jbj7667/wafer-transfer-robot/cad/arm/README.md

# 팔 방식 기하 가·부 검사 (arm option go/no-go)

Fusion 문서 `wafer_robot_arm_v0` (Default Project, 직접 모델링). L=180(원점)·L=190(Y+1000mm 옆) 두 로봇을 같은 문서에 구성하고 부품(occurrence)별 `transform2`로 자세를 바꿈. 계산 코드: `lib_arm.py, ev.py, final.py`(순수 파이썬 SAT 간섭·거리), 모델 데이터 `model_L*.json`, 상세 출력 `result_L*.txt`. 단순 솔리드(상자·원기둥) 기반이며 갈래 슬롯·림·벨트는 생략.

## 확정 배치 (로봇 좌표, mm, 상판 244x244: x −89..155, y ±122)
| 항목 | L=180 | L=190 |
|---|---|---|
| 회전대 축 T | (−8, +2) 중앙 | (+40, −50) 우측 치우침 |
| 접힘 자세 | 팔 방향 216°, φ=108° | 팔 방향 30°, φ=96° |
| 마스트 | T에서 62mm, 방위 +45° (0°면 R모터·링크와 회전 중 충돌) | 동일 |
| R 모터 / θ 모터 방위 | 회전대 기준 +40° / T에서 114mm, 방위 0° | +70° / 방위 150° (90°는 바퀴와 간섭) |
| 가지 | 팔꿈치 θ+φ (s=+1) | 동일 |

## 판정 표
| # | 검사 | L=180 | L=190 | 판정 |
|---|---|---|---|---|
| 1 | 접힘 외곽 (Fusion 꼭짓점 실측) 250 대비 여유 X/Y/Z | 246.8x246.0x245.0 → **3.2 / 4.0 / 5.0** | 246.8x245.9x245.0 → **3.2 / 4.1 / 5.0** | PASS (기준 3, 단 상판 244 한정) |
| 1b | 접힘 상태 팔 대 차체·마스트 최소 간극 | 4.0 | 3.0 | PASS (빠듯) |
| 2a | 6개 베이스 도달, 슬롯 중심–베이스 중심 오차 | 0.00 (구성상) | 0.00 | PASS |
| 2b | 특이점 여유 2L−R_w (상단/중단/하단 행) | 38 / 97.5 / 62.8 | 58 / 117.5 / 82.8 | PASS (L=180 상단 38) |
| 2c | 도달 자세 간섭 (포크윗면=기둥윗면−10, 로봇↔베이스) | 6자세 모두 0 | 6자세 모두 0 | PASS, 포크–CD 간극 10 |
| 3 | 후방 회전 스윙 (R_w=150, 10° 간격) 최소 간극: 베이스쪽 / 차체·마스트쪽 | 9.9 / 7.5 (회전대–마스트봉) | 9.9 / 5.3 (θ모터–L298) | PASS (> 0) |
| 4 | 구역 경계: 필드 y 최소 (도달 / 스윙) | 54.6 / 41.8 | 54.6 / 31.3 | PASS (≥0) |
| 5 | 전도: 지지 다각형(구동륜 2·후캐스터·전스키드 2) 여유 최소 (도달 / 스윙) | 29.0 / 37.4 | 36.8 / 41.2 | PASS (≥20) |

질량: arm_option §3.3 합 2831 g 분포를 가정 [가정]. 베이스 높이: 상단 행 5·6은 기둥 175, 나머지 200 [가정].

## 한계·주의
- 상판을 244로 줄였기 때문에 여유 3 이상이 나옴. 250 꽉 채우면 여유 0 (FAIL). 외곽 +3mm 허용이 전제.
- L=190은 T가 y=−50으로 치우쳐 질량·배선 재배치가 필요. L=180은 중앙(문서 §1.4 계산과 일치)이라 권장.
- 마스트 방위 0°는 불가(스윙 중 R모터·링크가 마스트 봉과 충돌). 방위 +45° 필요.
- 벨트·베어링·U 슬롯 라운드·넥 스위치 레버·소나는 모델 제외.

스크린샷: `L180_folded_*.png, L180_reach_b5_*.png, L190_*` (iso, top).

**ARM FOLD GATE: PASS (L=180 권장, L=190 가능)**
