jbj7667/wafer-transfer-robot/cad/model/README.md

# 단순화 Fusion 360 어셈블리 v1.1 (params.md v1.1 / v1.1b 반영)

Fusion 문서 "제목 없음 1" (Design, **저장 안 됨**: `saveAs("wafer_robot_v1_1", ...)` 재시도도 InternalValidationError(id.size()) 실패, 수동 저장 필요).
좌표: 원점=바퀴 접지 중점, +X 전진, +Y 좌, +Z 상, mm. 재현 헬퍼 `_helper.py`, STL `stl/` (REF_envelope 제외 20개), 로그 `progress.log`.

## 구성 (모두 박스/원기둥 BRep, 파라미터 비연동)
P01 deck1 (후방 X-93..-35 Y±92 / 전방 X-35..40 Y±78.9, Z52..56) / P02 deck2 (X-93..15, Z100..103, 커플러·로드 노치) /
P03 휠, P04 모터 (v1 유지) / P05 캐스터 X-75 / P06 배터리 90(Y)x58(X)x16, X-93..-35, Y-90..0, 0..90 (v1.1b) /
P07 스탠드오프 4개 (-30,±60), (6,±73) / P08 Mega X-93..7 (102→100 으로 축소: 커플러 X8과 간섭 회피) / P09 L298 /
P10 스테퍼 42x42 X-6..36 Z56..96 + 커플러 Z96..121 (중심 X15) / P11 리드스크류 Z121..221 + Ø5 스텁 Z221..241 /
P12 로드 Ø8 X15 Y±30 Z56..241 / P13 상단 블록 Z241..245 /
P14 캐리지 (플레이트 X22.5..27 Z150..180, LM8UU 로드당 1개 Z150..174, 너트 몸체 Z154..164 + 플랜지 Z150..154) /
P15 포크 (X28..157, 폭 118, t4, Z151..155, U슬롯 폭78 X61..157 / 장착 심 X27..28) /
P16 라인센서 66x24x2 X13..37 Z9..11 + 지지대 / P17 소나 45x15x20 X-5..10 Y-68.5..-23.5 Z56..76 /
P18 IR 박스 X45.5..58.5 Z110..123 + 암 / P19 넥 스위치 (몸체 포크 아래 X52..61, 레버 접촉점 X65) /
REF_base (하단 Ø100x100, 넥 Ø50 Z100..200, CD Ø120x1.2 Z200..201.2, 중심 X92), REF_envelope (X-93..157 선틀).

## 점검 결과 (REF 제외)
1. 바운딩박스 X-93..157, Y±105, Z0..245 -> **L250 x W210 x H245** (한계 충족).
2. 포크 Z155(홈 자세) 로봇 vs REF_base: **간섭 0**. 로봇 내부 간섭도 0 (접촉면만).
3. 캐리지+포크+IR+넥스위치 이동:
   - +35 mm (포크 윗면 190): vs 하단/넥 원기둥 간섭 0, vs CD(Z200, 제자리) 간섭 0.
   - +57 mm (포크 윗면 212): vs 원기둥 간섭 0, vs CD(Z212..213.2, 포크 제외) 간섭 0. 캐리지 상단 237 < 상단 블록 241 (4 mm 여유). 너트 상단 221 = 스크류 끝 (여유 0).
   - 위치 복귀 확인.
4. Z<100 이고 Y∈[-50,50]에 걸친 몸체의 최대 X: deck1 **+40.0**, 라인센서 +37, 스테퍼 +36 (<= +40 충족).

## 편차/남은 문제
- 소나: 높이 Z60 지정이나 deck1 상면이 Z56 이라 Z56..76 (중심 66)으로 모델. 지정값대로면 판 아래로 내려감.
- 너트(몸체 14)는 +57 이동 시 스크류 끝(Z221)에 정확히 닿음 -> 스크류를 100 보다 약간 길게 하거나 이동량 57 이내 재확인 필요.
- 스크류 윗단 Ø5 스텁(Z221..241)은 상단 베어링 지지 가정(상단 블록 중앙 구멍).
- 배터리 2개는 Y=0 에서 맞닿음, 하판 후방 확장부(Y±92)는 휠(Y79~105)과 X 겹침 없음(휠 X ±32.5).
- 림(Ø123 호), 8° 경사, 모터 브래킷, 센서 PCB 상세, 색상 미모델. 라인센서 지지대·IR 암 등은 가정 형상.
- 문서 저장 실패(수동 저장 필요).
