jbj7667/wafer-transfer-robot/docs/design/arm_bench.md

# 팔 방식 Bench 시제품 (반복정밀도 측정용 최소 구성, L=180)

범위: 로봇 전체가 아니라 **θ-R 두 축 + 2링크 + 펜 포인터**만 만든 책상 위 시험대. Z(T8)·마스트·차체 없음. 목적은 arm_option §7.2의 반복정밀도·처짐·질량·전압 측정이다. Fusion 문서 `wafer_robot_arm_bench` (Default Project, 직접 모델링 모드), STL·스크립트·스크린샷은 `public/cad/arm_bench/`. 수치 구분: [계산] [가정] [확인필요].

## 0. 결정과 바뀐 점 (요청 대비)
| 항목 | 요청 | 실제 | 이유 |
|---|---|---|---|
| 바닥판 | 330x250 | **200x190x6** (+θ 보스 17) | A1 베드 256 초과(330 불가), 필요한 것은 θ축과 θ 모터(축간 114.3)뿐. 질량 85 g, 3.6 h로 감소 |
| 링크 폭 | 28 | **중간부 약 36~38, 끝단 R22(폭 44)** | 52T 풀리 플랜지 Ø36이 폭 22 내부에 안 들어감 [계산]. 높이 20(상자 18 + 뚜껑 2)은 유지 |
| θ축과 어깨축 | 별도 | **같은 축** (M8 나사봉 1개가 베이스 베어링 2개를 지나 어깨까지) | 실제 로봇과 같아야 R_w 가 θ 축 기준이 됨 |
| R 구동 벨트 | 오픈 3:1 | **폐루프 310 mm 3:1 (20T:60T, C=114.3)** | θ와 같은 세트 사용, 클램프 불필요. 310은 표준 길이 |
| 베어링 | 링크 양 끝 608 | 608은 **허브 안**(어깨 2, 팔꿈치 2)과 링크2 손목 보스(1), θ축 2 = 7개 | 링크 높이 20에 풀리(8)+베어링(7)을 같은 층에 못 둠 |
| 베이스 높이 | - | 발 4개 38 mm (θ 모터가 판 아래로 매달림) | SF2421 몸통 길이 34 [가정] |

## 1. 벨트·풀리 재계산 (`belt.py` → `belt_out.md`)
GT2 피치 2 mm, 폭 6 mm. PD = 2T/π, 길이 = 2C + π(D+d)/2 + (D−d)²/4C.

**링크 연동 (C=180, 어깨:팔꿈치 2:1, 팔꿈치:손목 1:2)** [계산]
| Ts:Te | PD | 계산 길이 | 정수 이빨 | 가까운 표준 폐루프 | 그 길이의 C | 판정 |
|---|---|---|---|---|---|---|
| 40:20 | 25.5/12.7 | 420.2 | 210T(420) | 404 | 171.9 | 표준 아님, 제외 |
| 52:26 | 33.1/16.6 | 438.4 | 219T(438) | **440 (220T)** | **180.81 (+0.81)** | **채택** |
| 54:27 | 34.4/17.2 | 441.4 | 221T | 440 | 179.29 (−0.71) | 벨트가 짧아 설치 불리 |
| 60:30 | 38.2/19.1 | 450.5 | 225T | 440 | 174.7 (−5.3) | 슬롯 범위 밖 |

- **52T:26T + 폐루프 2GT-6 440 mm (220T) 2개**. 링크 중심거리 180에서 벨트가 약 1.6 mm 헐거워지므로 링크 안 **아이들러(P15)** 로 장력을 잡는다(슬롯 ±5). 접촉 이빨 12.6(>=6). 벨트1은 링크1 안(어깨 52T→팔꿈치 26T), 벨트2는 링크2 안(팔꿈치 26T→손목 52T).
- 팔꿈치 26T 이므로 슬랙 증폭 L/r_e = 21.7: 총 슬랙 0.1 mm → 팔끝 2.2 mm, 0.2 mm → 4.3 mm [계산]. 한 방향 접근 + 선장력 필수.
- 표준 폐루프를 못 구하면: 오픈 벨트 438 mm(219T) + 클램프(P16) 2개로 이음(이빨 6개 이상 물림).

**θ 회전대 (보유 310 mm = 155T)**: 20T:60T 3:1, PD 12.73/38.20, **C=114.29**, 소풀리 접촉각 167°, 접촉 이빨 9.3. 모터 판 슬롯 ±3 mm로 장력 조정. θ 분해능 1/8 마이크로스텝에서 0.075°/step → R=386에서 0.51 mm/step (arm_option §2.3).
**R(어깨) 구동**: 같은 20T:60T, C=114.3, **폐루프 310 mm 1개 추가 구매**.

### 구매 목록 (벨트·풀리·체결)
| 품목 | 수량 | 용도 |
|---|---|---|
| GT2 6mm 폐루프 440 mm (220T) | 3 (사용 2 + 예비 1) | 링크 벨트1·2 |
| GT2 6mm 폐루프 310 mm (155T) | 1 추가 (보유 1은 θ에 사용; 예비 1 권장) | R 구동 |
| GT2 6mm 오픈 벨트 | 1 m (선택) | 폐루프를 못 구했을 때 |
| 608ZZ | 10 (사용 7 + 아이들러 2 + 예비 1) | θ축 2, 어깨 허브 2, 팔꿈치 허브 2, 손목 1 |
| M8 나사봉(전산) 1 m 또는 볼트·너트 | 공용 축 길이 약 130, 팔꿈치 약 45, 손목 약 45 | 고정 축 3개 |
| M8 너트·와셔 | 각 약 14 | 축 체결, 스페이서 |
| M3 세트스크루 8~10 mm | 8 | 풀리 고정 (P06 x2, P07, P09 x2, 포인터 펜) |
| M3x10/16 나사+너트 | 각 약 40 / 20 | 뚜껑 4(링크당 2), 허브-링크·허브-회전대 체결, 모터 8, 발 4 |
| M4 열삽입너트 | 2 | 바닥판 테이블 고정 위치 |
| (선택) GT2 20T 알루미늄 풀리 보어 5 | 2 | 모터 풀리 정밀도가 부족할 때 P09 대체 |

## 2. 부품 (STL: 출력 자세, 베드 위, 중간 해상도; `parts.json`)
추정 g = 부피 x 1.24 x 0.35 [가정], 시간 ≈ 10분 + 2.4분/g(약 25 g/h) [가정, 슬라이서 값으로 교체].
| 부품 | 수량 | STL | 출력 자세 | bbox (mm) | 부피 cm³ | 개당 g | 시간(수량 합) |
|---|---|---|---|---|---|---|---|
| P01 base | 1 | P01_base.stl | 바닥 면 평평 | 200x190x17 | 194.8 | 84.6 | 3.6 h |
| P02 foot | 4 | P02_foot_x4.stl | 뒤집어(뚜껑면 베드, 열린 쪽 위) | 36x36x38 | 22.6 | 9.8 | 1.7 h |
| P03 turntable | 1 | P03_turntable.stl | 바닥 면 평평 | 185x68x6 | 70.6 | 30.6 | 1.4 h |
| P04 theta_hub60 | 1 | P04_theta_hub60.stl | 60T 플랜지 면 베드, 관 위로 | 41.2x41.2x45 | 19.8 | 8.6 | 0.5 h |
| P05 shoulder_hub60 | 1 | P05_shoulder_hub60.stl | 60T 플랜지 면 베드 | 41.2x41.2x24 | 17.2 | 7.5 | 0.5 h |
| P06 pulley52_hub | 2 | P06_pulley52_hub_x2.stl | 52T 플랜지 면 베드, 목 위로 | 36.1x36.1x25 | 8.8 | 3.8 | 0.5 h |
| P07 pulley26_hub | 1 | P07_pulley26_hub.stl | 26T 플랜지 면 베드 | 19.6x19.6x25 | 3.7 | 1.6 | 0.2 h |
| P08 elbow_hub26 | 1 | P08_elbow_hub26.stl | 26T 플랜지 면 베드, 허브 위로 | 30x30x27.5 | 6.8 | 2.9 | 0.3 h |
| P09 pulley20_D5 | 2 | P09_pulley20_D5_x2.stl | 20T 플랜지 면 베드 | 16x16x18 | 2.6 | 1.1 | 0.3 h |
| P10 link1_box | 1 | P10_link1_box.stl | 바닥 면 평평(개방면 위) | 216x44x18 | 44.5 | 19.3 | 0.9 h |
| P11 link1_lid | 1 | P11_link1_lid.stl | 평평 | 216x44x2 | 14.2 | 6.1 | 0.4 h |
| P12 link2_box | 1 | P12_link2_box.stl | 바닥 면 평평(개방면 위) | 221x44x18 | 44.8 | 19.4 | 0.9 h |
| P13 link2_lid | 1 | P13_link2_lid.stl | 평평 | 221x44x2 | 16.5 | 7.1 | 0.5 h |
| P14 pointer | 1 | P14_pointer.stl | 바닥 면 평평, 펜 링 위로 | 88x24x34 | 19.8 | 8.6 | 0.5 h |
| P15 idler | 2 | P15_idler_x2.stl | 판 면 베드, 기둥 위로 | 26x14x14 | 1.9 | 0.8 | 0.2 h |
| P16 belt_clamp (선택) | 2 | P16_belt_clamp_x2.stl | 평평(홈 면 위) | 26x14x8 | 2.7 | 1.2 | 0.3 h |
| P17 fork_stub (선택) | 1 | P17_fork_stub.stl | 평평 | 76x102x8 | 29.7 | 12.9 | 0.7 h |

**합계(선택 제외): 약 247 g, 약 12.4 h** (실패·서포트 여유 +15% 시 약 14 h). 서포트 없음. 모든 부품이 A1 베드 256 이내(P01 200x190, P12 221x44).

### 출력 우선순위 (프린터 1대, 주 로봇 부품과 공유)
1. **풀리 묶음 (P09 x2, P07, P06 x2, P08, P05, P04; 약 2.3 h)**: 먼저 벨트를 걸어 이빨 유격·슬립을 확인한다(필러 게이지 0.1 mm). 불량이면 알루미늄 풀리 구매로 전환하므로 가장 먼저.
2. **프레임 (P03 turntable, P01 base, P02 foot x4; 약 6.7 h)**: θ·R 모터만 달아 회전대 단독 반복성부터 측정 가능.
3. **링크 (P10~P13; 약 2.7 h)**
4. **측정 도구 (P14 pointer, P15 idler x2; 약 0.7 h)**
선택: P16, P17 (출력 안 해도 됨; P17은 실제 포크 시험용).
최소 시작 구성: 1번 + P03 + P01 + P02 = 약 9 h 로 θ축 단독 시험 가능.

## 3. 조립 구조 (z는 테이블 면 기준, mm) [계산]
| 층 | z 범위 | 내용 |
|---|---|---|
| 발 P02 x4 | 0~38 | 바닥판 모서리 M3 |
| 바닥판 P01 | 38~44 (보스 ~55) | θ축 보스에 608 2개(포켓 Ø22.2, 깊이 14.4), 모터 슬롯(축에서 −y로 114.3, ±3) |
| θ 풀리 P04 | 56~101 | 60T(56~64) + 관. 회전대에 M3 3개. 20T P09 는 θ 모터 축(바닥판 아래로 몸통 매달림) |
| 회전대 P03 | 101~107 | 중심 M8 축 구멍, R 모터는 축에서 −x 114.3(판 아래로 매달림, 바닥 높이 약 67) |
| 어깨 허브 P05 | 108~132 | 60T(108~116) + 608 2개(위·아래 포켓). 링크1이 위에 M3 3개로 체결 |
| 링크1 P10/P11 | 132~152 | 52T P06(고정, 축에 세트스크루) 141~149, 목이 뚜껑 위로 |
| 팔꿈치 허브 P08 | 141~168.5 | 26T(141~149, 링크2에 고정) + 608 2개. 링크2가 위에 M3 3개 |
| 링크2 P12/P13 | 168.5~188.5 | 26T P07(고정) + 52T P06 손목 + 손목 608 1개(바닥 보스) |
| 포인터 P14 | 202.5~236.5 | 손목 축에서 +x 64에 펜 링 Ø10.2 (CD 중심점과 같은 거리) |

공용 축(θ·어깨)은 M8 나사봉 1개가 회전대와 함께 돈다(P03 위아래 너트로 고정). 어깨 허브는 이 축 위에서 608로 돌고, 52T P06 는 축에 세트스크루로 고정되어 회전대와 같이 돈다(= 고정 풀리).
**펜 높이**: 펜 윗끝을 링 윗면(z 236.5)에 맞추면 팁은 `236.5 − 펜 길이`; 펜 140 mm → z ≈ 96. **종이 받침을 약 96 mm(책 더미 등)로 맞추고** 펜 위치로 미세 조정. 종이는 받침 위에 판자를 깔고 고정.
미모델링(구매·조립 시 결정): 608 베어링 자체, 볼트·너트·와셔 스택, 배선, 홈 스위치 캠(D4/D5). 모터 몸통 길이는 34 [가정]이라 실측 후 P02 발 높이(38)와 P04 관 길이(45) 조정.

## 4. 조립 검사 (Fusion, `p09_assy.py`)
모터 2·볼트 3(더미) 포함 전 부품을 배치하고 `analyzeInterference`.
| 자세 | 조건 | R_w | 간섭 |
|---|---|---|---|
| 도달 | α=0°, β=26.5° (R_w=2L cosβ) | 322.2 (펜 386.2) | 부품 간 0건. 더미 모터 축↔D보어 2건(의도, 부피 0.01~0.02 cm³) |
| 접힘 | α=216°, β=104° (펌웨어 φ_fold 105°) | 87.1 (손목이 어깨 뒤) | 같음 (진짜 간섭 0건) |
링크2는 링크1 위 15 mm 위에 있고 팔꿈치 허브가 사이를 채워 두 링크가 서로 지나친다. 스크린샷: `bench_reach_iso.png, bench_reach_top.png, bench_folded_iso.png, bench_folded_top.png`.
한계: 벨트·베어링·너트 두께는 모델에 없어 ±0.5 mm 단위 간극은 시제품에서 확인.

## 5. 표적지 (`target_sheet.py` → `target_A3.pdf`)
`python -I target_sheet.py`. A3 가로, 10 mm 격자(50 mm 굵게), 반경 R=322/354/386 호 3개 x θ=−15/0/+15° 방사선 → 십자 표적 9곳(동심원 r=2/5/10 mm). 종이 왼쪽 변은 θ 축에서 반경 290 mm 지점(θ=0 선 위). 100%로 인쇄.

## 6. Bench 측정 절차
**배선 (Mega 2560, 3x DRV8834; `config.h` 기준)**
| 축 | STEP | DIR | nSLEEP | 비고 |
|---|---|---|---|---|
| TH (θ) | D46 | D47 | D48 | 홈 D4 |
| R | D49 | D50 | D51 | 홈 D5 |
| Z | (미사용) | | | D36/37/38 연결 안 함 |
- DRV8834 각각: VMOT=모터팩(+) 7.2 V + 100 µF 가까이, GND 공통(Mega GND와 연결), 로직 전원 5 V, M0/M1 = 펌웨어 마이크로스텝 8과 일치하도록 결선(`config.h` MICROSTEP 8; DRV8834 표 확인) [확인필요], 코일 1A/1B·2A/2B는 모터 코일쌍(멀티미터로 구분). 모터 SF2421 3개 중 2개는 빌린 것이라 θ·R에 연결, 나머지는 예비.
- 시리얼 명령: `g <θ> <R_cd> <Z>` (R_cd = 펜 반경 = R_w + 64), `j <축> <스텝>`(홈 전 조그), `p`, `x`(정지), `trim`, `speed`. 홈 `h`는 3축 모두 리밋을 찾으므로 홈 스위치(D4, D5)를 달거나, 팔을 접힘 자세(θ=216°, φ=105°)에 손으로 놓고 사용. Z 리밋(D2)은 Z 미사용이라 GND에 묶어 "이미 하단"으로 둠 [확인필요: homeAll 동작은 펌웨어로 확인].
- 전원 투입 전 팔을 손으로 접힘 자세에 둔다. 모터 팩은 7.2 V.

**A. 반복정밀도 (펜-종이, 한 방향 접근)**
1. P14에 펜(볼펜)을 끼우고 팁 높이를 종이 받침 면에 가볍게 닿게 맞춘다(펜은 자체 무게로 눌림 없이 접촉, 스프링 쓰면 더 좋음).
2. 홈 후 `g θ0 354 0`으로 이동(θ0는 임의, 예 100). 표적지 R354 θ0 십자가 펜 끝 아래에 오도록 종이를 놓고 테이프 고정. `g θ0±15 354 0`로 다른 표적 위치가 맞는지 확인.
3. 표적 하나(예: R=386, θ0)에 대해: 항상 같은 방향(R은 접힘→펼침, θ는 감소 방향)으로 접근해 펜을 내려 점을 찍고, 팔을 접힘 자세(`h` 또는 `g θ0 100 0`)로 되돌린 후 같은 명령으로 재접근. **10회**.
4. 반대 방향 접근 20점(번갈아)은 별도 세트로(양방향 히스테리시스 측정).
5. 캘리퍼로 점들의 최대 폭을 **반경 방향·접선 방향**으로 읽고, 평균점 대비 각 점 편차 표준편차를 기록. 보고: max−min, σ, 방식.
6. R=322, 354, 386 각각에서 반복. 판정: `(max−min)/2 <= 5 mm` (arm_option §7.2).

| 세트 | R_cd | θ | 방식 | 반경 폭 | 접선 폭 | σ_r | σ_t | 비고 |
|---|---|---|---|---|---|---|---|---|
| 1 | 386 | θ0 | 한 방향 | | | | | |
| 2 | 354 | θ0 | 한 방향 | | | | | |
| 3 | 322 | θ0 | 한 방향 | | | | | |
| 4 | 386 | θ0 | 양방향 | | | | | |

**B. 처짐 (최대 도달, 16 g 더미 CD)**: 펜 대신 P17 포크 스텁(또는 포인터 링)에 16 g 더미를 올리고, 링크2 위 면 높이를 캘리퍼 깊이 로드/수평 자로 R_w=100, 250, 322에서 측정. 처짐 = h(100) − h(322). 더미 유무 비교. 기준 3 mm 이하.
**C. 질량**: 주방 저울(±1 g)로 부품군별 측정(링크1 조립 / 링크2 조립 / 회전대+모터 / 포인터). 인쇄물은 출력 g와 비교.
**D. 전압 로그**: 멀티미터 min-hold 로 모터 팩 전압을 두 축 동시 이동 3회 동안 기록, 최저 전압과 Mega 리셋 여부(0회 목표).
기록: 날짜, 팩 전압(무부하), 최저 전압, 벨트 장력(중앙 처짐법 스팬 180 mm: 100 g 추에서 3~5 mm 목표), 비고.

## 7. 확인 필요
1. 보유 PLA 풀리 잇수·품질: P09/P04/P05 는 새로 출력하므로 불필요, 보유 것은 비교용.
2. SF2421 몸통 길이(34 가정), 축 길이·D컷 위치(P09 D보어 폭 5.2).
3. 440 mm / 310 mm 폐루프 재고. 없으면 오픈 438 mm + P16.
4. 330x250 대신 200x190 으로 줄인 바닥판의 테이블 고정 강성(M4 인서트 2점 + C클램프 판 모서리).
5. 허브 M3 체결은 관통 구멍 + 너트 트랩 없이 자가 탭 파일럿(Ø2.8)이므로 반복 분해 시 헐거워질 수 있음(필요하면 열삽입).
