jbj7667/wafer-transfer-robot/docs/design/mechanism.md

# 최종 메커니즘 선정 (3-1 결과)

입력: 아레나 4개 관점 × 25안 = 100안 (`docs/arena/A_lift.md`, `B_effector.md`, `C_system.md`, `D_redteam.md`)
결정: 2026-10-26, 메인 계획 세션

## 1. 결론 — "단일 승강축 와이드 C-링 포크 + 넥 접촉 정지"

| 하위 시스템 | 채택 | 출처 아이디어 |
|---|---|---|
| 승강 구동 | 스테퍼 SF2421 + **T8 리드스크류(리드 8mm)** + Ø8 가이드봉 2개 + LM8UU, 행정 60mm | A01 (D04 대안) |
| 원점·초기화 | 하단 리밋 스위치 원점 잡기 (추가기능 ④), 상단 리밋 = 과주행 보호 | A01, B 결합메모 |
| 엔드이펙터 | **U 내폭 78mm** 포크 + 8° 원추 시트 + C-링 림 턱(앞·뒤 호) — PETG | D01(내폭), B02(원추), B03(림) |
| 깊이 정렬 | 정지선 이벤트 → 저속 전진 → **포크 U 바닥 저작동력 레버 스위치가 넥(Ø50)에 닿으면 정지** | D13 |
| 웨이퍼 감지 | 캐리지에 **상향 IR**(GP2Y0A41), 포크 윗면 45mm 아래 → CD 있음 55mm / 없음 >300mm | D17, B19 |
| 경로 | 단방향 + 제자리 회전. 180°는 후퇴 후, **항상 자기 구역 안쪽(남쪽)으로 휘두름** | C 골격, D 함정7 |
| 동작 모터 | **1개**(스테퍼). 2개는 예비 | — |

탈락한 유력안과 이유:
- **C24 스크류-래칫 포탑**(스핀 제거, −6s): 도그클러치 시제품 검증이 필요해 4주 일정에서 위험. 예선 시간 여유(약 55s)가 커서 6s 절약의 가치가 낮다. → v2 창의성 개선 후보
- **C23 평행링크 리치-리프트**(접힌 채 회전 → 구역 침범 해결): 링크 핀 유격, 각도-높이 비선형. §3의 경로 규칙으로 침범을 해결하므로 보류. → 모의대회에서 침범 판정 문제가 생기면 1순위 교체안
- **C09 2단 tine + 캠**: 175행에서 위층 tine–CD 간격 15mm가 빠듯하고 캠 반복 정밀도 검증 필요
- **C16 상승-협지 패드**: 패드를 캐리지에 달면 CD와 함께 움직여 협지가 안 되고, 프레임에 달면 행마다 협지 높이가 다르다. 림 턱 + 원추 시트로 수평 이탈을 막고 회전 각가속도를 제한(§4)하는 쪽이 단순
- **D01 편심캠(타미야)**: 행정 고정이라 175/200 두 높이의 "아래·운반" 4위치를 만들 수 없음
- **서보 단독안(A05, A14, A18, A23)**: 추가기능 ④(센서 기반 초기화) 불인정

## 2. 아레나가 놓친 기하 제약 두 가지 (선정 과정에서 발견)

### 2.1 라인센서가 베이스 하단 원기둥 안으로 들어가는 문제
픽 위치에서 포켓 중심 = 기둥 중심. 하단 원기둥(Ø100)은 바닥에서 중심 반경 50mm를 차지한다. 바닥 가까이 있는 라인센서와 차체 앞면은 기둥 중심에서 **55mm 이상** 떨어져야 한다.
→ **센서 → 포켓 중심 ≥ 55mm** (C 관점의 "40mm 이내" 규칙은 차체 앞면 기준이며, 센서 위치에는 이 하한이 추가로 걸린다)

### 2.2 상단 행 교차점에서 상대 구역 침범
본선 그림에서 두 팀의 구역은 베이스 쪽이 서로 마주 보고, 상단 행(y=130)은 경계선에서 130mm 떨어져 있다. 고정 포크 로봇의 포크 끝은 바퀴축에서 157mm 앞에 있다(v1.1). 북쪽을 보고 상단 교차점에 도착해 축을 교차점 중심(y=130)에 두면, 포크 끝이 경계 밖으로 약 27mm 나간다.
→ §3의 상단 행 전용 규칙으로 해결한다.

## 3. 기준 치수 (바퀴축 기준, 진행 방향 +) — v1.1, 상세는 `cad/params.md`가 기준

```
   후면                바퀴축       센서        포켓중심            포크 끝
   -93 ──────────────── 0 ───── +15 ── +25 ──────── +92 ─────────────── +157
   [배터리(가로 배치)·Mega]  [DC모터]  [마스트] [라인센서]   [U 내폭 78, C-링 림 Ø123]
   CD 뒤끝 X=32 > 캐리지 앞면 X≤27,  Z<100 부품은 X ≤ +40 (하단 원기둥 시작 X=42)
```

| 항목 | 값 | 근거 |
|---|---|---|
| 축 → 라인센서 중심 | 25 | 교차점 회전 뒤 센서가 새 라인 위에 놓이는 최소값. 작을수록 회전 반경이 줄어든다 |
| 센서 → 포켓 중심 | **67** | §2.1 하한(센서 PCB 앞면 포함) + CD–마스트 간격에서 결정. 정지선 이벤트 후 크리프 약 33 |
| 마스트(리드스크류 축) | +15 | CD 뒤끝(+32)보다 캐리지 앞면(+27)이 뒤 |
| Z<100 부품 최전방 | 축 +40 이하 | 하단 원기둥 시작 +42 (스테퍼 앞면 +36, 라인센서 PCB 앞면 +37) |
| 포크 끝 | 축 +157 | 포켓 중심 + 65 |
| 차체 후면 | 축 −93 | 전장 250 |
| 전폭 | ≤ 210 (바퀴 외측) | 바퀴는 좌우 바깥이라 하단 원기둥(±50)과 간섭 없음 |
| 높이 | 마스트 상단 ≤ 245 | |
| 포크 높이 범위 | 155(원점) ~ 215 | 175행: 아래 165 / 운반 187, 200행: 아래 190 / 운반 212 |
| IR 센서 | 포크 윗면 −45mm, 위를 향함, 포켓 중심에서 반경 40 위치(CD 돌출부 아래) | 최소 측정거리 40mm 확보 |
| 초음파 센서 | **기본 구성에서 제외(선택 부품, v1.1e)** | 설치 가능한 자리에서는 베이스 하단 원기둥을 겨냥할 수 없다(`cad/params.md` sonar 행). 접근 구간은 `SPEED_SLOW`로 통과 |

**상단 행 규칙**
1. 상단 교차점 규칙 (v1.1에서 재계산):
   - 중단 교차점을 지나면 **저속**으로 상단 교차점에 접근한다. 이벤트(약 6mm 지연) + 제동 오버슈트로 센서가 라인 위 y≈124까지 들어가면 축은 y≈149, 포크 끝은 y≈−8로 **경계를 넘는다** → 이벤트 후 **15mm 후진**(`TOP_BACKOFF_MM`)해 축 y≈162, 포크 끝 y≈+5로 맞춘다.
   - 이 위치에서 센서는 라인보다 남쪽에 있고, 센서가 라인 위에 머무는 회전각은 26°뿐이다(25·cosθ ≥ 22.5). 그래서 라인 확인 회전은 쓸 수 없다 → **시간 기반 90° 제자리 회전**(라인 확인 없음). 포크 끝 궤적은 축 중심 반경 157 원이고 북쪽 최대점은 회전 시작점(y≈+5)이므로 침범하지 않는다.
   - 회전 후 센서는 라인 남쪽 약 22mm, 라인과 평행 → **라인 쪽(북쪽)으로 약 15° 편향 전진**(`A_ACQUIRE`)하다가 어느 채널이든 흑이면 PD 추종으로 전환(약 90mm 이동 후 획득, 정지선까지 남은 약 180mm에서 방향 수렴).
   — 펌웨어: 상단 행 전용 동작 `A_FWD(−TOP_BACKOFF_MM)` → `A_TURN_TIMED` → `A_ACQUIRE`. 모의경기장에서 각도·편향·시간 실측
2. 상단 행에서 180° 회전은 반드시 남쪽 경유: 서→동은 좌회전(W→S→E), 동→서는 우회전(E→S→W).
3. 회전 전 포크 높이는 기둥 윗면 + 5 이상으로 올리고, 후퇴는 100mm로 한다. 포크 끝 반경 157 < 축–넥 거리(후퇴 후 92+100) − 넥 반경 25 = 167 (여유 10).

## 4. 동작 시퀀스 (한 행)

1. 교차점 → (상단 행 규칙) 회전 → 라인추종(기둥 근처 감속) → **정지선 이벤트**
2. 승강: 아래 높이(기둥 윗면 − 10)로 이동해 대기
3. **크리프**: 저속 전진하다 넥 접촉 스위치가 눌리면 정지(시간 초과 1.5s = 고장). 크리프 시간을 기록
4. 감지: 상향 IR → 있음/없음
5. 있음: 운반 높이(기둥 윗면 + 12)로 올림 → 후퇴 100 → 남쪽 경유 180° 회전(각가속도 램프 ≥ 0.3s) → 교차점 통과 → 맞은편 정지선 → **3에서 기록한 크리프 시간만큼** 전진(넥 스위치는 포크가 기둥 위에 있어 안 눌림) → 아래 높이로 내려 놓기 → 후퇴 100 → 회전 → 교차점
6. 없음: 포크를 기둥 윗면 + 5로 올림 → 후퇴 100 → 180° → 맞은편에서 3~5를 반복한 뒤 반대 방향으로 운반

## 5. 정량 점검

| 항목 | 값 | 판정 |
|---|---|---|
| 횡 허용오차 | 내폭 78: 넥 반경 25 → ±14, CD 지지 조건 G/2+e<55 → e<16 | 라인추종 ±5~8 대비 2배 |
| 종 허용오차 | 넥 접촉 정지로 ±2 (픽), 크리프 시간 재사용으로 ±8 (플레이스) | 원추 시트가 ±10 흡수 |
| 승강 시간 | T8 리드 8: 25 step/mm, 1000 step/s(7.2V 현실 속도) → 40mm/s, 행정 25mm ≈ 0.7s | 행당 4회 ≈ 3s |
| 리드 8 역구동 | 하중(포크+CD ≈ 80g)이 작아 DRV8834 홀딩 전류 0.4A로 유지. 전원 차단 시 처짐은 무관(원점 재설정) | 허용 |
| 회전 중 CD 이탈 | 림 턱이 수평 이탈을 기하적으로 차단 + 각가속도 ≤ 19 rad/s² 램프 | 이중 대책 |
| 시작 크기 | 250 × 210 × 245 | 충족 |
| 예선 시간 | 주행 19s + 승강·감지·크리프 약 24s + 회전 약 15s ≈ 58s | 120s 대비 여유 62s |

## 6. 위험과 대체 경로

| 위험 | 감시 지표 | 대체 |
|---|---|---|
| 상단 행 15mm 오프셋 회전 후 라인 재획득 실패 | 모의대회 10회 중 실패 ≥ 1 | 라인센서 채널 간격 실측 → 오프셋 조정, 안 되면 C23 평행링크로 교체 |
| 넥 접촉 스위치가 베이스를 밀어냄 | 연습장에서 베이스 이동 > 3mm | 레버 길이 연장(작동력 감소), 크리프 속도 하향(`SPEED_CREEP`), 그래도 밀리면 접촉 대신 시간 기반 정지(기록한 크리프 시간 −10%) |
| 스테퍼 탈조로 높이 누적 오차 | 매 행 원점 재확인에서 오차 > 1mm | 최대 속도·가속도 하향, 행마다 원점 재설정 |
| T8 리드 8 홀딩 발열·배터리 소모 | 모터 팩 전압 강하 | Tr8×4로 교체(속도 절반, 자기 유지 쪽으로) |
