jbj7667/wafer-transfer-robot/docs/design/arm_option.md

# 팔 방식(θ-R-Z) 공학 분석 — arm_option (PLAN_v2 §2, 작업 2-1)

작성 2026-10-27. 대상: 포크+승강축 1개(현재 설계, `mechanism.md`)의 대안인 **정지점 S에서 3축 팔로 6개 베이스를 모두 처리하는 로봇**.
수치 표는 `arm_calc/*.py`(실행: `python -I 파일.py`)가 만들고 출력은 같은 폴더의 `*_out.md`에 저장돼 있다. 상수만 바꿔 다시 돌리면 이 문서의 표가 갱신된다.

표기: **[계산]** 입력이 확정값인 순수 계산, **[가정]** 내가 둔 입력(바꾸면 결과 변동), **[확인필요]** 사용자가 실측·확인해야 결정되는 값.

## 0. 먼저 읽을 결론

| # | 발견 | 영향 |
|---|---|---|
| 1 | PLAN의 (θ, R) 표는 **전부 맞다** [계산]. 다만 R(386 등)은 **CD 중심 반경**이고 링크 도달 한계 410은 **손목축 기준**이다. 손목에서 CD 중심까지 64mm(포크 루트→포켓, mechanism.md 28→92) [가정]이므로 필요한 손목 반경은 322, 실제 도달 여유는 410−322 = **88mm** (PLAN의 410−386 = 24mm는 과소평가) | 링크를 줄일 여지가 생김 → 3번 |
| 2 | **접힌 자세가 250×250에 들어가는 것이 이 방식의 가장 큰 구조 문제.** 링크 2개를 접어도 팔꿈치가 반경 L만큼 옆으로 튀어나온다. L=205이면 회전대 축을 몸체 중심에서 옆으로 약 68mm 비켜야 겨우 들어가고(여유 2mm), L=190이면 축이 x≈+90(앞쪽 끝)이어야 한다. **L=180이면 축이 몸체 중앙(x 0~9, y +20)에 놓이지만 여유 거의 0** [계산, 단순화 외곽: 링크 폭 28·허브 r20·포크 129×118 [가정]] | L=180~190 재설계 권고, Fusion 간섭 검사(2-2)로 확정 |
| 3 | 도달만 보면 L=180도 가능: 손목 최대 332(정지오차 10 포함)에 대해 특이점 여유 28mm, phi_min 22.7°. L=205는 78mm 여유 [계산] | L=180: 도달·접힘·처짐·질량 모두 유리, 대신 관절 각 민감도↑ |
| 4 | 방향(헤딩) 오차 2° → R=386에서 가로 팔끝 오차 **13.5mm = U 허용 ±14의 96%** [계산]. 정지 위치 오차(트렁크 ±10, 횡 ±5) 포함 선형합 24.5mm. **방향 보정 없이는 성립하지 않는다.** 중단 행선 통과 시 좌·우 채널 시간차 추정으로 약 0.5~1.2° (팔끝 4~8mm) 수준이 현실적 [계산+가정] | 보정 필수, 목표 ±0.6° |
| 5 | 3단 벨트 연동은 팔꿈치 풀리에서 **오차가 L/r_e 배(21~43배)로 증폭**된다. 총 슬랙 0.1mm가 20T에서 팔끝 3.2mm, 26T에서 2.5mm [계산]. 반복정밀도 ±5mm는 **경계선**(1σ 약 3.3mm) | 알루미늄 풀리·선장력·한 방향 접근 필요 |
| 6 | 총질량 추정 **약 2.8kg**(포크 방식 약 2.0kg) [가정]. PLAN 기준 1.5kg는 **두 방식 모두 달성 곤란** [가정: 부품 질량 ±15%] | 기준 자체 재검토 필요(대회는 동점 시 가벼운 쪽 우선뿐) |
| 7 | 구동륜+후방 캐스터만으로는 팔을 뻗을 때 전도(여유 −24~+27mm). **전방 스키드 캐스터 2개(x=+95, y=±70)** 추가 시 최소 +27mm 이상 [계산] | 부품 추가 |
| 8 | 임무 시간 약 **38s**(예선, 포크 방식 58s) [계산+가정]. 본선 최악 약 44s | 속도 이득은 있으나 판정 조건은 아님 |
| 9 | 3축 홈잉은 접힌 자세가 곧 홈이므로 출발 상자 안에서 작은 움직임만으로 가능 → 추가기능 ④ 취득 가능 | |

판정 제안은 §7. 현재 수치 기준 예측: 반복정밀도 경계, 처짐 통과, **질량 미달**, 전원 통과, 일정 위험.

---

## 1. 기구학

### 1.1 좌표와 표 (S=(500,240), 로봇 헤딩 북쪽(−y), θ 왼쪽 +, 원점 왼쪽 위·+y 아래) [계산]

로봇 좌표: 전진 f = 240 − y_b, 왼쪽 l = 500 − x_b. θ = atan2(l, f), R = √(f²+l²). 손목 반경 R_w = R − 64, 어깨각 φ = acos(R_w / 2L) (L=205), 팔꿈치 방향 = θ + φ (가지 s=+1, 모든 행 공통: 팔꿈치가 항상 뒤쪽/바깥으로 접히지 않고 가지를 바꾸지 않는다).

| 베이스 | θ | R (CD 중심) | R_w = R−64 | 여유 410−R_w | φ | 팔꿈치 위치 (x, y) |
|---|---|---|---|---|---|---|
| 5 (상단 좌) | +73.4° | 386.0 | 322.0 | 88.0 | 38.2° | 310, 316 |
| 6 (상단 우) | −73.4° | 386.0 | 322.0 | 88.0 | 38.2° | 618, 72 |
| 3 (중단 좌) | +101.5° | 326.5 | 262.5 | 147.5 | 50.2° | 403, 420 |
| 4 (중단 우) | −101.5° | 326.5 | 262.5 | 147.5 | 50.2° | 660, 112 |
| 1 (하단 좌) | +131.6° | 361.2 | 297.2 | 112.8 | 43.5° | 483, 444 |
| 2 (하단 우) | −131.6° | 361.2 | 297.2 | 112.8 | 43.5° | 705, 233 |

- PLAN 값 R 386 / 326.5 / 361, θ ±73.4 / ±101.5 / ±131.6 **전부 일치(검증)**. 수정 사항은 없고 **해석만 정정**: 도달 여유는 위 표의 4번째 열이다.
- 오른쪽 베이스의 φ가 같아도 팔꿈치는 같은 가지(θ+φ)이므로 오른쪽 상단에서는 팔꿈치가 로봇 앞(−35°)으로 나간다. 이 방향이 §4의 경계 점검에서 최악이다.
- 포크 방향 대안: U가 **바깥을 향하고** 손목이 안쪽 루트(PLAN)면 R_w=322. U가 **안쪽**을 향하면 R_w=450(410 초과, L≥225 필요)이므로 PLAN 방향이 유일하게 가능하다 [계산].
- 링크 길이별(정지오차 10mm 포함 R_w=332): L=205 → φ_min 35.9°(여유 78mm), L=190 → 29.1°(48), L=180 → 22.7°(28), L=170 → 12.5°(8), L=160 불가.

### 1.2 정지점 S의 민감도 [계산]

포켓 위치오차를 포크 축에 대해 **가로**(축에 수직, U 허용 ±14), **깊이**(축 방향, 원추 시트 ±10)로 분해. "필요 dR/dθ"는 오차를 사후에 알았다고 가정할 때 보정에 쓸 값. (전체 36행은 `arm_calc/kin_out.md` K4)

| 오차원 | 상단 R=386 가로 / 깊이 | 필요 dR / dθ | 중단 R=326.5 가로 / 깊이 | 필요 dR / dθ | 하단 R=361 가로 / 깊이 | 필요 dR / dθ |
|---|---|---|---|---|---|---|
| S가 북쪽으로 10 (좌측 베이스 기준 부호) | 9.6 / 2.8 | −2.7 mm / +1.43° | 9.8 / 2.0 | +2.1 mm / +1.71° | 7.5 / 6.6 | +6.7 mm / +1.16° |
| S가 남쪽으로 10 | 9.6 / 2.8 | +3.0 mm / −1.41° | 9.8 / 2.0 | −1.8 mm / −1.73° | 7.5 / 6.6 | −6.6 mm / −1.21° |
| 횡 ±5 | 1.4 / 4.8 | 4.8 mm / 0.21° | 1.0 / 4.9 | 4.9 mm / 0.18° | 3.3 / 3.7 | 3.8 mm / 0.52° |
| 헤딩 ±2° | **13.5** / 0.2 | 0 mm / **2.00°** | 11.4 / 0.2 | 0 / 2.00° | 12.6 / 0.2 | 0 / 2.00° |

(가로·깊이는 크기 기준. 부호 포함 전체표는 kin_out.md.)

- 헤딩은 **순수 가로 오차** R·sin(e): 0.5°→3.4, 1°→6.7, 2°→13.5, 3°→20.2mm (R=386) [계산]. 트렁크 방향 오차는 **가로 9.6 + 깊이 2.8**로 나뉜다. 횡 오차는 거의 깊이로만 들어간다.
- 가로 예산(상단 행, 보정 없음): 트렁크 9.6 + 횡 1.4 + 헤딩 13.5 = 선형합 24.5mm, 제곱합 16.6mm → **U 허용 ±14 초과** [계산].
- 깊이 오차(최대 6.6 + R 반복 오차 약 3)는 원추 시트 ±10 안에 들어간다. 더 확실히 하려면 포크 U 바닥에 mechanism.md와 같은 **넥 접촉 레버 스위치**(리밋류는 센서 제한 대상 아님)를 달아 접촉까지 삽입하면 깊이 오차가 0이 된다 [권장].
- 트렁크 방향 정지오차는 직진 후 65mm 크리프 시간으로 잡는다. 엔코더가 없으므로 속도 변동 10% 가정이면 ±6.5mm [가정]; 검출 지연 1mm를 더해 ±7mm로 둔다. 가로 7mm + 횡 1.4 + 헤딩 잔차 3 = 선형합 11.4mm로 14 안(여유 2.6mm) [가정].
- **S 기준점 주의**: S는 회전대 축 위치다. 라인센서가 축보다 x_s−x_T 앞에 있으므로 중단 행선 이벤트 후 전진 거리 = 65 + (x_s − x_T)이다 (예: 센서 +25, 축 +5이면 85mm) [계산].

### 1.3 방향(헤딩) 오차 보정

중단 행선(y=305, 폭 19)을 지날 때 센서의 좌·우 **외곽 채널**이 라인을 밟는 시각 차 Δt = t_left − t_right 로 추정한다 (1 kHz 틱에서 측정).

```
ψ = atan( v · Δt / d )          (ψ > 0: 로봇이 반시계(왼쪽)로 틀어짐 → 오른쪽 채널이 먼저 밟음)
θ_cmd = θ_nom − ψ               (K4: 헤딩 +2°일 때 필요 dθ = −2.00°. 부호는 시제품에서 확인필요)
v: 교차 구간 저속 통과 속도 (엔코더 없음 → 틱 간 거리는 PD 출력으로 추정 또는 고정 PWM 속도 보정값)
d: 외곽 채널 간격 [확인필요: YwRobot S033, PCB 66mm 중 채널 간격을 실측]
```

분해능과 정확도 [계산, d·지터는 가정]:

| d (mm) | 틱 분해능 (v=100~150mm/s) | 에지 지터 j=0.5mm: 1에지 / 4에지 평균 | j=1.0mm: 4에지 평균 | 386mm 팔끝 (j=0.5 / 1.0, 4에지) |
|---|---|---|---|---|
| 40 | 0.14~0.21° | 1.01° / 0.72° | 1.43° | 4.8 / 9.6 mm |
| 48 | 0.12~0.18° | 0.84° / 0.60° | 1.19° | 4.0 / 8.0 mm |
| 60 | 0.10~0.14° | 0.68° / 0.48° | 0.95° | 3.2 / 6.4 mm |

- 지배 항은 **시간 분해능이 아니라 채널 에지 지터**(디지털 74HC14 임계값 고정). 라인 폭 19mm이므로 **상승·하강 에지 4개**를 모두 기록해 평균하면 지터가 1/√2.
- 목표 잔차 ≤0.6° (팔끝 약 4mm). 교차점 통과 중에는 PD를 동결하고 직진(조향 0)하여 통과 중 요(yaw) 변화를 막는다. 교차 후 65~85mm 직진 동안 요 표류는 ±0.3° 가정 [가정].
- 추가 완화: (a) 하단 행선과 중단 행선 두 번 측정해 평균(bottom 교차→middle 교차 사이 요 변화가 작음), (b) 시제품에서 ψ 추정치와 실제 헤딩(종이 위 펜 자국 2점)을 10회 비교해 교정 계수 산출.
- 보정이 부족하면 대안: 첫 베이스 접근 시 포크 IR로 θ ±3° 스윕, 넥 반사 최대각을 찾아 θ를 국소 미세조정(IR 2번째 개수 한도 내) [아이디어, 미검증].

### 1.4 접힘 자세 (250×250×250) [계산 + 가정]

접힌 자세는 φ≈100~105°(손목이 어깨 뒤)이며, 팔 방향을 몸체 축에서 회전시켜 대각선으로 눕힌다 (K8, `fold_out.md`).

| L | 접힘 외곽(회전 후) | 회전대 축 위치 요구 | 판정 |
|---|---|---|---|
| 205 | 246 × 248 mm | x_T 23~27, **y_T −69~−67** (몸체 중심에서 옆으로 약 68mm) | 불가에 가까움 (여유 2mm) |
| 190 | 237 × 237 | x_T 84~97, y_T −17~−4 (앞쪽 끝에 축) | 가능하나 축이 앞쪽 → 질량 앞쏠림 |
| 180 | 250 이하(F2 탐색, 폭 수치 미출력) | **x_T 0~9, y_T +20** (중앙 근처, 탐색 한계값) | 가능하나 여유 거의 0 |
| 175 / 170 | 226 (L=175) | x_T 0~2, y_T −10~3 | 가능 |

- 위 외곽은 링크 폭 28, 허브 r20, 회전대 반경 50, 포크 길이 129×폭 118(U 내폭 78+갈래 20×2) [가정]. 포크를 접는 순간 폭을 줄이는 방법은 없다.
- 높이: 접힌 상태 포크 윗면 165 (175행 기둥 윗면−10) 최저 승강 시, 링크 2단+판 = z 118~161, 마스트 상단 245 → 250 이하 [계산 가정].
- 권고: **L=180으로 줄이고 포크 갈래 폭 18, 허브 r18로 5~8mm 여유를 확보**하거나 L=190+앞쪽 축을 택한다. 회전대 θ 접힘 각은 L=180에서 약 216° 방향(뒤쪽 왼쪽 대각선) [계산].
- 이후 본 문서의 상세 계산은 PLAN 값 L=205를 기본으로 하되, L=180 변형치를 병기한다.

---

## 2. 벨트·풀리 설계 (GT2, 피치 2mm, 폭 6mm)

수치는 `arm_calc/belt_out.md`. PD = 2·T/π, 벨트 길이 L = 2C + π(D+d)/2 + (D−d)²/4C, C = 축간거리.

### 2.1 연동 원리 (유도 확인) [계산]

- 어깨 축에 **고정 풀리 P_s**(회전대에 붙음, 안 돌아감), 링크1이 어깨에서 φ만큼 돌면 팔꿈치의 **P_e1**(링크2에 고정)은 링크1 기준 −φ·(r_s/r_e)만큼 돈다. 링크2 절대각 = φ − φ·r_s/r_e. 손목 반경 방향 직선 운동이 되려면 링크2 절대각 = −φ → **r_s/r_e = 2** (어깨:팔꿈치 = 2:1).
- 팔꿈치 축에 링크1에 고정된 **P_e2**(P_e1과 같은 축, 별도 풀리), 손목에 포크와 함께 도는 **P_w**. 포크 절대각 = 0 이 되려면 **r_w/r_e2 = 2** (팔꿈치:손목 = 1:2).
- 따라서 풀리 2쌍(어깨 2T : 팔꿈치 T, 팔꿈치 T : 손목 2T)이고 벨트 2개의 길이는 같다. 링크 내부(속 빈 상자)에 벨트가 지나간다.
- 구동: 별도의 **R 구동 벨트**(R 모터 풀리 → 링크1 어깨 풀리, 3:1)가 링크1을 돌린다. 이 풀리는 P_s와 같은 축에서 링크1에 고정, P_s는 회전대에 고정 — 어깨 축에 풀리 2개 + 베어링 2개 스택이 된다.

### 2.2 잇수와 벨트 길이 (C=205) [계산]

| 어깨:팔꿈치 (팔꿈치:손목 동일 비) | PD (mm) | 벨트 길이 | 이빨 수 | 정수 이빨 | 그때 C | 소풀리 접촉 이빨 |
|---|---|---|---|---|---|---|
| 30:15 | 19.1 / 9.5 | 455.1 | 227.6 | 228 (456) | 205.44 | 7.4 |
| 36:18 | 22.9 / 11.5 | 464.2 | 232.1 | 232 (464) | 204.92 | 8.8 |
| **40:20** | 25.5 / 12.7 | 470.2 | 235.1 | **235 (470)** | 204.90 | 9.8 |
| **52:26** | 33.1 / 16.6 | 488.3 | 244.2 | **244 (488)** | 204.83 | 12.7 |
| 60:30 | 38.2 / 19.1 | 500.4 | 250.2 | 250 (500) | 204.78 | 14.6 |

- 근사식: 폐루프 길이 ≈ 2C + (T1+T2) mm (2mm 피치라 PD 합이 이빨 수 합과 같다). C=205 → 410 + T1+T2.
- **표준 폐루프 GT2 6mm 길이**(200, 280, 300, 400, 488, 610 등 [확인필요: 국내 판매처 재고]) 중 C=205에 정수 2:1로 맞는 것은 **488mm (52T:26T)** 하나뿐이다. 470mm(40:20)는 표준 길이가 아닐 가능성이 높다. 610은 풀리 합 200T라 불가.
- 접촉 이빨 수는 모두 6 이상(톱니 점프 방지 권장 ≥6) [계산]. 시제품 벨트는 **오픈 벨트 + 클램프**로 C를 맞추고, 확정 후 표준 폐루프 488로 교체하는 순서 권장.
- L=180 변형(C=180): 40:20 → 420.2mm(210T, C=179.89), 52:26 → 438.4mm(219T, C=179.81), 60:30 → 450.5mm(225T) [계산].

### 2.3 보유 폐루프 GT2 6mm 310mm (155T)와 PLA 풀리의 최적 용도 [계산]

| 소:대 | 비 | PD (mm) | 축간거리 C | 소풀리 접촉각 | 접촉 이빨 | 대풀리 외경 |
|---|---|---|---|---|---|---|
| **20:60** | 3:1 | 12.7 / 38.2 | **114.3** | 167° | 9.3 | 39.6 |
| 16:48 | 3:1 | 10.2 / 30.6 | 122.6 | 170° | 7.6 | 32.0 |
| 15:45 | 3:1 | 9.5 / 28.6 | 124.6 | 171° | 7.1 | 30.0 |
| 20:40 | 2:1 | 12.7 / 25.5 | 124.8 | 174° | 9.7 | 26.9 |
| 16:64 | 4:1 | 10.2 / 40.7 | 114.0 | 165° | 7.3 | 42.1 |

- 최적 용도: **θ 회전대 구동(20T:60T, C=114.3mm)**. 이유: ① 폐루프라 클램프 이음의 두께·장력 흔들림이 없고 ② 큰 풀리(PD 38)가 회전대 하부 원판과 일체가 되며 ③ 모터 쪽 슬롯 ±3mm로 장력 조정 가능 ④ 3:1 감속으로 θ 분해능이 모터 1.8°→0.6°/풀스텝(1/8 마이크로스텝 0.075°)이 되어 R=386에서 스텝당 0.51mm.
- R 구동 3:1 벨트와 링크 연동 벨트 2개는 오픈 벨트로 만든다 (**구매 필요**).
- 보유 PLA 풀리의 잇수는 [확인필요]. 20T와 60T가 있으면 그대로 θ에 사용. 링크 연동용은 아래 2.5의 이유로 PETG 또는 알루미늄을 권장.

### 2.4 구매 목록 (벨트·풀리) — 가격은 대략 [확인필요]

| 품목 | 수량 | 용도 | 대략 가격 |
|---|---|---|---|
| GT2 6mm 오픈 벨트 | **2m** | 링크 벨트 2×(470~488+클램프 25) + R 구동 벨트 약 335 + 여유 | 4,000~8,000원 |
| GT2 알루미늄 풀리 20T (보어 5/8mm) | 2~3 | R 모터 풀리, 시험용 | 개당 1,000~2,000원 |
| GT2 알루미늄 풀리 60T | 선택 1 | 인쇄 풀리 정밀도 불량 시 θ 대체 | 5,000~9,000원 |
| 608ZZ | 10 | 어깨 2 + 팔꿈치 2 + 손목 2 + 회전대/예비 4 (PLAN은 4개 → 부족) | 3,000~5,000원 |
| 클램프 | 인쇄 | 벨트 양 끝을 잇수 맞춰 물림 (이빨 6개 이상) | 0 |

### 2.5 백래시·장력·텐셔너

1. **증폭**: 링크2 상대각 오차 = 총 슬랙 s / r_e, 팔끝 변위 = L·s/r_e. 팔꿈치 풀리가 작을수록 크다 [계산]:

   | 팔꿈치 T | r_e (mm) | 증폭 L/r_e | s=0.1 | s=0.2 | s=0.4 (팔끝 mm) |
   |---|---|---|---|---|---|
   | 15 | 4.77 | 42.9 | 4.3 | 8.6 | 17.2 |
   | 20 | 6.37 | 32.2 | 3.2 | 6.4 | 12.9 |
   | 26 | 8.28 | 24.8 | 2.5 | 5.0 | 9.9 |
   | 30 | 9.55 | 21.5 | 2.1 | 4.3 | 8.6 |

   → 팔꿈치 쌍은 **26T(52T:26T) 이상**을 권장하고, 슬랙 s ≤ 0.1~0.15mm를 목표로 한다. 손목 단은 포크 헤딩에만 영향(링크2 오차의 1/2, 포켓 오프셋 64mm이므로 팔끝 영향 <1mm) [계산].
2. **한 방향 접근 규칙**(펌웨어): 모든 정지 목표는 같은 회전 방향에서 도달한다. R은 항상 "펴는 방향"으로, θ는 항상 "후방에서 전방 쪽(감소)" 방향으로 마지막 1° 접근. 슬랙이 양방향 히스테리시스가 아니라 상수 오프셋이 되어 사실상 제거된다. 비용: 접근마다 약 0.15s.
3. **선장력**: 목표 10~15N [가정]. 현장 측정은 중앙 처짐법: 스팬 205mm 중앙에 100g 추를 달 때 처짐 = F·스팬/(4T) → T=10N 5.1mm, 12N 4.3mm, 15N 3.4mm [계산]. 축 하중은 약 2T = 20~30N, 608 충분.
4. **텐셔너**: ① 팔꿈치 축 블록을 링크1 내부 슬롯(M3 ×2, 행정 ±3mm)에 두고 M3 밀기 나사로 C를 조정(벨트1), ② 손목 축 블록을 링크2 슬롯에 두고 동일(벨트2), ③ θ 벨트는 모터 슬롯 ±3mm. 아이들러(608을 벨트 뒷면에 대는 방식)는 뒷면 굽힘 반경 11mm로 가능하지만 접촉각이 늘어 마찰이 커져 권장하지 않는다.
5. **인쇄 풀리**: GT2 이빨 0.75mm 깊이는 0.4 노즐·0.1~0.15 레이어에서 겨우 재현. 이빨 피치 오차 ±0.1mm이면 벨트 100T 감김에서 슬립(점프) 가능성. 시험에서 벨트를 걸고 풀리를 손으로 흔들어 **이빨 유격**을 먼저 확인(필러 게이지로 0.1mm 이하). PLA는 장력 하에서 크리프하므로 팔꿈치 풀리는 PETG.
6. **허브**: 풀리 고정은 세트 스크루가 아닌 D컷 또는 M3 압입 너트+볼트로 (인쇄물 축 미끄러짐 방지).

---

## 3. 구조·하중·질량·안정성 (`arm_calc/dyn_out.md`, `fold_out.md`)

### 3.1 링크 단면과 처짐 [계산, 입력은 가정]

- 제안: **속 빈 상자 28(폭) × 20(높이) × 벽 1.6mm**(0.4 노즐 4벽; 높이 20은 §3.5의 z 적층 한도 때문), PETG, **좌우 U 채널 2조각을 옆으로 세워 출력**(층이 수직면 → 수직 휨의 인장이 층 방향이라 박리 위험이 작다)한 뒤 볼트·접착으로 결합. 벨트는 상자 안, 베어링 허브는 양 끝.
- 모델: 어깨~팔끝 연속 외팔보(최대 길이 410, 하중·자중 모두 최대 길이로 잡아 보수적), E=1800 N/mm² (PETG 길이 방향 1.2~2.0GPa 범위 [가정]), 끝단 하중 CD 16g + 포크 일체 35g = 0.50N [가정], 자중 충전율 0.8.

| 단면 w×h×t | I (mm⁴) | 링크 1개 질량 (허브 30g 포함) | 끝단하중 처짐 | 자중 처짐 | 합계 (L=205) | L=180 합계 |
|---|---|---|---|---|---|---|
| 22×18×1.6 | 5613 | 55 g | 1.14 | 0.41 | 1.55 (초과) | - |
| 24×20×1.6 | 7781 | 57 g | 0.82 | 0.33 | 1.15 | 0.75 |
| **28×20×1.6 (채택)** | 8867 | 60 g | 0.72 | 0.32 | **1.04** | **0.68** |
| 28×24×1.6 (z 한도 초과) | 13658 | 63 g | 0.47 | 0.22 | 0.69 | 0.45 |
| 30×22×2.0 | 13984 | 70 g | 0.46 | 0.27 | 0.73 | - |

- 관절 베어링 유격(608 2개, 간격 22mm, 반경 유격 합 0.02mm [가정]) 기울기 0.91mrad → 팔끝 영향 어깨 0.35 + 팔꿈치 0.19 + 손목 0.06 = **0.60mm** [계산]. 베어링 간격을 30mm로 늘리면 27% 감소.
- 합계(28×20): 1.04 + 0.60 = **약 1.6mm** (L=180이면 0.68+0.60 = 1.3mm). E가 1200으로 낮으면 약 2.2mm. 벨트 처짐·회전대 판 휨은 미포함. PLAN 기준 3mm 이하는 **충족 예상** [계산+가정]. 시험 방법은 §7.2.
- 비틀림은 상자 단면(폐단면)이라 무시. 단, 링크 중심선이 반경 방향과 φ만큼 어긋나므로 어깨 모멘트의 sinφ 성분이 링크1 비틀림이 된다 (φ=38°에서 0.62배).

### 3.2 토크 [계산, 입력은 가정]

가정: 링크 65g(허브 별도 30g), 포크 50g, CD 16g, R 모터·회전대 본체 관성 0.00075 kg·m², 마찰 θ 0.02 N·m, R 0.015 N·m, 구동 효율 0.85, **SF2421 보유토크 0.15~0.20N·m [확인필요: 데이터시트·실측]**.

| 축 | 조건 | 요구 토크 (출력축) | 모터축 (감속 후) | 보유토크 대비 |
|---|---|---|---|---|
| θ (3:1) | 뻗음 J=0.0189 kg·m², 450°/s² | 0.169 N·m | 0.066 N·m | 약 38% |
| θ (3:1) | 운반 J=0.0070 kg·m² | 0.075 N·m | 0.029 N·m | 약 17% |
| R 어깨 | φ=38.2°, 손목 반경가속 2 m/s²: J_eff 0.0113, φ̈ 7.9 rad/s² | 0.104 N·m | 2:1 → 0.061 / **3:1 → 0.041** / 4:1 → 0.031 | 3:1에서 약 24% |
| R 어깨 | φ=70.6° (운반) | 0.130 N·m | 3:1 → 0.051 | 약 29% |
| Z (T8 리드 8, η=0.30, 마찰 2N) | 승강 질량 0.9~1.1kg | 0.046~0.054 N·m | 직결 | 약 30% |

- **R 어깨 감속비 3:1 권고**: 토크 때문이 아니라 분해능(마이크로스텝 1/8에서 φ 0.075° → 팔끝 0.33~0.5mm)과 속도 때문이다. 2:1도 토크는 되지만 분해능이 1.5배 거칠다. θ, R 모두 수평면 운동이라 **중력 토크 없음**, 값은 모두 가감속 토크다.
- 7.2V에서 풀인 토크는 속도에 따라 감소(300 sps 이내 보유의 60~70%, 800 sps 부근 약 40% [가정, 확인필요]). θ·R은 풀스텝 환산 250·150 sps 정도라 안전 영역, Z가 750 sps로 가장 빠듯하다.
- **Z 자기 유지 안 됨**: 나선각 17.7° > 마찰각 약 9° → 전원이 꺼지면 승강대가 내려온다. 정지 중에도 홀딩 전류 필요(§6), 하단에 범퍼(고무) 필요. 승강 하중이 약 1.0kg로 포크 방식(약 0.18kg)의 5배다.

### 3.3 질량 [가정: 카탈로그/통상값, 실측 필요]

| 구분 | 합계 | 주요 항목 |
|---|---|---|
| 차체 | 1275 g | DC 모터 2 300, 바퀴·캐스터 85, 배터리 2팩 350, Mega+쉴드 80, L298+드라이버 3개+HM-10+배선 90, 센서 40, 판·스탠드오프·나사 330 |
| Z 고정부 | 550 g | Z 스테퍼 250, 가이드봉 2 190, 스크류·커플러·너트·LM8UU 110 |
| 승강대(이동) | 990 g | θ 스테퍼 250, R 스테퍼 250, 회전대 판+베어링+60T 110, 링크 2+허브·벨트 220, 포크+IR+스위치 70, 캐리지·브래킷 90 |
| **합계** | **약 2815 g** | 포크 방식 약 2005 g(승강대 180g 가정) → 팔 방식 **+810 g** |

- PLAN 판정 기준 **1.5kg는 팔·포크 두 방식 모두 초과** 추정이다 (부품 질량 ±15%에도). 감량 후보: 하판·캐리지 판에 경량화 구멍(−100g 내외 [가정]), 가이드봉 Ø8→Ø6(−80g, 포크 방식 마스트와 호환 안 됨). 스테퍼 2개(500g)는 대여품이라 교체 불가. 어느 것도 1.5kg까지는 닿지 않는다.
- 제안: 판정 항목 "전체 질량"을 **"팔 방식 증가분 ≤ 0.9kg 및 절대값은 보고만"**으로 바꾸거나, 11/01에 실제 포크 방식 질량을 실측해 상대 비교한다. 대회 규정상 질량은 동점 시 가벼운 쪽 우선뿐이다 (requirements.md/rules.yaml).

### 3.4 전도 안정성 (정적) [계산, 질량 분포는 가정]

좌표: 바퀴축 중점 원점. 접지점: 구동륜 (0, ±92) (바퀴 외측 폭 210, 바퀴 폭 26), 후방 볼 캐스터 (−75, 0) (params.md). 회전대 축 x_T(축 위치) 변화에 따른 6개 뻗음 자세 + 후방 운반 + 접힘 자세의 지지 다각형까지 최소 거리(mm). 음수 = 전도. 목표 ≥ +20mm.

| 구성 | 접지점 | x_T=−30 | x_T=0 | x_T=+20 | x_T=+40 |
|---|---|---|---|---|---|
| A | 구동륜 2 + 후방 캐스터 1 | 최소 +3 (상우) | **−13** | −24 | −35 |
| **B** | A + 전방 스키드 2 (x=+95, y=±70) | 최소 +27 (하좌) | **+40** | +48 | +57 |
| C | 구동륜 + 전방 스키드 (x=+80, y=±85) + 후방 캐스터 2 (x=−70, y=±60) | +40 | +56 | +56 | +45 |

- 결론: A로는 불가. **B(전방 스키드 2개)로 x_T 0~20이면 모든 자세에서 +40 이상**. 차체 CoM x ≈ −20 (배터리 후방), 마스트·승강대가 앞으로 가므로 합성 CoM은 +5~+25 구간 [계산]. 팔이 옆을 향하는 상단 행 자세(θ=±73°)의 가로 여유 최소 약 44mm.
- 스키드 권장 위치: x=+95, y=±70 (트렁크 선 19mm 양옆에 걸쳐 지나가고, 팔 방식은 로봇이 베이스에 접근하지 않으므로 하단 원기둥과 간섭하지 않음). **볼 캐스터를 지면보다 1~2mm 띄워** 정상 주행에는 닿지 않고 전도 시에만 접촉하게 한다 (교차점·곡선 라인 걸림 방지). 3/8" 볼 캐스터 +2개 (로봇 전체 3개).
- 접힘 외곽 때문에 L=205/190의 축 위치(y=−68 또는 x=+90)는 위 계산 범위(x_T ≤ +40, y=0)를 벗어난다. 이 위치는 CoM이 좌우 또는 전방으로 크게 치우쳐 스키드 재배치와 재계산이 필요하다 [확인필요: 미계산]. 이 점도 L=180 중앙 배치를 권고하는 근거.
- 동적: 팔 가속이 CD 슬립 한계(0.2g) 이하이므로 CoM 이동은 정적 오차의 수 mm 이내. 정차 중 팔 동작만 하므로 주행 가감속과 중첩 없음.

### 3.5 전장 배치와 접힘 치수 (250×250×250) [가정]

| 층 | z (mm) | 배치 |
|---|---|---|
| 바퀴·모터 | 0~65 | 바퀴 Ø65 축 높이 32.5, DC 모터 Ø37 판 아래 브래킷 |
| 하판 (deck1) | 52~56 | 배터리 2팩(90×58×16, 장축 Y, x −92~−34), **Mega+쉴드(102×54×27, 상판 대신 하판 위, 최상 z=83)**, L298(43.5², 29→ z 85), DRV 3개, HM-10 — 상판(deck2)을 **없앤다** |
| 승강 캐리지 판 | 최저 약 100~104 | 마스트(전방 섹터, 회전대 축 +60)의 가이드봉 ×2, T8 스크류, LM8UU. 캐리지 판에 θ 스테퍼(판 아래, 축에서 114mm 거리, 20T:60T 폐루프), 회전대 베어링 |
| 회전대 | 104~118 | 60T 풀리+판, R 스테퍼(축 뒤쪽 −55, 판 위), 어깨 고정 축 |
| 링크 | 링크1 118~138, 링크2 140~160 (28×20 상자 +2mm 틈) | 포크 윗면 161~165 = 최저 승강(175행 기둥 윗면−10) |
| 마스트 상단 | 245 | 가이드봉 상단 클램프 |

- **배터리·Mega 상판을 없애는 이유**: 최저 승강 시 링크1 아랫면 z=118이 Mega 윗면(z=83)을 넘으면서 회전해야 한다. params.md의 deck2 z=100 + Mega 27 = 130이면 링크와 충돌한다 [계산]. 하판 한 층에 모두 올리면 면적(249×184 = 45,800 mm²)에 대해 배터리 10,440 + Mega 5,500 + L298 1,900 + 기타가 들어간다 [계산].
- **링크 적층 한도**: CD(반경 60)가 포켓 중심에서 64mm 뒤의 손목 허브(r20)와 평면상 겹치므로 허브·링크2 윗면은 포크 윗면(=CD 아랫면) 아래여야 한다. 가장 낮은 포크 윗면이 165이므로 링크 2단 + 틈 ≤ 165−118 = 47mm → 링크 높이 20 (그래서 28×24 상자는 불가).
- 회전대 반경 50 + R 모터 + 링크가 회전하는 원형 공간(반경 약 120)은 Mega 위를 지나므로 Mega 윗면 z≤90 확보가 필수이고, 마스트는 팔이 지나지 않는 전방 섹터 |방위| ≤ 60° 안에 둔다 (팔 회전 범위 θ 73°~287°, 소프트 한계 60°~300°).
- 접힘(출발) 상태 치수: **L=180** 기준 팔 외곽이 250×250 정사각형에 대각선(θ_stow≈216°)으로 들어감 — 계산상 외곽 250 이하(여유 거의 0), 높이 ≤ 245, 폭·길이는 params.md의 x_rear −92 ~ x_front +158(250)으로 한정. **Fusion 간섭 검사(2-2)로 확정 필요**.

---

## 4. 동작 계획과 시간 (`arm_calc/motion_out.md`)

### 4.1 전체 흐름

1. 전원 → 3축 원점(§5.3) → 시작(버튼/BLE) → 라인추종으로 트렁크 진행 → 하단 행 교차점(1번째) 통과 → **중단 행 교차점(2번째)에서 방향 추정(§1.3)** → 65+(x_s−x_T)mm 전진해 **S 정지**.
2. S에서 3행 처리(상단→중단→하단 순서 또는 가까운 쪽 우선; 아래는 상→중→하 가정). 이후 팔 접기, 180° 제자리 회전, 라인추종으로 출발 구역 복귀.
3. 팔은 로봇이 S에 멈춘 뒤에만 움직인다 (주행과 팔 동작 비중첩).

### 4.2 한 CD 사이클 (좌 → 우, 예선)

| 단계 | 동작 | 비고 |
|---|---|---|
| 1 접근 | θ → θ_L(회전대 각은 §1.3 보정 포함), R → R_b − 80(삽입 시작점), Z → 아래 높이(기둥 윗면 −10) 동시 | 팔 방향 접근은 한 방향 규칙 |
| 2 삽입 | R +80mm, 120 mm/s. 넥 접촉 레버 스위치(권장) 또는 정해진 거리에서 정지 | 포크가 CD 밑으로 |
| 3 판정 | 상향 IR 평균: CD 있음 ≈55mm(포크 윗면 45 아래 + 간격 10), 없음 >300 | 없음이면 후퇴 80 → 반대편 베이스로 이동(본선) |
| 4 들기 | Z +25 (운반 높이 = 기둥 윗면 + 15, 포크 윗면 기준) | CD가 포켓 원추·림 위로 |
| 5 후퇴 | R을 R_C(=200)까지: 처음 80mm는 200mm/s, 나머지 400mm/s | 이때 φ 38°→70.6° |
| 6 회전 | θ 증가 방향(후방 경유), 150°/s, 가속 450°/s² (림 이탈 한계 §4.5) | 상단 213°, 중단 157°, 하단 97° |
| 7 뻗기 | R_C → R_b (회전 말미와 일부 겹치게 가능) | 높이 유지 → 오른쪽 베이스 위 |
| 8 내림 | Z −25 → CD가 기둥 윗면에 안착, 포크는 그 아래 10mm | |
| 9 빠짐 | R −80 → 포크가 넥에서 빠져나옴 | 다음 행 접근과 합칠 수 있음 |

### 4.3 시간 [계산, 속도·가속도는 가정]

가정: θ 150°/s·450°/s², R 400mm/s·2 m/s² (삽입 120mm/s), Z 30mm/s·0.3 m/s², 단계 정착 0.15s, IR 판정 0.25s.

| 행 | 회전각 | 접근 | 삽입 | 판정 | 들기 | 후퇴 | 회전 | 뻗기 | 내림 | 빠짐 | **합계 (s)** |
|---|---|---|---|---|---|---|---|---|---|---|---|
| 상단 5→6 | 213° | 1.22 | 0.94 | 0.25 | 1.08 | 1.07 | 1.75 | 0.82 | 1.08 | 0.60 | **8.81** |
| 중단 3→4 | 157° | 1.72 | 0.94 | 0.25 | 1.08 | 0.91 | 1.38 | 0.67 | 1.08 | 0.60 | **8.62** |
| 하단 1→2 | 97° | 1.33 | 0.94 | 0.25 | 1.08 | 1.00 | 0.98 | 0.75 | 1.08 | 0.60 | **8.02** |

(중단·하단의 "접근"은 이전 행 오른쪽 출구에서 빈 팔로 후방 경유 185°·127° 회전하는 시간 포함. 회전·뻗기를 겹치면 CD당 0.4~0.6s 추가 단축 가능.)

| 구간 | 시간 (s) | 근거 |
|---|---|---|
| 출발 → S 정지 | 4.5 | 트렁크 약 960mm, 평균 0.25 m/s, 교차 검출·전진 [가정] |
| 3 CD 이송 | 25.4 | 위 표 합 |
| 접힘 복귀 (θ_stow, R, Z) | 1.4 | |
| S에서 180° 회전 | 1.5 | [가정] |
| S → 출발 구역 정지 | 5.3 | [가정] |
| **예선 합계** | **약 38 s** | 포크 방식 약 58 s (mechanism.md §5) → 약 20 s 단축 |
| 본선(무작위, 각 행 첫 방문이 빈 베이스인 최악) | 약 44 s | 행마다 삽입·판정·후퇴 + 이동 +6.2s, 150s 대비 여유 106 s |

- 속도 이득은 크나 시간이 병목이 아니므로 **판정 기준이 아니다**(예선 120s). 오히려 시간 여유를 정확도(접근 속도 낮춤, 정착 시간 늘림)로 돌릴 수 있다.

### 4.4 경로 규칙과 경계·간섭 점검 [계산]

- **회전은 항상 후방(남쪽) 경유**: 좌→우는 θ 증가 방향, 우→좌는 감소 방향. 전방(북쪽) 경유는 회전각이 짧지만 R_C=200에서 CD 가장자리가 y=240−200−60 = −20으로 자기 구역 밖으로 나가므로 사용하지 않는다.
- **운반 반경 R_C=200 (손목 136, φ=70.6°)**: CD 궤적 고리 반경 140~260, 가장 가까운 베이스 넥/기둥은 S에서 326.5 이상(기둥 반경 50 → 276)이라 운반 중 **어떤 베이스와도 평면상 겹치지 않는다**. 즉 "기둥 윗면+CD" 간격이 문제 되는 구간은 삽입·후퇴·내림의 짧은 구간뿐이다. 그 구간의 포크 아랫면(윗면 −4)은 운반 높이에서 기둥 윗면+11, 다른 베이스 위 CD 윗면(201.2 / 상단 행 176.2)과 약 9.8mm 간격 [계산].
- **팔꿈치 원 (반경 L, 회전대 축 중심)**: 팔꿈치 가지 s=+1에서 운반 중 팔꿈치 방향 범위와 y 최소 [계산]:

  | 행 | 운반 팔꿈치 방향 | 팔꿈치 중심 y_min | 보스 r20 가장자리 | 링크 가장자리(반폭 14) |
  |---|---|---|---|---|
  | 상단 | 144~357° | **35.2** | **15.2** | 21.2 |
  | 중단 | 172~329° | 64.0 | 44.0 | 50.0 |
  | 하단 | 202~299° | 140.6 | 120.6 | 126.6 |

  → y_min = 240 − L (L=205 → 35, L=180 → **60**, 보스 가장자리 40). S가 북쪽으로 10mm 틀어지면 L=205에서는 가장자리 5mm까지 줄어든다. 구역 경계 침범 판정이 바닥 투영만인지(공중 부분은 무관인지) 규칙 확인필요(rules.yaml에는 상대 구역 침범 조항 없음; OP 문서 재확인). **L=180이면 안전 여유 40mm**가 확보되는 점도 L 축소 근거.
- **링크–넥 간섭** (z: 링크 118~160, 넥 상단 175/200 → 겹칠 수 있음): 픽 자세에서 링크 중심선과 6개 베이스 중심 거리 최소 = 링크1 130~258, 링크2 64(대상 베이스, 손목이 포켓에서 64) → 필요 39(넥 25+반폭 14)를 모두 충족 [계산]. 단, 손목 허브(r20)가 CD 아래이므로 §3.5의 적층 한도를 지켜야 한다.
- **들어올림 높이**: 운반 시 포크 윗면 = 기둥 윗면+15 (200 → 215, 175 → 190). 내릴 때 포켓 중심이 기둥 중심에서 ±14mm 안이어야 하며 원추 시트가 ±10 흡수.

### 4.5 CD 이탈 점검 (운반 중) [계산, 마찰계수는 가정]

- R_C=200, 150°/s: 구심 1.37 m/s², 접선 1.57 m/s² (450°/s²), 합성 2.08 m/s² = 0.21g. PETG–CD 마찰계수 0.3~0.4 [가정, 확인필요]로 마찰만으로는 경계 영역 → 림 턱(2mm) 기하 차단이 주 방어이며, 가속 구간을 램프로 처리한다. 시제품에서 150→100→200°/s로 바꿔가며 CD가 포켓에서 이동한 양을 측정.
- R 가속은 2 m/s²(0.2g)로 제한.

---

## 5. 제어

### 5.1 타이머 배정 (Mega 2560)

| 타이머 | 용도 | 비고 |
|---|---|---|
| Timer0 | millis/delay (Arduino 기본) | 변경 안 함 |
| Timer1 | 1 kHz 제어 틱 (라인센서, PD, 상태머신, 가감속 프로파일 갱신) | 기존 설계 유지 |
| Timer5 | 구동 모터 PWM (핀 44~46) | 기존 유지 |
| **Timer3** | **스텝 생성: CTC 20 kHz 단일 ISR + DDA 3축** | θ·R·Z 동시, 새 사용 |
| Timer4 | 예비 (Z 전용 분리 시, 또는 홈잉 저속 스캔) | |
| Timer2 | 예비 (8비트) | |

- 이유: PLAN 2-4가 "1개 타이머 ISR에서 3축 동시 스텝 생성"으로 규정했고, 기존 Timer1(제어 틱)과 Timer5(PWM)를 건드리지 않는다. Timer3의 출력 비교 핀을 쓰지 않고 ISR 안에서 STEP 핀을 직접 토글한다.
- DDA: 축마다 16비트 위상 누산기, 증분 = v[sps]·65536/20000. 위상이 넘치면 STEP 상승 → 다음 ISR에서 하강(펄스 폭 50 µs ≥ DRV8834/TMC2208 최소 펄스). STEP 3개를 같은 포트(예: PORTA 22·23·24)에 배치해 한 번의 포트 쓰기로 처리, DIR/ENABLE도 포트 정리.
- 최대 스텝률 [계산]: θ 2000 sps (1/8 마이크로스텝, 150°/s), R 1205 sps (1/8, 400mm/s, φ=38.2°), Z 3000 sps (1/4, 30mm/s) → **합 6205 sps**. 한 축 최대 10 kHz까지 가능 (여유 3배 이상). ISR 약 120 사이클 [가정]이면 20 kHz에서 CPU 약 15%.
- 1 kHz 제어 ISR이 스텝 ISR을 지연시킬 수 있다 (최악 100µs 미만이면 스텝 주기 500µs 대비 20%). 제어 ISR 안에서 `sei()`로 중첩 허용하거나 팔 동작 중에는 라인센서 PD를 중단(팔은 정지 후만 동작)하여 문제를 없앤다 [계산 가정].
- 마이크로스텝: DRV8834는 M0/M1(3상태), TMC2208은 MS1/MS2로 1/8 또는 1/16. TMC2208(스텔스초프)은 소음이 작고 보간(256) 가능 [확인필요: 학과 지급 허용 범위·재고].

### 5.2 소프트 한계와 좌표

| 축 | 좌표 | 소프트 한계 | 비고 |
|---|---|---|---|
| θ | 홈(접힘 θ_stow)=0, 로봇 방위 θ와 연결 | 방위 60°~300° | 전방 섹터(마스트) 진입 금지 |
| R | φ (링크1 각), 손목 반경 R_w = 2L·cosφ | φ_min + 1° ~ 105° | φ_min=35.9° (L=205 도달 + 오차), 홈 스위치 = 105° 쪽 |
| Z | 하단 리밋=0 | 0 ~ 60mm | 행정 60, 상단 리밋은 과주행 보호 |

### 5.3 3축 원점 (추가기능 ④ 초기화) [설계 제안]

- **리밋 스위치 배치 (롤러 마이크로 스위치 3~4개)**
  - Z: 하단 = 캐리지 판이 눌러 포크 윗면 155(원점) 위치, 상단 = +60 위치 (mechanism.md/params.md의 캐리지 리밋 재사용).
  - R: 링크1이 접힘 끝(φ=105°)에서 회전대 판 위 스위치를 누름. 반대쪽(φ_min)은 소프트 한계 + 선택적 과주행 스위치.
  - θ: 섀시에 고정한 롤러 스위치를 회전대에 붙인 캠이 θ_stow에서 누름 (홈 위치에서 눌린 상태).
- **전원 인가 시 순서** (전원 ON → 초기화 → 대기 → 시작)
  1. Z 하강 15mm/s → 하단 리밋, 2mm 상승, 저속 재접근 (약 4.9 s)
  2. R 접힘 방향으로 회전 → 접힘 스위치 (약 1.8 s)
  3. θ: 스위치가 눌려 있으면 완료(보통 출발 자세가 접힘이므로 미세 이동만), 아니면 한 방향 탐색(최대 120°, 30°/s, 약 4.6 s) 후 시간 초과 시 반대 방향 탐색
  4. 모두 완료 후 LED로 "준비" 표시, 시작 신호 대기
  - 총 약 3~11 s. 접힘이 출발 자세이므로 정상 출발에서는 **출발 상자 250³ 안에서만 움직임** [계산 가정]. 이동 중 재시작(터치 후 재배치) 때는 R→θ 순서로 안전하게 접는 과정이 포함된다.
  - 어느 단계든 시간 초과이면 FAULT(LED 빠른 점멸)로 시작 거부. 센서(리밋) 기반 초기화이므로 추가기능 ④ 요건("RC서보 단순 구동 불가, 센서 기반")을 충족 [확인필요: 심사관 시연 방식].
- **정지 후 위상 문제**: ENABLE을 껐다 켜면 로터가 풀스텝 위치로 끌려가 θ에서 0.6°(R=386에서 약 4mm) 어긋날 수 있다. 팔 동작 중에는 enable 유지, 비활성화한 뒤에는 반드시 재홈잉.

---

## 6. 전원 (`arm_calc/motion_out.md` M7)

가정: SF2421 코일 3.6Ω/상, 드라이버 전류 제한 0.7A/상 **[확인필요: 정격 실측]**, 풀 NiMH 6셀 7.2V·1900mAh·내부저항 합 0.25Ω, DC 모터 2개 주행 0.8A·가속 피크 2.0A, 드라이버 효율 85%.

| 상황 | 스테퍼 3 (A) | DC 2 (A) | 합계 (A) | 팩 전압 |
|---|---|---|---|---|
| 정지 홀딩만 | 0.86 | 0 | 0.86 | 6.98 V |
| 팔 이동 | 1.21 | 0 | 1.21 | 6.90 V |
| 주행(스테퍼 홀딩) | 0.86 | 0.80 | 1.66 | 6.78 V |
| 주행 가속 피크 | 0.86 | 2.00 | 2.86 | 6.48 V |

- 마이크로스텝 정지 시 코일 손실은 I_max²·R(두 코일 합) = 0.7²×3.6 = 1.76W → 스테퍼 1개 약 0.29A [계산]. 이동 시 약 1.4배 [가정].
- **전원 구성**: 모터 팩(NiMH 7.2V)은 스테퍼·DC·L298 전용. Mega는 별도 AA 팩(requirements.md 규정대로 2팩 분리)이라 스테퍼 스위칭 노이즈·전압 강하로 **Mega가 리셋되지 않는다**. DRV8834 최소 VMOT 2.5V, L298 강하 약 2V 감안해도 6.5V 팩에서 DC 모터 유효 4.5V (주행 속도 저하 확인필요 — 포크 방식과 동일 조건).
- 각 드라이버 VMOT에 100µF 이상 전해 + 0.1µF 세라믹, 배선 5cm 이내. 모터 팩 퓨즈/스위치 정격 ≥ 3A.
- **SLEEP/ENABLE 전략**: DRV8834의 SLEEP은 인덱서를 리셋하고, nENBL은 위상을 유지하지만 로터가 최근접 풀스텝 극으로 끌려가 θ에서 0.6°(팔끝 약 4mm), R에서 약 0.4° 어긋날 수 있다. 따라서 ① **홈잉 후 임무 종료까지 3축 모두 ENABLE 유지**(Z는 자기 유지 안 되므로 필수), ② 대기·충전·조작 중에는 disable하고 다음 사용 때 재홈잉, ③ 주행 중 θ·R은 접힌 자세 고정이므로 disable 후 재홈잉 시간(약 7s)과 정확도 손실 사이 선택 — 기본은 ENABLE 유지(0.86A × 약 20s 주행 = 5mAh, 미미).
- **런타임 [계산]**: 임무 1회 전하량 약 14mAh → 팩 1520mAh(1900mAh × 80%) 기준 약 107회. 홀딩 상태 연속 대기 약 1.8시간. 시험·모의대회 하루 사용에 충분. NiMH 사용 중 전압 모니터링(추가기능 ③, ADC 분압)은 포크 방식과 동일.

---

## 7. 위험, 11/01 시제품 시험 계획, 비용, 판정표

### 7.1 위험 목록

| # | 위험 | 가능성 / 영향 | 대응 |
|---|---|---|---|
| R1 | 접힘이 250×250에 들어가지 않음 (L=205) | **높음 / 치명** | L=180, 갈래·허브 슬림화, Fusion 검사(2-2)로 11/01 이전 확정 |
| R2 | 벨트 슬랙 증폭으로 반복정밀도 ±5mm 미달 | 중~높음 / 큼 | 26T 쌍, 알루미늄 풀리, 선장력, 한 방향 접근, 넥 접촉 스위치로 깊이 보정 |
| R3 | 방향 추정 정확도 부족(채널 지터) | 중 / 큼 | 4에지 평균, 채널 간격 실측, 대안으로 IR θ 스윕 |
| R4 | 질량 2.8kg로 기준 1.5kg 초과 | **높음 / 기준 문제** | 기준을 상대 비교로 재정의(§3.3) |
| R5 | 전도 | 중 / 큼 | 전방 스키드 2개(구성 B), 배터리 후방, 축 중앙 |
| R6 | 3축 일정 부담: 3D 출력(링크 200mm급·풀리·회전대), 조립, 펌웨어, 방향 보정을 10/31까지 | 높음 | 3개 축 중 Z는 트랙 1 재사용, 우선 R 선형운동+정확도 시험만 |
| R7 | 학과 대여 스테퍼 2개·드라이버 수급 | 중 | 대안 NEMA17 구매 약 20,000원 / DRV8834 학과 지급 확인 |
| R8 | 회전대 케이블 꼬임(R 모터·스위치) | 중 | θ 범위 60°~300°로 제한(회전량 240°), 서비스 루프 |
| R9 | 구역 경계 침범 판정(팔꿈치) | 낮음~중 / 중 | L=180 (y_min 60), 규칙 확인 |
| R10 | 벨트가 인쇄 풀리 위에서 이빨 점프 | 중 | 접촉 이빨 ≥ 9, 장력 확인, 알루미늄 풀리 |
| R11 | 3D 프린트: A1(256mm³)이면 링크 205+허브가 들어가나(약 235mm 길이) 신청서 100³ 규정과 충돌 가능 [확인필요: rules.yaml fabrication.team_override와 같은 문제] | 중 | 지도교수 확인, 분할 출력 |

### 7.2 시제품 측정 절차서 (작업 2-5, 사용자) — 모든 측정은 7.2V 팩으로, 홈잉 후

**A. 반복정밀도 @R=386 (펜-종이)**
1. 포크 포켓 중심에 볼펜을 수직으로 고정(스프링으로 종이에 가볍게 닿음, 펜 끝 = 포켓 중심). 종이를 판 위에 테이프로 평평하게 고정, 높이는 포켓 높이.
2. 목표 (θ=73.4°, R=386)로 이동해 Z로 펜을 내려 점을 찍고, 올린 후 운반 위치(θ=180°, R_C=200)로 갔다가 같은 목표로 복귀 — **이 사이클 10회**. 접근 방향은 (a) 항상 같은 방향(한 방향 규칙), (b) 번갈아 반대 방향으로 두 번 반복(20점).
3. 종이를 떼어 캘리퍼로 점들의 최대 폭을 **반경 방향(펜 점이 이루는 방향)과 접선 방향**으로 읽고, 평균 위치에서 각 점의 편차의 표준편차를 계산. 보고: `max−min`(mm), σ, 방식 (a)/(b).
4. 같은 절차를 (θ=101.5°, R=326.5)에서 1세트 더. 판정 기준 ±5mm는 `(max−min)/2 ≤ 5`로 해석.

**B. 팔끝 처짐**: 정지 상태에서 포크 아랫면 높이를 캘리퍼 깊이 로드(또는 높이 게이지·수평 자)로 R_w=100, 250, 322에서 측정. CD(16g)와 포크 장착 상태·미장착 상태를 비교. 처짐 = h(R_w=100) − h(R_w=322). 기준 3mm 이하.

**C. 질량**: 주방 저울(±1g)로 하위 조립체별(차체 / Z 고정부 / 승강대 / 팔 전체 / 포크) 질량을 측정해 §3.3 표에 기입, 합계 확인.

**D. 전원**: 멀티미터 min-hold로 모터 팩 전압을 측정하며 3축 동시 이동 + DC 모터 풀파워를 3회. 최저 전압 기록. Mega 리셋 발생 여부 관찰(리셋 0회).

**E. 방향 추정**: 연습 경기장 중단 행선을 일부러 0, ±1°, ±2°로 틀어 통과시켜 추정값 ψ를 시리얼로 출력(각 10회) → 실제 각도와 비교. 목표 오차 ≤0.6°.

**F. CD 사이클**: 1-3 더미 베이스에 실제 CD로 한 행 전체 사이클을 10회 — 성공(안착 후 베이스·CD 이동 <3mm) 횟수.

### 7.3 비용 차이 (포크 방식 대비 추가분, 한국 가격 대략) [확인필요]

| 품목 | 수량 | 대략 가격 (원) |
|---|---|---|
| GT2 6mm 오픈 벨트 2m | 1 | 5,000 |
| 608ZZ 베어링 | 10 | 4,000 |
| 스테퍼 드라이버 (DRV8834 ×2 약 10,000 / TMC2208 ×2 약 14,000) | 2 | 10,000 |
| 롤러 리밋 스위치 | 3 | 2,000 |
| 볼 캐스터 3/8" (스키드) | 2 | 5,500 |
| 알루미늄 GT2 풀리 20T | 3 | 4,500 |
| 회전대 대형 베어링/베어링 링 | 1 | 3,000 |
| 커패시터·커넥터·M3/M5 볼트·스페이서 | 일괄 | 5,000 |
| PETG 추가 출력분 (팔 부품 약 450g − 포크 방식 약 150g = 300g × 25원/g) | | 7,500 |
| 스테퍼 2개 | 학과 대여 | 0 |
| **합계** | | **약 46,500 (범위 40,000~60,000)** |
| 대여가 안 될 때 NEMA17 2개 구매 | | +약 20,000 |

PLAN §2.3 사비 120,000원은 두 트랙 합계 기준이므로 포크 트랙 구매액이 약 73,000원을 넘으면 초과다. 필라멘트는 rules.yaml에 따라 g단가로 사비에 산입한다.

### 7.4 11/01 판정표 (PLAN §2.3 기준, 이 문서의 예측)

| 항목 | PLAN 기준 | 이 문서의 예측 (근거) | 예측 판정 |
|---|---|---|---|
| 반복정밀도 @386 | ±5mm 이하 | 1σ ≈ 3.3mm (θ 슬랙 2.0, 팔꿈치 슬랙 2.5(26T, s=0.1), 양자화 0.5, R 0.3 RSS) → 2σ 약 6.5 | **경계** (한 방향 접근·알루미늄 풀리 시 통과 가능) |
| 팔끝 처짐 | 3mm 이하 | 1.6mm (28×20, E=1800), E=1200이면 2.2 | **통과 예상** |
| 전체 질량 | 1.5kg 이하 | 약 2.8kg (포크 방식도 약 2.0kg) | **미달 예상** (기준 재정의 필요) |
| 세 축 원점·구동 | 7.2V 팩 하나로 동작, 리셋 없음 | 피크 2.86A, 팩 6.48V, Mega 별도 팩 | **통과 예상** |
| 사비 합계 | 120,000원 이하 (두 트랙) | 팔 추가 약 46,500 (스테퍼 대여) | 포크 트랙 비용 확인 후 판정 |
| 일정 | 11/10 모의대회 1에서 예선 완주 시도 가능 | 3축 조립+방향 보정 펌웨어를 10/31~11/05에 | **위험** |
| (추가) 접힘 250³ | 출발 규정 | L=180에서 여유 거의 0 | **불확실** (Fusion 검사 필요) |
| (추가) 방향 추정 잔차 | 가로 허용 14mm 이내 | 0.5~1.2° → 팔끝 4~8mm | **경계** |

**종합**: 현재 수치로는 "질량·접힘·반복정밀도"가 동시에 충족되기 어렵다. 판정 규칙(모두 충족)을 그대로 적용하면 **트랙 1 확정 가능성이 높다**. 팔 방식을 살리려면 (1) 질량 기준을 상대 비교로 바꾸고 (2) L=180 재설계 후 접힘을 Fusion에서 검증하고 (3) 알루미늄 풀리로 슬랙을 줄인 시제품을 10/31까지 만들어야 한다.

---

## 8. 사용자 확인 필요 목록

1. SF2421(및 대여 스테퍼) 상 저항·정격 전류·보유 토크 (§3.2, §6 가정 3.6Ω, 0.7A, 0.15~0.20N·m)
2. YwRobot S033 라인센서 외곽 채널 간격 d (§1.3: 40~60mm 가정)
3. 보유 PLA 풀리의 잇수 구성, GT2 폐루프 표준 길이 재고 (§2)
4. 학과 대여 스테퍼 2개·DRV8834/TMC2208 지급 가능 여부
5. 자기 구역 경계 침범 판정 방식 (§4.4)
6. A1 출력 크기 규정(100³) 적용 여부 (R11)
7. 포크 방식 총질량 실측 (§3.3 기준 재정의에 필요)
8. 캐리지 판·마스트 위치·접힘 외곽을 Fusion 모델(2-2)에서 확정
