jbj7667/wafer-transfer-robot/docs/design/arm_calc/belt_out.md

## B1. 링크 연동 벨트 (C=205): 2:1 / 1:2 쌍 후보
벨트1: 어깨 고정풀리(Ts) -> 팔꿈치 풀리(Te, 링크2에 고정), Ts/Te=2. 벨트2: 팔꿈치(링크1에 고정, Te) -> 손목(Tw), Tw/Te=2.
| Ts:Te | PD(mm) | 벨트 길이(mm) | 이빨 수(계산) | 정수 이빨 N | 그 N일 때 C(mm) | 소풀리 접촉각(deg) | 접촉 이빨 |
|---|---|---|---|---|---|---|---|
| 30:15 | 19.1/9.5 | 455.1 | 227.6 | 228 (456.0 mm) | 205.44 | 177 | 7.4 |
| 36:18 | 22.9/11.5 | 464.2 | 232.1 | 232 (464.0 mm) | 204.92 | 177 | 8.8 |
| 40:20 | 25.5/12.7 | 470.2 | 235.1 | 235 (470.0 mm) | 204.90 | 176 | 9.8 |
| 52:26 | 33.1/16.6 | 488.3 | 244.2 | 244 (488.0 mm) | 204.83 | 175 | 12.7 |
| 60:30 | 38.2/19.1 | 500.4 | 250.2 | 250 (500.0 mm) | 204.78 | 175 | 14.6 |

표준 폐루프 GT2 6mm 길이 후보(상점 재고는 확인필요): 200, 280, 300, 400, 488, 610. C=205 고정이면 길이 = 410 + (T1+T2) + 소량 이므로
| 폐루프 길이 | 필요 T1+T2 (C=205) | 2:1 쌍 | 판정 |
|---|---|---|---|
| 400 | -10 | - | 불가(풀리 너무 작음) |
| 470 | 60 | 40:20 | 정수 2:1 가능 |
| 488 | 78 | 52:26 | 정수 2:1 가능 |
| 610 | 200 | 133:67 | 정수비 불가 |

## B2. 보유 폐루프 310mm (155T) 활용: 소풀리:대풀리 후보의 축간거리
| 소:대 | 비 | PD(mm) | 축간거리 C(mm) | 소풀리 접촉각 | 접촉 이빨 | 대풀리 외경(+1.4) |
|---|---|---|---|---|---|---|
| 20:60 | 3.0:1 | 12.7/38.2 | 114.3 | 167 | 9.3 | 39.6 |
| 16:48 | 3.0:1 | 10.2/30.6 | 122.6 | 170 | 7.6 | 32.0 |
| 15:45 | 3.0:1 | 9.5/28.6 | 124.6 | 171 | 7.1 | 30.0 |
| 20:40 | 2.0:1 | 12.7/25.5 | 124.8 | 174 | 9.7 | 26.9 |
| 16:64 | 4.0:1 | 10.2/40.7 | 114.0 | 165 | 7.3 | 42.1 |
| 20:80 | 4.0:1 | 12.7/50.9 | 103.2 | 159 | 8.8 | 52.3 |

권장: θ 회전대 구동에 20T:60T (C=114.3). 폐루프라 클램프 이음이 없어 회전대 반복성에 유리. 모터 슬롯 +-3mm로 장력 조정.

## B3. 벨트 슬랙 -> 팔끝 오차 (총 슬랙 s mm, 벨트1: 링크2 상대각 s/r_e)
| Te(T) | r_e(mm) | 증폭 L/r_e | s=0.1 | s=0.2 | s=0.4 |
|---|---|---|---|---|---|
| 15 | 4.77 | 42.9 | 4.3 | 8.6 | 17.2 |
| 18 | 5.73 | 35.8 | 3.6 | 7.2 | 14.3 |
| 20 | 6.37 | 32.2 | 3.2 | 6.4 | 12.9 |
| 26 | 8.28 | 24.8 | 2.5 | 5.0 | 9.9 |
| 30 | 9.55 | 21.5 | 2.1 | 4.3 | 8.6 |
해석: 팔끝 변위 = L*s/r_e (증폭 21~43배). 목표 팔끝 +-5mm를 지키려면 총 슬랙 s를 0.1~0.15mm 이하(26T 쌍)로 눌러야 함. 인쇄 풀리 단독으로는 어려우므로 선장력+한 방향 접근 필수.
완화: (1) 한 방향 접근(항상 같은 방향으로 도달), (2) 벨트 선장력 10~15N, (3) 가능하면 알루미늄 GT2 풀리 구매, (4) 큰 풀리(26T 이상)

## B4. 장력 측정(중앙 처짐법) 스팬 205mm: 처짐 = F*span/(4T)
| 장력 T(N) | 중앙에 1N(약 100g) 매달 때 처짐(mm) |
|---|---|
| 5 | 10.2 |
| 8 | 6.4 |
| 12 | 4.3 |
| 15 | 3.4 |
| 20 | 2.6 |
목표 T=10~15N(가정) -> 100g 추 처짐 3.4~5.1mm. 축 하중은 약 2T=20~30N (608 베어링 충분).

## B5. 풀리 치수 (PD / OD=PD-0.76 / 플랜지 포함 폭)
| T | PD | OD(이빨 끝) |
|---|---|---|
| 15 | 9.55 | 8.79 |
| 16 | 10.19 | 9.43 |
| 18 | 11.46 | 10.70 |
| 20 | 12.73 | 11.97 |
| 26 | 16.55 | 15.79 |
| 30 | 19.10 | 18.34 |
| 40 | 25.46 | 24.70 |
| 52 | 33.10 | 32.34 |
| 60 | 38.20 | 37.44 |

## B6. 링크 L=180 변형 (C=180) 벨트
| Ts:Te | 벨트 길이(mm) | 이빨 | 정수 N일 때 C |
|---|---|---|---|
| 40:20 | 420.2 | 210.1 -> 210 | 179.89 |
| 52:26 | 438.4 | 219.2 -> 219 | 179.81 |
| 60:30 | 450.5 | 225.3 -> 225 | 179.75 |
폐루프 길이 = 360 + (T1+T2): 420(40:20), 438(52:26), 450(60:30). 표준 재고 확인필요.
