jbj7667/wafer-transfer-robot/docs/design/arm_calc/dyn_out.md

## D1. 링크 단면 후보와 팔끝 처짐 (연속 외팔보 410mm, 하중·자중 모두 최대 길이로 보수 계산)
E=1800 N/mm^2 (가정), 끝단 하중 0.50 N (CD 16g + 포크 35g, 가정), 풀리·베어링 허브는 링크당 30g 추가 (가정)
| 단면 w x h x t | I (mm^4) | 링크 1개 질량 (g) | 끝단하중 처짐 | 자중 처짐 | 합계 | 판정(<=1.5mm 목표) |
|---|---|---|---|---|---|---|
| 22x18x1.6 | 5613 | 55 | 1.14 | 0.41 | 1.55 | 초과 |
| 24x20x1.6 | 7781 | 57 | 0.82 | 0.33 | 1.15 | OK |
| 28x20x1.6 | 8867 | 60 | 0.72 | 0.32 | 1.04 | OK |
| 28x24x1.6 | 13658 | 63 | 0.47 | 0.22 | 0.69 | OK |
| 30x22x2.0 | 13984 | 70 | 0.46 | 0.27 | 0.73 | OK |
| 24x28x1.6 | 17465 | 63 | 0.37 | 0.17 | 0.54 | OK |

관절 베어링 유격에 의한 기울기: 608 2개(간격 s_b=22mm), 반경 유격 합 c=0.02mm (가정) -> 기울기 c/s_b. 팔끝 영향 = 기울기 x 레버
기울기 0.91 mrad -> 어깨(레버 386): 0.35 mm, 팔꿈치(레버 205): 0.19 mm, 손목(레버 64): 0.06 mm, 합 0.60 mm
-> 24x20x1.6 기준: 처짐 1.15 + 관절 기울기 0.60 = 약 1.8 mm (계산). E를 1200 N/mm^2로 낮추면(층간 약화) 처짐 1.7 + 0.6 = 2.3 mm. 판정 기준 3 mm 이내이나 벨트 처짐·판 휨은 미포함이므로 28x24 단면(0.69 mm)을 권장. 대책: 베어링 간격 30 mm 확대 시 기울기 -27%

L=180 변형 처짐 (연속 외팔보 360 mm, 동일 조건)
- 24x20x1.6: 합계 0.75 mm, 링크 1개 54 g
- 28x20x1.6: 합계 0.68 mm, 링크 1개 56 g
- 28x24x1.6: 합계 0.45 mm, 링크 1개 59 g

## D2. 질량 추정 (g, 모두 가정/카탈로그 값. 실측 필요)
| 구분 | 항목 | g |
|---|---|---|
| 차체 | DC 기어드모터 Ø37 x2 | 300 |
| 차체 | 바퀴 65mm x2 + 캐스터 | 85 |
| 차체 | 배터리 2팩 (NiMH 6셀 + AA 6셀, 홀더 포함) | 350 |
| 차체 | Mega + 쉴드 | 80 |
| 차체 | L298 x1 + 스테퍼 드라이버 3 + HM-10 + 배선 | 90 |
| 차체 | 센서(라인·IR·초음파·스위치) | 40 |
| 차체 | 하판·상판·스탠드오프·나사 | 330 |
| Z축(고정) | Z 스테퍼 SF2421 (고정) | 250 |
| Z축(고정) | 가이드봉 Ø8x185 x2 + 클램프 | 190 |
| Z축(고정) | T8 리드스크류+커플러+너트+LM8UU | 110 |
| 승강대(이동) | θ 스테퍼 (승강대에 탑재) | 250 |
| 승강대(이동) | R 스테퍼 (회전대에 탑재) | 250 |
| 승강대(이동) | 회전대 판 + 큰 베어링/부싱 + 60T 풀리 | 110 |
| 승강대(이동) | 링크 2개 (24x20x1.6) + 허브 풀리/베어링/벨트 | 220 |
| 승강대(이동) | 포크 + IR + 레버 스위치 + 손목 허브 | 70 |
| 승강대(이동) | 캐리지·브래킷·나사 | 90 |
| 합계 | 차체 1275 + Z고정 550 + 승강대 990 | **2815** |
포크 방식 대비(승강대 = 포크+캐리지 약 180g 가정, Z스테퍼·봉 동일): 2005 g -> 팔 방식은 약 810 g 증가
PLAN 판정 기준 1.5kg 대비: 팔 방식 2.81 kg, 포크 방식 약 2.00 kg -> 두 방식 모두 1.5kg를 넘을 가능성이 크다(가정 오차 +-15%). 실측 전 기준 재검토 권고
Z 승강 하중(이동 질량) 990 g + CD 16 g

## D3. 관성·토크
θ 축(회전대 중심) 관성모멘트 J_θ
| 자세 | phi | 손목 R_w | J_θ (kg m^2) |
|---|---|---|---|
| 상단 행 뻗음 | 38.2 | 322 | 0.0189 |
| 운반(R_c=200) | 70.6 | 136 | 0.0070 |
| 접힘 | 105 | -106 | 0.0049 |
θ 가속 450 deg/s^2, 뻗음: 회전대 토크 0.169 N m -> 모터축 0.066 N m (보유토크 0.15~0.20 대비 38%)
θ 가속 450 deg/s^2, 운반: 회전대 토크 0.075 N m -> 모터축 0.029 N m (보유토크 0.15~0.20 대비 17%)
θ는 수직축이라 중력 토크 없음. 위 값은 가감속 토크이며 450 sps 이내에서 풀인 토크 약 60~70%(가정)를 쓰므로 여유가 있다.

R 축(어깨 phi) 환산 관성과 토크: 손목 반경가속도 a_R=2 m/s^2 (CD 슬립 방지, 0.2 g), 마찰 0.015 N m (가정)
| phi | J_eff (kg m^2) | phi_ddot (rad/s^2) | 어깨 토크 (N m) | 감속비 2:1 모터 | 3:1 모터 | 4:1 모터 |
|---|---|---|---|---|---|---|
| 38.2 | 0.0113 | 7.9 | 0.104 | 0.061 | 0.041 | 0.031 |
| 50.2 | 0.0158 | 6.3 | 0.116 | 0.068 | 0.045 | 0.034 |
| 70.6 | 0.0223 | 5.2 | 0.130 | 0.077 | 0.051 | 0.038 |
결론: R축은 수평면 운동이라 중력 토크 없음. 감속 3:1이면 필요 모터 토크 0.02~0.05 N m 수준으로 보유토크(0.15~0.20, 확인필요)의 1/4 이하. 감속비는 토크가 아니라 분해능(0.075deg/마이크로스텝 -> 팔끝 0.3~0.5mm)과 속도(모터 150 sps 환산)로 정해진다.

Z 축 (T8 리드 8, 효율 η=0.30 가정(플라스틱 너트), 가이드 마찰 2 N 가정)
| 승강 질량 (kg) | 상승 토크 (N m) | 자기 유지 | 판정 |
|---|---|---|---|
| 0.7 | 0.038 | 나선각 17.7deg > 마찰각 약 9deg 이므로 자기 유지 안 됨 -> 정지 중 홀딩 전류 필요 | OK |
| 0.9 | 0.046 | 나선각 17.7deg > 마찰각 약 9deg 이므로 자기 유지 안 됨 -> 정지 중 홀딩 전류 필요 | OK |
| 1.1 | 0.054 | 나선각 17.7deg > 마찰각 약 9deg 이므로 자기 유지 안 됨 -> 정지 중 홀딩 전류 필요 | OK |
Z는 스텝 탈조·낙하 방지를 위해 항상 ENABLE 유지(홀딩 전류), 전원 차단 시 하강(포크 방식과 동일). 승강대 질량이 포크 방식의 약 5배라 하강 충격 대비 하단 범퍼 필요.

## D4. 전도 안정성 (정적). 좌표: 바퀴축 중점 원점, +x 전진, +y 왼쪽
차체 질량 1.27 kg(무게중심 x=-20), Z 고정부 0.55 kg, 승강대 1.0 kg (D2 반올림)
터닝 축 x_T(회전대 중심)와 마스트 위치를 달리하여 최소 안정 여유(최단 변 거리, mm)를 계산. 마스트는 회전대에서 앞쪽 +60 mm에 배치(가정: 팔이 지나지 않는 전방 섹터)

### 지지 다각형 A: 구동륜 2 + 후방 캐스터 (삼각형)
| x_T | 5(상좌) 뻗음 | 6(상우) 뻗음 | 3(중좌) 뻗음 | 4(중우) 뻗음 | 1(하좌) 뻗음 | 2(하우) 뻗음 | 운반 후방 θ=180 | 접힘 θ=48 phi=105 |
|---|---|---|---|---|---|---|---|---|
| -30 | +12 (CoM -12,22) | +3 (CoM -3,-19) | +22 (CoM -22,16) | +12 (CoM -12,-18) | +27 (CoM -30,12) | +23 (CoM -23,-18) | +23 (CoM -23,-7) | +22 (CoM -22,0) |
| 0 | -5 (CoM 5,22) | -13 (CoM 13,-19) | +6 (CoM -6,16) | -5 (CoM 5,-18) | +14 (CoM -14,12) | +7 (CoM -7,-18) | +7 (CoM -7,-7) | +6 (CoM -6,0) |
| 20 | -16 (CoM 16,22) | -24 (CoM 24,-19) | -5 (CoM 5,16) | -15 (CoM 15,-18) | +3 (CoM -3,12) | -4 (CoM 4,-18) | -4 (CoM 4,-7) | -5 (CoM 5,0) |
| 40 | -26 (CoM 26,22) | -35 (CoM 35,-19) | -16 (CoM 16,16) | -26 (CoM 26,-18) | -8 (CoM 8,12) | -15 (CoM 15,-18) | -15 (CoM 15,-7) | -16 (CoM 16,0) |

### 지지 다각형 B: A + 전방 스키드 2개 (x=+95, y=+-70)
| x_T | 5(상좌) 뻗음 | 6(상우) 뻗음 | 3(중좌) 뻗음 | 4(중우) 뻗음 | 1(하좌) 뻗음 | 2(하우) 뻗음 | 운반 후방 θ=180 | 접힘 θ=48 phi=105 |
|---|---|---|---|---|---|---|---|---|
| -30 | +36 (CoM -12,22) | +44 (CoM -3,-19) | +31 (CoM -22,16) | +38 (CoM -12,-18) | +27 (CoM -30,12) | +29 (CoM -23,-18) | +36 (CoM -23,-7) | +41 (CoM -22,0) |
| 0 | +48 (CoM 5,22) | +56 (CoM 13,-19) | +43 (CoM -6,16) | +50 (CoM 5,-18) | +40 (CoM -14,12) | +42 (CoM -7,-18) | +49 (CoM -7,-7) | +53 (CoM -6,0) |
| 20 | +57 (CoM 16,22) | +65 (CoM 24,-19) | +52 (CoM 5,16) | +59 (CoM 15,-18) | +48 (CoM -3,12) | +50 (CoM 4,-18) | +57 (CoM 4,-7) | +62 (CoM 5,0) |
| 40 | +63 (CoM 26,22) | +60 (CoM 35,-19) | +60 (CoM 16,16) | +66 (CoM 26,-18) | +57 (CoM 8,12) | +58 (CoM 15,-18) | +66 (CoM 15,-7) | +70 (CoM 16,0) |

### 지지 다각형 C: 구동륜 + 전방 스키드(x=+80, y=+-85) + 후방 캐스터 2개(x=-70, y=+-60)
| x_T | 5(상좌) 뻗음 | 6(상우) 뻗음 | 3(중좌) 뻗음 | 4(중우) 뻗음 | 1(하좌) 뻗음 | 2(하우) 뻗음 | 운반 후방 θ=180 | 접힘 θ=48 phi=105 |
|---|---|---|---|---|---|---|---|---|
| -30 | +58 (CoM -12,22) | +65 (CoM -3,-19) | +48 (CoM -22,16) | +58 (CoM -12,-18) | +40 (CoM -30,12) | +47 (CoM -23,-18) | +47 (CoM -23,-7) | +48 (CoM -22,0) |
| 0 | +66 (CoM 5,22) | +67 (CoM 13,-19) | +64 (CoM -6,16) | +69 (CoM 5,-18) | +56 (CoM -14,12) | +63 (CoM -7,-18) | +63 (CoM -7,-7) | +64 (CoM -6,0) |
| 20 | +64 (CoM 16,22) | +56 (CoM 24,-19) | +71 (CoM 5,16) | +65 (CoM 15,-18) | +67 (CoM -3,12) | +69 (CoM 4,-18) | +74 (CoM 4,-7) | +75 (CoM 5,0) |
| 40 | +54 (CoM 26,22) | +45 (CoM 35,-19) | +64 (CoM 16,16) | +54 (CoM 26,-18) | +72 (CoM 8,12) | +65 (CoM 15,-18) | +65 (CoM 15,-7) | +64 (CoM 16,0) |

해석: 값은 가장 가까운 변까지 거리(mm), 음수면 전도. 목표 >= +20 mm(진동·경사 0.5deg 여유). 구성 A는 앞변이 구동륜 축선이라 팔이 앞을 향하는 자세에서 여유가 작거나 음수 -> 전방 스키드 필수.
스키드는 볼 캐스터를 지면보다 1~2 mm 띄워(스페이서) 정상 주행엔 닿지 않고 전도 시에만 접촉하도록 한다(라인 단차·교차점 걸림 방지).
