jbj7667/wafer-transfer-robot/docs/design/arm_calc/motion_out.md

## M1. 경로 간섭 점검 (팔꿈치 가지 s=+1: 팔꿈치 방향 = theta + phi, 전 행 공통)
운반 R_C=200 -> phi_C=70.6 deg, 손목 반경 136 mm
| 행 | theta_L | theta_R(펼침 좌표) | 운반 중 팔꿈치 방향 범위 | 팔꿈치 중심 y_min(mm) | 보스 r20 가장자리 | 링크 가장자리(14) |
|---|---|---|---|---|---|---|
| 상단 | 73.4 | 286.6 | 144~357 | 35.2 | 15.2 | 21.2 |
| 중단 | 101.5 | 258.5 | 172~329 | 64.0 | 44.0 | 50.0 |
| 하단 | 131.6 | 228.4 | 202~299 | 140.6 | 120.6 | 126.6 |
해석: 팔꿈치 원(반경 205)의 북쪽 끝 y=35가 최악. 보스 가장자리 약 15mm, S가 북쪽으로 10mm 틀어지면 약 5mm. 자기 구역 경계(y=0) 침범 여부는 대회 판정 방식 확인필요(바닥 투영만인지).

## M2. 픽 자세에서 링크 중심선과 넥(r=25)·다른 베이스 넥의 최소 거리 (링크 반폭 14 포함, 링크 높이대 z 약 125~165)
| 픽 베이스 | 링크1 최소거리 | 링크2 최소거리 | 대상 | 필요(25+14=39) | 판정 |
|---|---|---|---|---|---|
| 5 | 130 | 64 | 링크1:3, 링크2:5 | 39 | OK |
| 6 | 258 | 64 | 링크1:6, 링크2:6 | 39 | OK |
| 3 | 183 | 64 | 링크1:1, 링크2:3 | 39 | OK |
| 4 | 211 | 64 | 링크1:6, 링크2:4 | 39 | OK |
| 1 | 255 | 64 | 링크1:1, 링크2:1 | 39 | OK |
| 2 | 136 | 64 | 링크1:4, 링크2:2 | 39 | OK |
참고: 링크2 끝(손목)은 픽 대상 베이스에서 포크 길이 64mm 뒤에 있으므로 대상 넥과는 64-25-허브20=19mm 이상 떨어짐(자기 베이스는 위 표에서 제외되지 않음).

## M3. 한 CD 사이클 시간 (가정 상수: θ 150 deg/s, 450 deg/s^2 / R 400 mm/s, 2 m/s^2 / 삽입 120 mm/s / Z 30 mm/s, 0.3 m/s^2)
| 행 | θ 회전각(deg) | 접근 | 삽입 | 판정 | 승 | 후퇴 | 회전 | 뻗기 | 하강 | 빠져나옴 | 합계(s) |
|---|---|---|---|---|---|---|---|---|---|---|---|
| 상단 5->6 | 213 | 1.22 | 0.94 | 0.25 | 1.08 | 1.07 | 1.75 | 0.82 | 1.08 | 0.60 | **8.81** |
| 중단 3->4 | 157 | 1.72 | 0.94 | 0.25 | 1.08 | 0.91 | 1.38 | 0.67 | 1.08 | 0.60 | **8.62** |
| 하단 1->2 | 97 | 1.33 | 0.94 | 0.25 | 1.08 | 1.00 | 0.98 | 0.75 | 1.08 | 0.60 | **8.02** |
3개 합 25.4 s (보수: 회전·뻗기 순차). 회전 후반과 뻗기를 겹치면 CD당 약 0.4~0.6 s 절약 가능(가정).

접근 구간 상세(이전 행 오른쪽 출구 -> 다음 행 왼쪽 베이스 θ):
상단->중단 접근 회전 185 deg, 중단->하단 접근 회전 127 deg
| 행 | 접근 회전(deg) | 접근(s) | 사이클 합(s) |
|---|---|---|---|
| 5 | 25 | 1.22 | 8.81 |
| 3 | 185 | 1.72 | 8.62 |
| 1 | 127 | 1.33 | 8.02 |

## M4. 총 임무 시간 (예선 기준, 위치가 왼쪽인 경우)
| 구간 | s | 비고 |
|---|---|---|
| 출발 -> S 정지 | 4.5 | 가정: 960mm, 평균 0.25 m/s, 교차 감지·65mm 전진 포함 |
| 3 CD 이송 | 25.4 | M3 상세 (보수) |
| 접힘 복귀 | 1.4 | |
| 180도 회전 | 1.5 | 가정 |
| S -> 출발구역 | 5.3 | 가정 |
| **합계** | **38.2** | 포크 방식 약 58 s |
본선(무작위 배치) 최악: 각 행에서 첫 방문이 빈 베이스 -> 행마다 삽입·판정·후퇴 추가 + 반대편 이동: +6.2 s 정도 -> 44.4 s (150 s 대비 여유 106 s)

## M5. CD 이탈 점검 (운반 중, R_C=200)
구심가속 1.37 m/s^2, 접선가속 1.57 m/s^2, 합성 2.08 m/s^2 = 0.21 g
PETG-CD 마찰계수 0.3~0.4 (가정, 확인필요) -> 마찰만으로는 한계. 림 턱(2mm)이 수평 이탈을 기하적으로 차단하므로 허용. 시제품에서 W_TH를 100/150/200 deg/s로 올리며 CD 이동량 측정.

## M6. 스텝 속도와 타이머
| 축 | 감속/기구 | 마이크로스텝 | 최대 속도 | 최대 스텝률(sps) | 분해능 |
|---|---|---|---|---|---|
| θ | 20T:60T = 3:1 | 1/8 | 150 deg/s | 2000 | 0.075 deg -> 386mm에서 0.51 mm |
| R | 어깨 3:1 | 1/8 | 400 mm/s | 1205 | 0.33 mm (phi=38.2) |
| Z | T8 리드 8 | 1/4 | 30 mm/s | 3000 | 0.010 mm |
세 축 동시 최대 합 6205 sps. 20 kHz DDA 한 개 ISR이면 각 축 최대 10 kHz까지 가능, 평균 부하 (ISR 약 120 사이클 가정, 16 MHz): 15% CPU.
실제 SF2421 풀인 한계는 7.2V에서 풀스텝 환산 약 800~1000 sps(가정) -> θ 풀스텝 환산 250 sps, R 약 150 sps, Z 750 sps로 모두 한계의 1/4~3/4. Z가 가장 빠듯하므로 Z 속도는 30 -> 20 mm/s로 낮출 수 있다.

## M7. 전력 예산 (7.2 V NiMH 6셀 팩 하나로 스테퍼 3 + DC 모터 2, Mega는 별도 AA 팩)
스테퍼 1개 정지(전류 제한 0.7 A/상): 코일 손실 1.76 W -> 팩 전류 약 0.29 A (효율 85%, 가정). 이동 중 약 0.40 A.
| 상황 | 스테퍼 3개 | DC 2개 | 합계(A) | 팩 전압(내부저항 0.25 ohm, 가정) |
|---|---|---|---|---|
| 홀딩만(DC 정지) | 0.86 | 0.00 | 0.86 | 6.98 V |
| 팔 이동 | 1.21 | 0.00 | 1.21 | 6.90 V |
| 주행(스테퍼 홀딩) | 0.86 | 0.80 | 1.66 | 6.78 V |
| 주행 가속 피크 | 0.86 | 2.00 | 2.86 | 6.48 V |
임무 1회 전하량 14.3 mAh -> 팩 1520 mAh(1900 mAh x 80%, 가정) 로 약 107회. 홀딩만 켠 대기는 1.8 시간.
SLEEP 전략: DRV8834 SLEEP은 인덱서를 초기화하고 nENBL은 위상을 유지하지만 로터가 최근접 극으로 끌려가 풀스텝(θ에서 팔끝 4 mm)만큼 위치가 어긋날 수 있다. -> θ·R·Z 모두 출발 후 계속 enable 유지(전류 약 0.8 A), 대기·충전 중 및 임무 종료 후 정지 상태에서만 disable. 필요 시 R·θ는 이동 사이에 홀딩 전류를 낮춰주는 TMC2208(UART/자동 정지전류)로 교체.
전원 안정: 모터 팩은 스테퍼·DC 전용, Mega는 별도 팩이라 순간 강하로 리셋되지 않음. 드라이버마다 VMOT에 100 uF 이상 전해 커패시터 필수(배선 길이 5cm 이내).

## M8. 원점 복귀(전원 인가 시) 소요 시간
| 단계 | 동작 | 속도 | 시간(s) |
|---|---|---|---|
| 1 Z | 하단 리밋까지 하강(최대 행정 60mm) 후 2mm 후퇴, 저속 재접근 | 15 mm/s | 4.9 |
| 2 R | phi 증가 방향 접힘 리밋까지(최대 약 70deg) | 60 deg/s | 1.8 |
| 3 θ | 접힘 자세에서 θ 홈 스위치 확인, 눌려 있지 않으면 한 방향 탐색(최대 120deg) | 30 deg/s | 4.6 |
