jbj7667/wafer-transfer-robot/cad/params.md

# CAD 기준 파라미터 (v1.1 — Fusion v1 간섭 검사 반영) — 모델·가이드·BOM의 단일 기준

좌표계: 원점 = 좌우 바퀴 접지점을 잇는 선의 중점(바닥, Z=0). **+X 전진, +Y 왼쪽, +Z 위.** 단위 mm.
출처: `docs/design/mechanism.md` §3. 이 표와 다른 값이 있으면 이 표가 우선한다.

## 1. 전체·경계

| 이름 | 값 | 비고 |
|---|---|---|
| env_L / env_W / env_H | 250 / 250 / 250 | 출발 자세 한계 |
| x_rear | **−92** | 차체 후면 (v1.1c: 길이 249, 출력 공차 여유 1) |
| x_front_low | **+40** | Z<100 구간의 차체 최전방 = pocket_cx − 52 (하단 원기둥 반경 50 + 2). 라인센서 PCB·스테퍼 포함 |
| x_fork_tip | **+157** | 포크 끝 = pocket_cx + 65 (림 포함) |
| track_outer | ≤ 210 | 바퀴 외측 폭 |
| z_top | ≤ 245 | 마스트 상단 |

## 2. 주행부

| 이름 | 값 | 비고 |
|---|---|---|
| wheel_d / wheel_w | 65 / 26 | 기성 65mm 휠, 6mm D축 |
| axle_z | 32.5 | |
| motor_d / motor_len | 37 / 70 (기어부+모터, 실측 갱신) | 축 방향 = ±Y, 모터 몸체는 안쪽 |
| motor_mount | 3-M3, PCD 31 | 탭 깊이 실측 후 볼트 길이 결정 |
| deck1_z / deck1_t | 52 / 4 | 하판 아랫면 Z=52 (모터는 하판 아래 브래킷) |
| deck2_z / deck2_t | 100 / 3 | 상판 아랫면, 스탠드오프 M3×44 |
| caster | Pololu 3/8" 볼캐스터, X=−75, Y=0 | 높이 맞춤 스페이서 출력 |

## 3. 센서

| 이름 | 값 | 비고 |
|---|---|---|
| line_x / line_z | +25 / 10 (센서면 지면고, 5~15 조절 슬롯) | 66×24 PCB 장축 = Y |
| line_tilt | 0° 기본, 5/10/15° 교체 브래킷 | 차광 후드 포함 |
| sonar | **기본 구성에서 제외 (v1.1e, 선택 부품)** | 장착 가능한 자리(Y −57: 봉·스테퍼 회피, Z 77~97, 상판 아랫면에 매닮)에서는 정면 빔이 베이스 하단 원기둥(반경 50)을 빗나가고, 안쪽으로 약 35° 기울이면 가까운 거리만 보여 접근 감속에 쓸 수 없음. 깊이 정렬은 정지선 이벤트 + 넥 접촉 스위치로 충분. 장착하려면 `public/cad/print/P07_sonar_mount.stl` + 펌웨어 `SONAR_ENABLED=true` |
| ir_up | 포켓 중심 기준 X−40(반경 40, 후방), 포크 윗면 −45, 위를 향함 | 캐리지에 고정 |
| neck_switch | 레버 끝 접촉점 X = pocket_cx − 27 = **+65** (넥 반경 25 + 2) | 저작동력 롱레버, U 바닥(포크 루트 쪽)에 장착 |

## 4. 승강부

| 이름 | 값 | 비고 |
|---|---|---|
| mast_x | **+15** (리드스크류 축) | Y=0. 조건: 캐리지 앞면(mast_x+12) ≤ pocket_cx − 62 = CD 뒤끝 −2 |
| rod_y | ±30, X=+15 | Ø8 × **185**, Z 56~241 → 상부 블록에 13mm 이상 삽입 고정 |
| mast_top_block | **Z 232~245 (13mm)**: 608 베어링 시트(7) + 바닥벽 6, 봉 클램프 Ø8 ×2 | v1.1d: 아랫면 232 → 캐리지 기계적 정지 = 포크 윗면 227, 소프트웨어 상한(215)과 12mm 여유 |
| stepper | 42각, 중심 X=+15 → X −6~+36 (≤ x_front_low 40), 하판 위 Z 56~96, 축 위쪽 | 브래킷 출력 |
| coupler | 5→8, Z 96~121 | |
| leadscrew | T8 리드 8, **100mm**, Z 121~221, 상단 베어링(608 또는 출력 부싱) | **BOM 150 → 100 수정** |
| carriage | LM8UU×2 + T8 플랜지 너트, 앞면 X ≤ +27, 포크 장착면 X=+28 | **너트는 캐리지 아랫면에 플랜지 고정, 몸통이 아래로 매달림** → 너트 Z 140~154(원점) ~ 197~211(운반 +57). 리드스크류 끝(221)까지 여유 10, 커플러(121)까지 19 (v1.1c) |
| fork_z | 155(원점) ~ 215 (포크 윗면) | 175행 아래 165/운반 187, 200행 아래 190/운반 212 |
| limit_low | 캐리지 하단이 포크 윗면 Z=155 위치에서 눌림 (원점, 추가기능 ④) | 리밋 브래킷 P11_limit_low |
| limit_high | **v1.1d: 장착하지 않음** (선택 부품). 소프트웨어 상한 + 기계적 여유 12mm로 대체. `PIN_LIMIT_HIGH`는 풀업 상태로 두면 비활성 | 필요하면 상부 블록 옆면에 별도 설계 |

## 5. 포크

| 이름 | 값 | 비고 |
|---|---|---|
| pocket_cx | **+92** | 포켓(=CD) 중심. 라인센서(+25)에서 67 → 정지선 이벤트 후 크리프 약 33 |
| u_inner | 78 | 넥 Ø50 기준 횡 ±14 |
| fork_t | 4 (PETG) | 갈래 폭 각 20 |
| seat_angle | 8° | 갈래 윗면 안쪽 경사 |
| rim | 내경 Ø123, 높이 2, 앞·뒤 호(각 ±35°) | 앞쪽 호는 갈래 끝 |
| fork_root_x | **+28** | 캐리지 장착면 (CD 뒤끝 X=32보다 뒤) |

## 6. 기타

| 항목 | 값 |
|---|---|
| 배터리 크래들 2개 | 90×58×16을 **90° 돌려** 장축 = Y. X −92~−34, Y −90~0 / 0~+90 (바퀴 후단 X −32.5와 1.5 간격) (바퀴 뒤쪽이라 폭 180 가능, 전폭 210 이내). 하판 후방을 Y ±92로 확장 (v1.1b) |
| L298 | 상판, 43.5×43.5×29, 홀 37 |
| DRV8834 | 상판, 소형 캐리어 소켓 |
| Mega+IO 쉴드 | 상판 위, 102×54×27 (USB 포트 후방) |
| HM-10 | 상판 측면 |
| 버튼·LED·라벨 | 상판 후방 위 패널, 라벨 "정비제" + 팀번호 |
| 공차 | M3 관통 3.4, M3 인서트 구멍 Ø4.0 깊이 5.5, 끼움 0.2 |

## 7. v1.1 변경 이유 (Fusion v1 간섭 검사, 2026-10-27)

| 발견 | 원인 | 조치 |
|---|---|---|
| CD(Ø120)가 마스트·캐리지와 겹침 | CD 뒤끝 = pocket_cx − 60 = 25 < 마스트 X 30 | pocket_cx 85→92, mast_x 30→15 |
| 스테퍼가 하단 원기둥(r50) 침범 | 스테퍼 앞면 X51 > 원기둥 시작 X35 | 마스트 후퇴로 스테퍼 앞면 X36 ≤ 40 |
| 라인센서 PCB가 원기둥과 2mm 겹침 | 중심 거리만 보고 PCB 깊이 24 누락 | 원기둥 시작 X42 ↔ PCB 앞면 X37: 간격 5 |
| 마스트 높이 246 > 245 | 봉 190 | 봉 185 |

파생 점검: 상단 행 교차점에서 포크 끝 y ≈ +5(라인 남쪽 가장자리 감지 시점 기준), 180° 회전 시 포크 끝 반경 157 < 후퇴 후 축–넥 192 − 25 = 167 (여유 10).
