jbj7667/wafer-transfer-robot/docs/review/compliance.md

# 4단계 — 규정 교차검증 (Cross-Verification)

기준: 2026 운영계획(9/1판), 추가기능 FAQ(10/13), 회로·프로그램 FAQ, 기구 FAQ, 가공 운영기준(10/6), Q&A.
대상: `docs/design/mechanism.md`, `bom.md`, `wiring.md`, `state_machine.md`, `firmware/`, `app/`, `cad/` (Fusion 모델 v1).
판정: ✅ 충족 / ⚠️ 조건부(확인·실측 필요) / ❌ 위반

## 1. 로봇 제작 규정

| # | 규정 | 설계 | 근거 위치 | 판정 |
|---|---|---|---|---|
| R1 | 출발 전 250×250×250 이내 | 250×210×245 (축 −93 ~ 포크 끝 +157) | Fusion v1.1b 실측 §5 | ✅ |
| R2 | 이동은 지급 DC 모터 2개 | 지급 DC 기어드모터 2개, L298 구동 | wiring.md | ✅ |
| R3 | 동작 모터(타미야·스테퍼·RC서보) 합계 ≤3 | 스테퍼 1개(승강) | mechanism.md §1 | ✅ (예비 2) |
| R4 | 제어보드·센서는 지급품(스위치 제외) | Mega+IO 쉴드, 라인센서 1, IR 1, 초음파 1 = 모두 지급품. 리밋 2·넥 레버 1·출발 버튼 1 = 스위치류 | wiring.md 배선표 | ✅ |
| R5 | 라인센서 지급품 1개만 | 1개 | config.h 핀 | ✅ |
| R6 | IR·초음파 각 최대 3개 | 각 1개 | — | ✅ |
| R7 | 전원 AA×6 직렬, 팩마다 전원 스위치 | 제어 9V 팩·모터 7.2V 팩, 각각 SW | wiring.md 전원도 | ✅ |
| R8 | 출발 후 자율 수행 | RUN 상태에서 BLE 명령 무시 | wafer_robot.ino loop() | ✅ |
| R9 | 본선 웨이퍼 위치를 사람이 입력 금지 | 상향 IR로 감지. FIRST_SIDE는 "먼저 확인할 쪽" 순서일 뿐 위치 정보가 아님 | state_machine.md | ✅ |
| R10 | 직접 설계·제작, 완제품·키트·외주 금지 | 본인 설계·본인 장비 출력. 리드스크류·LM8UU·바퀴 등은 범용 기성품(허용 목록) | bom.md | ✅ |
| R11 | 팀번호·팀명 외부 부착 | 라벨 플레이트(정비제 + 팀번호) | fusion_guide.md | ✅ (출력 확인) |
| R12 | 사비 ≤ 120,000원, 영수증 첨부 | 추정 82,400원(+30% 가정 시 약 107,000) | bom.md | ⚠️ 주문 시 확정가 기입 |
| R13 | 가공: 레이저 가능한 부분은 레이저, 3D 프린터는 필요한 경우만 | 전 부품 개인 프린터 출력 | — | ✅ **해소(2026-10-27 사용자 확인): 출전 가능, 개인 3D 프린터 전 부품 출력 허용.** 필라멘트는 g 단가로 사비에 산입하는 방침은 유지 |
| R14 | 안전(참가자·경기장 위해 금지) | 날카로운 모서리 R2 이상, 배터리 고정 크래들 | fusion_guide.md | ✅ |

## 2. 경진대회 규정

| # | 규정 | 설계 | 판정 |
|---|---|---|---|
| C1 | 예선 120s 내 3개 이송 + 도착 | 추정 58s(여유 62s) | ✅ (모의대회 실측으로 확정) |
| C2 | 도착 판정: 몸체가 100mm 수직선을 덮고 정지 | 끝선 이벤트 후 30mm 전진 → 끝선이 차체 바로 아래 | ✅ |
| C3 | 본선 150s, 무작위 배치 | 행마다 왼쪽 확인 → 없으면 오른쪽, 최악 약 81s | ✅ |
| C4 | 상대 구역 침범 금지 | 180°는 남쪽 경유, 상단행 부분 회전(포크 끝 y ≥ 5) | ⚠️ 부분 회전 각도 실측 |
| C5 | 베이스는 고정되지 않음 | 넥 접촉 레버(저작동력), 저속 크리프, 기둥 위 이동은 clear 높이 | ⚠️ 레버 작동력 실측(베이스 이동 ≤3mm) |
| C6 | 재출발 2회까지 | 도착/고장 상태에서 버튼 → 재원점 → 대기 | ✅ |
| C7 | 예선·본선 로봇 동일, 프로그램만 변경 가능 | 동일 하드웨어, 같은 코드로 예선·본선 처리 | ✅ |
| C8 | 대기소 제출 후 개조 금지 | 예비 포크는 16강 이후 파손 시에만 | ✅ |

## 3. 추가 기능 5점

| # | 요건 | 구현 | 판정 |
|---|---|---|---|
| F1 | 지급 BLE 모듈 + **전용 앱**으로 출발(터미널 앱 불인정) | App Inventor 앱 START → "S" → IDLE에서만 RUN | ✅ (앱 빌드·실기 시험 남음) |
| F2 | 로봇 부착 푸시 스위치로 출발 | D19 버튼, 1kHz 디바운스 | ✅ |
| F3 | 스마트폰 전압 모니터링(**전용 앱**) | 분압 1/3 → A2/A3 → "V,..." 2Hz → 앱 표시·경고색 | ✅ |
| F4 | 전원 On 시 **센서로** 자체 초기화. RC서보 단순 구동·초기화 불필요 구조 불인정 | 스테퍼 승강축을 하단 리밋 스위치로 원점 잡기(빠른 탐색 → 후퇴 → 느린 재탐색) | ⚠️ 리밋 스위치를 "센서"로 인정하는지 확인 권장. 보강안: 원점 잡기 후 상향 IR로 포크 위 비어 있음 확인, 라인센서 자가점검을 함께 표시 |
| F5 | 외관 LED, 이동 중 Off, 시작·도착 구역에서 초당 4회 **계속** 점멸 | Timer1 125ms 토글. IDLE·HOMING·ARRIVED 점멸, RUN 소등 | ✅ |

※ 추가기능은 예선에서 평가하고, 본선에서 동작하지 않으면 점수가 취소된다 → 본선 전 체크리스트에 F1~F5 시연 포함.

## 4. 불필요한 변경·규정 이탈 점검

| 항목 | 내용 | 판정 |
|---|---|---|
| 모터드라이버 | 지급 L298 유지. TB6612 교체는 Q&A 확인 전까지 하지 않음 | ✅ 변경 없음 |
| 스테퍼 드라이버 | A4988 → DRV8834: 학과가 전압 부족으로 교체 지급한 부품 | ✅ |
| 엔코더 | 사용 안 함(센서 지급품 규정) | ✅ |
| 원격 조작 | 주행 중 앱 명령 무시 | ✅ |
| 처음 요약과 다른 결정 | 아크릴 → 개인 3D 프린팅 | ✅ R13과 동일 항목, 해소됨 |

**결론**: 위반(❌) 없음. 조건부(⚠️)는 5건이고(R13은 2026-10-27 해소), 모두 **실측 또는 확인**으로 닫힌다. 남은 확인 항목: R12(사비 확정가), C4(상단 행 후진·시간 회전 실측), C5(넥 스위치 작동력 실측), F4(리밋 스위치 원점이 "센서 초기화"로 인정되는지 — 자가 점검(IR·라인·전압)을 함께 표시해 근거를 보강함).

## 5. Fusion v1.1b 실측 (2026-10-27, `cad/model/README.md`, 클라우드 `Default Project/wafer_robot_v1_1`)

모델은 단순화(상자·원기둥)했고 치수·배치는 `cad/params.md` v1.1b와 같다. 간섭 해석은 Fusion 간섭 검사 + 좌표 계산으로 했다.

| 항목 | 기준 | 실측 | 판정 |
|---|---|---|---|
| 출발 자세 외곽 (L×W×H) | ≤ 250×250×250 | **250 × 210 × 245** (X −93~157, Y ±105, Z 0~245) | ✅ (v1.1b 길이 여유 0 → **v1.1c 후면 −92로 길이 249**, 출력 공차 1mm 확보) |
| Z<100, |Y|≤50 부품 최전방 | ≤ +40 (하단 원기둥 시작 +42) | 하판 +40, 라인센서 +37, 스테퍼 +36 | ✅ |
| 픽 접근(포크 윗면 Z155) 로봇–베이스 간섭 | 0 | 0 | ✅ |
| 200행 픽(포크 Z190) 로봇–베이스·CD 간섭 | 0 | 0 (넥 횡 여유 14) | ✅ |
| 운반(포크 Z212) 캐리지·마스트–들린 CD 간섭 | 0 | 0 | ✅ |
| 캐리지 상단–상단 블록 | > 0 | 4 | ✅ |
| 리드스크류 너트–스크류 끝 | > 0 | v1.1b 0 → **v1.1c 너트 하향 장착으로 10** | ✅ (모델 반영은 다음 수정 때) |
| 로봇 내부 간섭 | 0 | 0 (면 접촉만) | ✅ |
| 출력 부품 총중량(추정) | — | 약 424 g (PLA 285 + PETG 139), 낭비 포함 약 490 g ≈ 9,800원 | 예산 반영 |

모델링 과정에서 발견해 고친 설계 오류(문서 단계에서 놓친 것): CD–마스트 겹침, 스테퍼의 하단 원기둥 침범, 라인센서 PCB 2mm 겹침, 마스트 높이 1mm 초과, 리드스크류 길이(150 → 100), 배터리–스테퍼 겹침(배터리 가로 배치), 상단 행 회전 시 센서 이탈과 오버슈트 침범(후진 + 시간 회전 + 편향 진입). 상세: `cad/params.md` §7, `mechanism.md` §3.
