jbj7667/wafer-transfer-robot/cad/arm_bench/belt_out.md

# Bench 벨트·풀리 재계산 (L=180, GT2 6mm 피치 2mm)

## 1. 링크 연동 벨트 (C=180, 2:1 / 1:2)

| Ts:Te | PD(mm) | 계산 길이 | 이빨수(정수) | 그 N의 C | 접촉각 | 접촉이빨 | 가장 가까운 표준 폐루프 | 그 길이의 C | C 변화(mm) |
|---|---|---|---|---|---|---|---|---|---|
| 30:15 | 19.1/9.5 | 405.1 | 203 (406) | 180.44 | 177 | 7.4 | 404 (202T) | 179.44 | -0.56 |
| 40:20 | 25.5/12.7 | 420.2 | 210 (420) | 179.89 | 176 | 9.8 | 404 (202T) | 171.88 | -8.12 |
| 44:22 | 28.0/14.0 | 426.3 | 213 (426) | 179.86 | 176 | 10.7 | 440 (220T) | 186.87 | +6.87 |
| 46:23 | 29.3/14.6 | 429.3 | 215 (430) | 180.35 | 175 | 11.2 | 440 (220T) | 185.36 | +5.36 |
| 52:26 | 33.1/16.6 | 438.4 | 219 (438) | 179.81 | 175 | 12.6 | 440 (220T) | 180.81 | +0.81 |
| 54:27 | 34.4/17.2 | 441.4 | 221 (442) | 180.30 | 175 | 13.1 | 440 (220T) | 179.29 | -0.71 |
| 56:28 | 35.7/17.8 | 444.4 | 222 (444) | 179.78 | 174 | 13.6 | 440 (220T) | 177.78 | -2.22 |
| 60:30 | 38.2/19.1 | 450.5 | 225 (450) | 179.75 | 174 | 14.5 | 440 (220T) | 174.74 | -5.26 |

선정: **52T:26T + 폐루프 440 mm(220T)**: C=180.81 mm (설계 180 대비 +0.81 mm). 링크 슬롯/텐셔너 행정 ±3 mm 안. 접촉 이빨 12.7 (>=6). 팔꿈치 26T 이므로 슬랙 증폭 L/r_e=21.7 (r_e=8.28).
대안: 40:20 은 420 mm 가 표준 길이가 아니고, 60:30 은 450 mm 도 표준이 아니므로(440 은 C=174.7 로 -5.3 mm, 슬롯 범위 밖) 제외.
표준 길이가 없을 때(오픈 벨트 + 클램프): 정수 이빨 219T (438 mm) -> C=179.81, 클램프 이음은 이빨 6개 이상 물림.

벨트1(어깨 52T -> 팔꿈치 26T, 링크1 안), 벨트2(팔꿈치 26T -> 손목 52T, 링크2 안): **같은 440 mm 2개**.

## 2. θ 회전대 감속 (보유 310 mm = 155T)

| 풀리 | PD | C(mm) | 접촉각 | 접촉이빨 | 대풀리 플랜지 외경 |
|---|---|---|---|---|---|
| 20T:60T (3:1) | 12.73/38.20 | 114.29 | 167 | 9.3 | 41.2 |

## 3. R(어깨) 구동: 같은 20T:60T, C=114.3 -> **폐루프 310 mm 1개 추가 구매** (arm_option §2.3 의 R 3:1 오픈 벨트를 폐루프로 대체, 클램프 불필요)

## 4. 슬랙 증폭 (팔끝 변위 = L*s/r_e, L=180)

| 팔꿈치 T | r_e | 증폭 | s=0.1 | s=0.2 |
|---|---|---|---|---|
| 20 | 6.37 | 28.3 | 2.8 | 5.7 |
| 26 | 8.28 | 21.7 | 2.2 | 4.3 |
| 30 | 9.55 | 18.8 | 1.9 | 3.8 |

## 5. 풀리 치수 (PD / 이빨끝 OD / 플랜지 외경=PD+3)

| T | PD | OD | 플랜지 |
|---|---|---|---|
| 20 | 12.73 | 11.97 | 15.7 |
| 26 | 16.55 | 15.79 | 19.6 |
| 52 | 33.10 | 32.34 | 36.1 |
| 60 | 38.20 | 37.44 | 41.2 |

## 6. 구매 목록 (벨트·풀리·체결)

| 품목 | 수량 | 용도 |
|---|---|---|
| GT2 6mm 폐루프 440 mm (220T) | 3 (사용 2 + 예비 1) | 링크 연동 벨트1·2 |
| GT2 6mm 폐루프 310 mm (155T) | 1 추가 (보유 1은 θ) (예비 1 권장 = 2) | R 구동 |
| GT2 6mm 오픈 벨트 | 1 m (선택) | 폐루프를 못 구할 때 438 mm + 클램프 2쌍 |
| 608ZZ | 10 (사용 7: θ축 2, 어깨허브 2, 팔꿈치허브 2, 손목 1 + 아이들러 2~3) | 베어링 |
| M8 나사봉(전산) 1 m 또는 M8x120 / x60 / x40 볼트 | 축 3개: 어깨·θ 공용 축 120, 팔꿈치 60, 손목 45 | 고정축 |
| M8 너트·와셔 | 약 14 / 14 | 축 체결, 스페이서 |
| M3 세트스크루 8~10 mm | 8 | 풀리 고정 |
| M3x10 / M3x16 나사 + 너트 | 각 40 / 20 | 뚜껑, 허브-링크 체결, 모터 |
| M4 열삽입너트 (또는 M5) | 2 | 테이블 고정 클램프 위치 |
| GT2 20T 알루미늄 풀리 보어 5 mm (선택) | 2 | 인쇄 20T 대신(모터 풀리 정밀도) |
