jbj7667/wafer-transfer-robot/docs/arena/A_lift.md

# 브레인스토머 A — 승강·구동 기구학 관점

## 공통 기하 (모든 아이디어에 적용한 가정)
- CD 밑면 높이 H = 175 또는 200. 포크 윗면 필요 위치: 진입 H−8 → 들어올림 H+10 → 내려놓기 H−8. 즉 Z 위치 4개(167/185/192/210), **필요 스트로크 ≈ 43mm, 여유 포함 60mm(160~220)**. 220 < 250 이므로 시작 크기와 충돌 없음.
- 포크: U자, 내측 간격 70mm(기둥 Ø50 → 좌우 각 10mm 여유), 갈래 폭 15mm(반경 35~50 위치에서 CD 지지, CD 반경 60). 갈래 길이 130mm.
- 하단 원기둥 Ø100 윗면이 z=100 이므로 포크(z≥160)와 간섭 없음. 몸체 앞끝은 베이스 중심에서 55mm 이상 떨어져야 함 → 정지선(중심-100) 기준 몸체 앞끝 ≤ +45mm.
- **포크 U 중심을 라인센서보다 정확히 100mm 앞에 두면 "정지선 검출 = 포크 정렬"이 되어 별도 리치 축이 필요 없다.** 리치 축 아이디어는 이 오차(±5)를 줄이거나 몸체 충돌을 피하려는 대안.
- 내려놓기 허용: CD가 Ø50 위에 남으려면 중심 편차 < 약 20mm.
- 타미야 H.E. 6단 기어박스 감속비는 대략 11.6 / 18.9 / 38.2 / 64.8 / 115 / 344:1 범위(정확 값은 실측 필요), 5V 부근에서 38:1 단 출력 ≈ 150~200rpm 추정.
- SF2421 스테퍼 200스텝/rev, DRV8834 1/8 마이크로스텝 시 1600펄스/rev.

## 아이디어 25개

| ID | 이름 | 핵심 원리(1~2문장) | 동작모터(종류×개수) | 175/200 대응 | 시작 250³ 충족 방법 | 원점잡기(초기화) | 정렬 허용오차 추정(mm) | 사이클시간 영향 | 제작난이도 1~5 | 주요 리스크 |
|---|---|---|---|---|---|---|---|---|---|---|
| A01 | 스테퍼 + T8 리드스크류 Z축 | T8(리드 8mm) 리드스크류 1개 + Ø8 가이드봉 2개(LM8UU)로 포크 캐리지를 수직 이송. 60mm = 7.5rev = 1500 풀스텝. | 스테퍼×1 | 스텝 수로 4개 높이 임의 설정(분해능 0.04mm) | 마스트 높이 230, 포크는 몸체 앞 45mm 돌출, 전체 230×200×230 | 하단 리밋스위치로 호밍 후 스텝 카운트 → 자체 초기화 인정 확실 | 좌우 ±10, 전후 ±15 (Z는 ±0.5) | 60mm 이동 ≈ 1.2s(1200스텝/s), 무게중심 낮음 | 2 | 커플러 편심 시 워블, 스텝 탈조(가감속 필수), 스테퍼 전류 1A가 7.2V팩 소모 |
| A02 | 스테퍼 + GT2 벨트 수직 캐리지 | 20T GT2 풀리(40mm/rev)로 벨트를 감아 캐리지 상하. 60mm = 1.5rev = 300스텝. | 스테퍼×1 | 스텝 수로 임의 높이 | 상·하 풀리 간 180mm 마스트, 높이 235 | 하단 리밋 호밍 | 좌우 ±10, Z ±1 (벨트 늘어남) | 60mm ≈ 0.4s, 리드스크류보다 3배 빠름 | 2 | 전원 OFF 시 자중 낙하(16g+포크 60g은 디텐트 토크로 대부분 유지), 벨트 장력 관리 |
| A03 | 타미야 + T8 리드스크류 + 높이 스위치 3개 | 스테퍼 대신 타미야 38:1 단으로 T8을 돌리고, 마스트에 리밋스위치 3~4개(160/185/210 등)를 달아 DC 모터를 스위치에서 정지. | 타미야 DC×1 | 행 높이별 스위치 위치 고정(167/192 진입, 185/210 들기) → 스위치 4개 | A01과 동일 | 최하단 스위치까지 내려 원점, 이후 스위치 이벤트로 위치 판정 | 좌우 ±10, Z ±1.5(관성 오버런, 셀프락이라 작음) | 7.5rev ÷ 3rev/s ≈ 2.5s | 2 | 스위치 4개 배선, 오버런 편차, 모터 노이즈(커패시터 필수) — 스테퍼 슬롯 절약이 장점 |
| A04 | 가로 리드스크류 시저 리프트 | 2단 시저(링크 길이 100mm)를 수평 T8 나사로 하단 피벗을 당겨 들어올림. 각도 15°→35°로 높이 52→115(1단당), 비선형 증폭 약 1.5~3배. | 스테퍼×1 | 스텝↔높이 테이블(룩업)로 4개 높이 | 접힌 높이가 낮아 시작 높이 150 가능, 포크 리치를 시저 위에 둬도 250 이내 | 수평 나사 끝 리밋 | 좌우 ±10, Z ±1, 시저 유격으로 포크 끝 흔들림 ±2 | 30mm 나사 이동으로 60mm 승강 ≈ 0.8s | 4 | 링크 핀 유격 누적(인쇄 핀 8개), 낮은 각도에서 하중 증폭(16g라 문제 작음), 측면 강성 |
| A05 | 서보 평행링크 포크 | 길이 120mm 평행 4절 링크를 RC서보로 회전, 포크는 항상 수평. ±15° 회전 시 수직 ±31mm. | RC서보×1 | 서보 각도 4개 값으로 높이(167/185/192/210) | 링크를 수평 접힘으로 두면 높이 200 이하 | **서보 단독은 초기화 불인정** → 별도 축 필요 | 좌우 ±10, 전후는 회전 호에 따라 ±3 변화(보정 가능), Z ±2 | 30° 회전 0.3s, 가장 빠름 | 2 | 서보 데드밴드·떨림, 전원 시 급동작, 호 운동으로 포크가 전후로 4mm 움직여 CD 끌림 |
| A06 | 타미야 원판 캠 + 3단 체류 | 원판 캠(최대 반경차 30mm)을 레버 2:1로 증폭해 포크 60mm 승강. 캠 둘레에 '진입175/들기175/진입200/들기200' 체류(dwell) 구간을 만들고 캠 측 스위치로 위치 인식. | 타미야 DC×1 | 캠 프로파일 자체에 두 행 높이를 새김 → 소프트웨어 단순 | 캠 Ø90을 몸체 내부 수평 배치, 높이 영향 없음 | 캠 홈 노치 + 마이크로스위치(1회전 1펄스) + 체류 구간 스위치 | 좌우 ±10, Z ±0.5(체류 구간은 각도 오차 무관) | 1회전 ≈ 1.5s, 단방향 회전만 → 순서 고정 | 3 | 캠 프로파일 설계·출력 정밀도, 캠은 단방향이라 '들기→내리기' 순서를 캠 순서로 맞춰야 함 |
| A07 | 이중 대향 랙 + MGN9 레일 | 타팀 랙피니언의 강성 문제를 MGN9 리니어레일(1개 약 1~1.5만원)과 좌우 대칭 랙 2개(가운데 피니언 m1 20T, 62.8mm/rev)로 해결. | 스테퍼×1 | 스텝으로 임의 높이 | 레일 길이 150, 마스트 높이 230 | 하단 리밋 호밍 | 좌우 ±10, Z ±0.3(백래시는 대향 랙 프리로드로 상쇄) | 60mm ≈ 1rev ≈ 0.3s | 3 | 레일 비용, 대향 랙 정렬, 홀딩 토크 없을 때 낙하(스테퍼 상시 통전 필요) |
| A08 | 2단 텔레스코픽 마스트(지게차식 캐스케이드) | 내측 마스트를 리드스크류로 올리면 고정 벨트/와이어가 캐리지를 2배 속도로 올림(1:2 캐스케이드). | 스테퍼×1 | 스텝으로 임의 높이 | 접힌 마스트 높이 140, 펼치면 포크 230까지 → 시작 크기 여유 최대 | 내측 마스트 하단 리밋 | 좌우 ±10, Z ±1(와이어 신율) | 30mm 나사로 60mm 승강 ≈ 0.6s | 4 | 단 간 유격 누적, 와이어 장력·끊김, 부품 수 많음 — 시작 높이 제약이 실제로는 느슨해 과설계 가능성 |
| A09 | 전후 리치 슬라이드 + 승강 2축 | 포크를 벨트 리니어 슬라이드(스테퍼, 리치 120mm)에 얹어 로봇 정지 후 포크만 전진. 정지선 ±5 오차를 IR 거리(기둥 측정)로 보정해 리치량 조정. | 스테퍼×1(리치) + 서보 또는 타미야×1(승강) | 승강축이 담당 | 리치 수축 시 몸체 내부, 길이 220 | 리치축 후방 리밋 + 승강축 하한 리밋 | 좌우 ±10, **전후 ±3(IR 보정)** | 리치 왕복 +0.8s/회 | 3 | 모터 슬롯 2개 소모, IR(GP2Y0A41SK) 기둥 Ø50 곡면 측정 노이즈 |
| A10 | 1모터 L자 캠트랙(리치+승강 공유) | 포크 캐리지 핀이 L자 홈을 따라 이동: 벨트 1개가 당기면 먼저 수평 80mm 전진 → 홈 끝 경사 구간에서 상승 60mm. 역회전 시 역순. | 스테퍼×1 | 경사 구간의 스텝 위치로 높이 선택(경사 1:1) | 수축 상태 몸체 내부 | 트랙 시작점 리밋 하나로 두 동작 모두 원점 | 좌우 ±10, 전후 ±5, Z ±1 | 전체 140mm 이동 ≈ 0.9s | 4 | 경사 구간에서 상승과 동시에 전후 이동이 생겨 CD를 내려놓을 때 위치가 이동(1:1 경사면 10mm 하강 = 10mm 후퇴, 계산 보정 필요) |
| A11 | 팬터그래프(Lazy-tong) 리치 | 3단 X링크 신축 암을 서보 1개로 펼쳐 120mm→280mm 리치. 몸체를 베이스에서 멀리 세워 충돌 원천 차단. | 서보×1(리치) + 승강용×1 | 승강축이 담당 | 접힘 길이 120 | 서보는 초기화 불인정, 승강축으로 확보 | 좌우 ±12(링크 유격 증폭), 전후 ±6 | 펼침 0.4s | 4 | 링크 유격이 단마다 누적되어 끝단 처짐 5mm 이상 가능, 측면 강성 약함 |
| A12 | 단일 피벗 암 + 중력 수평 포크(진자 힌지) | 길이 150mm 암을 회전, 포크는 암 끝 힌지에 매달려 무게(+하부 추 30g)로 수평 유지. 평행링크 없이 레벨링. | 스테퍼×1 + 웜기어(1:30, 셀프락) | 각도 −10°~+15° → 수직 65mm 범위에서 임의 | 암을 비스듬히 접어 높이 220 | 암 하한 리밋 | 좌우 ±10, Z ±1.5, 포크 흔들림 감쇠 필요 | 25° 회전 ≈ 0.8s | 3 | 주행·정지 시 진자 흔들림 → CD 이탈, 댐핑 패드(TPU) 필요 |
| A13 | 타미야 윈치 + 도르래 1:2 | 타미야 스풀(Ø20)로 다이니마 줄을 감아 캐리지를 2:1 도르래로 들어올림, 하강은 자중. | 타미야 DC×1 | 상·하 리밋 + 시간 제어 또는 높이 스위치 3개 | 마스트 230 | 하단 리밋(줄 풀림 감지 겸용) | 좌우 ±10, Z ±3(DC 시간 제어 시), 스위치 사용 시 ±1.5 | 60mm = 줄 120mm = 1.9rev ≈ 0.7s | 2 | 줄 엉킴·풀림 과다 시 역감김, 하강 속도가 자중 의존, 진동 시 캐리지 튐 |
| A14 | 서보 크랭크-슬라이더 수직 승강 | 서보 혼(크랭크 r=30)과 커넥팅로드(80mm)로 가이드봉 위 캐리지를 상하 60mm. 사점 근처에서 속도↓·정밀↑. | RC서보×1 | 크랭크 각도 4개로 높이 지정 | 마스트 220 | 서보라 불인정, 하단 리밋 붙여도 '서보 단순구동'으로 볼 위험 | 좌우 ±10, Z ±1 | 180° ≈ 0.5s | 2 | 서보 토크 대비 하중은 충분, 사점에서 서보 떨림, 초기화 점수 포기 가능성 |
| A15 | 상부 접근 에지 클램프 | 포크 대신 위에서 내려와 CD 가장자리(Ø120)를 V홈 조 2개로 좌우에서 집음. 조 개폐는 서보 1개 + 대칭 랙(좌우 반대 이동). | 스테퍼×1(Z) + 서보×1(조) | Z 스텝으로 H+5 위치에서 집기 | 그리퍼 아래로 늘어뜨리면 높이 250 근접 → 마스트 240 이하로 설계 | Z 상한 리밋 | 좌우 ±15(V홈이 중심으로 끌어당김), 전후 ±15 | 집기 0.3s 추가 | 3 | CD 두께 1.2mm라 에지 잡기 실패, 조가 Ø50 기둥과 무관하지만 집는 순간 베이스 밀림 |
| A16 | 측면 쐐기 조(wedge jaw) 미세 리프트 | 포크 갈래 2개가 좌우에서 닫히며 윗면 15° 쐐기로 CD를 3mm 들어올림 → 정밀 Z 없이 '들기'가 됨. 큰 Z는 행 높이 2단(175/200)만 선택. | 서보×1(조) + 2단 높이 선택 1축 | 2위치 높이 선택(예: A23 토글) | 조 열림 폭 160 이내 | 높이 선택축 리밋 | 좌우 ±8, Z는 2위치라 ±1 | 조 개폐 0.3s, Z 이동 거의 없음 | 3 | 쐐기 마찰로 CD 측방 밀림, 열면서 내려놓을 때 CD 낙하 3mm(Ø50 위 안착 신뢰성 검증 필요) |
| A17 | 2단 텔레스코픽 서랍식 포크(수평 1:2) | 서랍 레일 2단을 랙-서보로 밀면 내부 벨트가 2단을 2배속으로 내밀어 서보 60mm 스트로크로 리치 120mm. | 서보×1(리치) + 승강 1축 | 승강축 담당 | 수축 길이 130 | 승강축으로 초기화 | 좌우 ±10, 전후 ±5, 끝단 처짐 2~3mm | 리치 0.4s | 4 | 2단 처짐, 서랍 레일 인쇄 공차 — 리치 필요성 자체가 낮음 |
| A18 | 호컨(Hoeckens) 직선 링크 승강 | 서보 1개 크랭크(r=20)로 호컨 4절 링크 결합점이 근사 직선 60mm를 그려 리니어베어링 없이 수직 승강. | RC서보×1 | 크랭크 각도 | 링크 높이 150 | 서보 불인정 | 좌우 ±10, Z ±1, 직선 편차 ±0.5 | 0.4s | 3 | 링크 4개 핀 유격, 수평 포크 유지 위해 추가 평행링크 필요 → 결국 복잡 |
| A19 | 2자유도 평면 암(어깨+팔꿈치) + 벨트 레벨링 | 서보/스테퍼 2개로 리치 ±40, 높이 60 범위를 독립 제어. IR로 기둥 거리를 측정해 정지선 오차를 암이 흡수. | 스테퍼×1(어깨, 리밋 호밍) + 서보×1(팔꿈치) | 역기구학으로 임의 높이 | 접힘 시 높이 200 | 어깨 리밋 | 좌우 ±10, **전후 ±3** | 동시 이동 0.6s | 5 | 역기구학·튜닝 시간, 팔꿈치 서보 처짐, 4주 1인으로는 과함 |
| A20 | 제네바 인덱스 높이 스텝 | 타미야 연속 회전 → 4슬롯 제네바(90° 스텝) → 피니언(1스텝=리프트 15mm). 정지 구간에서 기계적 잠금이라 위치가 오차 없이 유지. | 타미야 DC×1 | 0/15/30/45mm 4개 인덱스가 167/185(행 175)…를 맞추도록 기준 높이 설계 — 175행 진입·들기, 200행 진입·들기 = 167/185/192/210 은 간격이 불균일하므로 7.5mm 피치 8인덱스로 설계 | 마스트 230 | 구동휠 1회전 1펄스 스위치 + 하한 리밋 | 좌우 ±10, Z ±0.3(인덱스 잠금) | 1인덱스 ≈ 0.3s, 6인덱스 ≈ 1.8s | 4 | 제네바 출력 정밀도, 충격 하중, 높이 간격 설계 제약 |
| A21 | 배럴 캠(나선 홈 튜브) 승강 | 스테퍼가 Ø40 튜브를 돌리면 내부 나선 홈(1회전 60mm)을 따라 포크 캐리지 핀이 상승. 홈에 4개 수평 체류 구간 → 각도 오차가 높이 오차로 안 감. | 스테퍼×1 | 체류 구간 4개를 167/185/192/210에 배치 | 튜브 길이 90, 마스트 높이 220 | 튜브 원점 리밋 | 좌우 ±10, Z ±0.3 | 1회전 300스텝 ≈ 0.5s | 4 | 배럴 홈 출력(서포트 필요, 세로 분할 출력), 핀 마모, 가이드봉 별도 필요 |
| A22 | 플로팅 포크(±10mm 컴플라이언스) + V 센터링 | 포크를 스프링 센터링된 XY 플로팅 스테이지(±10mm)에 얹어 U 안쪽 V자 입구가 기둥 Ø50에 닿으면 측방으로 자동 정렬. U 바닥 리밋으로 '도달' 감지. | 승강 1축(별도) | 승강축 담당 | 영향 없음 | 승강축 + 플로팅 잠금 위치 스위치 | **좌우 ±18, 전후 ±10**(정렬 허용치 최대) | 정지 판정이 접촉 기반 → 정지선 의존 감소 | 3 | 베이스가 고정 안 됨 → 스프링력 0.2N 이하로 설계해야 베이스를 안 밂, 주행 중 포크 흔들림(들고 나면 잠금 필요) |
| A23 | 토글(오버센터) 2단 높이 선택 + 소형 리프트 | 서보①이 오버센터 토글을 넘겨 마스트를 '175행/200행' 두 위치에 기계 잠금(차이 25mm), 서보②크랭크가 진입/들기 18mm만 담당. | RC서보×2 | 기계적 2위치 → 소프트 단순 | 마스트 220 | 서보만이라 불인정 | 좌우 ±10, Z ±0.5(토글 잠금) | 0.3s+0.3s | 3 | 초기화 점수 없음, 서보 2개 + 주행 → 노이즈 대책 필요 |
| A24 | 관람차형 180° 스윙 평행링크(앞↔뒤 이송) | 반경 110mm 암이 몸체 위로 180° 회전하며 1:1 타이밍벨트로 포크 수평 유지. 앞에서 들고(θ=+8°↔−8°, ±15mm) 몸체 위를 넘겨 뒤쪽에 내려놓음 → **로봇이 180° 제자리 회전 없이 직진/후진만으로 맞은편 베이스 접근**. | 스테퍼×1(+웜 1:20 또는 벨트 3:1) | 끝단 각도 θ로 높이: 200행은 θ=+5°대, 175행은 θ=−8°대(R·sinθ 차 25mm) | 수직 직립 상태로 출발 시 폭 220·높이 245 내 — 경계, 45° 비스듬히 시작 | 앞쪽 하한 리밋 1개 | 좌우 ±10, Z ±1, 전후 ±3(호 운동) | 회전 180° ≈ 1.5s, 대신 로봇 180° 선회(약 2s, CD 이탈 위험) 제거 | 4 | 회전 중 CD 원심력(느리게 회전 시 무시 가능), 몸체 위 통과 높이 320 → 운행 중 크기는 허용되나 무게중심 상승 |
| A25 | 전후 관통 셔틀(양끝 경사 트랙) | 몸체 상부 길이 260mm 레일 위를 포크 셔틀이 벨트로 이동; 레일 양 끝에 1:1 경사 구간(60mm)이 있어 같은 모터가 리치·승강·앞→뒤 이송을 모두 수행. | 스테퍼×1 | 경사 구간 내 스텝 위치로 높이 선택 | 레일 260은 250 초과 → 양끝 경사부를 힌지 접이식(출발 후 서보 없이 스프링 전개)으로 시작 230 | 레일 중앙 리밋(1개로 전체 원점) | 좌우 ±10, 전후 ±5(경사 전후 결합 보정 필요), Z ±1 | 앞→뒤 이송 ≈ 1.5s, 선회 제거 | 5 | 경사부에서 Z와 X가 결합되어 내려놓을 때 CD 위치 이동, 접이 전개 신뢰성, 길이로 인한 무게 |

## 내 관점 상위 5개

1. **A01 스테퍼 + T8 리드스크류 (+ "센서-포크 100mm 오프셋" 고정 리치)**
   셀프락이라 전원/진동에도 높이가 안 변하고, 하단 리밋 호밍으로 자체 초기화 점수를 확실히 받는다. 60mm/1.2s면 3회 왕복 기준 사이클 손실이 약 7s로 120s 예선에서 충분하다. 범용 부품(T8 300mm, LM8UU, 봉) 합계 약 2만원이라 1인 4주 일정에 가장 안전하다.

2. **A21 배럴 캠 승강 (A01 대안/업그레이드)**
   체류 구간 덕분에 스텝 탈조가 생겨도 높이 오차가 0에 가깝고 1회전 0.5s로 빠르다. 출력 난도가 있지만 Bambu A1에서 세로 분할 출력하면 2~3회 반복으로 확보 가능하다. 시간이 남을 때만 시도한다.

3. **A22 플로팅 V 센터링 포크 (어떤 승강축과도 결합)**
   정렬 허용오차(가중치 20)를 좌우 ±10 → ±18로 늘리는 유일한 수동 기구다. 라인추종 횡오차 ±5~8을 여유 있게 흡수한다. 베이스가 고정되지 않았으므로 스프링력 0.2N 이하, U 바닥 리밋은 15gf급 마이크로스위치를 쓴다.

4. **A24 관람차형 180° 스윙**
   타팀의 "회전 시 CD 이탈"은 로봇 선회 때문이다. 포크가 앞→뒤로 넘어가면 로봇은 행 라인 위에서 직진·후진만 하면 되고, 라인센서를 차체 중앙에 두면 양방향 추종이 대칭이 된다. 다만 난이도가 4라서 2주차까지 A01이 완성됐을 때만 2차 후보로 둔다.

5. **A03 타미야 + T8 + 높이 스위치**
   스테퍼를 주행 보조나 다른 축(A24 회전 등)에 써야 할 때, 승강을 DC로 돌리고 슬롯을 아끼는 방안이다. T8의 셀프락 덕분에 DC 오버런이 ±1.5mm로 작고, 스위치 4개로 행 높이를 기계적으로 정의하므로 소프트웨어 실수에 강하다.

## 다른 관점과 결합 메모
- **A01 + A22 + "센서-포크 100mm 오프셋"**: 정지선 검출 순간이 곧 포크 정렬이 되고(리치 축 0개), 플로팅이 횡오차를 흡수한다. 모터 1개만 써서 나머지 2슬롯이 남는다. 추천 기본안.
- **A24/A25 ↔ 주행·경로 관점**: 선회 없이 왕복하는 경로 전략과 짝을 이룬다. 단, 라인센서가 1개뿐이므로 센서를 차체 중심(바퀴축 근처)에 두는 레이아웃과 반드시 함께 검토해야 한다.
- **A09/A19(리치 보정) ↔ 센서 관점**: IR이 Ø50 곡면을 측정하면 노이즈가 크다. 초음파는 근거리 하한(약 20mm) 문제가 있다. 정지선 기반 고정 오프셋이 더 신뢰성 있으므로 리치 축은 정지선 오차가 실측 ±8을 넘을 때만 쓴다.
- **A16 쐐기 조 ↔ 그리퍼/핸들링 관점**: "들기"를 Z 축에서 분리하면 승강축은 2위치(175/200)면 충분하므로 서보 토글(A23)과 리밋 1개로 단순화할 수 있다.
- **전기 관점 공통**: 스테퍼 상시 통전(홀딩)은 7.2V 팩을 소모하므로 리드스크류(셀프락)계는 이동 후 DRV8834 SLEEP으로 전류를 끊을 수 있다. 벨트·랙계(A02, A07)는 그러면 안 된다.
