jbj7667/wafer-transfer-robot/docs/arena/B_effector.md

# B — 엔드이펙터·웨이퍼 핸들링 관점 브레인스토밍

## 전제 치수 (모든 아이디어 공통)
- CD Ø120×1.2, 중심홀 Ø15, 16g(0.157N). 베이스 상단 Ø50 위에 얹힘 → **CD 반경 25~60mm 링(돌출부)의 아랫면은 비어 있음**. 접근 방향(행 라인)에서 보면 CD 아래 빈 공간은 z=100(하단 원기둥 윗면)~175/200.
- **2위치 승강 하나로 두 높이 모두 처리 가능**: 진입 높이 z=160(포크 윗면 166 < 175, 하단 원기둥 100보다 위), 들어올림 높이 z=215(200 베이스에서도 CD가 15mm 뜸). 같은 행 두 베이스는 높이가 같으므로 내려놓기도 같은 2위치(215→160)로 끝남. 높이 판별이 필요 없음. 스트로크 55mm.
- 표준 포크: 두 갈래 안쪽 간격 70(Ø50 원통 대비 횡 여유 ±10), 갈래 폭 12, 두께 6(PETG), 갈래 길이 150. y=±35~47 위치의 CD 현은 반길이 37~46mm라 CD 받침 길이가 충분.
- 정지선은 베이스 중심 100mm 앞이고, 하단 원기둥(R50) 앞면까지는 50mm 남음. 포크 끝은 라인센서 기준 약 +140mm(베이스 중심 +40)까지 나가야 함. 몸체가 z<100 높이에서 50mm 이상 앞으로 나가면 하단 원기둥과 부딪침.
- 180° 제자리 회전 시 CD가 회전중심에서 150mm 떨어져 있고 ω≈3rad/s이면 원심가속도 ≈1.35m/s²(0.14g). PLA–CD 마찰계수 μ≈0.2~0.3이므로 **평판 위에 올려만 두면 미끄러질 수 있는 경계값**. 포켓/구속이 필요함.

## 아이디어 표

| ID | 이름 | 핵심 원리(1~2문장) | 동작모터(종류×개수) | 175/200 대응 | 시작 250³ 충족 방법 | 원점잡기(초기화) | 정렬 허용오차 추정(mm) | 사이클시간 영향 | 제작난이도 1~5 | 주요 리스크 |
|---|---|---|---|---|---|---|---|---|---|---|
| B01 | 기본 U포크 + TPU 고마찰 패드 | 평평한 U포크 갈래 위에 TPU 패드(5×30mm, 갈래당 2개)를 붙여 μ를 0.6 이상으로 올림. 160에서 진입하고 215로 들어올려 마찰만으로 붙잡음 | 스테퍼+리드스크류(승강)×1 | 2위치 고정(160/215)으로 판별 없이 대응 | 포크가 몸체 앞 140mm 고정 돌출, 전장 ≤245 | 승강 하단 리밋SW로 원점 | 횡 ±10, 종 ±20 | 기준값(픽·플레이스 각 약 2s) | 1 | 급회전·충돌 충격 시 CD가 미끄러짐. 패드 오염 |
| B02 | 원추 시트 포크(자기중심) | 갈래 윗면을 안쪽으로 8° 기울이고, 갈래 끝 기둥 + 뿌리 쪽 R61 호형 벽으로 얕은 원추 시트를 만듦. 들어올릴 때 CD가 중력으로 미끄러져 포크 중심에 앉음 | 스테퍼×1(승강) | 2위치 고정 | B01과 동일 | 하단 리밋SW | 횡 ±10(갈래 간격), CD 중심 정렬은 ±1로 수렴 | 영향 없음 | 2 | 경사면 PLA 마찰이 크면 끝까지 안 미끄러짐 → 표면 연마 또는 PETG 필요 |
| B03 | C-링 림 포켓 패들 | 안지름 Ø123·깊이 3mm 원형 포켓을 둔 C자 링. 앞쪽 개구 70mm로 Ø50 원통을 지나감. 개구(70)가 CD(Ø120)보다 좁아서 들어올린 뒤에는 수평 어느 방향으로도 빠지지 않음 | 스테퍼×1 | 2위치 고정. 포켓 림 3mm가 진입 시 CD 아래 9mm 여유 안에 들어감 | 링 외경 Ø131을 몸체 앞에 배치, 전장 ≤250 맞춤 | 하단 리밋SW | 횡 ±10, 종 ±12(링이 CD 바깥으로 감싸야 하므로 종방향은 더 엄격) | 영향 없음. 회전 중 감속 불필요 → 단축 | 2 | 종방향 오차가 크면 림이 CD 테두리 밑을 들어올려 CD가 기울어짐. 림을 2mm로 낮추고 모따기 |
| B04 | 상사점 캠 연동 클램프 | 캐리지에 피벗 핑거 2개를 달고, 마스트 상단 고정 캠 램프에 롤러가 닿으면 핑거가 CD 윗면(r=50)을 TPU 팁으로 누름. 승강 축 하나로 클램프까지 함 | 스테퍼×1 | 2위치 고정. 클램프는 상단 위치에서만 동작 | 핑거는 접힌 상태로 보관, 높이 ≤230 | 하단 리밋SW(상단은 스텝 수) | 횡 ±10, 종 ±20 | 영향 없음(추가 모터 없음) | 3 | 캠 타이밍과 스텝 누락. 클램프 힘 조절(TPU 팁 두께 3mm로 순응) |
| B05 | 고정 천장 샌드위치 | 몸체에서 뻗은 천장 판(z=217, 아랫면 TPU 돌기 3개)과 포크 사이에 CD를 0.5mm 압입해 끼움. 승강 상한이 곧 클램프 | 스테퍼×1 | 상한 위치 하나에 클램프가 묶여 두 높이 모두 동일 | 천장 판이 몸체 위 ≤240 | 하단 리밋SW + 상단 스텝 카운트 | 횡 ±10, 종 ±20 | 영향 없음 | 2 | 리드 오차로 과압입 시 스텝 누락 → TPU 돌기가 완충. 200 베이스 진입 시 천장–CD 간격이 16mm뿐 |
| B06 | 천장 원추핀 홀 인덱싱 | B02로 중심을 맞춘 뒤 천장에 고정한 원추핀(밑 Ø14, 끝 Ø4, 길이 12)이 들어올린 CD 중심홀(Ø15)에 꽂힘. 수평 방향으로 완전히 구속 | 스테퍼×1 | 2위치 고정 | 핀이 천장 판 일체형, ≤240 | 하단 리밋SW | 홀 포획 ±5.5(포크 위 CD 기준). 베이스 오차는 B02가 흡수 | 영향 없음 | 2 | B02 자기중심이 실패하면 핀이 CD 면을 눌러 휨/이탈 |
| B07 | 틸트백 포크 | 상단 위치에서 캐리지 롤러가 램프를 타면 포크가 뒤로 8° 기울어 CD가 뿌리 쪽 R61 벽에 기댐(중력 구속). 내려가면 수평으로 복귀 | 스테퍼×1 | 2위치 고정. 틸트는 상단에서만 | 포크 수평 상태 기준 ≤250 | 하단 리밋SW | 횡 ±10, 종 ±20 | 영향 없음 | 3 | 앞으로 가속할 때는 구속이 약함. 피벗 유격 |
| B08 | 끝단 스토퍼 + 후방 푸셔 수평 클램프 | 갈래 끝에 높이 6mm 스토퍼를 두고, 들어올린 뒤 서보가 뿌리 쪽 푸셔(TPU)를 앞으로 밀어 CD를 앞뒤로 물림 | 스테퍼×1 + RC서보×1 | 2위치 고정 | 스토퍼는 진입 높이 160+6+6=172 < 175로 통과 | 승강 리밋SW(서보는 원점 불필요) | 횡 ±10, 종 ±15 | 서보 개폐 +0.4s×2 | 2 | 모터 예산 2개 소모. 175 베이스에서 스토퍼 여유가 3mm로 빠듯 |
| B09 | 플로팅 순응 포크(RCC형) | 포크 베이스를 횡방향 ±10mm로 뜨게 하고(PETG 판스프링 2장) 갈래 안쪽 끝에 Ø8 베어링 롤러를 둠. Ø50 원통에 닿으면 베이스를 밀지 않고 포크가 비켜남. 다 들어올리면 V블록이 다시 중앙에 고정 | 스테퍼×1 | 2위치 고정 | 플로팅 범위 안이라 영향 없음 | 하단 리밋SW, 상단 V블록 진입으로 기계적 중앙 복귀 | 횡 ±18(70간격 ±10 + 플로팅 ±8), 종 ±20 | 영향 없음 | 3 | 판스프링 피로·처짐. 플로팅으로 CD 위치가 흔들리면 플레이스 정확도 저하 → 상단 V락 필수 |
| B10 | R축 신축 패들 + IR 거리 보정 | 산업용 R-θ 웨이퍼 로봇처럼 패들을 랙/슬라이드로 0~110mm 뻗음. GP2Y0A41로 Ø50 원통(z≈150)까지 거리를 재서 뻗는 양을 정함 | 스테퍼(승강)×1 + 타미야 기어박스 또는 스테퍼(신축)×1 | 2위치 고정 | 접힌 상태 전장 ≤230 | 승강·신축 각각 리밋SW(축 2개 원점 → 초기화 가점에 유리) | 횡 ±10, 종 ±3(IR 보정) | 신축 +1s×2. 정지선 오차가 상쇄돼 재시도가 줄어듦 | 4 | 모터 2개. 뻗었을 때 캔틸레버 처짐 |
| B11 | 측면 V홈 엣지 그립 조 | 몸체 양옆에서 뻗은 두 암 끝의 V홈 조(홈 깊이 4, 입구 6)가 y=±60 CD 테두리를 옆에서 물어 중심과 높이를 함께 맞춤(엣지 그립 웨이퍼 엔드이펙터 방식) | 스테퍼(승강)×1 + RC서보(개폐)×1 | 정밀 2위치 필요(z=175.6/200.6 ±2) | 암을 접어 폭 ≤250. 펼친 폭 약 150 | 승강 리밋SW | 횡 ±8(조 개방폭), 높이 ±2 | 개폐 +0.5s×2 | 3 | 높이 정밀도 요구. 조가 닫힐 때 CD를 끌어 베이스를 흔듦 |
| B12 | 서랍식 후크 인출 트레이 | 트레이 윗면을 베이스 윗면과 같은 높이로 맞추고, 후크 슬라이더가 CD 먼 쪽 테두리를 걸어 트레이 위로 당김. 플레이스는 반대로 밀어냄 | 스테퍼(승강)×1 + 스테퍼 또는 기어박스(후크)×1 | 정밀 2위치(트레이 면 = 175/200 ±1) | 후크 접힘, 전장 ≤250 | 승강·후크 리밋SW | 횡 ±15(후크 폭 30), 종 ±10 | 당기기·밀기 각 1.5s | 4 | 플레이스 위치를 스텝 수로만 정함 → CD 중심 오차. 당길 때 베이스가 끌려옴 |
| B13 | 수동 흡착컵 + 서보 해제 | Ø30 실리콘 흡착컵을 중력 하강 헤드로 CD 윗면(r=40 링)에 눌러 밀착시킨 뒤 들어올림. 놓을 때는 서보가 컵 립의 탭을 당겨 진공을 깸 | 스테퍼(승강)×1 + RC서보×1 | 접촉 감지 하강(B23)이라 높이 무관 | 헤드 상단 보관 ≤245 | 승강 상단 리밋SW | 횡 ±15(컵이 r=25~55 링 위에만 닿으면 됨), 종 ±15 | 하강 접촉 대기 +1s | 3 | 라벨면 요철·먼지로 밀착 실패. 누름력 약 5N이 베이스를 기울일 수 있음 |
| B14 | RE-260 블로워 진공 후드 | Ø126 후드를 CD 위 2mm까지 내리고 RE-260 직결 원심팬(Ø50 출력 임펠러)으로 흡입. 16g을 들려면 14Pa면 되므로 3배 여유로 50Pa 목표. 후드 안 스탠드오프 3개에 CD가 붙음 | 타미야 RE-260(팬)×1 + 스테퍼(승강)×1 | 접촉 감지 하강이라 높이 무관 | 후드 Ø126, 높이 ≤240 | 승강 리밋SW | 횡 ±20(후드가 넓음), 종 ±20 | 팬 기동 0.5s | 3 | 모터 노이즈로 Mega 리셋(커패시터·분리전원 필수). 후드 틈새 누설이 크면 실패. 소음 |
| B15 | 3지 엣지 그리퍼(스크롤 링) | 위에서 내린 3개 핑거(120° 간격)를 서보가 스크롤 링으로 동시에 닫아, 끝 립 2mm가 CD 테두리 아래(r=58)로 들어가 받침 | 스테퍼×1 + RC서보×1 | 핑거 끝이 CD 아래 2mm까지 내려가야 함 → 접촉 감지 하강 + 오프셋 | 개방 지름 Ø150, 높이 ≤240 | 승강 리밋SW | 횡 ±12, 종 ±12(개방 Ø150 기준) | 개폐 +0.5s×2 | 4 | 스크롤 링 출력 정밀도. 핑거 하나가 베이스 Ø50 원통 쪽으로 오면 간섭(r=58 > 25라 실제로는 여유 있음) |
| B16 | 스냅 핑거 + 볼펜식 푸시-푸시 토글 | PETG 탄성 핑거 4개가 경사면으로 CD 테두리에 눌려 벌어졌다가 아래로 스냅됨(픽). 다음 누름에서는 볼펜형 인덱스 캠이 해제 링을 내려 핑거를 벌림(플레이스). 모터는 승강 1개뿐 | 스테퍼×1 | 하강해 누르기만 하면 되므로 높이 무관(오버스트로크 5mm 흡수 스프링) | 헤드 Ø140, 높이 ≤240 | 승강 리밋SW, 토글 상태는 SW 1개로 판독 | 횡 ±8, 종 ±8 | 누르기 동작만 있어 빠름 | 5 | 토글 상태 꼬임(감지 SW로 보완). 스냅력이 CD를 휘게 함. 출력 공차 민감 |
| B17 | 깔때기 스커트 + 중심홀 확장 콜렛 | 내림 원추 스커트(입구 Ø150→목 Ø123)가 CD를 베이스 위에서 밀어 동심으로 맞추고, 이어 중앙 3분할 콜렛(Ø14→Ø15.6)이 홀 안에서 벌어져 1.2mm 두께 테두리를 잡음(CD 드라이브 클램프 방식) | 스테퍼×1 + RC서보(콜렛 콘)×1 | 접촉 감지 하강이라 높이 무관 | 스커트 Ø150, 높이 ≤240 | 승강 리밋SW | 횡 ±15(스커트 포획) | 스커트 정렬 +0.5s | 4 | 1.2mm 테두리 마찰로 잡는 힘이 작음. 스커트가 CD를 밀다 Ø50 끝을 넘으면 낙하 |
| B18 | 베르누이 비접촉 패드 | RE-260 블로워의 양압 공기를 Ø80 패드 중앙에서 방사상으로 흘려 저압을 만들고, CD를 0.3mm 띄운 채 흡인. 가장자리 핀 3개로 수평 구속 | 타미야 RE-260×1 + 스테퍼×1 | 접근 거리만 맞추면 높이 무관(흡인 범위 약 3mm, 접촉 감지 하강 병용) | 패드 Ø130, ≤240 | 승강 리밋SW | 횡 ±20 | 기동 0.5s | 4 | 풍량 부족(RE-260 팬 정압 한계). 기류에 CD가 회전·진동. 노이즈 |
| B19 | 돌출 링 IR 하향 판별 포크 | GP2Y0A41를 포크 위 z≈260(출발 후 펼침)에 두고, 베이스 중심 +45mm(CD 돌출 링) 지점을 비스듬히 내려다봄. CD가 있으면 약 60mm, 없으면 빔이 하단 원기둥 윗면(z=100)이나 바닥까지 가서 135mm 이상 → 큰 차이로 확실히 판별. 픽 전에 본선 좌/우를 확인 | 스테퍼×1(포크) + 센서 | 175/200 모두 차이 ≥75mm | 센서 마스트는 접이식 또는 높이 ≤250 내에 각도로 배치 | 하단 리밋SW | 판별 지점 ±15 허용(돌출 링 r=30~60 안) | 판별 0.1s. 빈 쪽이면 행 반대편으로 이동 | 2 | IR이 CD 반사면(은색·라벨)에서 값이 튐 → 각도 30°로 경면 반사 회피, 5회 중앙값 |
| B20 | 레버 증폭 탐촉 픽 | 포켓 바닥에 3:1 레버를 달아 16g을 0.47N으로 키운 뒤 저하중 마이크로SW(0.15~0.3N)를 누름. 들어올리기 10mm 후 SW로 유무를 판정하고, 없으면 내려서 반대편으로 | 스테퍼×1 | 2위치 고정 | 포켓 내장 | 하단 리밋SW | 레버 접촉판 30×20이라 CD 위치 ±12 | 빈 쪽 판정에 +1.5s | 2 | 진동으로 SW 채터링(디바운스 50ms). 레버 마찰 |
| B21 | 범퍼 V노치 거리 기준 SW | 몸체 앞 z≈60에 V노치 범퍼(90°)와 저하중 리밋SW를 달아 하단 원기둥(Ø100)에 살짝 닿는 순간 정지. 정지선 대신 베이스 자체를 종방향 기준으로 씀 | 없음(SW만) | 무관 | 범퍼 돌출 15mm | 해당 없음 | 종 ±2. V노치가 횡 오차를 좌/우 SW 차이로 보여줌(±10 표시) | 저속 접근 +0.5s | 2 | 베이스가 고정되지 않음 → 접촉력 0.3N 이하 + 저속 필수. 밀리면 위치 누적 오차 |
| B22 | 평행링크 리트랙트 패들 | 길이 100 평행 4절 링크(링크 수평 = 픽 위치) 끝에 B03 포켓 패들을 달고, 위로 회전시키면 승강과 몸체 중앙 회수가 한 축으로 이루어짐. 회전 시 CD가 회전중심(r≈30) 근처에 있어 원심 ≈0.03g | 스테퍼(+감속 벨트 3:1)×1 | 링크 각 7°/18°에서 접촉, 23°(+50mm)에서 들림 완료. 2위치 각도 고정 | 링크를 접으면 ≤240 | 각도 리밋SW | 횡 ±10, 종 ±15(들림 중 수평으로 10mm 끌림 포함) | 회전을 빠르게 해도 됨 → 왕복당 -1~2s | 3 | 링크 핀 유격이 끝단에서 증폭. 회수 위치 CD 높이 약 260 → 무게중심 상승 |
| B23 | 중력 플로팅 헤드 + 접촉 SW(높이 자동) | 상부형 이펙터(B13~B18)용. 헤드가 가이드봉 2개 위에 자중으로 매달려 있다가 CD에 닿으면 3mm 떠오르며 SW를 누름 → 그 높이를 저장하고, 플레이스 때는 그 높이 −1mm로 내림 | 스테퍼×1(승강) | 측정 기반이라 어느 높이든 대응 | 헤드 높이 포함 ≤245 | 상단 리밋SW + 접촉 SW 2단 | 높이 ±1(측정) | 하강 탐색 +0.8s | 2 | 가이드봉 걸림. CD가 없으면 Ø50 윗면에 닿음 → 높이 차 1.2mm로는 유무 판별 불가(B19 병용) |
| B24 | 슬롯로딩 롤러(카오디오 방식) | 트레이 입구의 TPU 롤러 2개(위·아래 Ø20)가 CD 테두리를 물고 회전해 트레이 안으로 빨아들이고, 역회전으로 내보냄. 다 들어왔는지는 안쪽 SW로 확인 | 타미야 기어박스(롤러)×1 + 스테퍼(승강)×1 | 롤러 닙 높이를 175.6/200.6 ±1.5에 맞춰야 함 | 트레이 130×130, 전장 ≤250 | 승강 리밋SW + 장입 SW | 횡 ±15, 높이 ±1.5 | 장입·배출 각 1.2s | 4 | 롤러가 CD를 무는 동안 베이스를 끌어당김. 배출 정지 위치가 롤러 미끄럼에 좌우 |
| B25 | 부유 웨이트 캡 | 포크 위에 Ø126 링 캡(PETG 20g, 안쪽 립 높이 2mm)을 고정 페그 위에 얹어둠. 들어올린 CD가 캡을 페그에서 띄우면 캡 무게가 CD를 누르고 립이 수평 이탈을 막음. 내리면 캡이 페그로 돌아감. 모터·캠·SW 없음 | 스테퍼×1(승강만) | 2위치 고정. 캡이 들리는 행정 5mm는 상단 여유 안 | 캡은 포크 위 ≤230 | 하단 리밋SW | 횡 ±10, 종 ±20 | 영향 없음 | 2 | 페그–캡 가이드가 걸리면 캡이 기울어 CD를 한쪽으로 누름. 캡 무게와 원심력 마진은 시험 필요 |

## 내 관점 상위 5개
1. **B03 C-링 림 포켓 패들**: 개구 70 < CD Ø120이라는 기하만으로 수평 이탈을 원천 차단해 회전 중 CD 이탈(타 팀 빈발 문제)을 해결함. 부품은 출력물 하나뿐이고 모터도 승강 1개라 1인 제작에 가장 단순한 고신뢰 구조.
2. **B02 원추 시트(자기중심)**: B03과 같은 부품에 8° 경사만 추가하면 픽할 때 생긴 ±10mm 오차가 포크 위에서 ±1로 정렬됨. 플레이스할 때 CD가 베이스 중심에 오도록 하는 열쇠이고, B06 홀 인덱싱으로 확장도 가능.
3. **B25 부유 웨이트 캡**: 모터·센서·타이밍 없이 수직 구속(점프·진동 대비)까지 더함. B03/B02 포켓과 겹쳐 쓰면 "수평은 기하, 수직은 중력"으로 구속이 완성되고, 실패 모드가 거의 기계적 걸림 하나뿐.
4. **B09 플로팅 순응 포크**: 라인추종 횡오차 ±8에 갈래 여유 ±10은 빠듯하고, 베이스가 고정돼 있지 않아 닿으면 바로 실패함. 롤러와 플로팅으로 "닿아도 밀지 않게" 만들어 정렬 허용오차 점수(20)를 직접 끌어올림.
5. **B19 돌출 링 IR 하향 판별**: 본선에서 좌/우 무작위를 센서로 판단해야 하는데, CD 돌출 링 아래는 75mm 이상 비어 있어 IR 거리값 차이가 크고 확실함. 포크 동작 없이 0.1초에 판단하므로 B20 탐촉보다 빠르고 기계적 리스크도 없음.

## 다른 관점과 결합 메모
- **2위치 승강(160/215) 원칙은 구동 관점(A 등)과 꼭 공유할 것**: 높이 판별이 필요 없으므로 리드스크류든 크랭크든 상·하 리밋SW 2개로 충분하고, 하단 리밋이 그대로 "센서 기반 자체 초기화" 가점 근거가 됨.
- B22 평행링크는 구동 관점의 "평행 링크"와 같은 하드웨어지만, 이펙터 쪽 이점(회전 시 CD를 회전중심으로 회수해 원심 0.14g → 0.03g)을 근거로 채택 여부를 판단할 것.
- 상부형(B13~B18, B23)은 B23 접촉 하강을 반드시 함께 써야 하고, 높이차 1.2mm로는 CD 유무를 판별할 수 없음 → 센서 관점의 B19류 IR 판별을 함께 써야 함.
- RE-260 팬 계열(B14, B18)은 전장/노이즈 관점과 결합 필요: 모터 전원 분리, 0.1µF 3개 + 100µF, 페라이트. 이미 보고된 Mega 리셋 문제를 키울 수 있음.
- 다중 적재(스택)는 검토 결과 경로상 이득이 없음(행별 "한쪽 픽 → 직진 횡단 → 플레이스"와 "왼쪽 3장 모두 픽 → 오른쪽 3장 모두 플레이스"의 주행 거리가 같고, 회전 횟수만 늘어남). 그래서 표에서 뺐음. 경로 관점에서 다른 동선을 쓸 때만 재검토.
- B21 범퍼 기준은 주행 관점의 정지선 ±5 가정을 ±2로 줄일 수 있지만, 베이스가 밀리는 리스크 때문에 접촉력 0.3N 이하 저속 접근 프로파일과 짝을 이뤄야 함.
