jbj7667/wafer-transfer-robot/docs/arena/BRIEF.md

# 아레나 브리프 — 웨이퍼 이송로봇 메커니즘 브레인스토밍

## 과제
동양미래대 2학년 창의과제 로봇대회. 1인 팀, 개발기간 약 4주(2026-10-26 ~ 11-24), 모든 구조물은 개인 Bambu Lab A1(256mm 베드, PLA/PETG/TPU)로 출력.
라인을 따라 주행하며 웨이퍼(CD Ø120×1.2mm, 무게 약 16g) 3장을 각 베이스에서 같은 행의 맞은편 베이스로 옮긴 뒤 출발·도착구역으로 돌아와 정지.

## 경기장 (자기 구역 1m×1m, 좌상단 원점, mm)
- 19mm 검은 라인. 중앙 세로 트렁크 x=500. 가로 행 3개: y=130(베이스 5,6 / 높이 175), y=305(3,4 / 200), y=480(1,2 / 200)
- 행마다 좌우 끝에 정지선(폭19 길이100, 행 라인과 수직, T자) — 베이스 중심에서 100mm 앞. 베이스 중심 간 거리 740/640/540
- 베이스(바닥에 고정 안 됨, 밀면 움직임): 하단 원기둥 Ø100×100, 그 위 상단 원기둥 Ø50, 높이 100(총 200) 또는 75(총 175). 윗면 평면(핀 없음). CD는 Ø50 윗면에 그냥 얹혀 있고, 양쪽으로 35mm씩 돌출
- **같은 행의 두 베이스는 높이가 같다**
- 출발·도착: 트렁크 아래쪽 R100 곡선 → 좌측 x=130 의 T자 끝선. 몸체가 그 100mm 수직선을 일부라도 덮고 정지해야 도착 인정
- 펜스 없음. 상대 구역 침범 금지
- 예선 120s: CD는 왼쪽 베이스(1,3,5)에 → 오른쪽(2,4,6)으로. 본선 150s, 1:1: 행마다 좌/우 중 무작위 1곳에 CD → 반대편으로. 위치를 사람이 입력하면 안 됨(센서로 판단)

## 하드 제약 (하나라도 어기면 탈락)
1. 출발 전 크기 250×250×250mm 이내(출발 후 변형 가능)
2. 주행: 지급 DC 기어드모터 2개(Ø37, 3-M3 PCD31, 6mm D축, 감속비 미상 · 12V 정격, 실제 7.2V NiMH + L298 → 약 5V)
3. 동작용 모터: 타미야 6단 기어박스 H.E.(#72005, RE-260, 1개 지급·추가 가능), 스테퍼 SF2421(42각 1.8°, ~1A, DRV8834), RC서보(사비) **합산 최대 3개**
4. 센서는 지급품만: 3채널 디지털 라인센서 1개(전체 1개만), IR 거리 GP2Y0A41SK(40~300mm) 최대 3, 초음파 HC-SR04 최대 3. 스위치류(리밋·푸시)는 자유
5. 제어: Arduino Mega 2560 하나. 전원 AA×6 팩 2개(제어 9V, 모터 7.2V)
6. 추가점수 '전원 On 자체 초기화'는 **센서로 초기상태를 설정**해야 인정(예: 리밋 스위치로 축 원점 잡기). RC서보 단순 구동이나 초기화가 필요 없는 구조는 불인정 → 메커니즘에 원점 잡을 축이 있으면 유리
7. 사비 부품 12만원 이내(필라멘트 포함). 기성 기어·랙·바퀴·베어링·볼트·리드스크류 등 범용부품 구매 가능

## 평가 기준 (가중치)
신뢰성 30 / 정렬 허용오차(라인추종 횡오차 ±5~8mm, 정지선 검출 ±5mm 가정) 20 / 1인 제작 난이도 20 / 사이클 시간 15 / 무게·부피(동점 기준) 5 / 비용 5 / 디자인·창의성 5

## 타 팀 관찰 (참고)
지게차형 U자 포크 + 타미야 랙피니언 승강이 가장 흔함 → 랙 강성 부족·진동 유격 문제. 스테퍼+리드스크류 팀도 있음. 회전 시 CD 이탈, IR 센서 불안정, 모터 노이즈로 Mega 리셋, 베이스 충돌. 7주차까지 완주 보고 팀 없음. 상부 회전 포탑(작년 팀 베어링 틀어짐), 관통형 컨베이어, 틸트 포크, 크랭크 서보, 평행 링크 등이 제안됨.

## 출력 형식 (반드시 지킬 것)
Markdown 파일 하나. 아이디어 25개, 각 아이디어는 표 한 행:
| ID | 이름 | 핵심 원리(1~2문장) | 동작모터(종류×개수) | 175/200 대응 | 시작 250³ 충족 방법 | 원점잡기(초기화) | 정렬 허용오차 추정(mm) | 사이클시간 영향 | 제작난이도 1~5 | 주요 리스크 |
표 아래에 "내 관점 상위 5개"와 이유(각 2~3줄), 그리고 다른 관점과 결합하면 좋을 아이디어 메모.
ID 접두어는 지시받은 것을 쓴다. 실현 불가능한 아이디어는 쓰지 말고, 서로 실질적으로 다른 아이디어를 낼 것(색만 바꾼 변형 금지).
