jbj7667/wafer-transfer-robot/docs/arena/D_redteam.md

# 브레인스토머 D — 레드팀·비주류·고장모드 기반 아이디어 25선

> 렌즈: "무엇이 고장나는가"에서 출발한다. 정렬 어긋남, 밀리는 베이스, CD 미끄러짐·낙하, 진동 유격, 센서 노이즈, 브라운아웃, 타이밍 초과. 이런 고장을 **구조로 흡수하는**(소프트웨어 보정에 기대지 않는) 메커니즘을 우선한다.
> 기하 전제(브리프에서 유도): 넥 Ø50(r=25), CD Ø120(r=60), 하부원기둥 Ø100(r=50) 상면 높이 100(모든 베이스 공통). CD 아래 빈 공간은 높이 100~175/200, 반경 25~60. 정지선은 베이스 중심에서 100mm 앞이므로 하부원기둥 면은 정지선에서 **50mm 앞**에 있다.
> 핵심 계산: 포크 내폭을 G라 하면 넥을 피하는 조건은 G/2 − |e| > 25, CD를 양쪽에서 받치는 조건은 G/2 + |e| < 약 55(CD 테두리 5mm 여유)이다. **G=54이면 횡오차 허용 ±2mm, G=80이면 ±15mm다.** 이 숫자가 아래 여러 아이디어의 출발점이다.

| ID | 이름 | 핵심 원리(1~2문장) | 동작모터(종류×개수) | 175/200 대응 | 시작 250³ 충족 방법 | 원점잡기(초기화) | 정렬 허용오차 추정(mm) | 사이클시간 영향 | 제작난이도 1~5 | 주요 리스크 |
|---|---|---|---|---|---|---|---|---|---|---|
| D01 | 와이드갭 U포크 + 편심캠 리프트 | 포크 내폭을 80mm로 벌려 r=40 선 두 줄로 CD를 받친다. 타미야 기어박스로 돌리는 편심캠(행정 50mm)이 포크 캐리지를 들어 올린다. 캠 사점(上·下)에서 모터 부하가 0이라 정지 위치가 전압 변동에 둔감하다 | 타미야×1 | 포크 높이 160에서 시작해 210까지 올리면 두 높이를 같은 동작으로 처리(160은 175·200 베이스 모두에서 CD 아래이고 넥 노출 구간 안) | 포크 길이 110 정도이므로 차체 안에 들어감 | 캠축 플래그와 리밋 스위치로 下사점 검출(센서 기반 초기화 인정) | 횡 ±15 / 깊이 ±20 | 캠 반 바퀴에 약 1.5~2s | 2 | 캠 팔로워 마모, 반 바퀴 회전 중 정전되면 위치를 잃음(재부팅 시 홈잡기로 복구) |
| D02 | 하부원기둥 V퍼넬 자가정렬 | 차체 앞 높이 30~90mm에 120° V자 가이드(끝단 PTFE 테이프)를 단다. 접근할 때 Ø100 하부원기둥이 V 홈 중심으로 미끄러져 들어와 베이스가 포크 축에 저절로 맞춰진다. 무게중심이 낮은 곳을 밀기 때문에 넘어지지 않는다 | 0(수동) + 리프트용 1 | 무관(하부원기둥 기준) | V 깊이 40mm, 차체 안 | 해당 없음 | 횡 ±25(V 입구 폭 기준) | 0s(정렬 재시도가 사라짐) | 1 | 베이스가 밀리면서 CD가 미끄러질 수 있음(가속도 2.9m/s² 이하면 안전). 베이스 바닥 마찰이 크면 로봇이 대신 요잉함 |
| D03 | 웜 셀프로킹 평행4절 리프트 | 웜기어(구매 5천원 이하)로 평행링크 크랭크를 돌린다. 웜은 역구동이 안 되므로 주행 진동이나 전원 차단에도 포크가 처지지 않고, 평행링크라 포크는 수평을 유지한다 | 타미야×1(웜 추가) | 링크 각도 2단(리밋 2개) | 링크를 접으면 높이 약 140 | 링크 하단 리밋 | 횡 ±12 / 높이 ±2 | 1회 승강 2~3s | 3 | 링크 핀 유격이 포크 끝에서 3~4배로 증폭됨 → M3 볼트와 황동 부싱 필수 |
| D04 | 스테퍼 + T8 리드스크류 수직축(기준안) | Ø8 로드 2개, LM8UU, 안티백래시 너트를 쓴다. 리드 2mm(Tr8x2, 1줄)를 쓰면 1스텝(1.8°)당 0.01mm로 높이를 마음대로 정할 수 있고 셀프로킹이 된다 | 스테퍼×1 | 행 번호로 목표 높이 설정 | 300mm 스크류는 초과하므로 200mm 스크류를 써야 함 | 하단 리밋 + 매 CD마다 재홈잡기 | 높이 ±0.5 | 50mm 승강에 약 2.5s(2000스텝/s, 반스텝이면 더 느림) | 3 | 탈조해도 감지가 안 됨 → 매 사이클 재홈잡기로 완화. DRV8834 1.5A 한계와 발열 |
| D05 | 제네바 기구 180° 포탑 | 연속 회전하는 타미야 출력으로 2슬롯 제네바를 돌리면 0°/180°에서 기계적으로 잠긴다. 위치 정확도가 모터 정지 타이밍과 무관해진다 | 타미야×1(포탑) + 리프트 1 | 리프트가 담당 | 포탑 Ø200 이하 | 제네바 휠 슬롯과 리밋 | 회전 각도 ±0.5° (포크 끝 r=150에서 ±1.3mm) | 180° 회전 1.5s, 차체 스핀 불필요 | 4 | 대형 베어링 틀어짐(작년 사례) → 회전부에 6806 박형 베어링이나 3점 롤러 지지 |
| D06 | 무포탑 트렁크 교차점 스핀 + 립 리테이너 | 포탑을 없앤다. 픽업 후 후진해 트렁크 교차점(x=500, 십자 교차)으로 와서 180° 스핀하고, 교차선으로 라인을 다시 잡는다. CD는 포크 둘레 3면의 8mm 높이 립과 뒤쪽 스톱으로 가둔다 | 리프트 1 | 리프트가 담당 | 해당 없음 | 리프트만 | 횡 ±15(D01 포크와 조합) | 스핀 약 2s | 1 | 각가속도 19rad/s²를 넘으면 CD가 미끄러짐 → 0.3s 램프 필수. 후진할 때 라인을 따르기 어려움(짧은 270~370mm 구간만 후진) |
| D07 | 양단 개방 관통 레일(무회전 왕복) | 포크를 차체 전장을 관통하는 레일 2줄(내폭 80)로 만든다. 넥이 앞뒤 어느 쪽으로든 들어올 수 있어, 왼쪽 베이스에서 집은 뒤 후진만으로 오른쪽 베이스에 내려놓는다 | 리프트 1 | 리프트가 담당 | 레일 길이 = 차체 길이 240 | 리프트만 | 횡 ±15, 후진 구간 ±8 이상 악화 | 회전 0 → 행당 2~3s 절감 | 3 | 단일 라인센서가 후진 중 뒤에 끌려가는 위치라 추종이 불안정함 → 저속, 낮은 이득, 엔코더 보조 필요. 레일이 넥을 지나는 순간 하부원기둥과 간섭 |
| D08 | 후방 5° 경사 포크(중력 시팅) | 포크면을 뒤로 5° 기울여 실은 CD가 항상 뒤쪽 스톱벽에 붙어 있게 한다. 진동이나 회전 중에도 CD 위치가 기계적으로 하나로 정해진다(sin5°·g = 0.85m/s²의 복원 가속도) | 리프트 1 | 리프트가 담당 | 해당 없음 | 리프트만 | 횡 ±15 / 내려놓기 위치 오차 ±3 | 0s | 1 | 내려놓을 때 CD가 뒤쪽부터 닿으며 살짝 끌림. 베이스를 밀지 않도록 포크를 1~2mm 더 내린 뒤 빼야 함 |
| D09 | 원뿔 핀 + TPU 콜릿 홀 그리퍼 | 위에서 원뿔 핀(끝 Ø5 → Ø14)을 CD 중심 구멍 Ø15에 넣는다. 16g짜리 CD가 스스로 미끄러지며 중심이 맞는다. 서보가 당기는 줄로 TPU 콜릿을 벌려 구멍 안벽을 문다 | 서보×1 + 리프트 1 | 하강량을 접촉 스위치로 정지 | 암을 접어서 시작 | 리프트 리밋 | ±5(원뿔이 흡수하는 범위) | 하강·물기 3s | 4 | 오버행 암 길이 100mm 이상, 처짐, 구멍 위치를 볼 센서가 없음 |
| D10 | 위에서 잡는 3지 림 그리퍼(캠 링) | 회전 캠 링 하나로 손가락 3개(끝에 V홈)를 동시에 오므려 CD 테두리 Ø120을 잡는다. V홈이 높이 오차를 흡수한다 | 서보×1 + 리프트 1 | 하강 접촉으로 정지 | 손가락을 접은 상태로 Ø160 | 캠 링 리밋 | ±10(손가락 벌림 Ø140) | 3~4s | 4 | 오버행이 길어 부피가 커짐. 손가락이 베이스 넥 위 공간과 간섭 |
| D11 | 서보 주사기 진공 흡착 | 펌프 모터는 규정 밖이므로, RC서보가 60ml 주사기 플런저를 당겨 Ø30 흡착컵에 진공을 만든다. CD 윗면 어디든(r 10~55) 붙으면 들 수 있다 | 서보×1 + 리프트 1 | 컵이 스프링 컴플라이언스로 25mm 흡수, 행별 목표 높이 | 주사기를 눕혀 배치 | 리프트 리밋 + 플런저 리밋 | ±35(흡착 가능 면적이 넓음) | 흡착·해제 각 1s | 3 | 누설(라벨 면 요철), 해제가 늦으면 CD가 따라 올라옴 → 플런저 복귀와 리크 구멍. 사전 리크 테스트 필요 |
| D12 | 스윕 패들 + 하단 트레이 | 수평 회전 패들(CD 높이)이 CD를 넥 윗면에서 쓸어 3~5mm 아래 트레이로 떨어뜨린다. 픽업 높이 정밀도는 ±5면 된다 | 타미야×1(패들) + 리프트 1 | 트레이 높이를 행별로 다르게 | 패들을 접음 | 패들 홈 리밋 | 횡 ±25 | 2s | 3 | 놓을 때는 반대로 밀어 넣어야 하는데, CD 중심이 넥 위에 와야 해서 밀어내는 거리를 정밀하게 맞춰야 함. CD가 뒤집히거나 튈 위험 |
| D13 | TPU 플렉서 범퍼 접촉 정지 | 포크 U 바닥에 TPU 판스프링(행정 6mm)과 저작동력(0.15N) 마이크로스위치를 붙인다. 넥에 닿는 순간 정지하므로 깊이가 라인 정지선 검출 오차와 무관해진다 | 0 | 무관 | 해당 없음 | 해당 없음 | 깊이 ±1~2 | 정지선 이후 저속 접근 0.5s | 1 | 일반 마이크로스위치(1.5N)는 베이스를 밀거나 넘어뜨림 → 레버형 저작동력 제품을 써야 함 |
| D14 | PETG 평행 플렉서 리프트 스테이지 | 베어링 없이 판스프링 4장으로 만든 평행 가이드라 유격이 0이고 진동 덜컹거림이 없다. 서보 크랭크가 30~45mm를 구동한다 | 서보×1 | 2단 높이(160→210)를 플렉서 1장으로 처리하기는 어려움 → 플렉서 50mm 행정, 판 길이 150 | 판 높이 220 | 서보 단순 구동이면 인정 안 됨 → 홈 리밋을 따로 달아야 함 | 높이 ±1 | 1s | 3 | PLA 크리프(하중이 오래 걸리면 처짐) → PETG 사용, 행정 끝 응력 확인 |
| D15 | 무릎 꿇기 차체(피치 틸트) | 뒷캐스터 다리를 리드스크류로 신축해 차체 전체를 앞으로 숙이거나 세운다. 포크 끝 높이가 별도 리프트 없이 변한다(포크 끝 L=200에서 10°당 35mm) | 타미야×1 | 피치각 2단 | 해당 없음 | 다리 리밋 | 횡 ±15 / 높이 ±4 | 2s | 3 | 라인센서 높이가 바뀌어 검출이 실패할 수 있음(센서를 바퀴축 근처에 둬야 함). 숙이면 CD도 기울어짐 |
| D16 | 단일모터 캠 드럼 시퀀서 | 원통 캠 드럼 1회전에 '포크 상승 → 리테이너 닫힘 → (반 바퀴 후) 하강 → 열림'을 새긴다. 모터 하나로 순서가 기계적으로 보장되어, 리테이너를 닫지 않은 채 주행하는 소프트웨어 버그가 생길 수 없다 | 타미야×1 | 드럼 홈 2개를 행별로 선택하기는 복잡 → 160→210 공통 행정 | Ø60×150 드럼 | 드럼 플래그 리밋 | 횡 ±15 | 반 바퀴 2s | 4 | 캠 홈 설계와 출력 정밀도. 드럼 마찰이 커지면 모터가 멈춤 → 고감속단 선택 |
| D17 | 상향 IR 그림자 존재판별 | GP2Y0A41을 높이 약 120에서 위로 향하게 두고 r=40 지점을 본다. CD가 있으면 55~80mm, 없으면 300mm 이상(측정 범위 밖). 본선에서 CD가 있는 쪽을 판단하는 마진이 3배 이상이다 | 0 | 175에서는 55mm로 최소거리 40보다 큼(높이 150에 두면 25mm라 측정 불가) | 해당 없음 | 해당 없음 | 횡 ±10에서도 r=30~50이 그림자 안 | 측정 0.1s | 1 | 천장 조명이나 사람 반사가 원거리에서 오검출 → "50~120mm면 있음"처럼 창 판정과 이동평균 5회 |
| D18 | 중력 전개 접이 포크 | 출발할 때는 포크를 수직으로 세워 250 안에 넣는다. 출발 후 래치를 풀면(리프트 첫 동작이 래치를 친다) 중력으로 수평이 되고, 정지 블록과 자석 디텐트로 고정된다. 리밋으로 펼침을 확인 | 0(리프트가 겸용) | 무관 | 세웠을 때 높이 240 | 펼침 확인 리밋(초기화 시퀀스에 포함) | ±0 영향 | 첫 펼침 0.5s | 2 | 펼쳐질 때 충격으로 힌지가 깨짐 → TPU 댐퍼. 디텐트가 약하면 포크 끝이 진동함 |
| D19 | 접촉 감지 하강(높이 무지식 내려놓기) | 포크를 TPU 힌지로 2mm 처지게 하고 스위치를 단다. 내려가다가 CD가 베이스 윗면에 닿는 순간 멈추고 3mm만 더 내린다. 행 높이표가 틀리거나 베이스가 기울어도 동작한다 | 리프트 1 | 자동(높이를 몰라도 됨) | 해당 없음 | 리프트 리밋 | 높이 오차 무관, 횡 ±20(내려놓기는 원래 관대함) | +0.5s | 2 | 스위치 채터링 → 디바운스 5ms. 포크가 하부원기둥 윗면(100)에 닿아도 같은 신호가 나와 오판할 수 있음 |
| D20 | 이산 리밋 사다리 DC 리프트 | 타미야 + 랙(또는 M8 나사봉) 리프트에 높이 160/185/210 위치마다 리밋 스위치를 둔다. 시간으로 정지하지 않으므로 배터리 전압이 8.4→6.6V(−21%)로 떨어져도 위치가 같다 | 타미야×1 | 스위치 위치가 곧 높이 | 기둥 높이 230 | 최하단 리밋 | 높이 ±2(관성 오버런) | 2s | 2 | 스위치 3개 배선, 오버런 → 상승은 접근 속도를 낮춰 PWM 50%로 |
| D21 | 실 감기 윈치 + 중력 하강 | 다이니마 낚싯줄을 타미야 축 스풀에 감아 캐리지를 끌어 올리고, 내릴 때는 자중으로 내려간다. 줄이 늘 팽팽해 유격이 없고 부품은 3개뿐이다 | 타미야×1 | 리밋 2개 | 해당 없음 | 하단 리밋(늘어진 줄 감지 겸용) | 높이 ±2 | 2s | 1 | 캐리지가 걸리면 줄이 풀려 엉킴 → 늘어짐 감지 스위치. 상승 상태 유지에는 기어박스 감속비(역구동 저항)가 필요 |
| D22 | 피벗 틸트 포크 | 포크 뿌리 뒤쪽 피벗을 중심으로 15° 회전시켜 끝을 들어 올린다(r=150에서 39mm). 직선 가이드가 없어 가장 단순하다 | 서보×1 또는 타미야×1 | 각도 2단 | 해당 없음 | 서보만 쓰면 불인정 → 타미야 + 리밋 | 횡 ±15, 깊이가 높이에 영향(Δh = Δx·tan15° ≈ 0.27Δx) | 0.5~1s | 1 | 들어 올릴 때 CD가 뒤로 기울어 미끄러짐 → D08 스톱벽과 조합. 깊이 오차가 높이 오차로 바뀜 |
| D23 | V입구 목(throat) 자가안착 포크 | 포크 입구는 110, 목은 54로 좁아지는 V형이다. 넥(Ø50)이 V면을 타고 목으로 미끄러져 베이스와 포크가 넥 기준으로 정렬된다. 정렬 기준이 CD에서 가장 가까운 형상이다 | 리프트 1 | 리프트가 담당 | 해당 없음 | 리프트만 | 횡 ±28 | 0s | 2 | 높이 150에서 미는 힘은 전도 위험이 큼(h/r=3 → 측면력 > mg/3이면 넘어짐) → D02 하부 퍼넬과 함께 써서 넥에 걸리는 힘을 줄여야 함 |
| D24 | 원웨이 클러치 1모터 2기능 | 타미야 출력에 원웨이 베어링 2개를 반대 방향으로 단다. 정회전이면 리프트 웜, 역회전이면 제네바 포탑이 돈다. 모터 1개로 두 축을 쓰고 2개는 예비로 남긴다 | 타미야×1 | 리프트가 담당 | 해당 없음 | 축마다 리밋 1개 | 리프트·포탑 각각의 정밀도 유지 | 두 동작이 순차라 +1s | 4 | 원웨이 베어링(HF0612) 미끄럼과 역구동. 리프트가 자중으로 내려가지 않도록 웜 셀프로킹 필수 |
| D25 | 리프트 오버트래블 클램프 | 리프트 최상단 5mm 구간에서 CD 윗면이 차체에 고정된 TPU 패드에 눌려 끼인다. 운반 중에는 CD가 위아래로 고정되어 스핀이나 진동에서도 빠지지 않는다. 별도 모터가 없다 | 0(리프트가 겸용) | 운반 위치는 하나(최상단) | 패드 높이 ≤ 230 | 상단 리밋 = 클램프 확인 | 해당 없음(운반 안정성 전용) | 0s | 1 | 패드 위치가 CD 테두리 r=50~55가 아니면 CD가 휨. 175 행에서는 리프트 행정이 더 길어짐 |

## 내 관점 상위 5개

1. **D01 와이드갭 U포크(내폭 80) + 편심캠 리프트**: 횡 허용오차를 ±2에서 ±15로 7배 넓힌다. 라인추종 ±5~8 가정을 두 배 여유로 덮으면서 센서를 하나도 추가하지 않는다. 캠 사점 정지는 배터리 전압 변동이나 정지 타이밍 오차에 둔감하고, 하사점 리밋으로 초기화 점수도 받는다.
2. **D13 TPU 범퍼 접촉 정지**: 깊이 정렬을 "정지선을 ±5로 읽어야 한다"에서 "넥에 닿으면 멈춘다"로 바꾼다. 오차의 원인 자체가 없어진다. 단, 작동력 0.15N 이하 레버 스위치가 전제다(1.5N 일반품은 베이스를 넘어뜨릴 수 있음).
3. **D17 상향 IR 그림자 판별**: 본선의 무작위 배치 판단을 거리 55~80mm(있음)와 300mm 초과(없음)의 이진 문제로 만든다. 경계가 매우 넓어 노이즈에 강하다. 높이 150에 두면 최소거리(40mm) 미만이 되는 함정까지 피해 간다.
4. **D02 하부 V퍼넬 + D08 후방 5° 시팅**: 둘 다 모터 0개, 출력물 몇 개로 정렬(입구)과 운반 중 위치 고정(출구)을 수동으로 보장한다. 1인 4주 일정에서 가성비가 가장 좋다.
5. **D20 이산 리밋 사다리 리프트**(또는 D04 리드스크류): 시간 기반 정지를 없애 NiMH 방전 곡선(8.4→6.6V)에 따른 위치 편차를 없앤다. 리밋 자체가 원점이어서 초기화 점수와 매 사이클 자기 교정이 함께 해결된다.

## 다른 관점과 결합 메모
- 주류 관점(지게차 + 랙피니언)에는 D01의 내폭 80 수치, D13 접촉 정지, D25 클램프만 붙여도 신뢰성이 크게 오른다. 기존 설계를 버리지 않고 덧붙일 수 있는 부품들이다.
- 포탑을 고려하는 관점이라면 D05 제네바로 각도 정확도를 기계적으로 고정하라. 포탑을 빼는 관점이라면 D06 교차점 스핀(라인 재획득이 쉬운 십자 교차)을 권한다.
- 모터 3개 한도에 걸리는 설계에는 D16 캠 드럼이나 D24 원웨이 클러치로 1모터를 다기능화해 예비 모터를 확보한다.
- 디자인·창의성 점수를 노리는 관점에는 D11 주사기 진공(규정상 펌프 모터 금지를 서보로 우회), D18 중력 전개 포크가 발표용 이야깃거리로 좋다.

## 다른 관점이 흔히 놓칠 함정 10가지

1. **포크 내폭 함정**: 넥 Ø50에 딱 맞춘 U포크(내폭 54)는 횡오차를 ±2mm밖에 허용하지 않는다. 라인추종 ±5~8을 가정하면 3번 중 1번 이상 넥에 부딪힌다. 내폭 80이면 ±15이고 CD도 r=40 선에서 안정적으로 받쳐진다(G/2+|e| < 55 조건).
2. **IR 최소거리 40mm**: GP2Y0A41SK는 40mm 아래에서 출력이 비단조(가까워질수록 값이 다시 내려감)라 "가까움"과 "멀음"을 구분하지 못한다. 높이 150에 붙여 175 베이스의 CD를 보면 25mm라 측정 불가다. 갱신 주기 약 16.5ms, 전원 단자 바로 옆에 10µF가 필요하고, 5회 이상 평균을 내야 한다.
3. **정지선 이후 여유 50mm**: 하부원기둥 면은 정지선에서 50mm 앞에 있다. 0.3m/s에서 L298을 코스팅 정지하면 20~40mm 미끄러지고, 루프 주기 10ms는 3mm 지연이다. 센서가 차체 앞단보다 30mm 이상 뒤에 있으면 그대로 충돌한다. 정지선 직전 감속(0.1m/s)과 단락 제동이 필요하다.
4. **트렁크 교차를 정지선으로 오인**: 행 라인은 x=500에서 트렁크와 십자로 만나며, 이때 3채널이 모두 검은색을 읽어 정지선과 같은 신호가 나온다. 교차 횟수를 세는 상태기계 없이 "3채널 모두 검정 = 정지"로 짜면 행 중간에서 선다.
5. **회전 중 CD 이탈의 한계값**: PLA와 폴리카보네이트의 마찰계수는 약 0.3, 즉 미끄러짐 한계 가속도 약 2.9m/s²다. 스핀 중심에서 r=150 위치의 CD는 각속도 4.4rad/s 이하, 각가속도 19rad/s² 이하여야 한다. 0→3rad/s를 0.1s에 올리면 30rad/s²로 미끄러진다. 0.3s 이상 램프를 두거나 D25처럼 클램프해야 한다.
6. **베이스 전도·밀림 판정식**: 높이 h에서 미는 힘 F에 대해 F·h > m·g·50이면 넘어진다. 넥 높이 150을 밀면 F > m·g/3이다. 베이스가 150g짜리 출력물이면 0.5N에 넘어지는데, 일반 마이크로스위치 작동력이 1.5N이다. 또 바닥 마찰계수가 r/h=0.33보다 작으면 넘어지기 전에 미끄러진다. 어느 쪽이든 CD가 떨어진다.
7. **회전 반경 충돌·구역 침범**: 포크 끝 회전 반경 200인 로봇이 베이스 앞(정지선)에서 스핀하면 베이스와 거리가 150이라 포크가 베이스를 친다. 1행 왼쪽 베이스는 x=130이라 차체가 x<0 쪽으로 휘두르면 상대 구역 침범이다. 스핀은 x=500 교차점에서만 해야 한다.
8. **브라운아웃 경로**: L298은 1A에서 약 2V가 떨어져 7.2V 팩이 실제로는 4.5~5V가 된다. 그런데 기동할 때 돌입 전류가 정격의 3~5배다. 서보를 Mega 5V 레귤레이터(약 800mA, 9V 입력이면 (9−5)×0.5A=2W 발열)에 물리면 리셋된다. 서보는 별도 5~6V 3A BEC로, 모터마다 100nF 3개, 모터 전원에 470µF 벌크 캐패시터를 달고, 그라운드는 한 점에서 연결한다.
9. **전압 의존 타이밍**: NiMH 6셀은 만충 8.4V에서 방전 말기 6.6V까지 21% 떨어진다. 시간으로 제어한 DC 리프트(예: "1.2초 올림")는 경기 끝에 약 10mm 덜 올라간다. 주행 속도가 21% 느려지면 120s 예산(경로 약 4.5m, 0.2m/s면 23s + 승강 6회×3s + 스핀·교차 약 20s ≈ 60~70s)이 버티더라도, 시간 기반 정지 거리는 무너진다. 모든 정지를 센서나 스위치 기준으로 해야 한다.
10. **스테퍼 탈조는 조용히 누적된다**: DRV8834(최대 1.5A, 방열 없으면 약 1A) + SF2421로 리프트를 구동하면 진동이나 높은 가속에서 스텝을 잃어도 피드백이 없다. CD 3장을 처리하는 동안 6번 승강하며 누적되면 마지막 놓기에서 포크가 하부원기둥 윗면(100)을 친다. 매 CD 직전에 하단 리밋으로 재홈잡기(+1s)를 하는 편이 남는 장사다. 흔히 파는 Tr8x8(리드 8mm, 4줄)은 역구동되므로 전원이 끊기면 처진다. 셀프로킹이 필요하면 Tr8x2(리드 2mm)를 사야 한다. 대신 속도는 1/4이다.
