jbj7667/wafer-transfer-robot/practice/field_overview.pdf

# 연습 경기장 개요 (자기 진영 1000 × 1000 mm)

축척 1:6 (A4에 1:4=250 mm가 들어가지 않아 1:6 사용) · 원점 좌상단, +x 오른쪽, +y 아래 · 단위 mm

340

1000

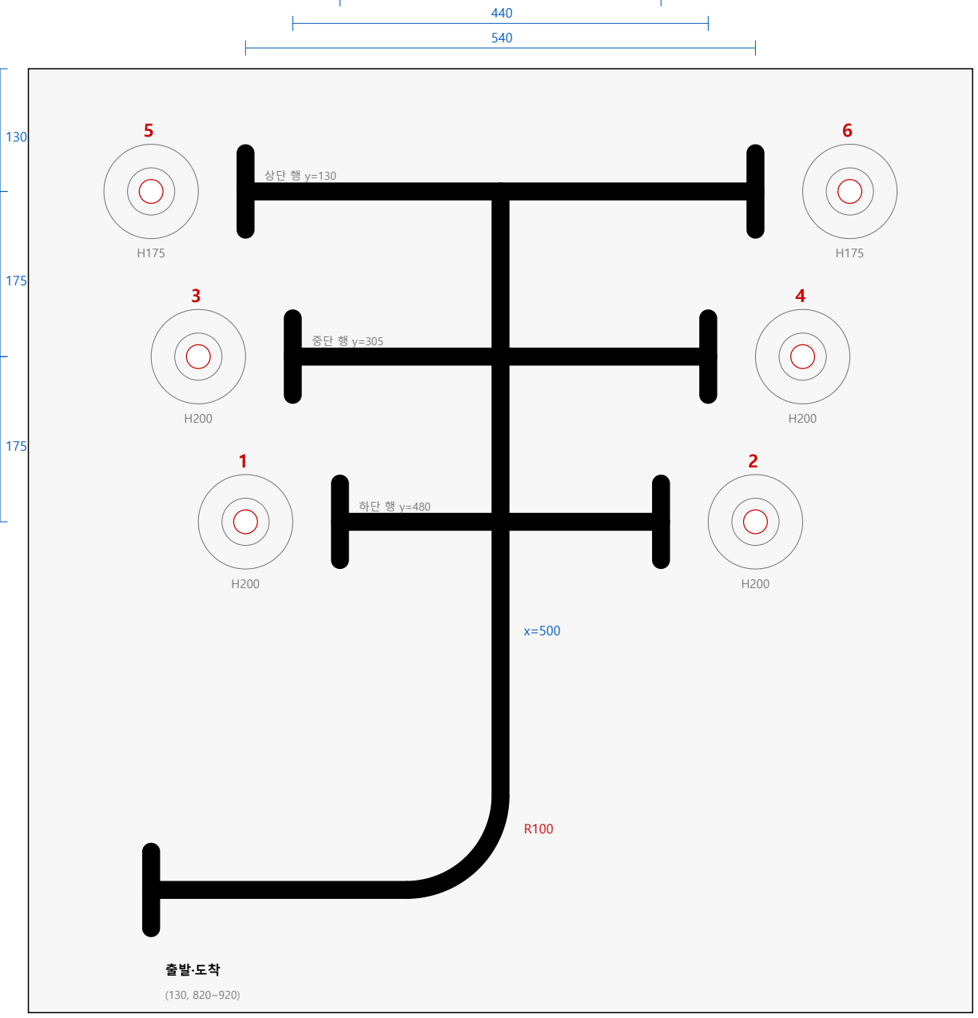
[picture p2: figure]

1000

범례

검정 선 폭 19 mm, 끝은 반원(R9.5). 정지선/출발·도착 바는 둥근 끝 포함 전체 길이 100 mm 회색 얇은 원 Ø100 / Ø50 = 웨이퍼 베이스 위치 (번호는 빨강)
베이스 번호: 왼쪽 1(하단)·3(중단)·5(상단), 오른쪽 2·4·6. H=기둥 상단 높이(mm)
행 | y | 행 선 x 범위 | 정지선 x | 베이스 L/R | 기둥 높이
상단 | 130 | 230~770 | 230 / 770 | 5 (130) / 6 (870) | 175
중단 | 305 | 280~720 | 280 / 720 | 3 (180) / 4 (820) | 200
하단 | 480 | 330~670 | 330 / 670 | 1 (230) / 2 (770) | 200
- 트렁크: x=500, y=130→770 직선 → R100 호(중심 (400,770), (500,770)→(400,870)) → y=870, x=400→130 직선.
- 출발·도착 바: x=130, y=820~920. 정지선: 각 행 끝에서 y±50. 베이스 중심은 정지선에서 바깥으로 100 mm.
- 모든 치수 허용오차 ±1 mm(대회 규격 p.7). 규격 도면과 대조하여 불일치 없음.
- 실제 크기(1:1) 출력은 field_tiles_A4.pdf, 테이프 시공은 field_tape_guide.pdf 참조.
