jbj7667/wafer-transfer-robot/practice/field_tiles_A4.pdf

R1C1 | 원점 x=0, y=0 mm | 1:1 | 인쇄 시 '실제 크기(100%)' | 굵은 선 폭 19 mm

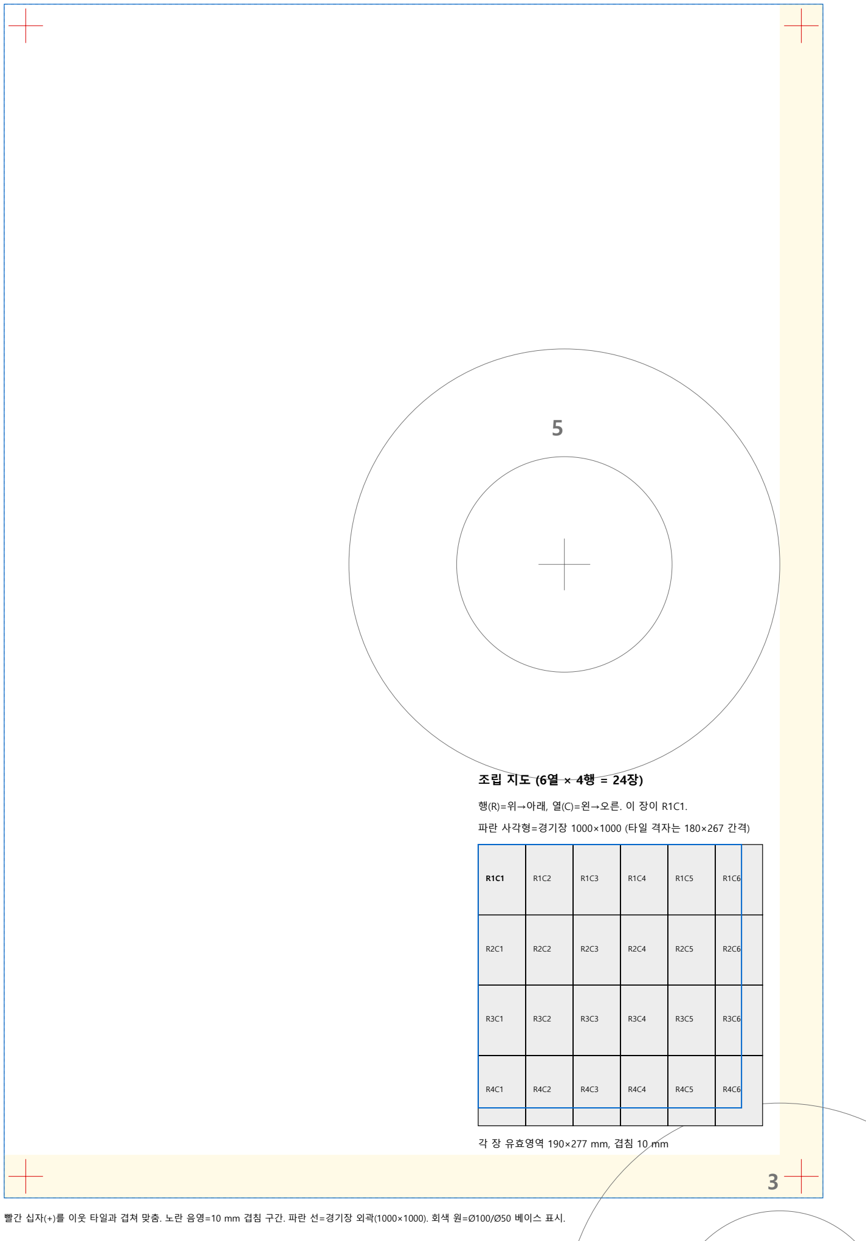
[picture p3: figure]
각 장 유효영역 190×277 mm, 겹침 10 mm

빨간 십자(+)를 이웃 타일과 겹쳐 맞춤. 노란 음영=10 mm 겹침 구간. 파란 선=경기장 외곽(1000×1000). 회색 원=Ø100/Ø50 베이스 표시.

파란 사각형=경기장 1000×1000 (타일 격자는 180×267 간격)

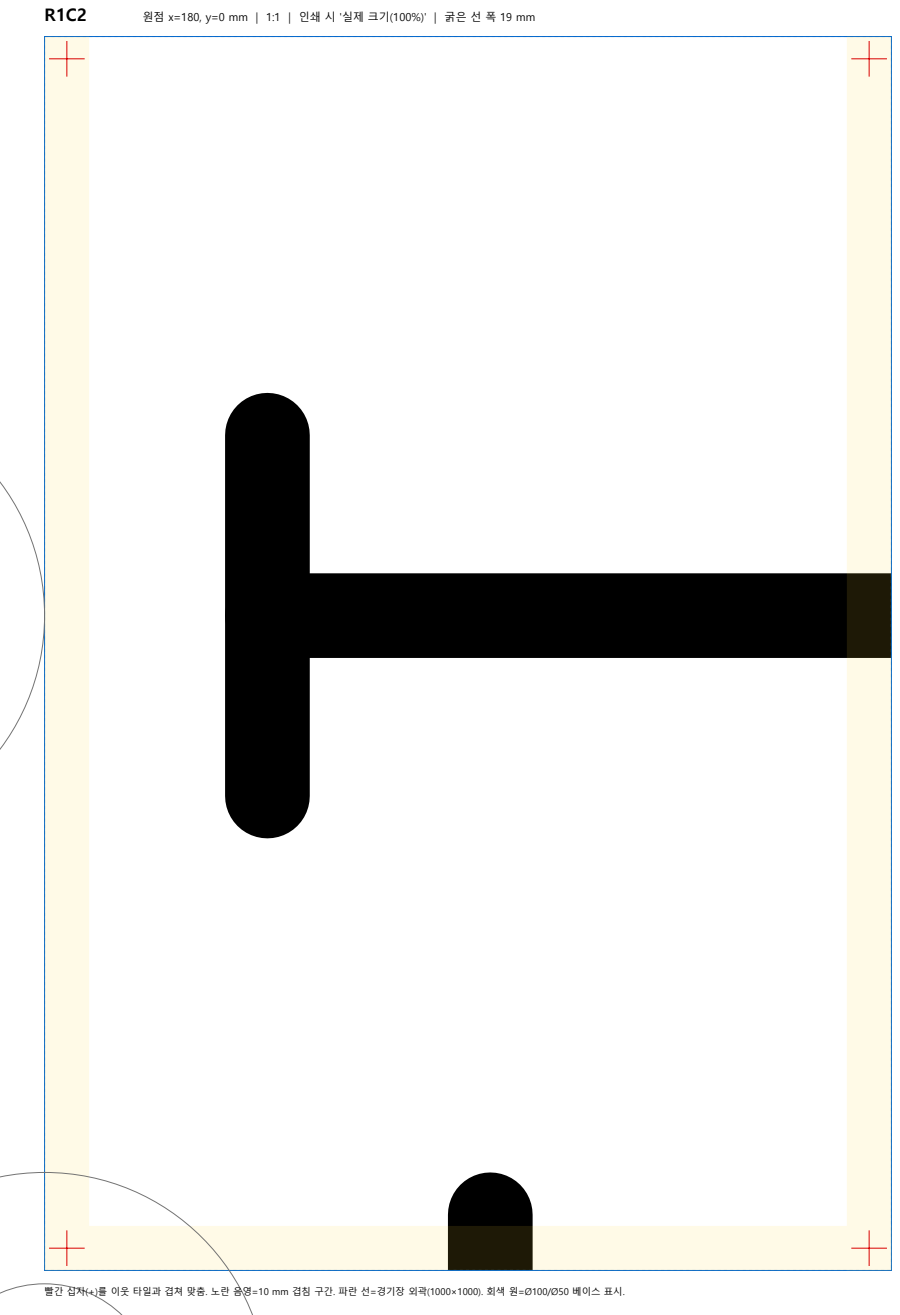
[picture p4: page 2]

R1C3 | 원점 x=360, y=0 mm | 1:1 | 인쇄 시 '실제 크기(100%)' | 굵은 선 폭 19 mm

R1C4 | 원점 x=540, y=0 mm | 1:1 | 인쇄 시 '실제 크기(100%)' | 굵은 선 폭 19 mm

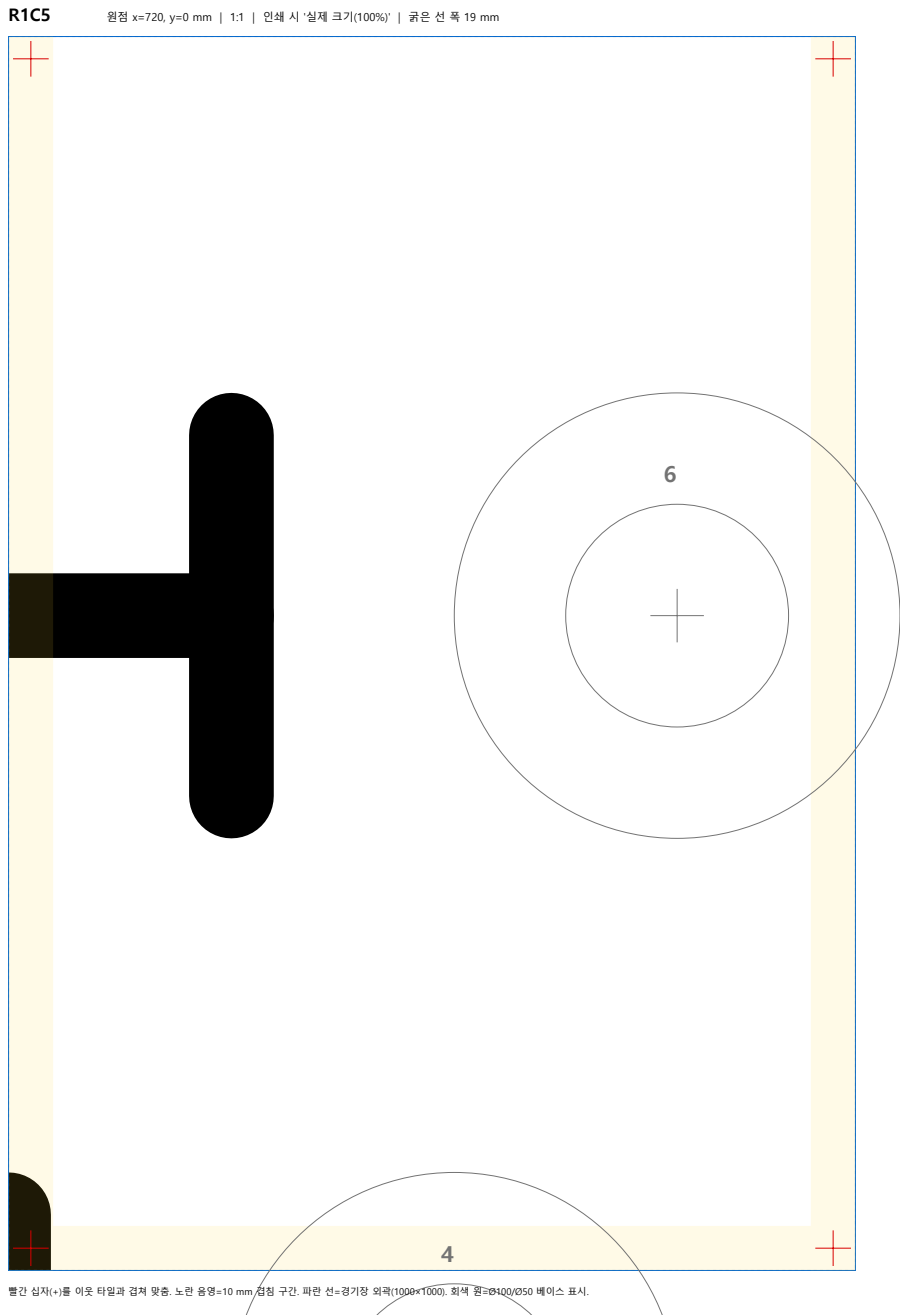
[picture p5: page 5]

R1C6 | 원점 x=900, y=0 mm | 1:1 | 인쇄 시 '실제 크기(100%)' | 굵은 선 폭 19 mm

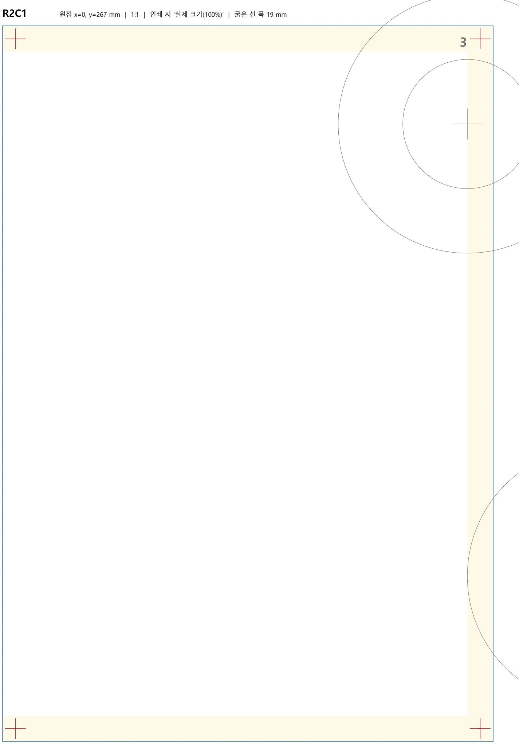
[picture p6: figure]

R2C1 | 원점 x=0, y=267 mm | 1:1 | 인쇄 시 '실제 크기(100%)' | 굵은 선 폭 19 mm

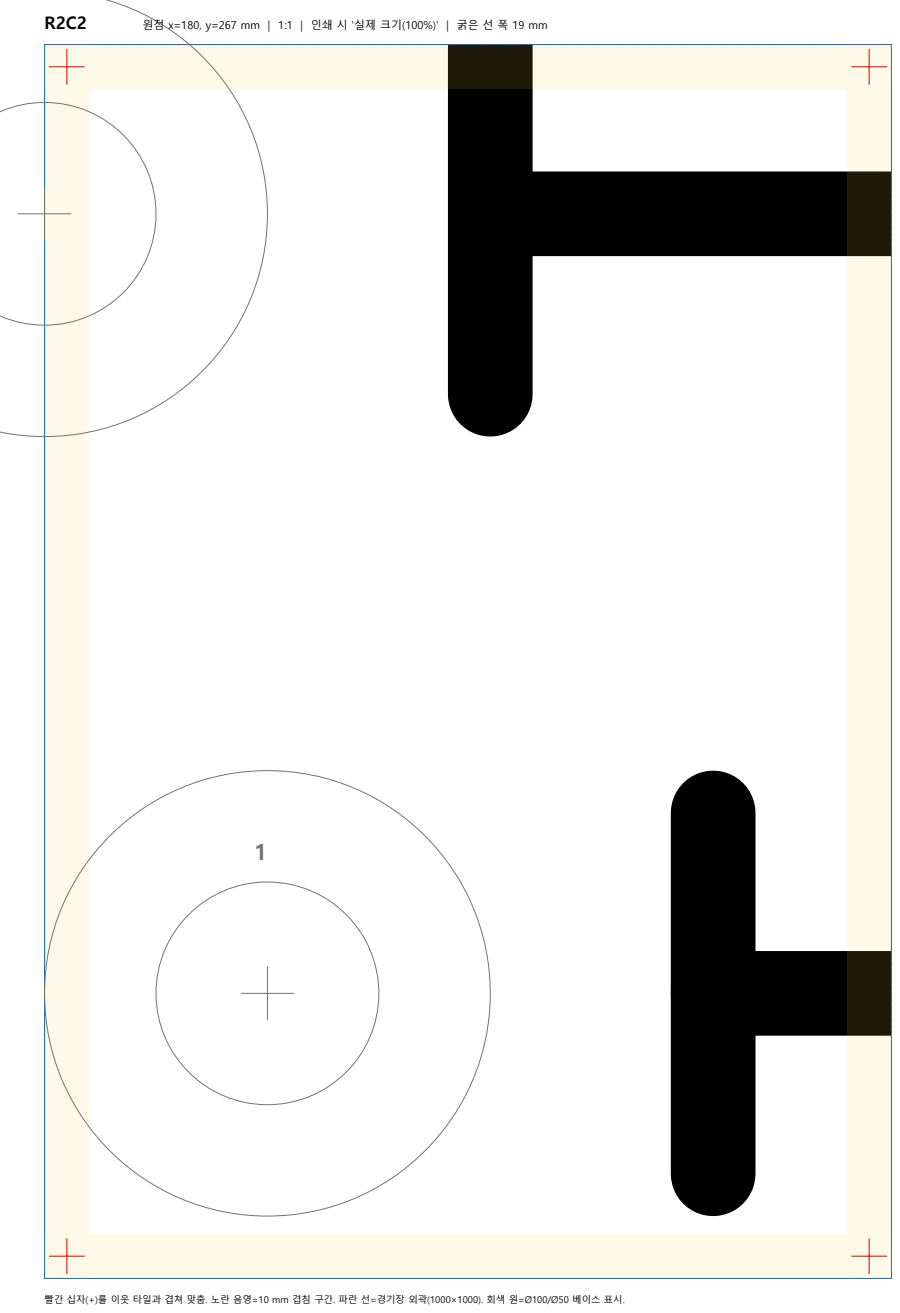
[picture p7: page 8]

R2C3 | 원점 x=360, y=267 mm | 1:1 | 인쇄 시 '실제 크기(100%)' | 굵은 선 폭 19 mm

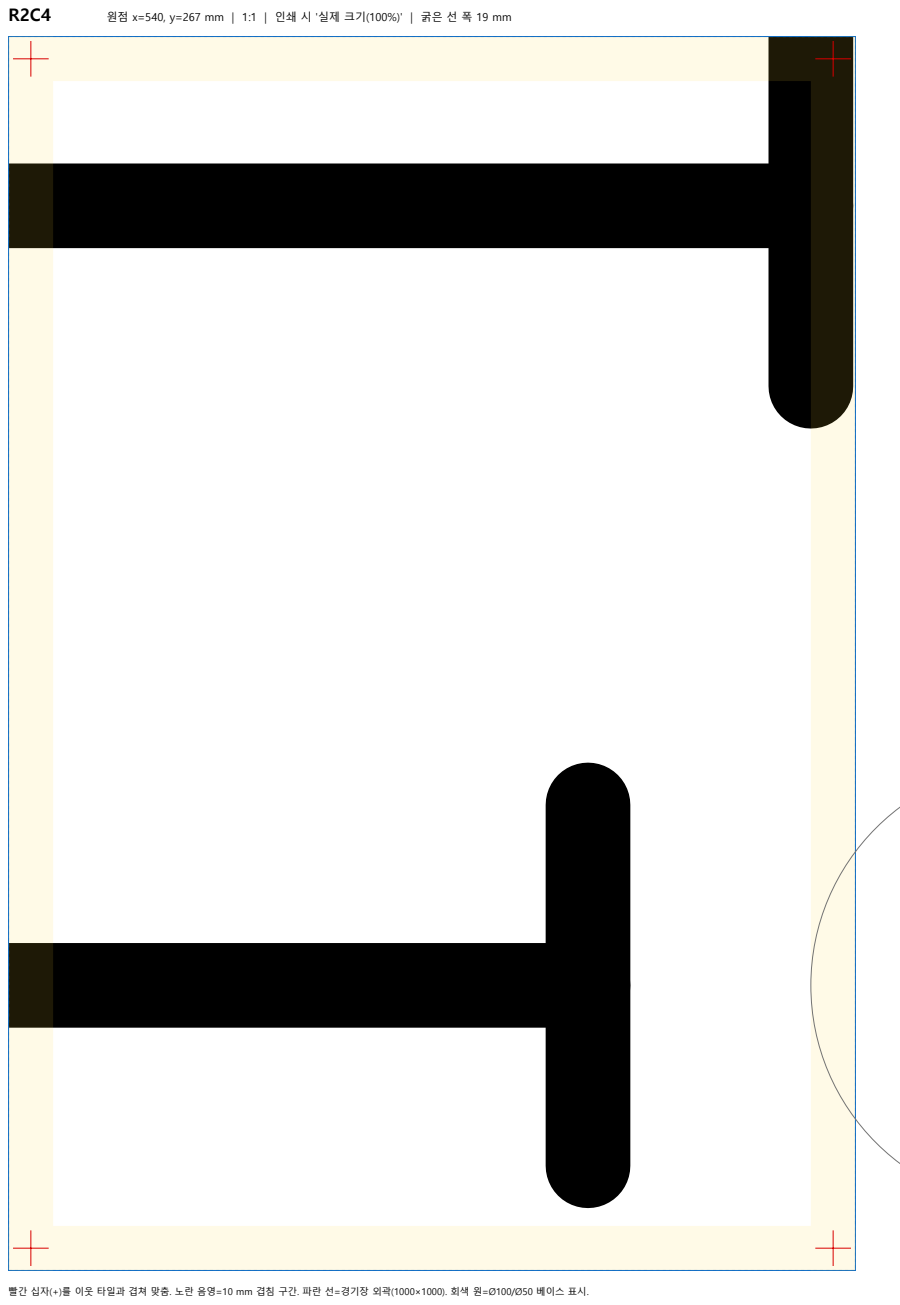
[picture p8: page 10]

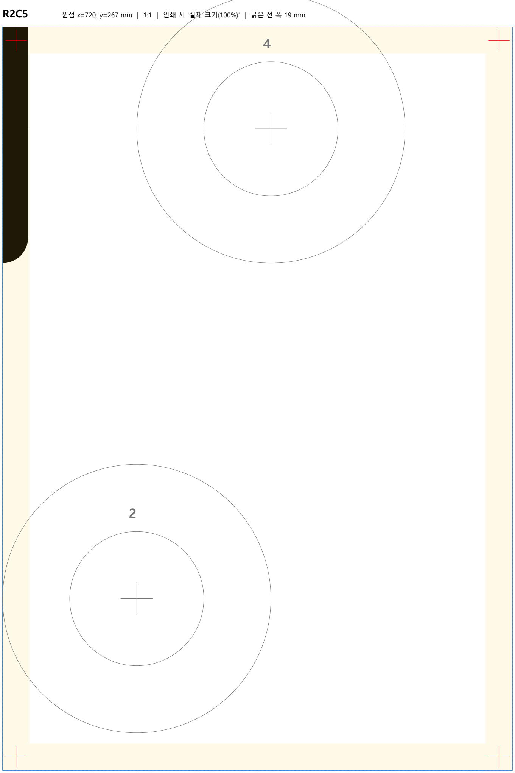
[picture p9: figure]

R2C5 | 원점 x=720, y=267 mm | 1:1 | 인쇄 시 '실제 크기(100%)' | 굵은 선 폭 19 mm

R2C6 | 원점 x=900, y=267 mm | 1:1 | 인쇄 시 '실제 크기(100%)' | 굵은 선 폭 19 mm

R3C1 | 원점 x=0, y=534 mm | 1:1 | 인쇄 시 '실제 크기(100%)' | 굵은 선 폭 19 mm

R3C2 | 원점 x=180, y=534 mm | 1:1 | 인쇄 시 '실제 크기(100%)' | 굵은 선 폭 19 mm

R3C3 | 원점 x=360, y=534 mm | 1:1 | 인쇄 시 '실제 크기(100%)' | 굵은 선 폭 19 mm

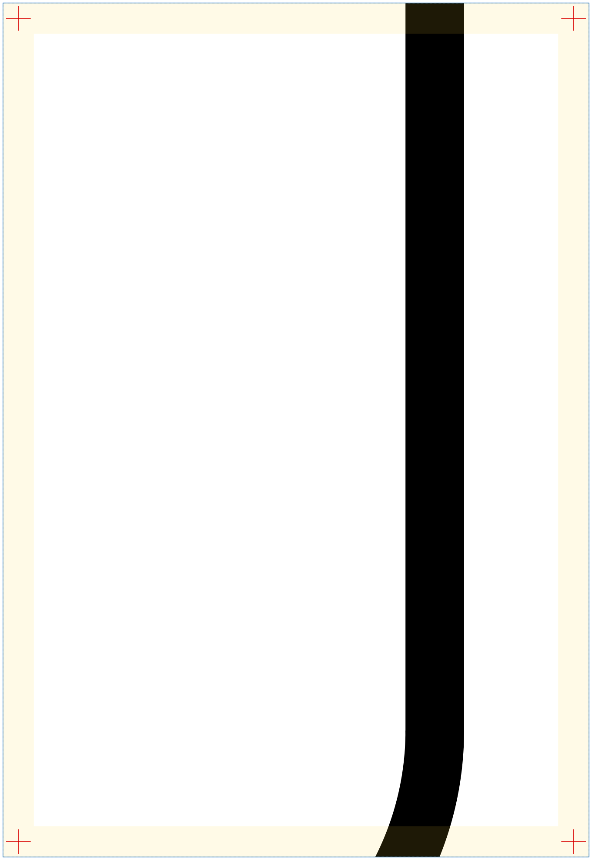
[picture p10: figure]

R3C4 | 원점 x=540, y=534 mm | 1:1 | 인쇄 시 '실제 크기(100%)' | 굵은 선 폭 19 mm

R3C5 | 원점 x=720, y=534 mm | 1:1 | 인쇄 시 '실제 크기(100%)' | 굵은 선 폭 19 mm

R3C6 | 원점 x=900, y=534 mm | 1:1 | 인쇄 시 '실제 크기(100%)' | 굵은 선 폭 19 mm

R4C1 | 원점 x=0, y=801 mm | 1:1 | 인쇄 시 '실제 크기(100%)' | 굵은 선 폭 19 mm

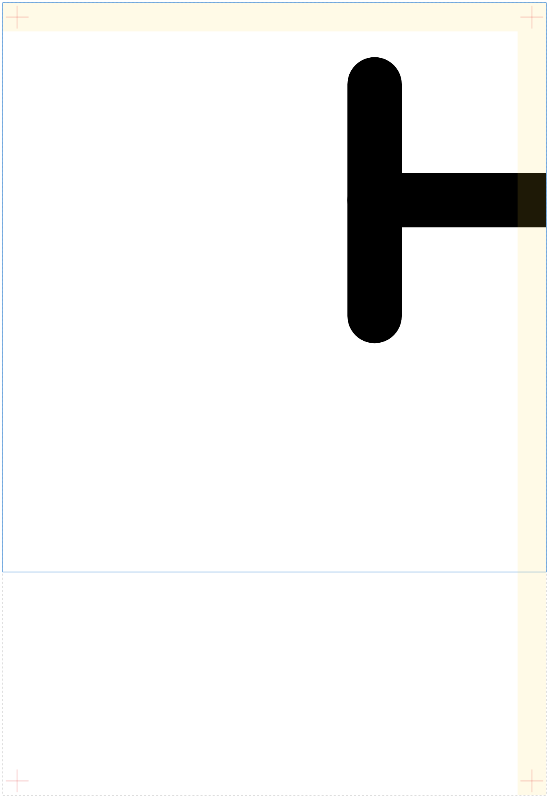
[picture p11: figure]

R4C2 | 원점 x=180, y=801 mm | 1:1 | 인쇄 시 '실제 크기(100%)' | 굵은 선 폭 19 mm

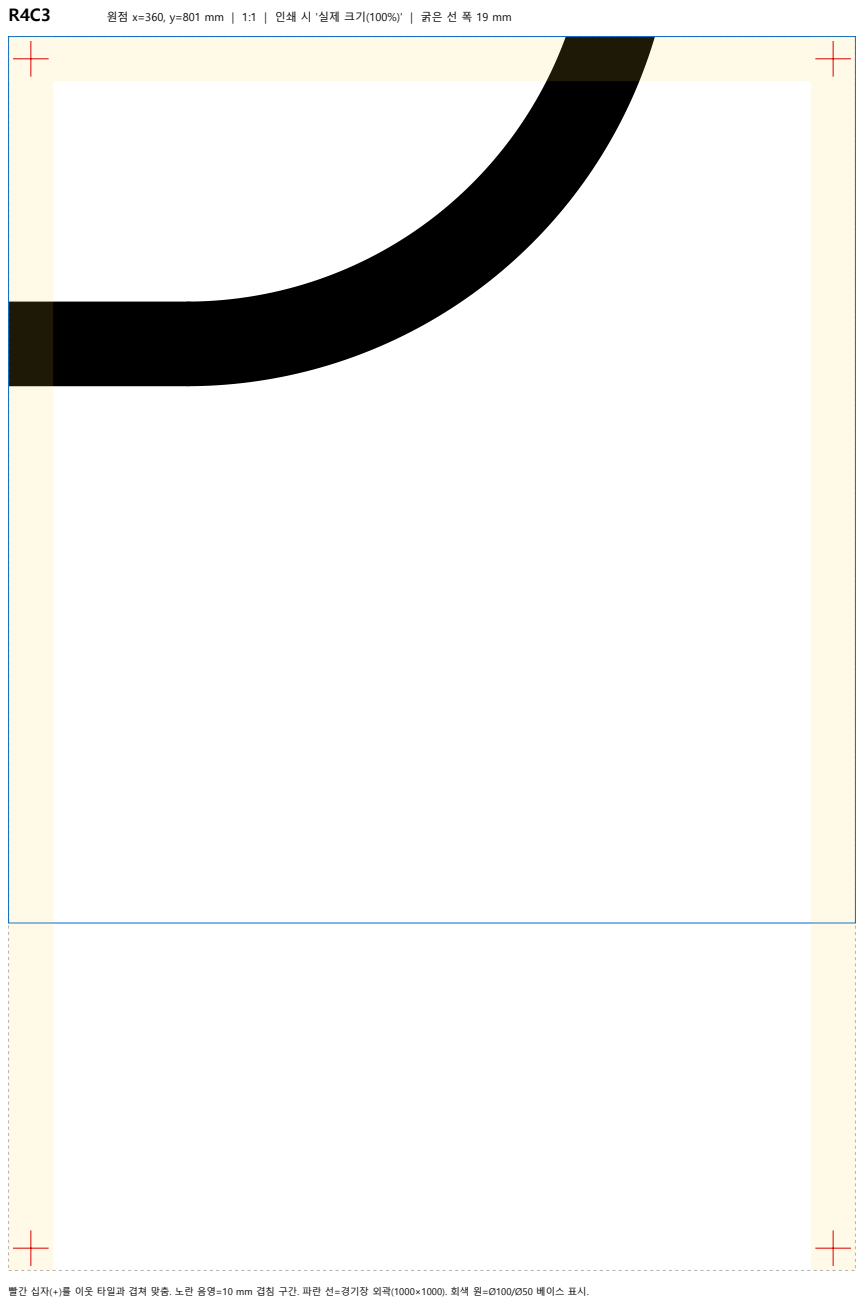
[picture p12: page 21]

R4C4 | 원점 x=540, y=801 mm | 1:1 | 인쇄 시 '실제 크기(100%)' | 굵은 선 폭 19 mm

R4C5 | 원점 x=720, y=801 mm | 1:1 | 인쇄 시 '실제 크기(100%)' | 굵은 선 폭 19 mm

R4C6 | 원점 x=900, y=801 mm | 1:1 | 인쇄 시 '실제 크기(100%)' | 굵은 선 폭 19 mm
