jbj7667/wafer-transfer-robot/docs/design/arm_calc/fold_out.md

## F1. 접힘 자세(phi=105 deg, 손목이 어깨 뒤쪽)의 회전대 축 기준 외곽 (로봇 좌표 x 전진, y 왼쪽)
팔 좌표 u(팔 방향)를 로봇 좌표로 회전한 각 = θ_stow. 한계: 로봇 x -92..+158 (길이 250), y +-125 (폭 250). 축 위치 (x_T, y_T)에서 외곽이 들어가는 범위를 구한다.
| L | θ_stow | 외곽 x 폭 | 외곽 y 폭 | x_T 허용 범위 | y_T 허용 범위 | 판정 |
|---|---|---|---|---|---|---|
| 205 | 312 | 246 | 248 | 23 ~ 27 | -69 ~ -67 | 가능 |
| 190 | 40 | 237 | 237 | 84 ~ 97 | -17 ~ -4 | 가능 |
| 175 | 38 | 226 | 227 | 68 ~ 91 | -23 ~ -0 | 가능 |

해석: L=205는 외곽 약 248 x 241(회전 후)로 여유 약 2mm라 사실상 실패 위험. L=190이면 약 237로 여유 13mm. 도달 한계(K3) 때문에 L=190에서도 phi_min 29deg로 R_손목 332까지 48mm 여유가 있다.

## F2. 축을 몸체 중앙 근처(x_T 0~40, |y_T|<=20)에 두고 들어가는 최대 허용 L과 θ_stow (스캔: 접힘 phi 90~125 deg, 회전 0~358)
| L | phi_stow | θ_stow | x_T 범위 | y_T 범위 |
|---|---|---|---|---|
| 205 | - | 불가 | - | - |
| 190 | - | 불가 | - | - |
| 180 | 100 | 216 | 0 ~ 9 | 20 ~ 20 |
| 175 | 95 | 304 | 0 ~ 2 | -10 ~ -5 |
| 170 | 95 | 302 | 0 ~ 2 | -9 ~ 3 |
| 160 | 90 | 302 | 0 ~ 2 | 16 ~ 20 |
