jbj7667/wafer-transfer-robot/docs/design/arm_calc/kin_out.md

## K1. 기준 (theta, R) 표 (계산) S=(500,240), 헤딩 북쪽, theta 왼쪽 +
| 베이스 | theta(deg) | R_CD(mm) | R_손목=R-64 | 여유(410-R_손목) | phi=acos(R_손목/410) | 팔꿈치 x,y (s=+1) |
|---|---|---|---|---|---|---|
| 5(상좌) | +73.4 | 386.0 | 322.0 | 88.0 | 38.2 | 310, 316 |
| 6(상우) | -73.4 | 386.0 | 322.0 | 88.0 | 38.2 | 618, 72 |
| 3(중좌) | +101.5 | 326.5 | 262.5 | 147.5 | 50.2 | 403, 420 |
| 4(중우) | -101.5 | 326.5 | 262.5 | 147.5 | 50.2 | 660, 112 |
| 1(하좌) | +131.6 | 361.2 | 297.2 | 112.8 | 43.5 | 483, 444 |
| 2(하우) | -131.6 | 361.2 | 297.2 | 112.8 | 43.5 | 705, 233 |

## K2. 포크 방향 대안별 필요 손목 반경 (R_max=386)
| 포크 | 필요 R_손목 | 410 대비 | 판정 |
|---|---|---|---|
| U 바깥향(PLAN, 손목=루트가 안쪽) | 322 | 여유 88 | 가능 |
| U 안쪽향(루트가 바깥) | 450 | 부족 40 | 불가(L>=225 필요) |

## K3. 링크 길이 L별 phi_min (R_손목,max=322 + 스톱오차 10 = 332)
| L | 2L | phi_min(deg) | 특이점 여유(mm) |
|---|---|---|---|
| 160 | 320 | 불가 | -12 |
| 170 | 340 | 12.5 | 8 |
| 180 | 360 | 22.7 | 28 |
| 190 | 380 | 29.1 | 48 |
| 205 | 410 | 35.9 | 78 |

## K4. 정지오차 민감도 (공칭 명령 유지 시 포켓 위치오차 성분, mm)
가로(lat)=포크 축에 수직(U 허용 +-14 대상), 깊이(dep)=포크 축 방향(원추 시트 +-10). 보정에 필요한 dR(mm), dtheta(deg)도 함께.
| 베이스 | 오차원 | 가로 lat | 깊이 dep | 필요 dR | 필요 dth(deg) |
|---|---|---|---|---|---|
| 5(상좌) | S 북+10 | +9.6 | +2.8 | -2.7 | +1.43 |
| 5(상좌) | S 남+10 | -9.6 | -2.8 | +3.0 | -1.41 |
| 5(상좌) | 횡 +5 | +1.4 | -4.8 | +4.8 | +0.21 |
| 5(상좌) | 횡 -5 | -1.4 | +4.8 | -4.8 | -0.21 |
| 5(상좌) | 헤딩 +2deg | -13.5 | -0.2 | +0.0 | -2.00 |
| 5(상좌) | 헤딩 -2deg | +13.5 | -0.2 | +0.0 | +2.00 |
| 6(상우) | S 북+10 | -9.6 | +2.8 | -2.7 | -1.43 |
| 6(상우) | S 남+10 | +9.6 | -2.8 | +3.0 | +1.41 |
| 6(상우) | 횡 +5 | +1.4 | +4.8 | -4.8 | +0.21 |
| 6(상우) | 횡 -5 | -1.4 | -4.8 | +4.8 | -0.21 |
| 6(상우) | 헤딩 +2deg | -13.5 | -0.2 | +0.0 | -2.00 |
| 6(상우) | 헤딩 -2deg | +13.5 | -0.2 | +0.0 | +2.00 |
| 3(중좌) | S 북+10 | +9.8 | -2.0 | +2.1 | +1.71 |
| 3(중좌) | S 남+10 | -9.8 | +2.0 | -1.8 | -1.73 |
| 3(중좌) | 횡 +5 | -1.0 | -4.9 | +4.9 | -0.17 |
| 3(중좌) | 횡 -5 | +1.0 | +4.9 | -4.9 | +0.18 |
| 3(중좌) | 헤딩 +2deg | -11.4 | -0.2 | +0.0 | -2.00 |
| 3(중좌) | 헤딩 -2deg | +11.4 | -0.2 | +0.0 | +2.00 |
| 4(중우) | S 북+10 | -9.8 | -2.0 | +2.1 | -1.71 |
| 4(중우) | S 남+10 | +9.8 | +2.0 | -1.8 | +1.73 |
| 4(중우) | 횡 +5 | -1.0 | +4.9 | -4.9 | -0.18 |
| 4(중우) | 횡 -5 | +1.0 | -4.9 | +4.9 | +0.17 |
| 4(중우) | 헤딩 +2deg | -11.4 | -0.2 | +0.0 | -2.00 |
| 4(중우) | 헤딩 -2deg | +11.4 | -0.2 | +0.0 | +2.00 |
| 1(하좌) | S 북+10 | +7.5 | -6.6 | +6.7 | +1.16 |
| 1(하좌) | S 남+10 | -7.5 | +6.6 | -6.6 | -1.21 |
| 1(하좌) | 횡 +5 | -3.3 | -3.7 | +3.8 | -0.52 |
| 1(하좌) | 횡 -5 | +3.3 | +3.7 | -3.7 | +0.53 |
| 1(하좌) | 헤딩 +2deg | -12.6 | -0.2 | +0.0 | -2.00 |
| 1(하좌) | 헤딩 -2deg | +12.6 | -0.2 | +0.0 | +2.00 |
| 2(하우) | S 북+10 | -7.5 | -6.6 | +6.7 | -1.16 |
| 2(하우) | S 남+10 | +7.5 | +6.6 | -6.6 | +1.21 |
| 2(하우) | 횡 +5 | -3.3 | +3.7 | -3.7 | -0.53 |
| 2(하우) | 횡 -5 | +3.3 | -3.7 | +3.8 | +0.52 |
| 2(하우) | 헤딩 +2deg | -12.6 | -0.2 | +0.0 | -2.00 |
| 2(하우) | 헤딩 -2deg | +12.6 | -0.2 | +0.0 | +2.00 |

## K5. 헤딩오차 e에 의한 가로 팔끝오차 = R*sin(e)
| e | R=326.5 | R=361 | R=386 | U 허용 14 대비(386) |
|---|---|---|---|---|
| 0.5 deg | 2.8 | 3.2 | 3.4 | 24% |
| 1 deg | 5.7 | 6.3 | 6.7 | 48% |
| 2 deg | 11.4 | 12.6 | 13.5 | 96% |
| 3 deg | 17.1 | 18.9 | 20.2 | 144% |

## K6. 가로오차 예산 (상단 행 R=386)
트렁크 +-10: 가로 9.6 / 횡 +-5: 가로 1.4 / 헤딩 2deg: 가로 13.5
선형합 24.5 mm, RSS 16.6 mm (U 허용 14) -> 헤딩 보정 필수

## K7. 방향 추정: 중단 행선 통과 시 좌/우 외곽 채널 시간차
psi = atan(v*dt/d), d = 외곽 채널 간격(가정, 확인필요). 틱 분해능 1 ms. 에지 지터 j(mm/채널)가 지배: sigma = atan(sqrt2*j/d), 상승+하강 4에지 평균 시 /sqrt2
| d(mm) | v(mm/s) | 틱 분해능(deg) | 지터 j(mm) | sigma 1에지(deg) | 4에지 평균(deg) | 386mm 팔끝(mm) |
|---|---|---|---|---|---|---|
| 40 | 100 | 0.14 | 0.5 | 1.01 | 0.72 | 4.8 |
| 40 | 100 | 0.14 | 1.0 | 2.02 | 1.43 | 9.6 |
| 40 | 150 | 0.21 | 0.5 | 1.01 | 0.72 | 4.8 |
| 40 | 150 | 0.21 | 1.0 | 2.02 | 1.43 | 9.6 |
| 48 | 100 | 0.12 | 0.5 | 0.84 | 0.60 | 4.0 |
| 48 | 100 | 0.12 | 1.0 | 1.69 | 1.19 | 8.0 |
| 48 | 150 | 0.18 | 0.5 | 0.84 | 0.60 | 4.0 |
| 48 | 150 | 0.18 | 1.0 | 1.69 | 1.19 | 8.0 |
| 60 | 100 | 0.10 | 0.5 | 0.68 | 0.48 | 3.2 |
| 60 | 100 | 0.10 | 1.0 | 1.35 | 0.95 | 6.4 |
| 60 | 150 | 0.14 | 0.5 | 0.68 | 0.48 | 3.2 |
| 60 | 150 | 0.14 | 1.0 | 1.35 | 0.95 | 6.4 |

## K8. 접힘 자세 최소 외접 정사각형 (한계 250). 턴테이블 반경 50, 보스 r20, 포크 길이 129 x 폭 118(손목 기준)
| L | phi=90 | phi=75 | phi=60 | 최적 phi | 최적 변(mm) | 회전각 |
|---|---|---|---|---|---|---|
| 205 | 255 | 285 | 349 | 105 | 248 | 48 |
| 190 | 245 | 277 | 335 | 105 | 237 | 50 |
| 175 | 234 | 270 | 321 | 110 | 226 | 47 |
| 160 | 223 | 262 | 306 | 110 | 214 | 49 |
| 150 | 215 | 257 | 297 | 110 | 207 | 51 |

## K9. 링크 길이 변형 비교 (L=205 PLAN / 190 / 180): 도달과 팔꿈치 원
| L | phi_min (R_손목 332 기준) | 특이점 여유 | 팔꿈치 원 북단 y=240-L | 보스 r20 가장자리 | 중단 phi | 하단 phi |
|---|---|---|---|---|---|---|
| 205 | 35.9 deg | 78 mm | 35 | 15 | 50.2 | 43.5 |
| 190 | 29.1 deg | 48 mm | 50 | 30 | 46.3 | 38.5 |
| 180 | 22.7 deg | 28 mm | 60 | 40 | 43.2 | 34.4 |
