jbj7667/wafer-transfer-robot/docs/arena/C_system.md

# 브레인스토머 C — 시스템·이송 전략·크기 제약 관점

## 0. 아이디어를 내기 전에 정리한 시스템 전제 (계산)

**경기장 거리** (PLAN.md 기하 기준, 출발선 y=870)
- 출발선 → 1행 교차점(500,480): 수평 270 + R100 1/4호 157 + 트렁크 290 = **717**
- 교차점 → 정지선 L: 1행 170 / 2행 220 / 3행 270. 정지선 간: 340 / 440 / 540. 행 간 트렁크: 175
- 예선 표준 경로: 717 + 행1(170+340+170) + 175 + 행2(220+440+220) + 175 + 행3(270+540+270) + 복귀(175+175+717) = **4,774mm**, 그중 **후진 구간은 행마다 L+R = 340/440/540, 합 1,320mm**. 이 후진 거리는 단방향 로봇이든 양방향 로봇이든 같다.
- 0.25m/s로 달리면 주행만 약 19초. 픽/플레이스 6회에 각 4초를 잡으면 24초. 회전 시간은 아래에 따로 계산. 합계 50~60초로 예선 120초 안에 충분히 들어온다. **사이클 시간보다 신뢰성이 훨씬 중요하다.**

**핵심 통찰 1. 방향 전환은 어떤 설계에서도 피할 수 없다.** CD를 집은 포켓은 그 CD가 놓여 있던 베이스 쪽을 향한다. 반대편 베이스에 놓으려면 (a) 차체가 180° 돌거나, (b) 포켓이 차체에 대해 180° 돌거나(포탑), (c) CD를 차체의 앞 끝에서 뒤 끝으로 옮기고, 놓을 때 방향이 상관없게(수직으로 내려놓기, 양끝이 열린 슬롯, 집게 벌리기) 만들어야 한다.
- (a) 단방향 + 교차점 스핀: 행마다 90+180+90 = 360° 회전, 1.2s/90°를 가정하면 행당 약 4.4s, 3행 합 **약 13s**
- (b)/(c) 양방향: 행마다 90+90 = 180° 회전, 3행 합 **약 7s**. 절약되는 시간은 **약 6s(전체의 10%)**뿐이고, 그 대가로 기구 복잡도가 올라간다.

**핵심 통찰 2. 여러 장을 싣고 다녀도(멀티캐리) 얻는 것이 없다.** 각 행은 반드시 양쪽 끝을 모두 방문해야 하므로 행당 2L+2R은 고정이다. 트렁크 왕복도 고정이다. 왼쪽을 모두 모은 뒤 오른쪽에 모두 놓는 순서로 회전 횟수를 다시 세어 봐도 합계는 1,080°로 단일 이송과 같다. **매거진은 무게와 리스크만 늘린다.** 그래서 아이디어에서 제외했다.

**핵심 통찰 3. 본선에서 CD 위치는 원격으로 판정하기 어렵다.** CD는 두께 1.2mm이고 베이스 윗면(200)과 같은 평면에 있다. 교차점에서 수평 IR이나 초음파로 보면 CD가 있든 없든 Ø50 포스트가 똑같이 보인다. 판정이 확실한 방법은 **"한쪽 베이스에 접근하면서 그 자리에서 판정"**하는 것이다. 예를 들어 포크 끝에서 아래를 보는 IR을 달면, CD가 있을 때는 거리가 짧게, 없을 때는 하단 원기둥 윗면(100)까지 측정되어 약 100mm 차이가 난다. 리프트하면서 스위치로 확인하는 방법도 있다. 추측이 틀렸을 때의 추가 경로는 2L이므로 기댓값은 Σ0.5·2L = **660mm(약 3초)**다. 허용할 만한 수준이다.

**핵심 통찰 4. "정지선 = 픽 위치" 기하 규칙.** 엔코더가 없는 DC 구동이므로 정지선을 검출한 뒤 시간으로 더 전진하는 방식은 오차가 크다. 그래서 **라인센서 → 포켓 중심 거리를 정확히 100mm로 설계**해서, 정지선에서 멈춘 그 자리가 곧 픽 위치가 되도록 한다. 이 경우 베이스 하단 원기둥(r50)의 앞 가장자리가 센서보다 50mm 앞에 있다. 따라서 **높이 100 이하에 있는 차체 부품은 센서보다 40mm 이상 앞으로 나와서는 안 된다(±50 규칙)**. 양방향 로봇이면 센서를 바퀴 축 중심에 두고, 높이 100 아래 부품을 앞뒤 ±40mm 안에 모아야 한다.

**핵심 통찰 5. 스핀은 교차점(x=500)에서만 한다.** 포크 끝의 회전 반경이 150~160이면 정지선(베이스에서 100mm) 앞에서 돌다가 베이스를 친다. 3행 교차점(y=130)에서 회전 반경 160으로 돌면 y=-30까지 휩쓸어서 구역 밖으로 나간다. **회전 반경은 130 이하를 목표로 하고, 3행 스핀은 피하는 경로를 쓴다.** 예를 들어 2행 교차점에서 미리 방향을 바꾸거나 3행만 후진으로 진입한다.

**높이**: 같은 행의 두 베이스는 높이가 같고, 높이는 3행(y=130)만 175다. 행마다 미리 알려진 값이므로 높이 센싱은 필요 없다. 승강 범위는 165~215면 충분하고 운용 높이도 250 이하에 들어온다.

## 1. 아이디어 25개

| ID | 이름 | 핵심 원리(1~2문장) | 동작모터(종류×개수) | 175/200 대응 | 시작 250³ 충족 방법 | 원점잡기(초기화) | 정렬 허용오차 추정(mm) | 사이클시간 영향 | 제작난이도 1~5 | 주요 리스크 |
|---|---|---|---|---|---|---|---|---|---|---|
| C01 | 기준형: 전방 U포크 + T8 리드스크류 + 교차점 스핀 | 센서에서 100mm 앞에 U포크 포켓(간격 66)을 두고, 스테퍼+T8(리드 8)로 수직 승강한다. 픽하고 교차점까지 후진한 뒤 180° 스핀, 반대편 정지선까지 전진해서 내려놓는다. | 스테퍼×1 | 스테퍼 스텝 수로 165/190 하강 → +15 상승. 행마다 높이 테이블 사용 | 차체 150 + 포크 돌출 100 = 250. 포크 tine을 위로 접은 상태로 출발하고, 캐리지가 원점으로 내려갈 때 캠이 걸쇠를 풀어 tine이 중력으로 펴진다 | 하단 리밋 스위치(스텝 카운트 기준점) | 횡 ±8(포켓 간격 66 − Ø50) / 종 ±15(포켓 깊이) | 기준(예선 약 55초). 스핀 3회 포함 | 2 | 스핀 중 CD 미끄러짐. 리드스크류 승강이 느림(15mm에 약 0.5s, 높이 이동에 2~3s) → 주행 중에 높이를 미리 맞춰 둔다 |
| C02 | H포크 시소 중력 셔틀(양방향, 스핀 없음) | 앞뒤로 포켓이 있는 H형 tine판(포켓 ±100, 중앙 피벗 높이 210)을 스테퍼가 기울인다. 앞을 들면 픽, 25°까지 기울이면 CD가 PTFE 테이프 위를 미끄러져 뒤 포켓 스토퍼로 가고, 뒤를 숙이면 플레이스. | 스테퍼×1 | 같은 시소각으로 처리. 200행은 ±8°, 175행은 피벗 대비 -35mm라서 ±20° 근처를 쓴다(스텝 테이블) | 양끝 tine을 힌지로 세워 길이 200으로 출발하고, 첫 기울임 때 tine 끝이 스토퍼를 넘으면 스프링으로 펴진다 | 시소각 리밋 스위치 1개(수평 근처 기준) | 횡 ±7(측벽 깔때기 안내 포함) / 종 ±10 | 행마다 스핀이 없어 −6s. 미끄러짐 이송(약 0.5s)은 주행 중에 처리 | 3 | PLA와 폴리카보네이트 사이 마찰각(약 17°)이 들쭉날쭉해서 미끄러짐 시점이 불안정 → 롤러 tine으로 보완. 놓을 때 CD가 기울어진 채 착지 |
| C03 | 대관람차 오버헤드 스윙(벨트 수평유지 곤돌라) | 차체 중앙 상부 피벗(높이 195)에 길이 100의 양팔 요크를 달고, 끝에 곤돌라 tine을 단다. GT2 벨트 1:1 태양 풀리로 곤돌라를 수평으로 유지한다. 앞 수평 위치에서 위로 돌리면 픽, 머리 위를 넘어 뒤 수평 위치에서 내리면 플레이스. tine 두 개는 CD 위 아치로 연결해 양끝을 열어 둔다 | 스테퍼×1 | 수평 근처에서는 팔끝이 거의 수직으로 움직이므로, 175는 -14.5°(=asin(25/100)) 위치를 쓴다 | 팔을 -60°로 내려 곤돌라를 차체 안에 넣은 채 출발 | 팔 각도 리밋(하사점 근처 1개) | 횡 ±8 / 종 ±12(아크 때문에 x가 수 mm 변함) | 스핀 없음 −6s. 넘기는 데 약 1.5s지만 주행 중 수행 | 4 | 벨트 장력과 곤돌라 처짐, 머리 위 회전 중 무게중심이 이동해 전도 위험. 아치 구조가 CD 진입을 막을 수 있음 |
| C04 | 레이지수전 포탑 180° + 소형 승강 | 차체 중앙에 Ø120 레이지수전 베어링(기성품)을 두고, 그 위 회전판에 T8 승강과 반경 100 포크를 단다. 픽 후 포탑을 180° 돌려 후진으로 반대편에 플레이스. 다음 행은 빈 포크가 뒤를 보고 있으므로 후진으로 진입해 픽(교대 운용) | 스테퍼×2(회전 + 승강) | 승강축으로 처리 | 포크를 45° 대각선으로 두면 반경 160 → x,y 각 113으로 들어온다 | 회전·승강 각각 리밋(2축 모두 원점 → 초기화 가점) | 횡 ±8 / 종 ±15(포탑 각도 오차 1°당 횡 1.7mm) | 스핀 없음 −6s. 회전 1s는 주행 중 | 3 | 작년 팀이 겪은 베어링 틀어짐 → 대형 레이지수전 + 3점 롤러로 지지. 포탑 배선 꼬임(±180° 왕복으로만 회전) |
| C05 | 스트래들 캐리어(U차체가 베이스를 감싸 들어감) | 앞이 열린 U자 차체(내폭 135, 바퀴 포드가 좌우에 있음)가 하단 원기둥을 감싸며 들어가서, CD가 차체 지지다각형 안쪽에서 들리도록 한다. 승강은 U 위 브리지에 매단 tine 2개를 리드스크류로 움직인다 | 스테퍼×1 | 승강축으로 처리 | 폭 250(포드 57×2 + 내폭 135), 길이 220 | 하단 리밋 | 횡 ±10(내폭 135 − Ø100 → 좌우 각 17, 포드 벽이 가이드 역할) / 종 ±10 | 기준과 같음(스핀 필요). 무게중심이 안정적이라 스핀을 빠르게 할 수 있어 −1s | 3 | ±50 규칙을 어김: 바퀴가 센서 앞쪽에 있어야 하므로 센서 위치를 따로 설계해야 함. 포드가 베이스를 스치면 베이스가 밀림. 폭이 250으로 꽉 참 |
| C06 | 관통 수평 컨베이어(리프트 없이 슬라이드 온/오프) | 차체 길이 방향으로 TPU 벨트 덱 2줄(포스트 슬롯을 사이에 둠)을 베이스 윗면+0.5 높이에 맞춘다. 위에서 가벼운 핀치롤러로 누르며 돌려 CD를 포스트에서 끌어오고, 뒤 끝에서 반대로 밀어 다음 포스트에 올린다 | 타미야×1(벨트) + 스테퍼×1(덱 높이 선택, 행마다 1회) | 덱 높이를 175.5/200.5로 선택 | 덱 길이 240, 운용 중 변형 없음 | 높이축 하단 리밋 | 횡 ±8 / 종 ±5(벨트 끝을 포스트 가장자리에서 5~10mm 안에 두어야 함 → 포스트 접촉 스위치 필수) | 스핀 없음 −6s. 들어 올리는 동작이 없어 픽/플레이스 각 −1s | 4 | 덱 높이와 베이스 윗면 사이 단차 ±1mm가 성패를 가름(베이스 개체차). 포스트와의 간극이 너무 좁음 |
| C07 | 오버헤드 붐 + 3지 림 그리퍼 | 차체 위 높이 230의 붐이 베이스 위로 100mm 나가 있고, Z 캐리지에 매달린 3지 그리퍼가 CD 외곽(Ø120) 림을 V홈으로 감싸 쥐고 들어 올린다. 아래 공간(100~200)을 쓰지 않으므로 하단 원기둥과 간섭할 일이 없다 | 스테퍼×1(Z) + 서보×1(그립) | Z축으로 처리 | 붐을 접은 상태(힌지)로 출발하고, Z가 원점으로 올라갈 때 펴진다 | Z 상단 리밋(그립 서보는 원점 불필요) | 횡 ±12 / 종 ±12(V홈 손가락이 CD를 끌어당겨 센터링) | 기준과 같음 + 그립 0.5s | 4 | 손가락이 Ø50 포스트 윗면 높이까지 내려가야 림을 잡을 수 있음(CD 두께 1.2). 붐 처짐. 놓는 순간 CD가 베이스를 끌고 갈 수 있음 |
| C08 | 차체 피치 틸트 리프트(고정 포크 + 후방 캐스터 승강) | 포크는 차체에 고정한다. 후방 캐스터를 리드스크류로 오르내려 차체 전체의 피치를 바꾸면 축 앞 150mm의 포켓 높이가 바뀐다. 라인센서를 축 중심에 두면 피치가 변해도 센서 높이가 거의 그대로다 | 스테퍼×1(캐스터) | 피치 ±10°로 ±26mm 범위 → 165~215 대응 | 길이 230, 변형 없음 | 캐스터 상한 리밋 | 횡 ±8 / 종 ±10(피치가 바뀌면 포켓 x가 몇 mm 움직임) | 기준과 같음 | 3 | 피치가 바뀌면 바퀴 접지력과 라인센서 반사 거리가 달라짐. CD가 최대 10° 기운 채 운반됨(백스톱 립 필요) |
| C09 | 2단 고정 tine + 단행정 편심캠 | tine을 165와 190 두 층으로 만들어 두고(층 간격 25 = 행 높이 차), 승강은 편심캠으로 15mm만 한다. 175행은 아래층, 200행은 위층이 CD 밑으로 들어간다 | 타미야×1(캠) 또는 스테퍼×1 | 2단 구조로 높이 이동 자체가 필요 없음 | 길이 240, 변형 없음 | 캠 하사점 리밋(마이크로스위치 + 캠 돌기) | 횡 ±8 / 종 ±15 | 높이 이동이 없어 행마다 −2s(리드스크류 대비) | 1~2 | 175행에서 위층 tine이 CD 위로 15mm 지나가므로 간섭 여유가 작음. 캠의 반복 정밀도. 스핀은 여전히 필요 |
| C10 | 리치 포크(수평 전진 + 포스트 접촉) + 단행정 승강 | 정지선에서 차체가 멈춘 뒤 포크가 리드스크류 X축으로 전진하고, 포켓 바닥 마이크로스위치가 포스트에 닿으면 멈춘다. 종방향 정지 오차를 메커니즘이 흡수하고, 차체는 베이스에서 멀리 떨어져 있다 | 스테퍼×1(X) + 타미야 캠×1(Z, 15mm) | 2단 tine(C09 방식)과 조합 | X를 후퇴시킨 상태로 길이 250 | X 후단 리밋 + 캠 리밋(2축 원점) | 횡 ±8 / **종 ±25(X 스트로크로 흡수)** | 리치 왕복이 픽/플레이스마다 +1.5s | 3 | 포스트 접촉 스위치가 베이스를 미는 일(작동력 0.3N 이하 레버 스위치로 대응). X 가이드 처짐 |
| C11 | 플로팅 V포크 + 포스트 접촉 정지 | 포크 블록이 횡방향 ±12mm로 스프링 센터링된 리니어 부싱 위에 떠 있다. V자 입구로 들어오는 포스트를 따라 포크가 스스로 옆으로 움직이므로(베이스를 미는 대신 포크가 따라감) 정렬이 맞는다. 승강은 T8 | 스테퍼×1 | 승강축으로 처리 | 길이 250 | 하단 리밋 + 포크 중앙 복귀 스위치(진단용) | **횡 ±14** / 종 ±15 | 기준과 같음 | 3 | 스프링 강성 선택이 관건: 너무 강하면 베이스가 밀리고, 너무 약하면 운반 중 흔들림 → 들어 올린 뒤 중앙으로 잠그는 캠 |
| C12 | 센터홀 확장 맨드릴(위에서 꽂기) | 오버헤드 플런저의 원추 팁이 CD 중심구멍(Ø15)으로 들어가며 CD를 끌어당겨 센터링한다. 계속 누르면 볼펜식 푸시-푸시 래치가 TPU 콜릿을 벌려 구멍 벽을 마찰로 잡는다. 다시 누르면 놓는다 | 스테퍼×1(Z) | Z축으로 처리 | 붐을 접은 상태로 출발 | Z 상단 리밋 | 횡 ±7(원추 포착 범위) / 종 ±7 | 픽/플레이스 각 +0.5s | 5 | 구멍 벽이 1.2mm뿐이라 마찰 파지력이 약함. 포스트 윗면이 구멍 바로 밑을 막고 있어 원추 깊이가 0. 래치 신뢰성 |
| C13 | 시저 리프트(낮게 출발 → 상승) | 차체 위 2단 시저를 수평 리드스크류로 펼쳐 포크를 120~215로 올린다. 무게중심이 낮고 접었을 때 높이가 매우 작아 시작 부피(동점 기준)에서 유리하다 | 스테퍼×1 | 시저 높이로 처리 | 접힌 높이 130 → 시작 부피 최소(동점 기준 ③) | 수평 너트 리밋 | 횡 ±8 / 종 ±15 | 기준과 같음. 높은 위치 근처에서 기계적 이득이 나빠져 느림 | 3 | 시저 핀이 누적시키는 유격 때문에 포크 끝이 흔들림(관찰된 랙 유격과 같은 문제가 반복됨) |
| C14 | 실 윈치 중력 마스트 + 전륜(포크측) 구동 | 수직 레일 캐리지를 타미야 스풀이 실로 끌어올리고 내릴 때는 중력을 쓴다. 구동륜을 포크 쪽(앞)에 두고 배터리를 뒤에 둬서 카운터웨이트로 쓴다 | 타미야×1 | 스풀 회전 시간과 엔드스위치로 처리 | 길이 220 | 하단 리밋(실을 감기 전 기준) | 횡 ±8 / 종 ±15 | 기준과 같음 | 2 | 실이 늘어나고 스풀에 감긴 지름이 변해 높이 반복성이 ±3. 내려갈 때 걸림 → 높이 인코더 대신 상·하 리밋 2개로 처리 |
| C15 | CoreXZ 갠트리 전후 이송 | 차체 길이 방향 상부에 두 스테퍼와 벨트 1루프(CoreXY를 XZ 평면에 적용)로 X와 Z를 동시에 움직이는 포크 캐리지를 둔다. 앞에서 픽 → X로 뒤로 이동 → 뒤 베이스 위에서 수직으로 내림 → 포크를 바깥쪽(-X)으로 빼낸다. 종방향 정지 오차는 X로 보정한다 | 스테퍼×2 | Z로 처리 | 레일 220, 포크는 레일 안쪽에 들어가 있음 | X, Z 리밋(2축 원점) | 횡 ±8 / 종 ±25(X 보정) | 스핀 없음 −6s, 빼내기 +1s | 4 | 플레이스 때 포크를 베이스 뒤쪽 바깥으로 빼므로 3행 왼쪽(x=130)에서 구역 경계에 근접. 벨트 장력과 강성 |
| C16 | 상승-협지 포크(Lift-to-clamp) | T8로 CD를 들어 올리면 포크 위에 고정된 TPU 패드판에 CD가 닿아 눌려 고정된다. 패드판 뒤의 마이크로스위치는 CD 존재 판정 겸 '충분히 올라감' 신호로 쓴다. 들어 올렸는데 스위치가 안 눌리면 CD가 없다는 뜻 → 본선 판정 | 스테퍼×1 | 승강축으로 처리. 협지 높이는 높이와 무관(스위치에 닿을 때까지 상승) | 길이 250 | 하단 리밋(+ 협지 스위치로 이중 확인) | 횡 ±8 / 종 ±15 | 스핀을 빠르게 할 수 있어(CD가 고정됨) −2s. 판정에 추가 시간 없음 | 2 | 패드판이 CD 진입을 막지 않도록 포켓 위 간극을 15mm 이상 확보. 협지력이 과하면 스텝 탈조 → 스위치가 눌리면 즉시 정지 |
| C17 | 원웨이 분기 1모터(정회전 = 크랭크 승강, 역회전 = 포탑 180° 인덱싱) | 모터 1개의 출력에 원웨이 베어링 2개를 반대 방향으로 단다. 정회전은 크랭크를 돌려 단행정 승강(1회전 = 오르고 내림)을 하고, 역회전은 제네바 휠로 포탑을 정확히 180°씩 인덱싱한다 | 타미야×1 또는 스테퍼×1 | 2단 tine(C09)과 조합 | 포크를 45° 대각선으로 두고 출발 | 크랭크 하사점 스위치 + 포탑 0/180 스위치 | 횡 ±8 / 종 ±15(제네바 위치 정밀도 좋음) | 스핀 없음 −6s | 4 | 원웨이 베어링(HF0612 등) 슬립. 포탑 회전 중 크랭크가 백드라이브됨. 기어 배치 설계가 어려움 |
| C18 | GT2 벨트 고속 승강 + 포크 끝 하향 IR(판정·종보정) | 스테퍼 벨트 승강(50mm/s)을 쓰고 높이 이동은 주행 중에 끝낸다. 포크 끝에 아래를 보는 GP2Y0A41을 달아, 접근하는 동안 하단 원기둥 가장자리를 검출해 종방향 위치를 맞추고 CD 유무를 판정한다(차이 약 100mm). 없으면 끝까지 넣지 않고 바로 반대편으로 출발 | 스테퍼×1 | 벨트 승강으로 처리 | 길이 250 | 하단 리밋 | 횡 ±8 / 종 ±8(IR로 보정) | 높이 이동 0s, 오판 시 손실도 줄어 본선 기대값 −2s | 2 | IR 최소거리 40mm 때문에 장착 높이 조정 필요(CD까지 40mm 이상). 벨트 승강은 정지 상태 유지에 전류 필요(자체 잠금 없음) → 카운터 고무줄 |
| C19 | SCARA 상부 2관절 암 | 차체 중앙의 어깨와 팔꿈치 2관절로 포크를 앞(+100)이나 뒤(-100)로 보낸다. 팔꿈치를 조합해 횡 ±10 보정이 가능하고, 놓은 뒤 빼내는 방향도 자유롭다 | 스테퍼×2(관절) + 스테퍼×1(Z) = 3 | Z로 처리 | 팔을 접은 상태 160×160 | 3축 리밋 | 횡 ±15(능동 보정, 측정은 라인센서 3ch로 거칢) / 종 ±20 | 스핀 없음 −6s, 관절 이동 +1s | 5 | 3모터를 모두 쓰므로 여유가 없음. 횡 오차를 정밀하게 잴 센서가 없어 능동 보정의 이점이 반감됨. 캔틸레버 처짐 |
| C20 | 상부 피드롤러(프린터식) | 베이스 윗면 높이에 맞춘 고정 트레이를 포스트 바로 앞에 붙이고, TPU 롤러를 CD 윗면에 내려 굴려서 CD를 포스트에서 트레이로 끌어온다. 놓을 때는 역회전으로 밀어 올린다. 롤러는 레버에 달려 자중으로 누른다 | 타미야×1(롤러) + 서보×1(트레이 높이 175/200 선택, 행마다) | 트레이 2위치 | 길이 240 | 롤러는 원점 불필요, 트레이 서보만 사용(초기화 가점 X) → 트레이에 리밋 스위치를 달고 DC로 구동하면 가점 가능 | 횡 ±10 / 종 ±6(트레이 끝 ↔ 포스트 간극) | 픽/플레이스 각 −1s(들기 없음), 스핀 필요 | 3 | 단차와 간극이 C06과 같은 문제. 롤러 압력 때문에 CD가 미끄러지면서 기울어짐 |
| C21 | 횡방향 V홈 집게 | CD 평면 높이에서 좌우 팔(y=±70)이 앞으로 나와 있고, V홈 턱이 CD 림을 양옆에서 물어 센터링한 뒤 Z로 들어 올린다. 턱이 일찍 멈추면 CD가 있다는 뜻 → 판정 겸용 | 서보×1 또는 타미야×1(집게) + 스테퍼×1(Z) | Z로 처리 | 팔을 접어 길이 250 | Z 하단 리밋 + 집게 열림 리밋 | **횡 ±15(V홈이 CD를 끌어옴)** / 종 ±10 | 집게 동작 +0.5s, 스핀 필요 | 3 | V홈 상하 허용치가 ±2로 작음(CD 1.2t) → 높이 정확도가 필요. CD를 옆으로 끌면 포스트가 기울어지는 마찰 |
| C22 | 측면집게 + 전후 레일 셔틀 | C21의 집게를 길이 방향 레일 캐리지에 단다. 앞에서 물고 들어 올린 뒤 레일로 뒤까지 옮기고, 후진해서 뒤 베이스 위에서 내리며 벌린다. 집게는 벌리기만 하면 놓아지므로 포켓 방향 문제가 없다 | 서보×1(집게) + 스테퍼×2(X, Z) = 3 | Z로 처리 | 레일 220, 팔 접음 | X, Z 리밋 | 횡 ±15 / 종 ±20(X 보정) | 스핀 없음 −6s | 4 | 모터 3개를 모두 씀. 질량과 배선이 늘어남. C21의 V홈 높이 민감성을 그대로 이어받음 |
| C23 | 평행링크 아크 리치-리프트 | 길이 120의 평행링크(포크 수평 유지)를 -60°(후퇴·저위)에서 0°(최대 리치)까지 돌린다. 포크는 전진하면서 CD 밑으로 들어가고 +8°에서 들어 올린다. 모터 1개로 리치와 승강을 함께 하고, 정지·스핀할 때는 포크가 접혀 있다 | 스테퍼×1(+웜 감속) 또는 타미야×1 + 각도 리밋 | 175는 θ=-12° 근처, 200은 0° 근처(x 차이 3mm) | 후퇴 상태에서 길이 200, 시작 부피가 작음 | 각도 하한 리밋 | 횡 ±8 / 종 ±20(리치량 조정) | 스핀 시 회전 반경이 작아(포크 접힘) 3행 스핀이 가능 | 2~3 | 링크 핀 유격이 4개 핀에 누적됨 → 금속 핀 + 부싱. 아크 궤적이 정지 오차와 결합해 포켓 깊이가 변함 |
| C24 | 스크류-래칫 포탑(1스테퍼로 승강 + 180°) | 중앙 T8 스크류의 너트 캐리지(반경 100 포크)를 고정 슬리브의 0°/180° 수직 슬롯이 안내한다. 정회전하면 상승하고, 꼭대기에서 톱니형 도그클러치에 물려 캐리지가 함께 180° 돈다. 역회전하면 반대편 슬롯으로 하강한다. 래칫이 역회전을 막는다 | 스테퍼×1 | 슬롯 안에서는 스텝 수로 임의 높이 가능 | 포크를 꼭대기 원주홈 45° 위치에 두고 출발(대각선이라 들어옴) | 하단 리밋 + 슬롯 진입 확인 스위치 | 횡 ±8 / 종 ±15(슬롯 각도 고정이라 포탑 위치 정밀) | 스핀 없음 −6s, 행마다 앞뒤 교대로 쓰므로 빈 회전 0회 | 4 | 도그클러치 진입 타이밍, 원주홈 안 래칫 마찰. 캔틸레버 포크 처짐 → 슬리브 외경 40 이상, 가이드 롤러 |
| C25 | 틸트-수납 포크(CD 수직 보관) | 포크를 앞 하부 피벗에 대해 -90°(아래로 접힘)~0°(수평 픽)~+90°(위로 세움)로 돌린다. 들어 올리면 CD가 tine을 타고 피벗 쪽 홈으로 미끄러져 세로로 서서 보관되므로 스핀 중에도 빠지지 않는다. 놓을 때는 수평으로 되돌린다 | 스테퍼×1(웜 감속) | 2단 tine(165/190, C09 방식)을 함께 회전 | 아래로 접은 상태로 길이 160, 높이 200 | 각도 리밋(-90°) | 횡 ±8 / 종 ±12 | 스핀을 빠르게 할 수 있어 −2s, 수납·전개 +1s | 3 | 수평으로 되돌릴 때 CD가 홈에서 tine 위로 다시 미끄러져 포켓 위치로 돌아와야 함(위치 편차) → 되돌릴 때 CD 끝을 받치는 스토퍼를 tine 끝에 둔다 |

## 2. 내 관점 상위 5개

1. **C16 상승-협지 포크**: 모터 1개로 승강, CD 고정(스핀 시 이탈 방지), 본선 존재 판정(스위치)을 모두 해결한다. 신뢰성 30점 항목을 가장 직접적으로 겨냥한다. 단방향 + 교차점 스핀의 단순한 구조를 유지하면서, 스핀이 약점이라는 문제를 협지로 막는다.
2. **C09 2단 고정 tine + 단행정 캠**: 행 높이 차 25mm를 형상으로 흡수하므로 승강 행정이 15mm로 줄어든다. 랙 유격 문제가 원천적으로 사라지고 제작 난이도가 가장 낮다. 1인 4주 일정에 가장 안전하다. C16의 협지판과도 조합할 수 있다.
3. **C24 스크류-래칫 포탑**: 스테퍼 1개로 승강과 180° 전환을 모두 해서 행마다 스핀이 없다(−6s). 앞뒤를 교대로 쓰므로 빈 회전도 없다. 슬롯이 포탑 각도를 기계적으로 고정하므로 작년 팀의 포탑 틀어짐 문제도 피한다. 창의성 점수가 크다. 대신 도그클러치 시제품 검증이 필요하다.
4. **C18 벨트 승강 + 포크 끝 하향 IR**: 시스템 수준의 이득이 크다. 높이 이동을 주행 중에 끝내므로 0s이고, IR로 정지 오차를 보정해 종방향 ±8이 되며, 본선 오판 비용도 줄인다. IR을 한 개만 쓰면서 판정과 정렬을 겸한다.
5. **C23 평행링크 아크 리치-리프트**: 모터 1개로 리치와 승강을 함께 한다. 접힌 상태로 출발하고 접은 채 스핀하므로 시작 부피(동점 기준)와 회전 반경(3행 y=130 스핀 시 구역 이탈) 문제를 동시에 해결한다.

## 3. 다른 관점과 결합하면 좋은 메모

- **기본 시스템 골격(어떤 메커니즘에도 적용)**: 라인센서는 축 중심에서 30~40mm 앞에 두고, 센서 → 포켓 거리는 정확히 100으로 한다. 높이 100 이하 부품은 센서보다 40mm 이상 앞으로 내밀지 않는다(±50 규칙). 스핀은 x=500 교차점에서만 한다. 행 높이는 테이블로 처리한다(3행만 175).
- **2단 tine(C09)은 '부품'처럼 쓸 수 있다**: 리프트 메커니즘 관점(A/B) 아이디어 어디에 붙여도 높이 이동이 없어진다. 단, 175행에서 위층 tine과 CD 사이 간격 15mm를 반드시 확보해야 한다.
- **판정 전략**: 원격 판정은 포기하고 "가까운 쪽을 먼저 확인"한다(기댓값 손실 약 3s). 판정 수단으로는 C16(협지 스위치)이나 C18(하향 IR)을 쓴다. 들어 올린 뒤에야 판정하는 방식(C16)은 오판 시 승강 1회(약 1s)를 더 잃는다.
- **양방향 계열(C02/C03/C04/C15/C17/C22/C24)이 절약하는 시간은 최대 약 6s**다. 예선 시간 여유가 60초 이상이므로, 이 계열은 창의성 점수를 노리는 2차 개선 경로로 두는 것이 합리적이다. 1차는 C16+C09 단방향으로 완주부터 확보한다.
- **전원 노이즈**: 리셋이 관찰되었다. 스테퍼 1개 구성은 L298 DC 승강보다 노이즈가 적다. 모터 팩과 제어 팩을 분리하고 모터 단자에 0.1µF를 다는 것은 메커니즘 선택과 무관하게 필수다.
- **오프라인 지름길(라인 이탈 대각선 주행)**: 예선에서 행 사이를 대각선으로 이동하면 약 140mm 절약된다. 규정상 허용되는지 불명확하고, 엔코더가 없으면 위험하므로 비추천이다.
