jbj7667/wafer-transfer-robot/cad/arm/L180_folded_iso.png

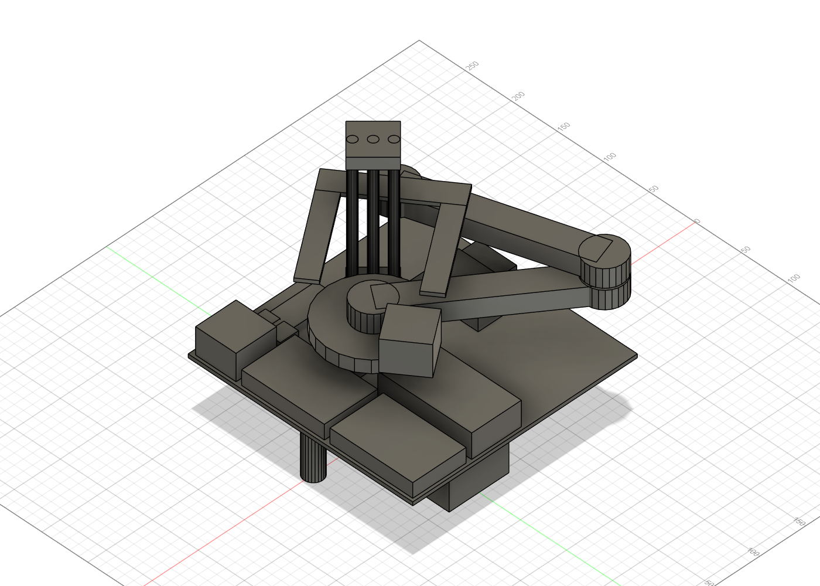
cad/arm/L180_folded_iso.png
