jbj7667/wafer-transfer-robot/cad/arm/L180_folded_top.png

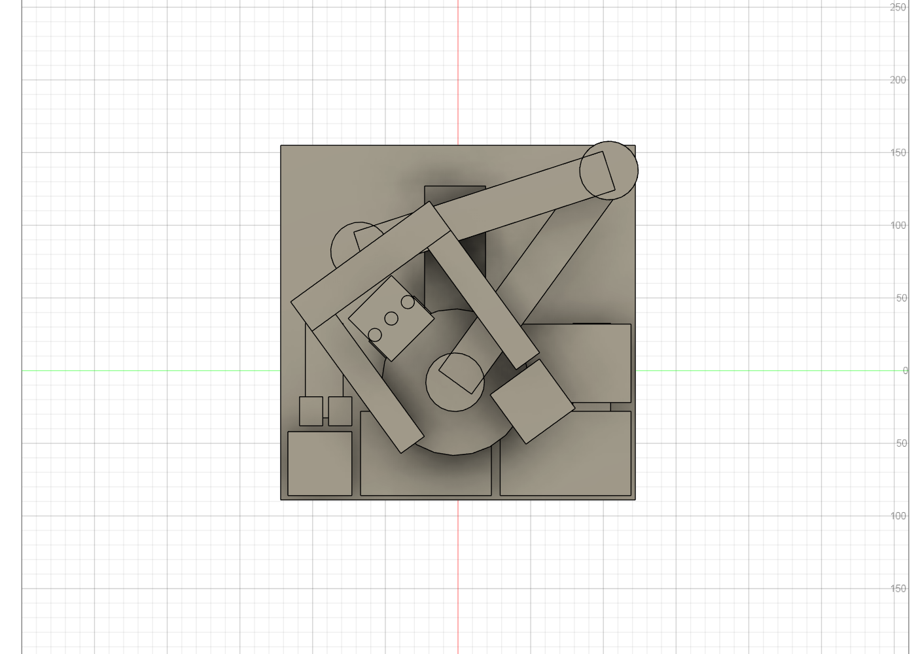
cad/arm/L180_folded_top.png
