jbj7667/wafer-transfer-robot/cad/arm/L180_reach_b5_iso.png

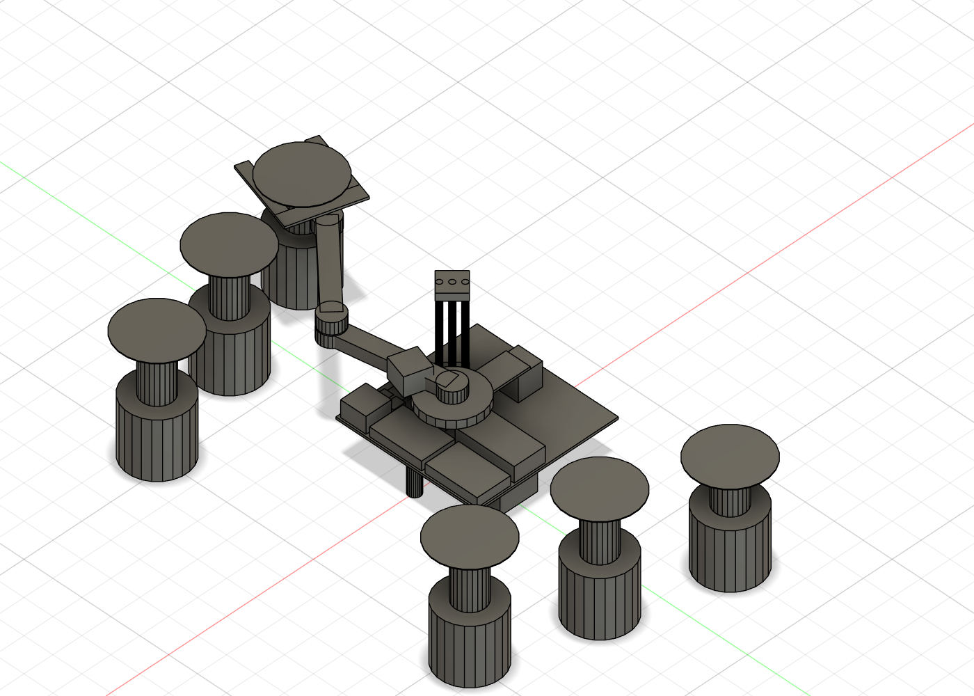
cad/arm/L180_reach_b5_iso.png
