jbj7667/wafer-transfer-robot/cad/arm/L180_reach_b5_top.png

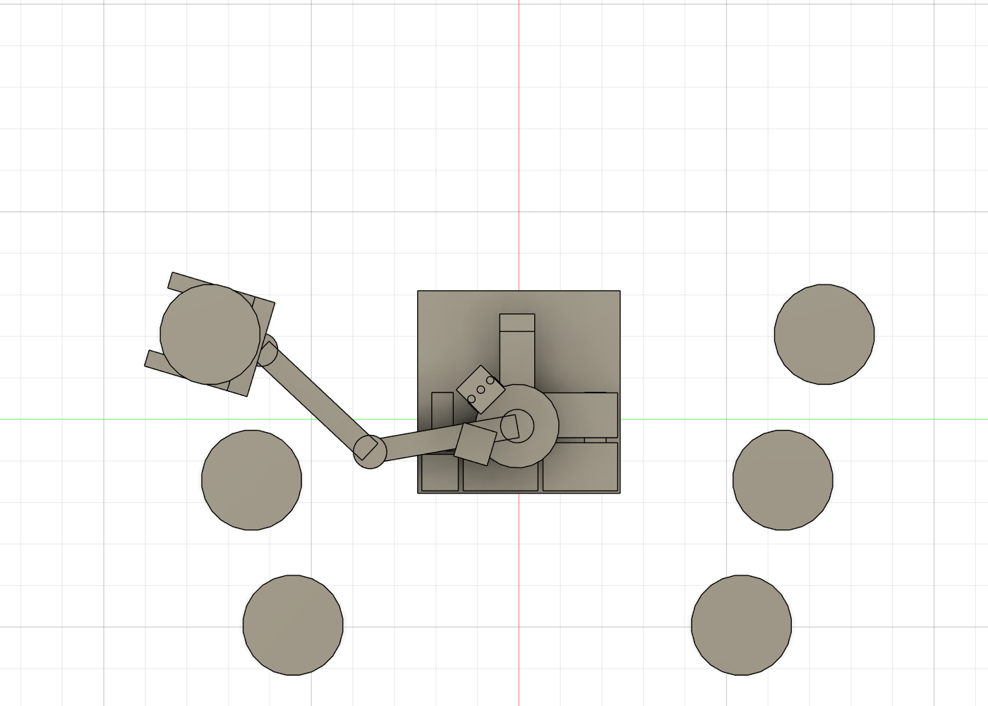
cad/arm/L180_reach_b5_top.png
