jbj7667/wafer-transfer-robot/cad/arm/L190_folded_iso.png

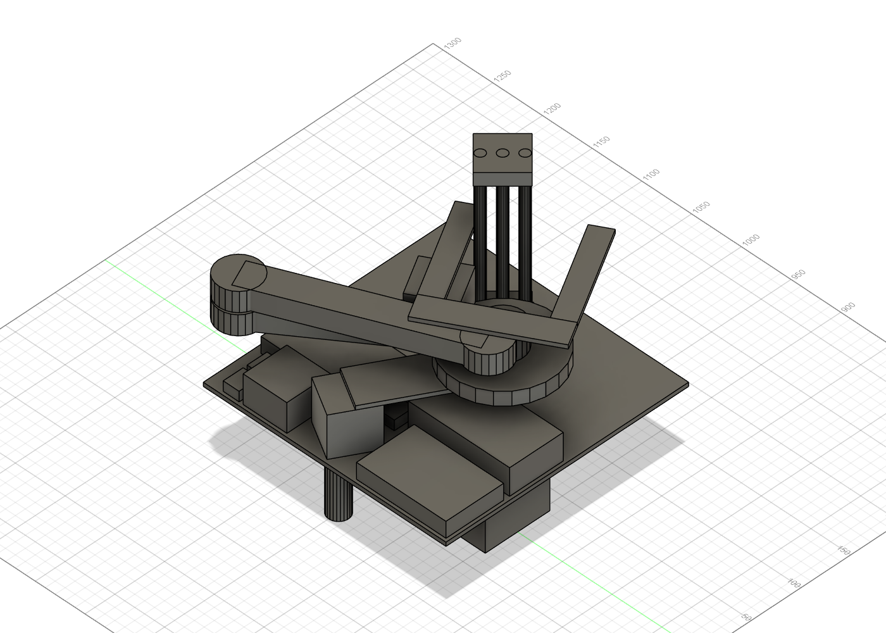
cad/arm/L190_folded_iso.png
