jbj7667/wafer-transfer-robot/cad/arm/L190_folded_top.png

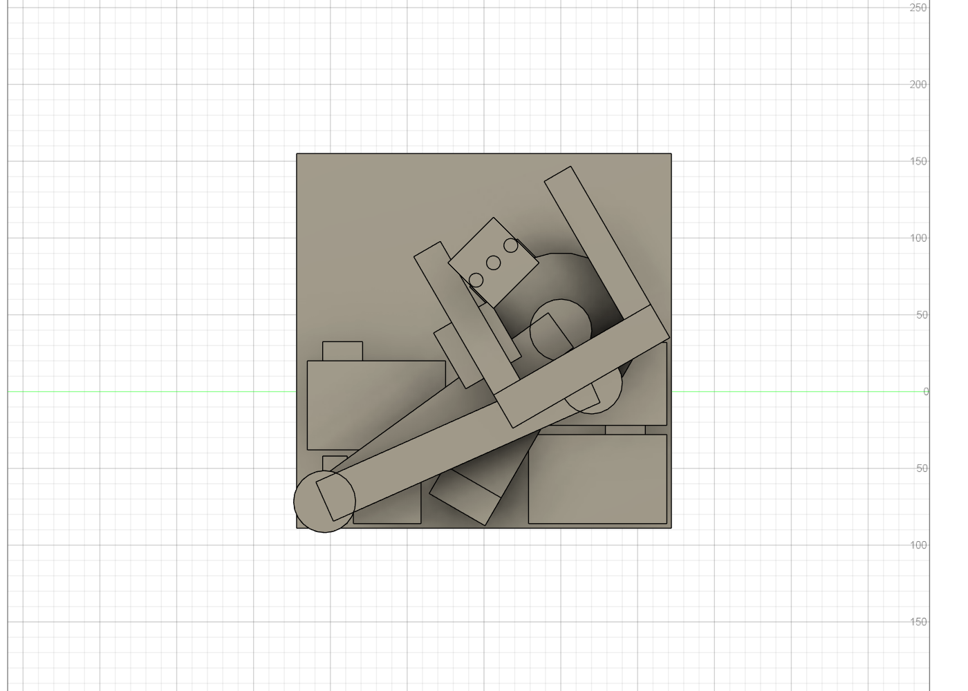
cad/arm/L190_folded_top.png
