jbj7667/wafer-transfer-robot/cad/arm/L190_reach_b5_iso.png

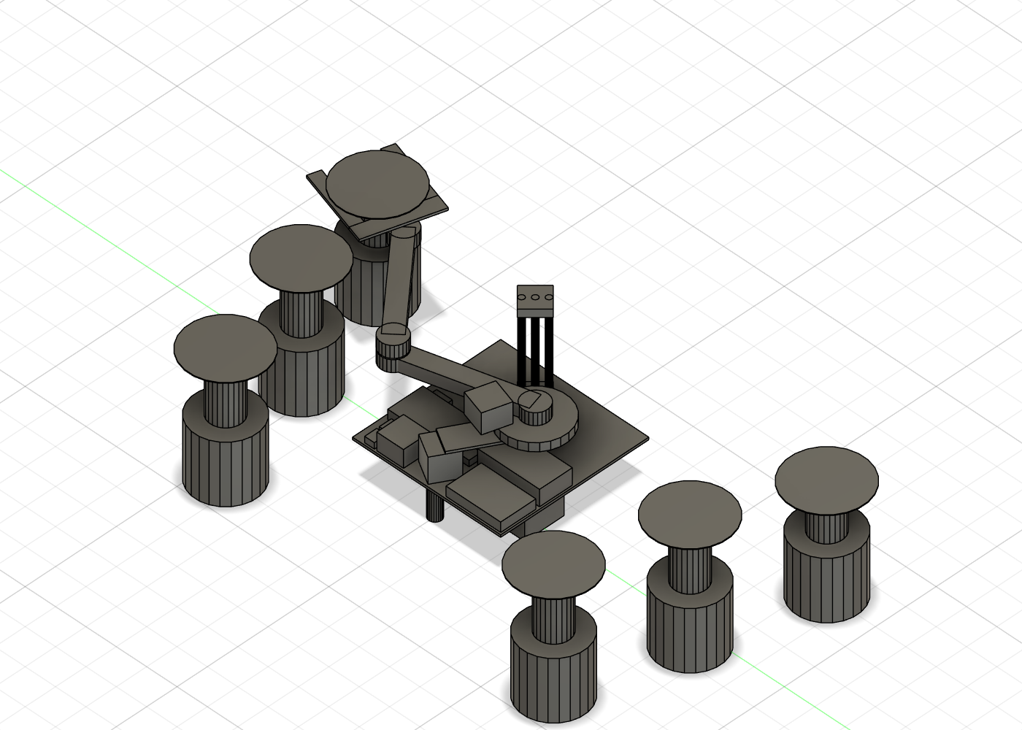
cad/arm/L190_reach_b5_iso.png
