jbj7667/wafer-transfer-robot/cad/arm/L190_reach_b5_top.png

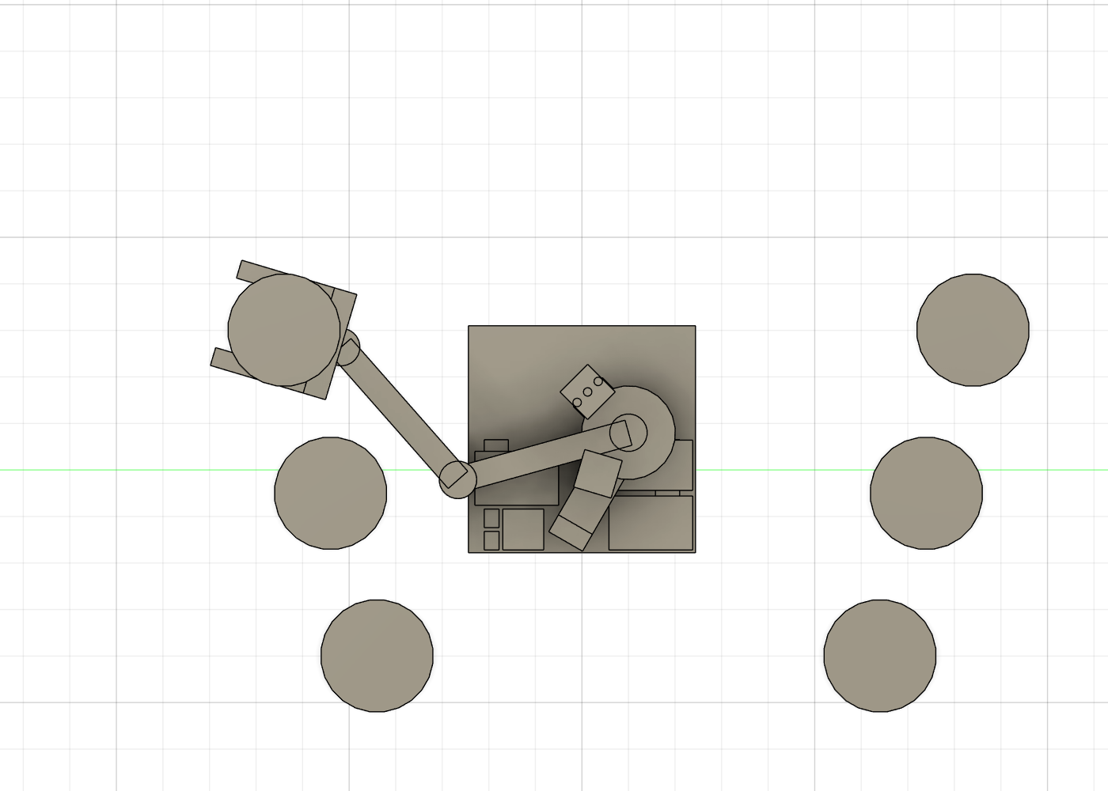
cad/arm/L190_reach_b5_top.png
