jbj7667/wafer-transfer-robot/cad/arm_bench/bench_folded_iso.png

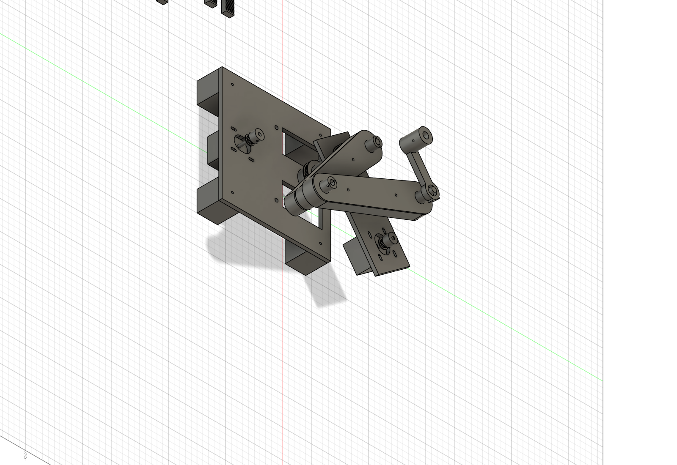
cad/arm_bench/bench_folded_iso.png
