jbj7667/wafer-transfer-robot/cad/arm_bench/bench_folded_top.png

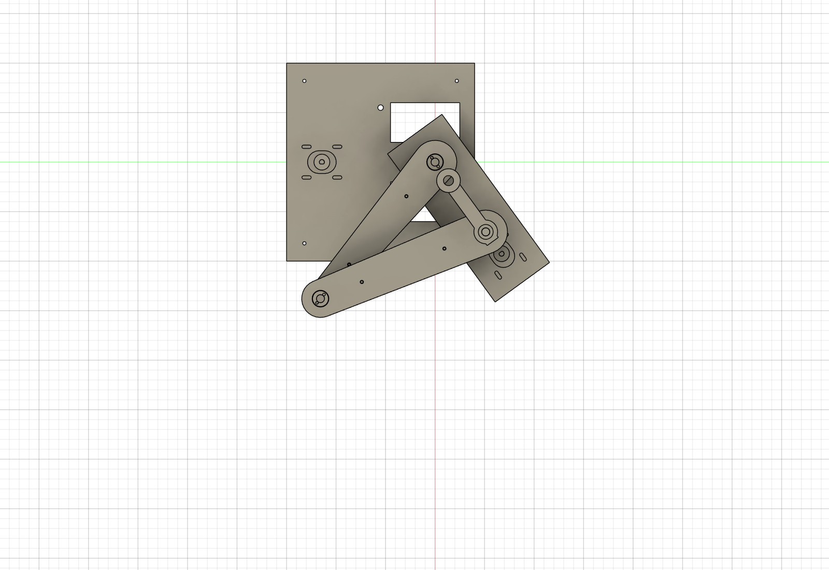
cad/arm_bench/bench_folded_top.png
