jbj7667/wafer-transfer-robot/cad/arm_bench/bench_reach_iso.png

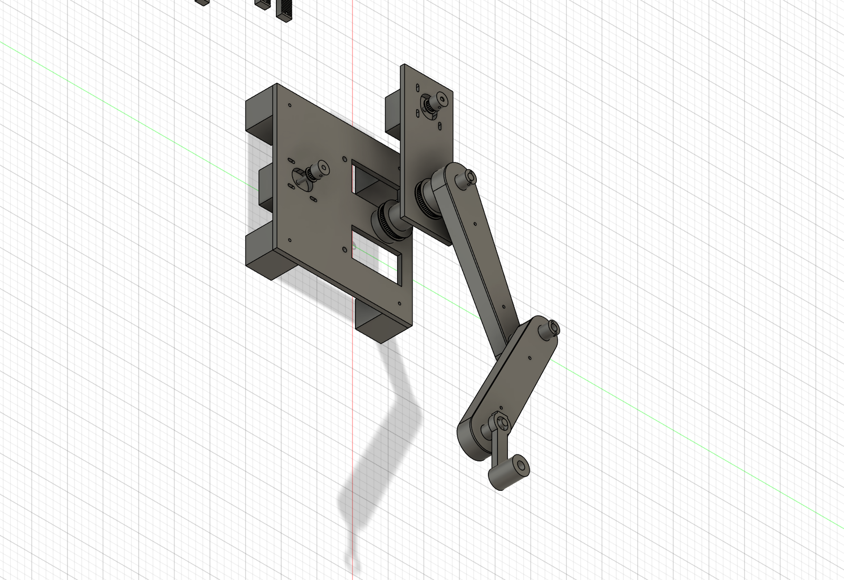
cad/arm_bench/bench_reach_iso.png
