jbj7667/wafer-transfer-robot/cad/model/view_front.png

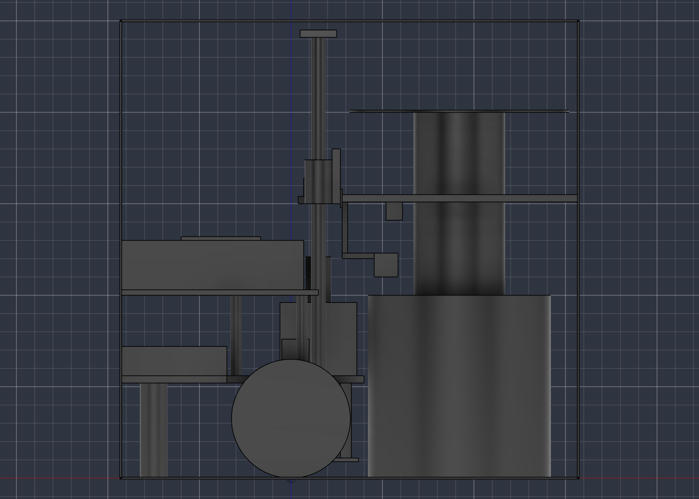
cad/model/view_front.png
