jbj7667/wafer-transfer-robot/cad/model/view_right.png

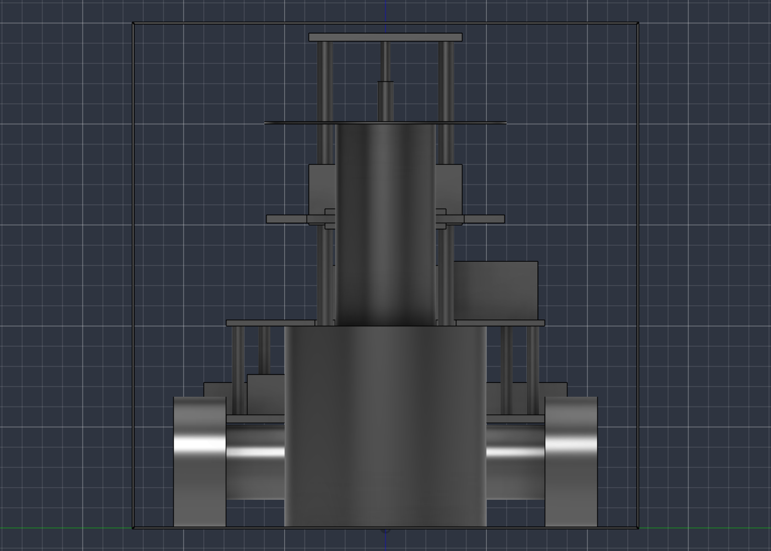
cad/model/view_right.png
