jbj7667/wafer-transfer-robot/cad/model/view_top.png

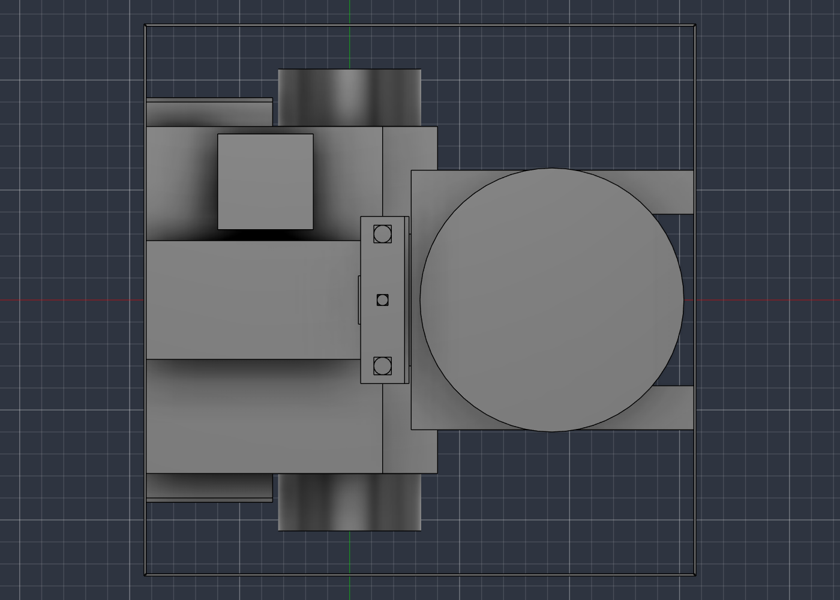
cad/model/view_top.png
