jbj7667/wafer-transfer-robot/docs/design/bom.md

# 부품 명세서 (BOM) — 확정안 v1

- 기준일: **2026-10-26** (가격 기준일). 기구는 `mechanism.md`(단일 승강축 와이드 C-링 포크 + 넥 접촉 정지)를 따른다.
- 규정: 사비 구매 부품 합계 **120,000원 이하**, 영수증 전부 첨부. 허위 기재는 실격.

> **가격 신뢰도 주의 (필독)**
> 2026-10-26에 웹검색(standard)으로 국내 쇼핑몰(디바이스마트·엘레파츠·아이씨뱅큐·11번가·쿠팡·알리 KR) 가격을 조회했으나, 검색 도구가 해당 쇼핑몰 상품 페이지의 원화 가격을 거의 반환하지 못했다.
> 확인된 국내 실가격 단서는 쿠팡의 리밋 스위치 개당 약 500원(배송비 3,000원 별도, 모델 미특정), PETG 1kg 약 8,800원(표시 정가 25,000원, 날짜 불확실) 두 건뿐이다.
> 따라서 아래 단가는 **추정치(보수적으로 높게 잡음)**이다. 주문 시점에 URL(검색 페이지)에서 실가격을 확인해 `확정가` 칸을 채우고 합계를 다시 계산한다. 합계가 추정치로도 한도의 약 69%이므로 실가격 편차를 흡수한다.

## (a) 지급품 사용 목록 (사비 아님)

| 부품 | 수량 | 용도 |
|---|---|---|
| Arduino Mega 2560 + IO 쉴드 | 1 | 제어기 |
| DC 기어모터 (Ø37) | 2 | 좌·우 구동 |
| 스테퍼 SF2421 + 브래킷 | 1 | 승강 (동작 모터 1개, 규정 상한 3개 중) |
| 모터 드라이버 L298 | 1 | DC모터 구동 |
| 스테퍼 드라이버 DRV8834 | 1 | 승강 스테퍼 (A4988 대체 지급품) |
| 라인센서 (3채널 디지털) | 1 | 라인추종·이벤트 |
| IR 거리센서 GP2Y0A41SK | 1 (최대 3) | 상향 웨이퍼 감지 |
| 초음파 HC-SR04 | 1 (최대 3) | **기본 구성 미장착(선택, v1.1e)** — 설치 자리에서 베이스를 겨냥할 수 없음. 지급품은 보관 |
| BLE 모듈 HM-10 | 1 | 스마트폰 출발·전압 표시 |
| AA 홀더 6셀 ×2, 건전지(제어), 충전지(모터) | 각 1 | 전원 (팩 분리) |
| 전원 스위치 | 2 | 팩별 스위치 |
| LED·스위치 모듈 | 필요량 | 외관 LED 등 (사비 LED 대체 가능) |

## (b) 사비 구매 목록

| # | 품목 (규격) | 단가(원) | 수량 | 소계(원) | 구매처/URL (검색 페이지) | 확정가 |
|---|---|---:|---:|---:|---|---|
| 1 | T8 리드스크류 **100mm** (리드 8, 4조) + 황동 플랜지 너트 — 150 이상은 마스트가 250 초과(`cad/params.md`) | 9,000 | 1 | 9,000 | [디바이스마트](https://www.devicemart.co.kr/goods/search?keyword=T8%20%EB%A6%AC%EB%93%9C%EC%8A%A4%ED%81%AC%EB%A5%98) · [11번가](https://search.11st.co.kr/Search.tmall?kwd=T8%20%EB%A6%AC%EB%93%9C%EC%8A%A4%ED%81%AC%EB%A5%98) | |
| 2 | 커플러 5→8mm (스테퍼축 Ø5 ↔ T8) | 2,000 | 1 | 2,000 | [쿠팡](https://www.coupang.com/np/search?q=%EC%BB%A4%ED%94%8C%EB%9F%AC%205mm%208mm) | |
| 3 | Ø8 리니어 샤프트 **190mm** (200 구매 후 절단 가능) | 3,000 | 2 | 6,000 | [아이씨뱅큐](https://www.icbanq.com/search?keyword=%EB%A6%AC%EB%8B%88%EC%96%B4%20%EC%83%A4%ED%94%84%ED%8A%B8%208mm) | |
| 4 | LM8UU 리니어 부싱 | 1,000 | 2 | 2,000 | [엘레파츠](https://www.eleparts.co.kr/goods/search?search_text=LM8UU) | |
| 5 | KW11 레버 마이크로 스위치 (하한 원점·상한·예비) | 700 | 3 | 2,100 | [디바이스마트](https://www.devicemart.co.kr/goods/search?keyword=KW11) | |
| 6 | 저작동력 롱레버 마이크로 스위치 (넥 접촉용, 레버 길이 연장 가능형) | 1,500 | 1 | 1,500 | [디바이스마트](https://www.devicemart.co.kr/goods/search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) | |
| 7 | 소형 볼 캐스터 | 2,500 | 1 | 2,500 | [쿠팡](https://www.coupang.com/np/search?q=%EB%B3%BC%EC%BA%90%EC%8A%A4%ED%84%B0%20%EC%86%8C%ED%98%95) | |
| 8 | 바퀴 Ø65 (6mm D축) 1쌍. 허브 불일치 시 출력 허브 + O링으로 대체 | 6,000 | 1쌍 | 6,000 | [디바이스마트](https://www.devicemart.co.kr/goods/search?keyword=65mm%20%EB%B0%94%ED%80%B4) | |
| 9 | 패널형 푸시 버튼 12mm (출발 스위치) | 1,500 | 1 | 1,500 | [엘레파츠](https://www.eleparts.co.kr/goods/search?search_text=12mm%20%ED%91%B8%EC%8B%9C%EB%B2%84%ED%8A%BC) | |
| 10 | 5mm LED + 저항 (330Ω 등) 세트 | 1,500 | 1 | 1,500 | [엘레파츠](https://www.eleparts.co.kr/goods/search?search_text=5mm%20LED) | |
| 11 | 콘덴서: 100µF/25V 전해 ×3, 0.1µF 세라믹 ×10 | 1,500 | 1 | 1,500 | [엘레파츠](https://www.eleparts.co.kr/goods/search?search_text=100uF%2025V) | |
| 12 | 분압 저항 20kΩ ×2, 10kΩ ×2 (1% 권장) | 800 | 1 | 800 | [엘레파츠](https://www.eleparts.co.kr/goods/search?search_text=20k%20%EC%A0%80%ED%95%AD) | |
| 13 | M3 열압입 인서트 ×50 (길이 4~5.7mm) | 5,000 | 1 | 5,000 | [쿠팡](https://www.coupang.com/np/search?q=M3%20%EC%97%B4%EC%95%95%EC%9E%85%20%EC%9D%B8%EC%84%9C%ED%8A%B8) · [알리 KR](https://ko.aliexpress.com/wholesale?SearchText=M3+heat+set+insert) | |
| 14 | M3 볼트·와셔 모음 (6~20mm) | 4,000 | 1 | 4,000 | [쿠팡](https://www.coupang.com/np/search?q=M3%20%EB%B3%BC%ED%8A%B8%20%EC%84%B8%ED%8A%B8) | |
| 15 | 필라멘트 사용분 PETG/PLA 약 600g (단가 25원/g 산입) | 25 | 600g | 15,000 | [쿠팡](https://www.coupang.com/np/search?q=PETG%20%ED%95%84%EB%9D%BC%EB%A9%98%ED%8A%B8%201kg) | |
| 16 | 배선 재료 (점퍼선, 열수축, 터미널, 케이블타이) | 3,000 | 1 | 3,000 | [엘레파츠](https://www.eleparts.co.kr/goods/search?search_text=%EC%A0%90%ED%8D%BC%EC%84%A0) | |
| 17 | 배송비 (3곳 가정) | 3,000 | 3 | 9,000 | 각 쇼핑몰 | |
| 18 | 예비품 (스위치·샤프트·캐스터·인서트 추가분) | 10,000 | 1 | 10,000 | — | |
| | **합계** | | | **82,400** | | |

- 필라멘트 근거: 실제 구매 영수증은 1kg 롤 단위(쿠팡 PETG 1kg 약 9천~2만 원대)일 수 있다. 영수증에는 롤 전체 금액이 찍히므로 **영수증 금액 기준 합계로 다시 계산**한다. 롤 전체가 20,000원이어도 합계 약 87,400원으로 한도 내.
- 합계 계산: 9,000 + 2,000 + 6,000 + 2,000 + 2,100 + 1,500 + 2,500 + 6,000 + 1,500 + 1,500 + 1,500 + 800 + 5,000 + 4,000 + 15,000 + 3,000 + 9,000 + 10,000 = **82,400**

### 한도 대비 여유

| 항목 | 금액(원) |
|---|---:|
| 사비 한도 | 120,000 |
| 추정 합계 | 82,400 |
| **여유** | **37,600 (한도의 31%)** |
| 보수적 상한 (모든 단가 +30%, 필라멘트 롤 전체 20,000원 영수증 처리) | 약 107,000 → 여전히 한도 내 |

선택 보류 항목: TB6612FNG(약 5,000원) — Q2(드라이버 사용 가능 여부) 승인 및 L298 속도 부족 확인 시에만 구매.

## (c) 3D 프린트 부품 목록

모델 이름은 `docs/design/fusion_guide.md`의 부품명과 맞춘다(해당 문서가 확정되면 이름을 재확인). 무게는 슬라이서 결과 확정 후 기입(TBD).

| 부품 | 재질 | 수량 | 무게(g) | 비고 |
|---|---|---:|---|---|
| 섀시 하판 | PETG | 1 | TBD | 모터 마운트·캐스터 |
| 전장 데크 (Mega·배터리 적층) | PETG | 1 | TBD | |
| 마스트 (리드스크류·가이드봉 지지, 하한/상한 스위치 마운트) | PETG | 1 | TBD | 높이 ≤ 245 |
| 캐리지 (LM8UU ×2 + 너트 홀더 + IR 마운트) | PETG | 1 | TBD | |
| 포크 (U 내폭 78, 8° 원추 시트, C-링 림 턱) | PETG | 1 + 예비 1 | TBD | 볼트 2개 교체식 |
| 넥 접촉 레버 브래킷 | PETG | 1 | TBD | 포크 U 바닥 |
| 센서 브래킷 (라인센서·초음파) | PETG | 1 | TBD | 라인센서 지면 8~12mm |
| 범퍼/외피, 팀명·팀번호 플레이트 | PLA/PETG | 1식 | TBD | 외부 부착 필수 |
| 휠 허브 (필요 시) | PETG | 2 | TBD | 바퀴 호환 안 될 때 |

합계 목표 약 600g (필라멘트 산입 기준). 실제 사용량은 슬라이서 g 값으로 최종 갱신한다.

## 영수증·증빙 체크리스트

규정: **모든 영수증을 최종 보고서에 첨부**. 허위 기재는 실격.

- [ ] 주문 즉시 주문 내역 화면 캡처 + 영수증/거래명세서 PDF 저장 (파일명: `YYYYMMDD_쇼핑몰_품목.pdf`)
- [ ] 영수증 금액과 BOM `확정가`가 일치하는지 대조 (배송비·할인 포함)
- [ ] 영수증에 품목명이 없는 경우(예: 마켓 결제 내역) 상품 페이지 캡처 병행
- [ ] 필라멘트: 롤 영수증 + 사용량 g 기록(슬라이서 스크린샷) + 산입 계산식 첨부
- [ ] 지급품과 사비품 혼동 금지: 지급품은 BOM (a)에만 기재
- [ ] 이미 보유한 개인 부품(예: 프린터 소모품)을 사용했다면 구매 영수증 없이 비용에 산입하지 않는다고 명시하거나, 시가 기준 근거 첨부
- [ ] 반품·미사용 부품은 총액에서 제외하고 환불 영수증 첨부
- [ ] 최종 사비 합계 ≤ 120,000원 확인, 제출 전 재계산
