jbj7667/wafer-transfer-robot/docs/design/print_parts.md

# 출력용 부품 모델 (Fusion `wafer_robot_print_v1`) — 결과

기준: `cad/params.md` v1.1d, 가이드 `fusion_guide.md`. 좌표 = 원점 바닥 중점, +X 전진, +Y 좌, +Z 위, mm. STL은 `cad/print/*.stl`(출력 자세로 회전·베드 위 정렬, 중간 해상도). 모든 부품 Bambu A1 베드(256×256×256) 이내(최대 P01 132×184).

추정 질량 = 부피 × 밀도(PLA 1.24, PETG 1.27) × **0.35(유효 충전율 가정: 외벽+인필 혼합 평균)**. 출력 시간은 추정치(슬라이서 값으로 교체).

| 부품 | 소재 | 출력 자세 | 서포트 | 외곽 bbox(mm) | 부피(cm³) | 추정 g | 출력 시간 추정 |
|---|---|---|---|---|---|---|---|
| P01 deck1 하판 | PLA | 아랫면 평평 | 없음 | 132×184×4 | 78.38 | 34.0 | 1h 20m |
| P02 deck2 상판 | PLA | 뒤집어(윗면 아래) | 없음 | 132×150×3 | 55.82 | 24.2 | 55m |
| P03 standoff (5개 한 판) | PLA | 세워서 | 없음 | 126×138×44 | 10.76 | 4.7 | 40m |
| P04 motor_brkt L | PETG | 바깥판 면을 베드 | 없음 | 42×38×25 | 9.83 | 4.4 | 35m |
| P04 motor_brkt R | PETG | 바깥판 면을 베드 | 없음 | 42×38×25 | 9.83 | 4.4 | 35m |
| P05 caster_spacer (h=39 가정) | PLA | 뒤집어 | 없음(내부 중공 브리지 3mm) | 30×24×39 | 11.94 | 5.2 | 35m |
| P06 line_hanger | PLA | 8mm 면 베드(눕힘) | 없음 | 32×70×8 | 17.02 | 7.4 | 25m |
| P06 line_head_t0 | PLA | 뒤집어(리저 위) | 트리 서포트(리저·후드) | 28×70×41 | 15.54 | 6.7 | 30m |
| P06 line_head_t5 | PLA | 뒤집어 | 트리 서포트 | 28×70×42 | 15.51 | 6.7 | 30m |
| P06 line_head_t10 | PLA | 뒤집어 | 트리 서포트 | 28×70×43 | 15.49 | 6.7 | 30m |
| P06 line_head_t15 | PLA | 뒤집어 | 트리 서포트 | 28×70×45 | 15.48 | 6.7 | 30m |
| P07 sonar_mount (데크2 아래 매달림, v1.1d) | PLA | 뒤집어(플랜지 면 베드) | 소량(Ø17 구멍 윗면) | 18×47×23 | 6.37 | 2.8 | 25m |
| P08 stepper_brkt 칼라 | PETG | 플랜지 아래 | 없음 | 14×64×40 | 7.63 | 3.4 | 25m |
| P08 stepper_plate | PETG | 평평 | 없음 | 46×46×4 | 6.80 | 3.0 | 15m |
| P09 mast_lower L | PLA | 바닥 면 | 없음 | 24×16×16 | 4.86 | 2.1 | 10m |
| P09 mast_lower R | PLA | 바닥 면 | 없음 | 24×16×16 | 4.86 | 2.1 | 10m |
| P10 mast_upper (Z232~245, v1.1d) | PLA | 뒤집어(지붕 면 베드, 베어링 시트 위) | 없음 | 30×76×13 | 25.20 | 10.9 | 30m |
| P11 limit_low | PLA | 축 세움 | 없음 | 18×31×14 | 3.44 | 1.5 | 10m |
| ~~P11 limit_high~~ | - | - | - | v1.1d 삭제, STL은 `cad/print/optional/` | - | - | - |
| P12 carriage | PETG | 뒤집어(상면 아래, IR 암 위) | 트리 서포트(IR 트레이) | 56×90×54 | 50.95 | 22.6 | 1h 40m |
| P13 fork | PETG | 뒤집어(윗면=베드, 림 2mm 아래) | 없음 | 129×118×12 | 43.09 | 19.2 | 1h 10m |
| P14 batt_cradle L | PLA | 바닥 면 | 없음 | 58×92×16 | 12.36 | 5.4 | 35m |
| P14 batt_cradle R | PLA | 바닥 면 | 없음 | 58×92×16 | 12.36 | 5.4 | 35m |
| P15 panel | PLA | 라벨 면 베드 | 없음 | 24×43×15 | 3.85 | 1.7 | 15m |

- 합계(P16 제외): **약 195 g(v1.1d 반영 전 205 g)** (PLA 148 g, PETG 57 g). 서포트·실패 여유 +15% 시 약 236 g. 가이드 §G의 424 g 추정보다 작은 것은 0.35 가정과 단순화(리브·필릿 미반영) 때문이다.
- 선택 부품: P16 wheel_hub (PETG, 7.07 cm³, 약 3.1 g/개, 24×24×18).

## 조립 간섭 재검사 (v1.1d, analyzeInterference)
기준체 REF_base(Ø100×100 + Ø50×100, X=+92, Z 0~200) 포함. 제외: P16(미조립), P06 헤드 t5/t10/t15. CD(Ø120×1.2)는 모델에 없어 미포함.

| 포즈 | 포크 윗면 Z | 캐리지 윗면 Z | 간섭 건수 | P10 하면(232)과 간극 |
|---|---|---|---|---|
| 홈 | 155 | 160 | **0** | 72 |
| +35 | 190 | 195 | **0** | 37 |
| +57 | 212 | 217 | **0** | 15 |
| 기계적 정지 | 227 | 232 | **0** (면 접촉, 겹침 없음) | 0 |

로봇 내부 간섭 전 포즈 0건(이전 P07–P09_R 0.747 cm³ 해소).

## v1.1d 변경
- P07: 소나 Z 77~97, 앞면 X+10, 데크2 아랫면(Z100)에 매달림. 플랜지(Z97~100)를 M3×2(X33, Y−68/−44)로 데크2에 관통 체결(위쪽 너트). PCB는 앞판(X20~22)·뒷판(X26.4~29.4) 사이에 +Y 쪽에서 밀어 넣고 접착/테이프로 고정. **소나 중심 Y를 −46 → −57로 이동**: 봉(X15, Y−30, Ø8)이 Z 77~97을 지나 안쪽 트랜스듀서(Y−33)와 물리적으로 겹쳐서 부득이 이동(PCB Y −79.5~−34.5, 데크2 가장자리 −75를 4.5 mm 초과, 플랜지 끝 −81.5). 사용자 확인 필요.
- P10: Z 232~245, 베어링 시트 Ø22.1×7(Z232~239)+지붕 6, 봉 클램프 Ø8.2 Z232~241(삽입 9→봉 상단 241까지, 위 4 mm 캡), 슬릿+M3 클램프(X28, Y방향, 너트 슬롯은 +X면에서 삽입). 리드스크류 Ø5 스텁(Z221~241)은 시트(232~239)를 통과해 지붕의 Ø5.5 구멍에 2 mm 들어가므로 길이 변경 불필요. 봉 삽입은 232~241 = 9 mm(요청 13 mm는 블록 13 mm 제약상 불가, 봉 끝이 241이라 실삽입 9).
- P11_limit_high 삭제(STL은 optional/로 이동). P11_limit_low 유지.

## 확인필요
- **확인필요: 실물 너트 플랜지 구멍 간격 측정** (T8 황동 플랜지 너트 4×Ø3.4, PCD 16, 플랜지 Ø22 가정).

## 모델링 중 발견한 문제 (사용자 판단 필요)
1. **P07 소나 vs P09_R 하부 블록**: 소나 튜브(Y −46±13)의 안쪽 튜브(Y −33)가 봉 블록(Y −38~−22, X 3~27, Z 56~72)을 관통(0.75 cm³). 제안: 소나를 Z 76 이상으로 올리거나(Z 77~97, 데크2 아래) Y를 −59 이하로 이동, 또는 R 블록을 X 27 이후로 후퇴. 모델은 사용자 지정값(앞면 X+10, Y −46, Z 56~76) 그대로 두었다.
2. **상한 리밋**: 위 표 참조. 캐리지 상단이 최고 217로 P10(220)에 3 mm까지 접근하므로 상한 스위치를 봉 위에 둘 수 없다. 대안: P10 안쪽 또는 캐리지 위 스위치.
3. 스탠드오프 (30, −65)는 소나 튜브와 충돌해 삭제(5개). 하판 구멍 6개는 그대로.
4. 캐리지: 너트 Z 140~154 지정은 캐리지가 포크 윗면(155) 위에 와야 해 모순 → 캐리지를 Z 136~160(포크 루트 Z145~155가 앞면 X=28에 접함)으로, 너트 플랜지는 아랫면 Z136, 몸통 Z 124~136(스크류 하단 121 위 3)으로 해석. T8 너트 벤더 모델(cad/vendor/t8_leadscrew)은 이 워크트리에 없어 PCD 16 4구멍(Ø4 인서트)을 가정. 상부 한계 때문에 캐리지 높이 24(LM8UU 길이)로 줄임.
5. P13 포크: IR 창은 루트 앞단 X 44~50 노치(Y ±18.5)로 단순화, 넥 스위치 포켓 X 32~44(Y ±8.5)와 연결됨. 원추 시트는 회전 절단(8°, 반경 39에서 높이 −2.81)으로 구현, 림 앞 θ40~66°·뒤 107~130°(갈래 폭 밖은 절단), 인서트 M3 2개(루트 앞면 X=28에서 깊이 5.5).
6. 두께가 인서트 깊이 5.5보다 얇은 곳(P02 3 mm, P05 3 mm, P04 플랜지 5 mm)은 Ø4.0 관통 구멍으로 처리 → 볼트+너트 또는 인서트 대신 사용.
7. P15 라벨 "정비제 / 팀번호": Fusion 텍스트 스케치가 프로파일을 만들지 못해(한글 폰트) 40×8×0.6 오목 홈만 생성. 글자는 색 교체 출력/스티커.
8. P14 크래들: 폭 58에 배터리가 꽉 차므로 X 측벽 없음(바닥 + 외단 벽 + 결속 슬롯 4). 스탠드오프 (−88,±65) 회피 구멍 추가.
9. P04: 모터 몸체와 겹치는 플랜지 부분은 Ø37.4 원통으로 절개(귀 2개만 남음), 보강 리브는 휠 간극(79) 때문에 생략. 탭 깊이 미확정 — 판 두께 5.
10. P08 칼라: 마스트 블록(Y 22~38)과 겹치지 않게 후벽(Y ±15)+하부 플랜지만. 소나 탭과의 간섭 회피.
11. P06: 행어 Z 20~52, 헤드 윗단 라이저로 슬롯 5~15 조절(슬롯 Z 24~38), 후드 하단은 line_z 10에서 지면 4.1(5 mm 설정 시 스칠 수 있음). 경사 0/5/10/15° 평행사변형 단면.
