jbj7667/wafer-transfer-robot/cad/arm_bench/P06_pulley52_hub_x2.stl

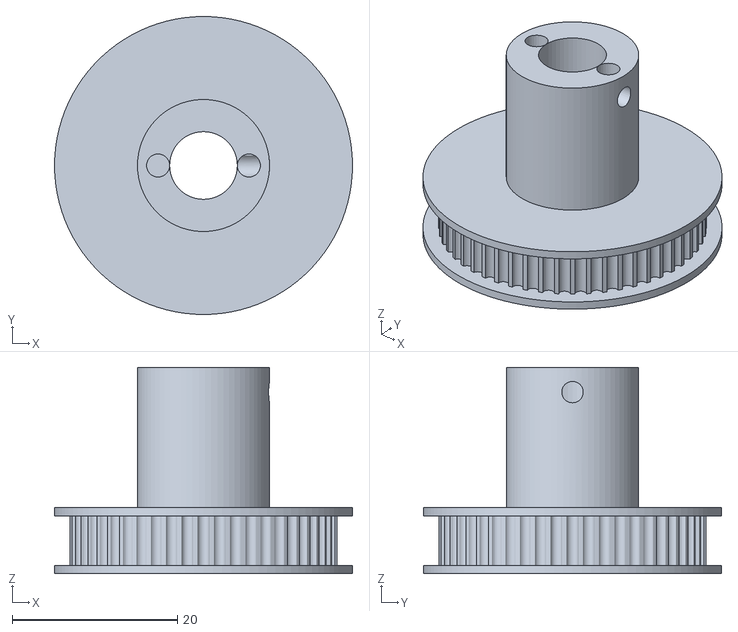
[picture p28: CAD file, 2026-10-27]
cad/arm_bench/P06_pulley52_hub_x2.stl
36.1 x 36.1 x 25.0
