jbj7667/wafer-transfer-robot/cad/model/stl/P09_l298.stl

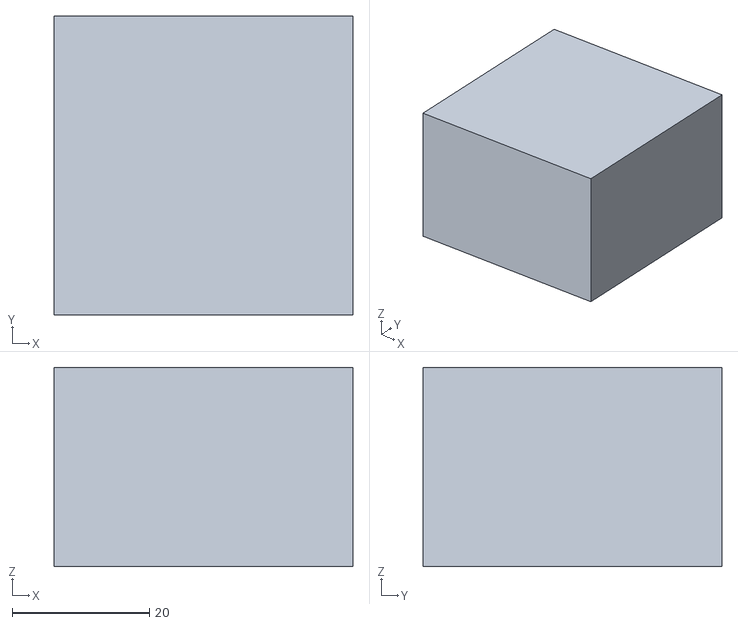
[picture p29: CAD file, 2026-10-26]
cad/model/stl/P09_l298.stl
43.5 x 43.5 x 29.0
