jbj7667/wafer-transfer-robot/cad/print/optional/P11_limit_high.stl

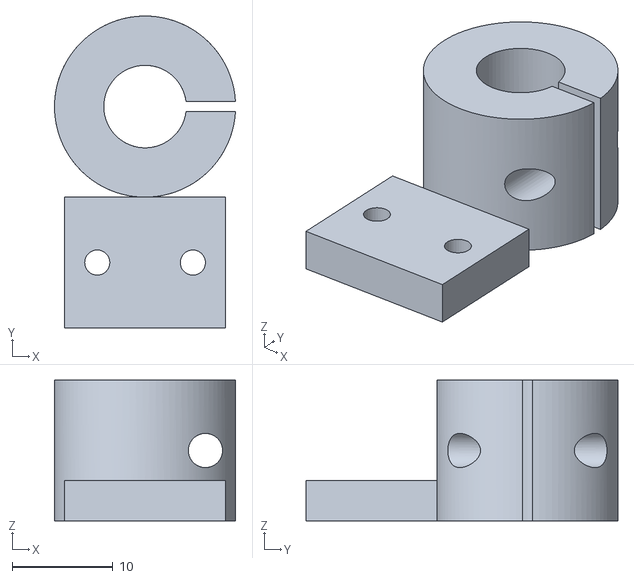
[picture p30: CAD file, 2026-10-26]
cad/print/optional/P11_limit_high.stl
18.0 x 31.0 x 14.0
