jbj7667/wafer-transfer-robot/cad/print/P10_mast_upper.stl

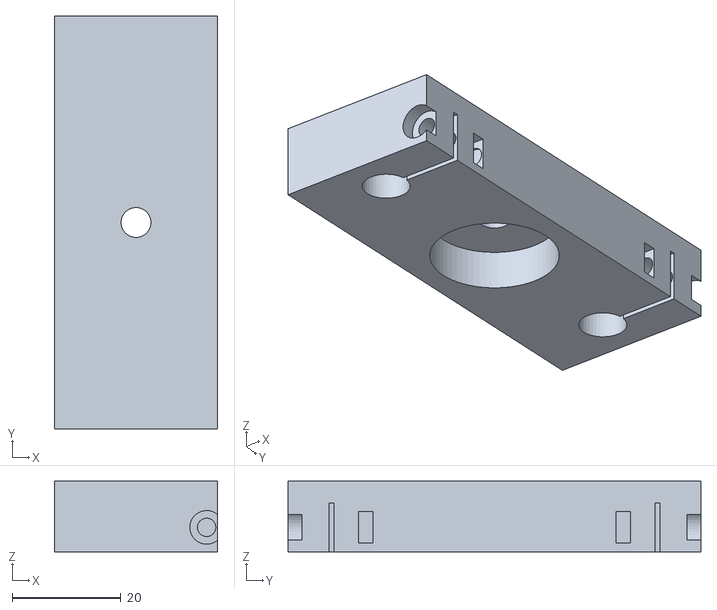
[picture p31: CAD file, 2026-10-27]
cad/print/P10_mast_upper.stl
30.0 x 76.0 x 13.0
