jbj7667/wafer-transfer-robot/practice/stl/base_200.stl

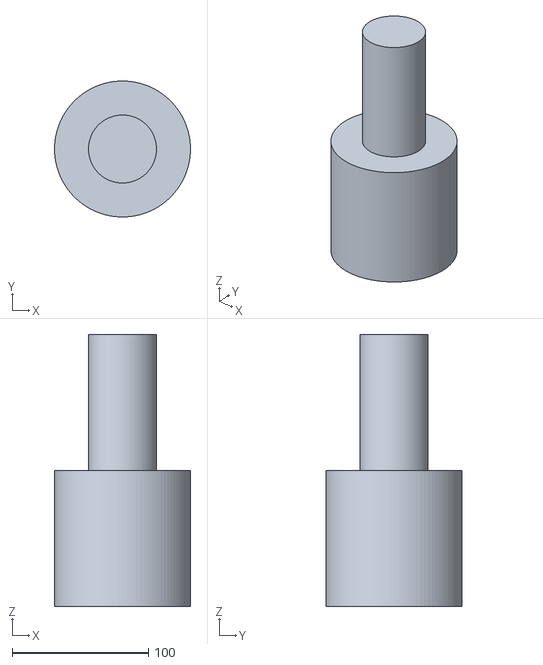
[picture p32: CAD file, 2026-10-26]
practice/stl/base_200.stl
100.0 x 100.0 x 200.0
