jbj7667/wafer-transfer-robot/cad/arm_bench/P16_belt_clamp_x2.stl

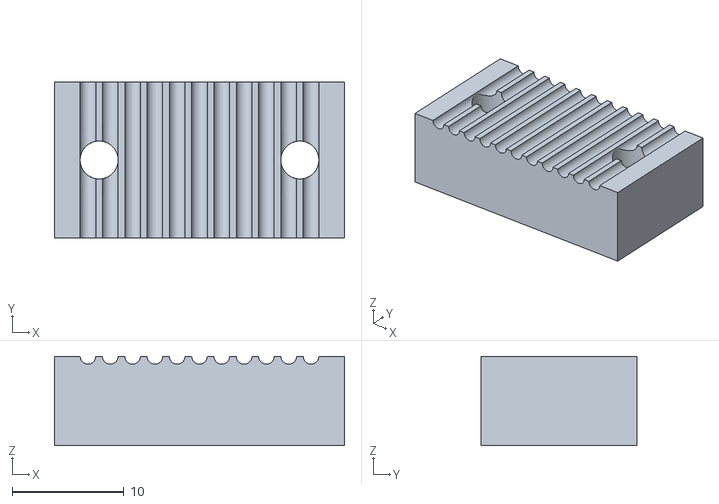
[picture p33: CAD file, 2026-10-27]
cad/arm_bench/P16_belt_clamp_x2.stl
26.0 x 14.0 x 8.00
