jbj7667/wafer-transfer-robot/cad/model/stl/P12_rods.stl

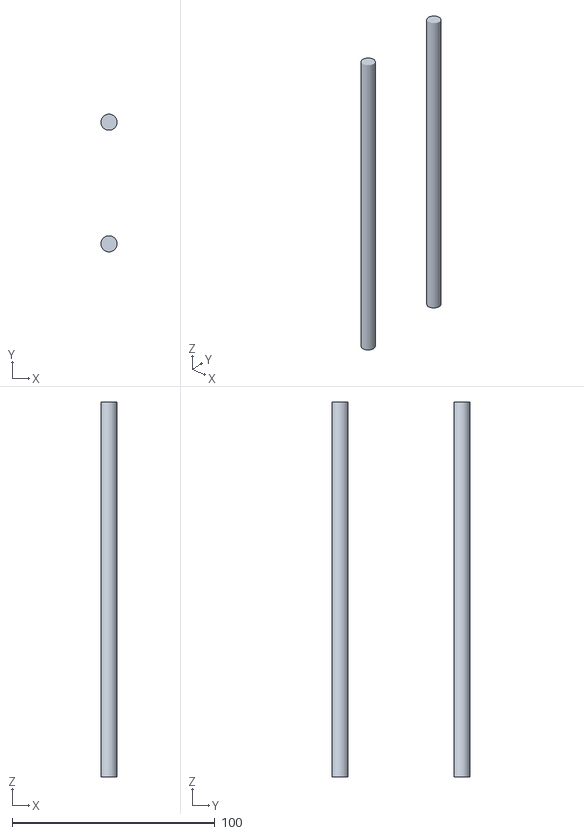
[picture p34: CAD file, 2026-10-26]
cad/model/stl/P12_rods.stl
8.00 x 67.9 x 185.0
