jbj7667/wafer-transfer-robot/cad/print/P07_sonar_mount.stl

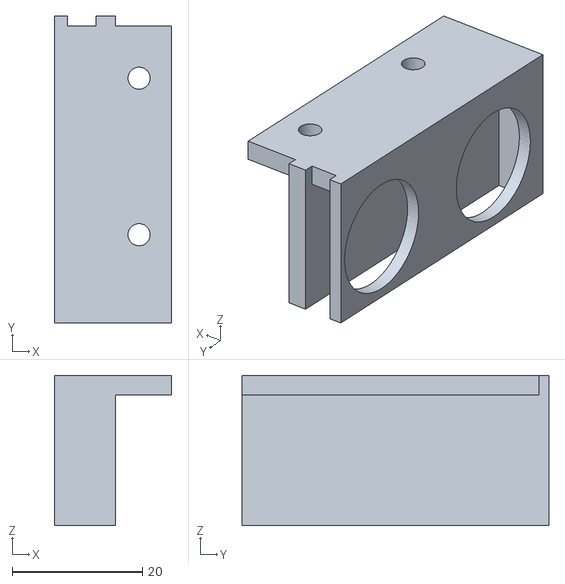
[picture p35: CAD file, 2026-10-27]
cad/print/P07_sonar_mount.stl
18.0 x 47.0 x 23.0
