jbj7667/wafer-transfer-robot/practice/stl/base_175.stl

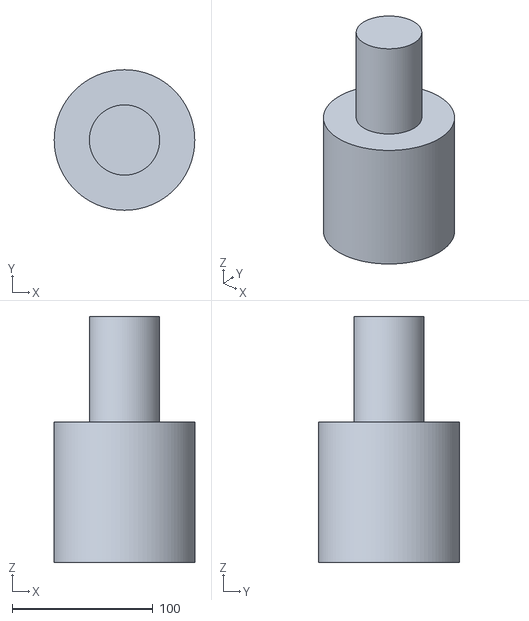
[picture p36: CAD file, 2026-10-26]
practice/stl/base_175.stl
100.0 x 100.0 x 175.0
