jbj7667/wafer-transfer-robot/cad/arm_bench/P09_pulley20_D5_x2.stl

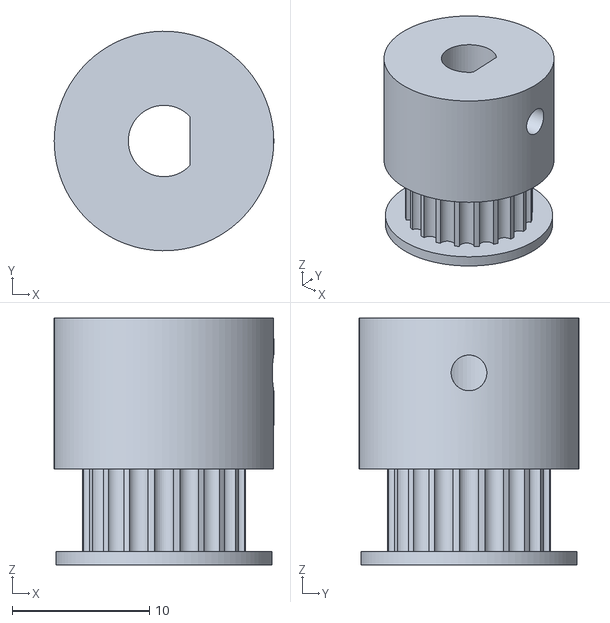
[picture p37: CAD file, 2026-10-27]
cad/arm_bench/P09_pulley20_D5_x2.stl
16.0 x 16.0 x 18.0
