jbj7667/wafer-transfer-robot/cad/model/stl/P16_linesensor.stl

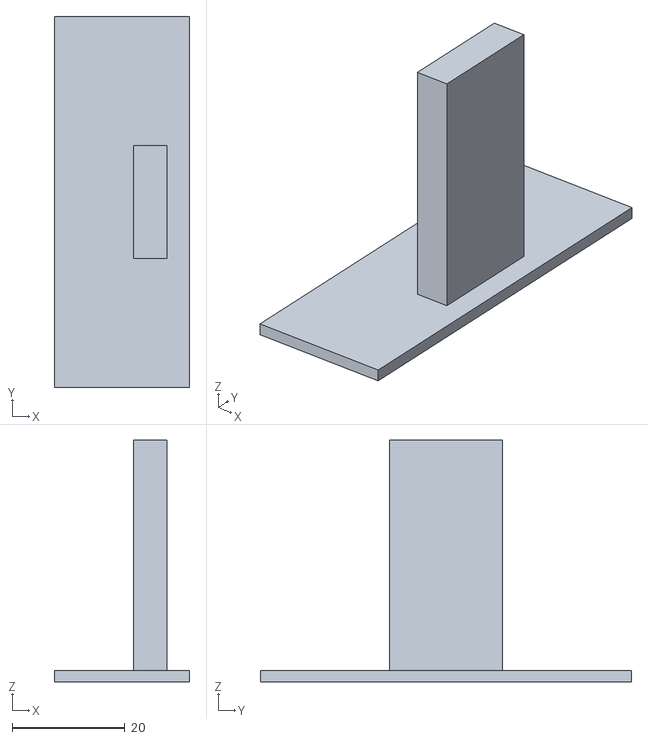
[picture p38: CAD file, 2026-10-26]
cad/model/stl/P16_linesensor.stl
24.0 x 66.0 x 43.0
