jbj7667/wafer-transfer-robot/cad/print/P06_line_hanger.stl

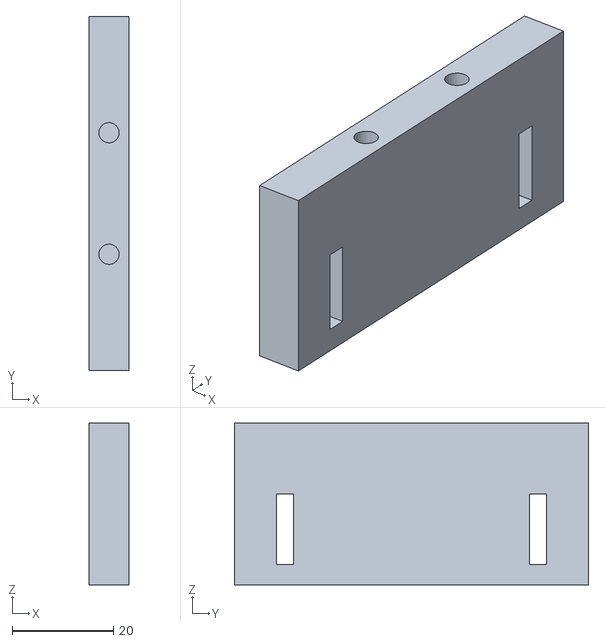
[picture p39: CAD file, 2026-10-26]
cad/print/P06_line_hanger.stl
8.00 x 70.0 x 32.0
