jbj7667/wafer-transfer-robot/practice/stl/base_check_ring_120.stl

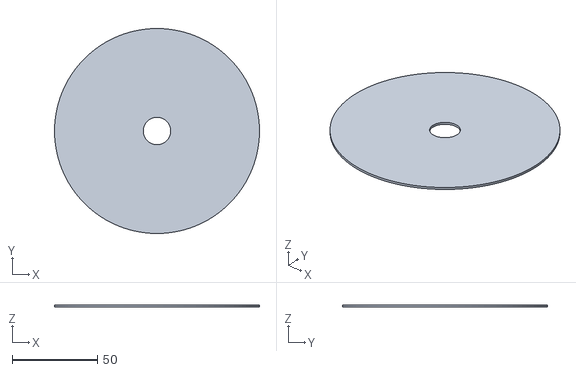
[picture p40: CAD file, 2026-10-26]
practice/stl/base_check_ring_120.stl
120.0 x 120.0 x 1.20
