jbj7667/wafer-transfer-robot/cad/arm_bench/P11_link1_lid.stl

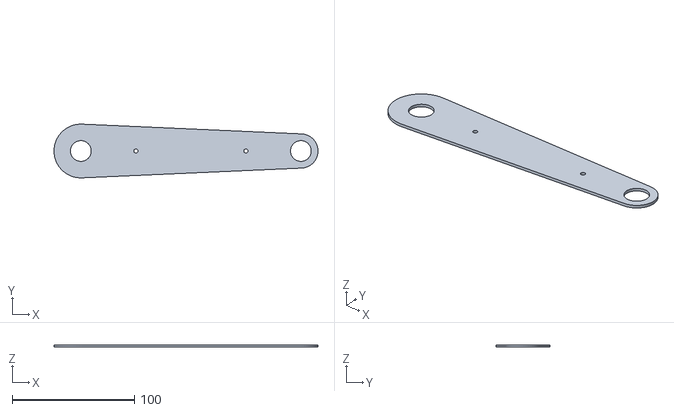
[picture p41: CAD file, 2026-10-27]
cad/arm_bench/P11_link1_lid.stl
216.0 x 44.0 x 2.00
