jbj7667/wafer-transfer-robot/cad/model/stl/P18_ir.stl

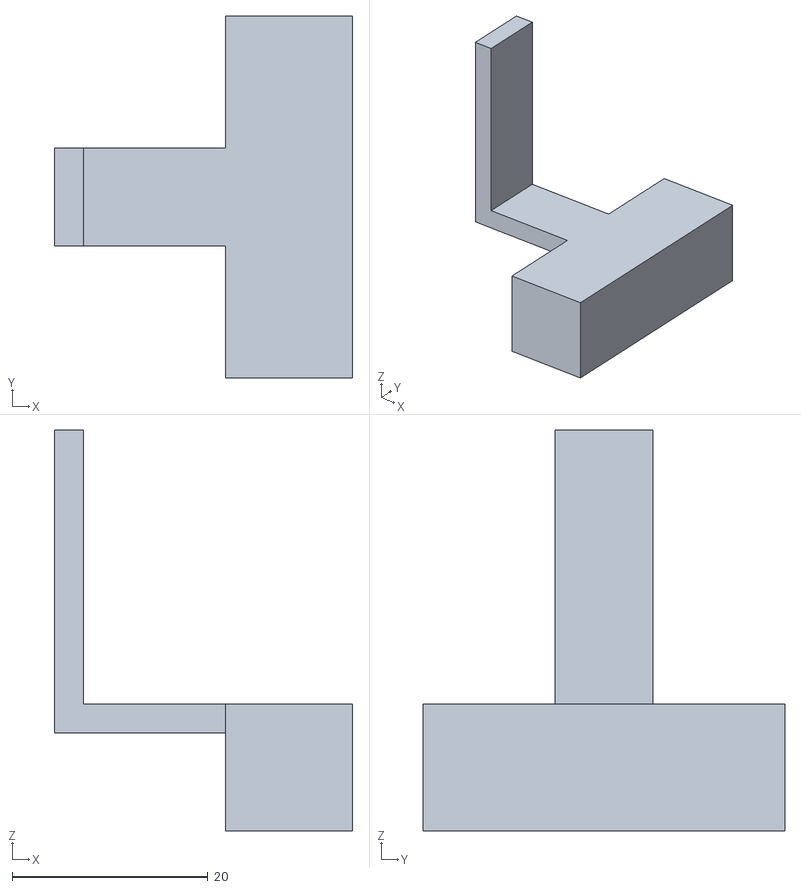
[picture p42: CAD file, 2026-10-26]
cad/model/stl/P18_ir.stl
30.5 x 37.0 x 41.0
