jbj7667/wafer-transfer-robot/cad/arm_bench/P08_elbow_hub26.stl

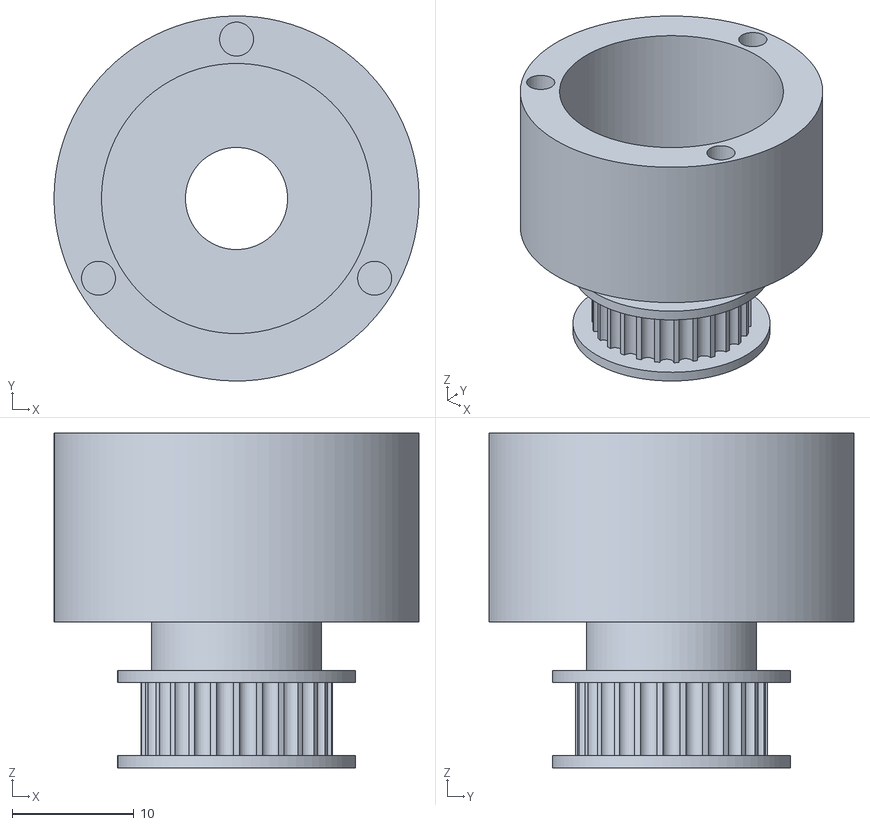
[picture p44: CAD file, 2026-10-27]
cad/arm_bench/P08_elbow_hub26.stl
30.0 x 30.0 x 27.5
