jbj7667/wafer-transfer-robot/cad/model/stl/REF_base.stl

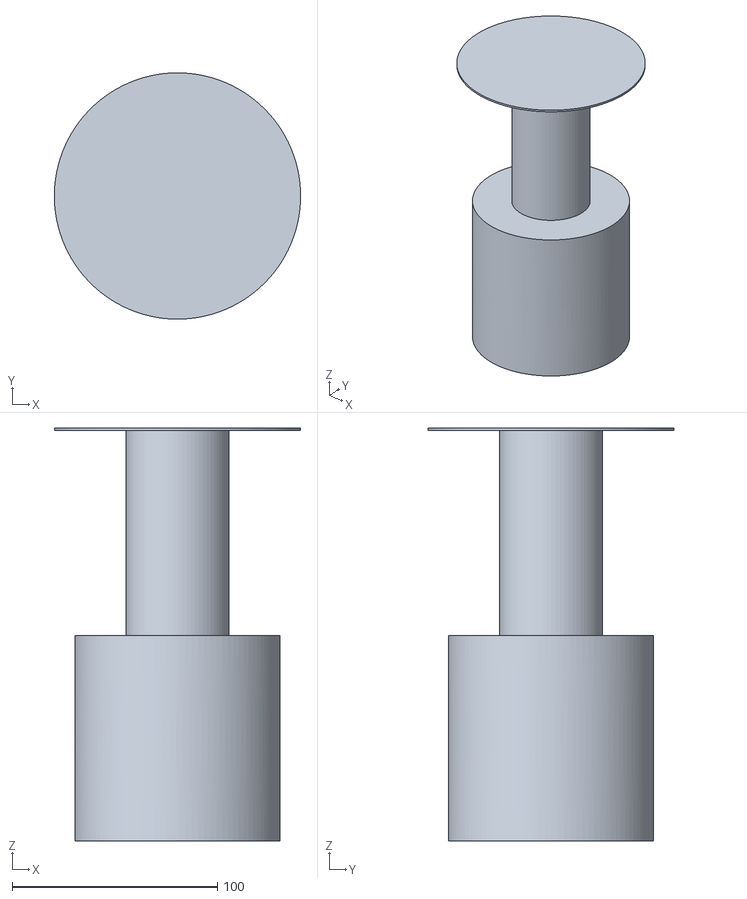
[picture p45: CAD file, 2026-10-26]
cad/model/stl/REF_base.stl
120.0 x 120.0 x 201.2
