jbj7667/wafer-transfer-robot/cad/print/P16_wheel_hub.stl

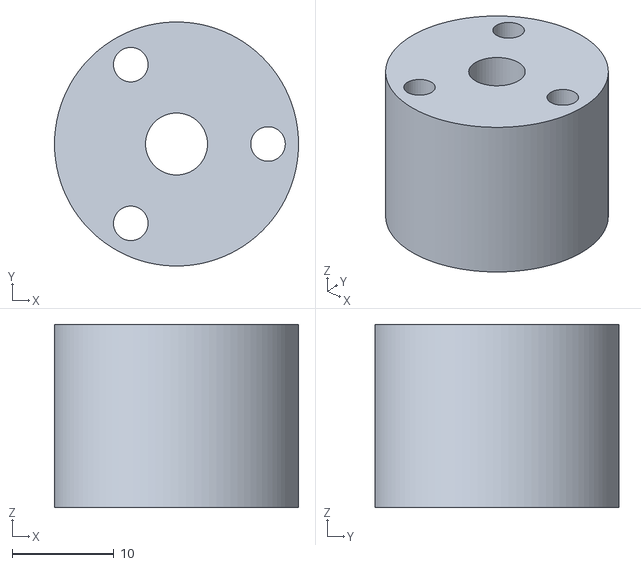
[picture p46: CAD file, 2026-10-26]
cad/print/P16_wheel_hub.stl
24.0 x 24.0 x 18.0
