jbj7667/wafer-transfer-robot/cad/print/P13_fork.stl

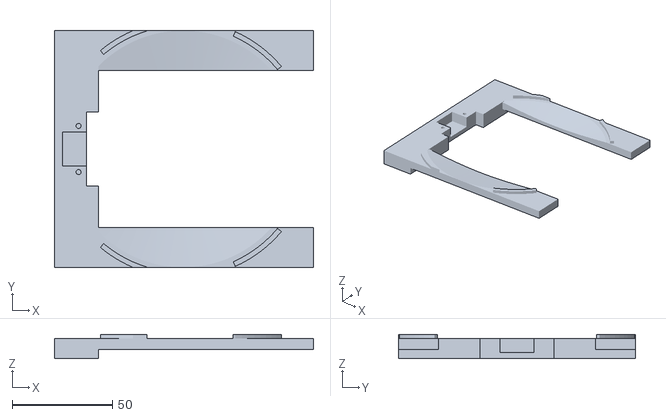
[picture p48: CAD file, 2026-10-26]
cad/print/P13_fork.stl
129.0 x 118.0 x 12.0
