jbj7667/wafer-transfer-robot/cad/arm_bench/P12_link2_box.stl

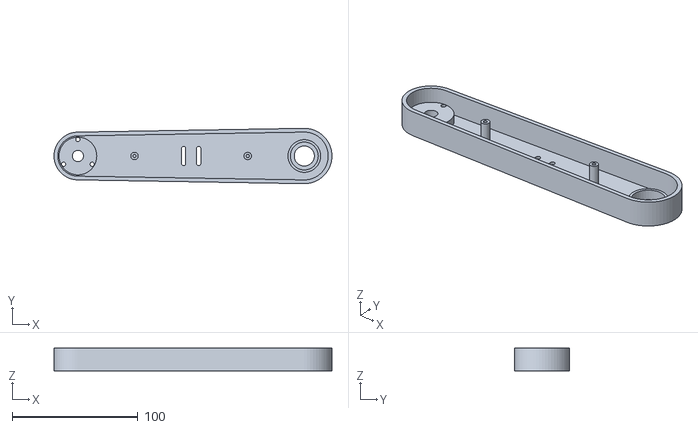
[picture p49: CAD file, 2026-10-27]
cad/arm_bench/P12_link2_box.stl
221.0 x 44.0 x 18.0
