jbj7667/wafer-transfer-robot/cad/model/stl/P04_motors.stl

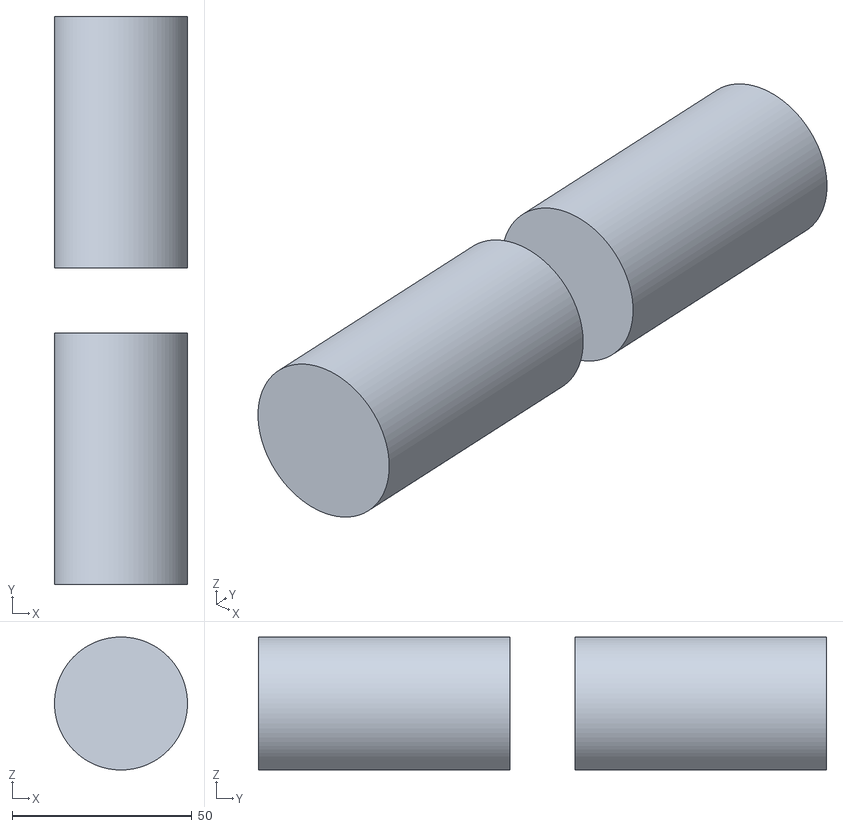
[picture p50: CAD file, 2026-10-26]
cad/model/stl/P04_motors.stl
37.0 x 158.0 x 37.0
