jbj7667/wafer-transfer-robot/cad/print/P14_batt_cradle_L.stl

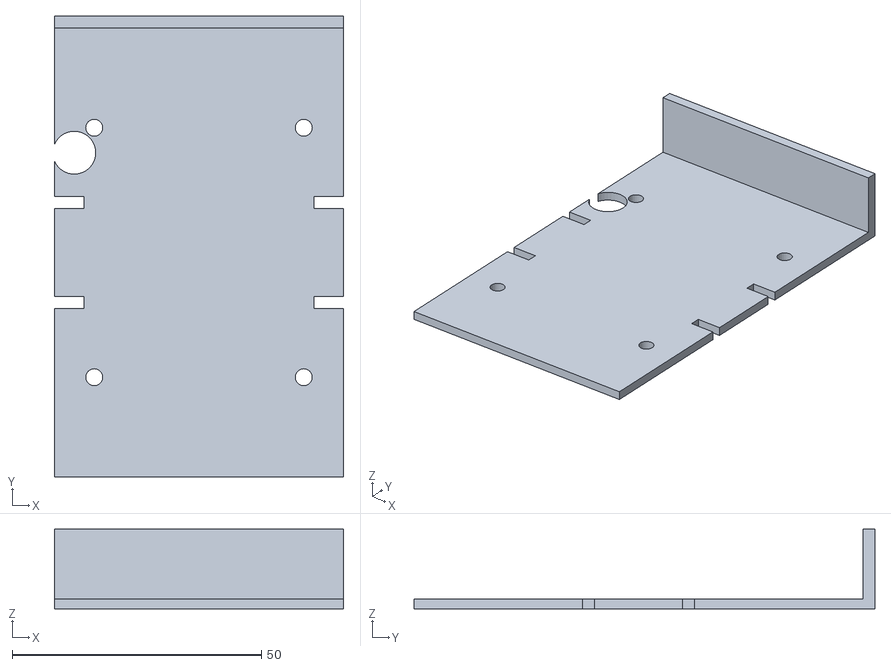
[picture p51: CAD file, 2026-10-26]
cad/print/P14_batt_cradle_L.stl
58.0 x 92.4 x 16.0
