jbj7667/wafer-transfer-robot/cad/arm_bench/P01_base.stl

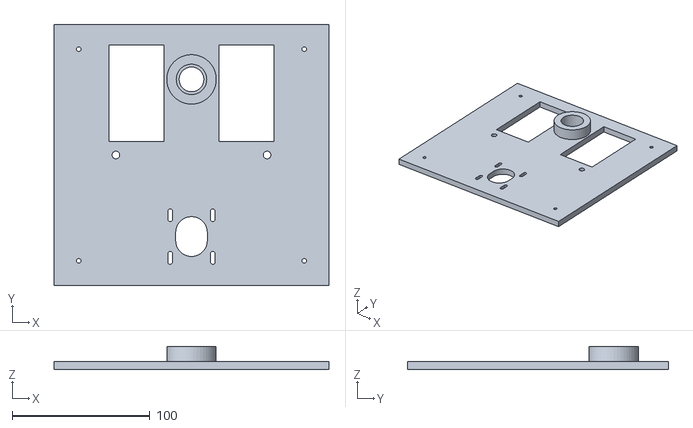
[picture p52: CAD file, 2026-10-27]
cad/arm_bench/P01_base.stl
200.0 x 190.0 x 17.0
