jbj7667/wafer-transfer-robot/cad/model/stl/P17_sonar.stl

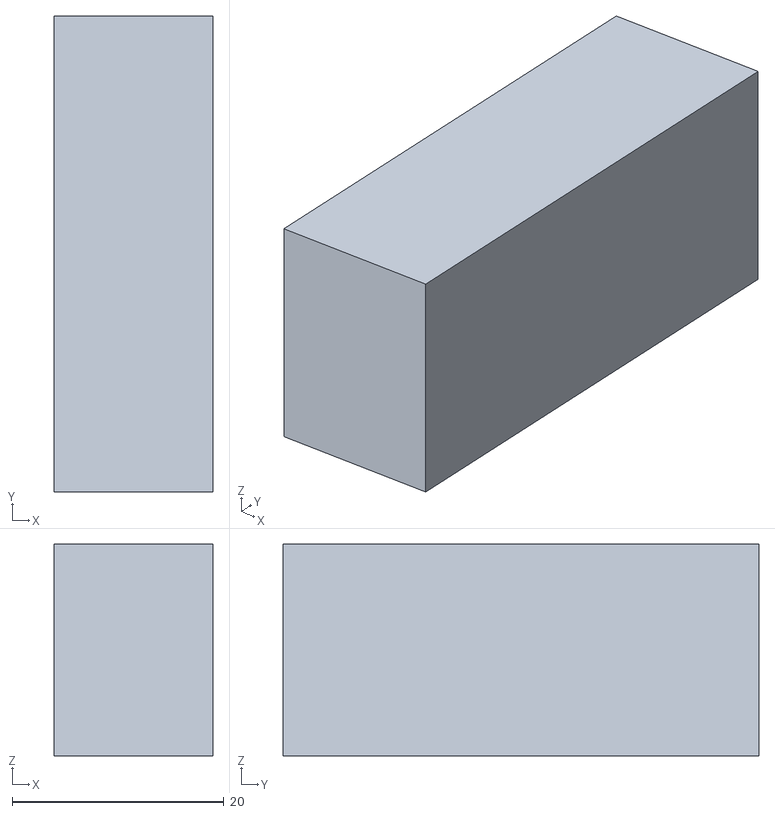
[picture p53: CAD file, 2026-10-26]
cad/model/stl/P17_sonar.stl
15.0 x 45.0 x 20.0
