jbj7667/wafer-transfer-robot/cad/print/P06_line_head_t0.stl

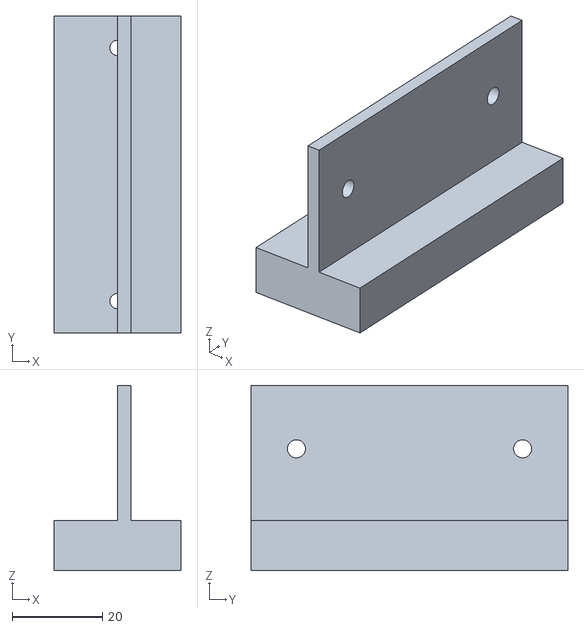
[picture p54: CAD file, 2026-10-26]
cad/print/P06_line_head_t0.stl
28.0 x 70.0 x 40.9
