jbj7667/wafer-transfer-robot/cad/arm_bench/P03_turntable.stl

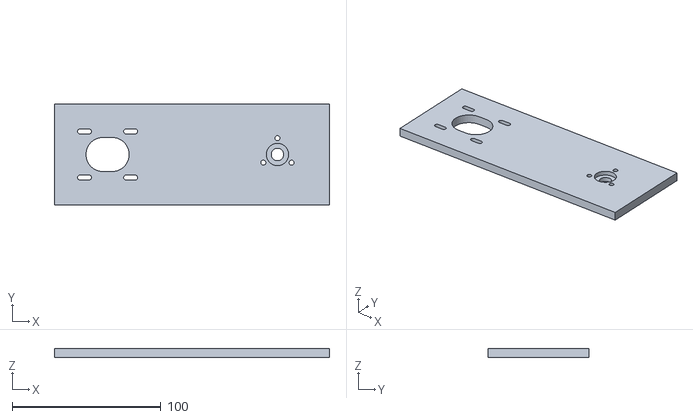
[picture p55: CAD file, 2026-10-27]
cad/arm_bench/P03_turntable.stl
185.0 x 68.0 x 6.00
