jbj7667/wafer-transfer-robot/cad/model/stl/P15_fork.stl

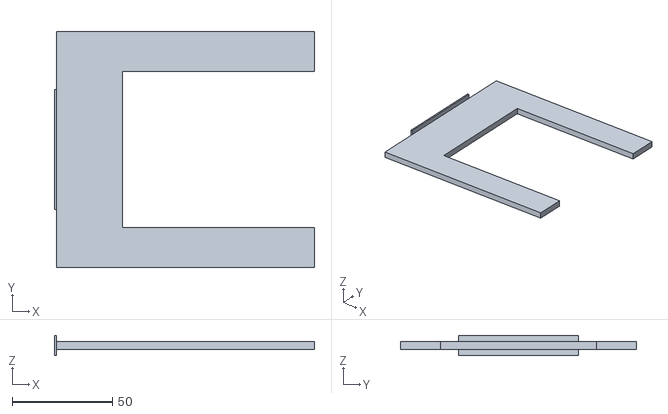
[picture p56: CAD file, 2026-10-26]
cad/model/stl/P15_fork.stl
130.0 x 118.0 x 10.0
