jbj7667/wafer-transfer-robot/cad/print/P09_mast_lower_R.stl

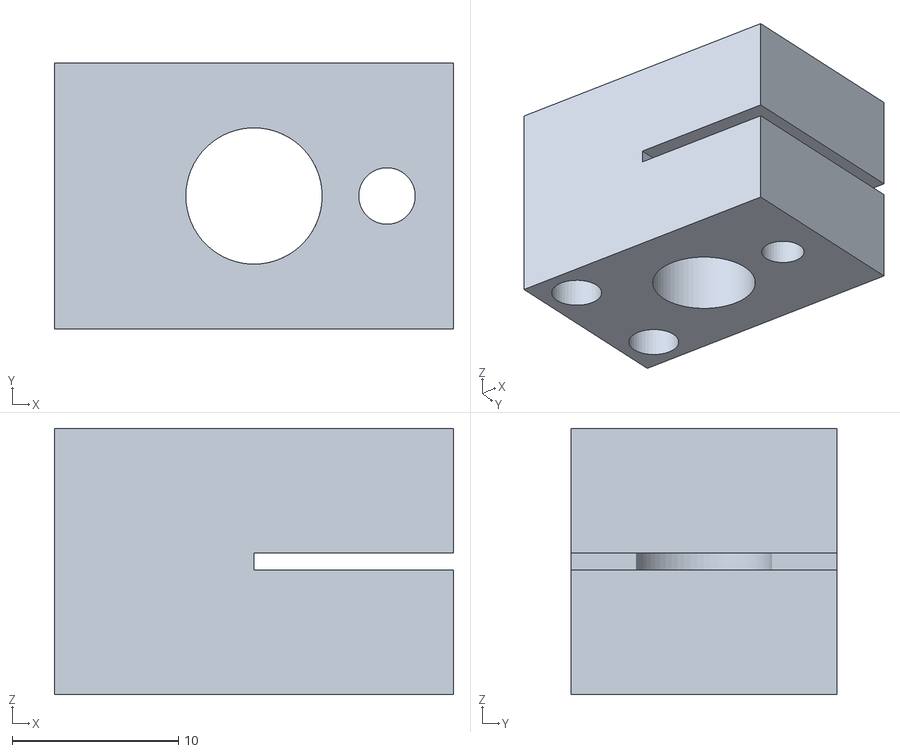
[picture p57: CAD file, 2026-10-26]
cad/print/P09_mast_lower_R.stl
24.0 x 16.0 x 16.0
