jbj7667/wafer-transfer-robot/cad/arm_bench/P05_shoulder_hub60.stl

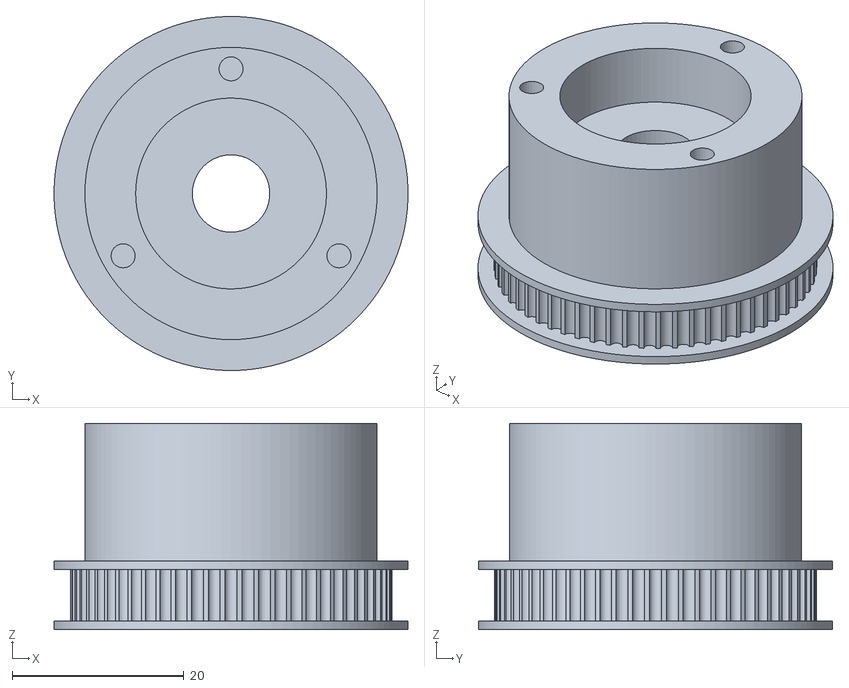
[picture p58: CAD file, 2026-10-27]
cad/arm_bench/P05_shoulder_hub60.stl
41.2 x 41.2 x 24.0
