jbj7667/wafer-transfer-robot/cad/model/stl/P06_batteries.stl

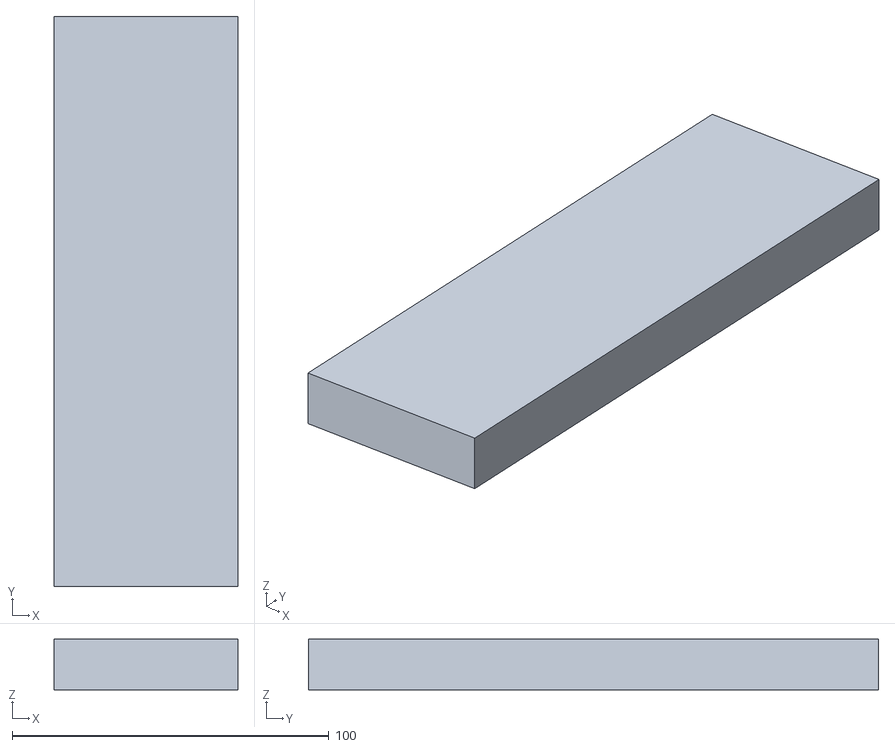
[picture p59: CAD file, 2026-10-26]
cad/model/stl/P06_batteries.stl
58.0 x 180.0 x 16.0
