jbj7667/wafer-transfer-robot/cad/print/P03_standoff_x5.stl

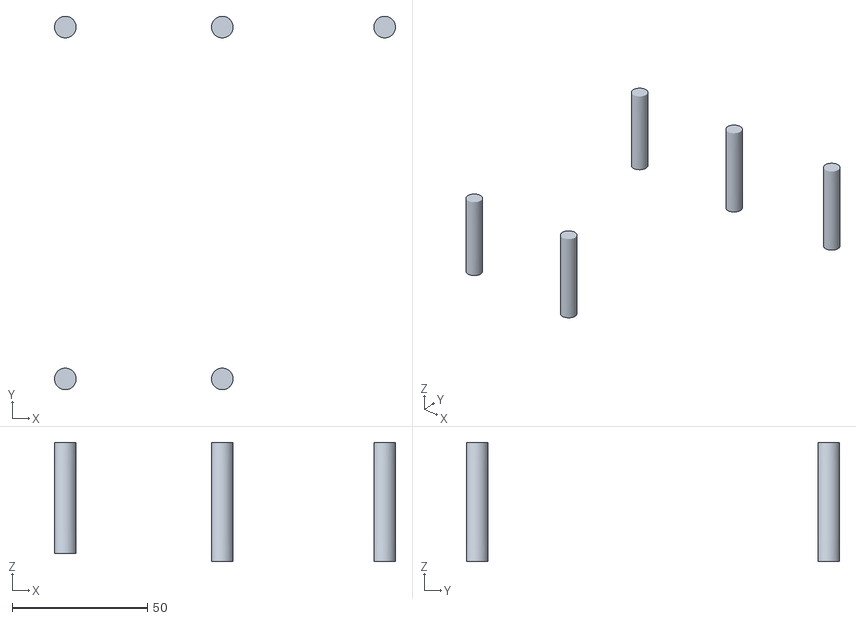
[picture p60: CAD file, 2026-10-26]
cad/print/P03_standoff_x5.stl
126.0 x 138.0 x 44.0
