jbj7667/wafer-transfer-robot/cad/arm_bench/P14_pointer.stl

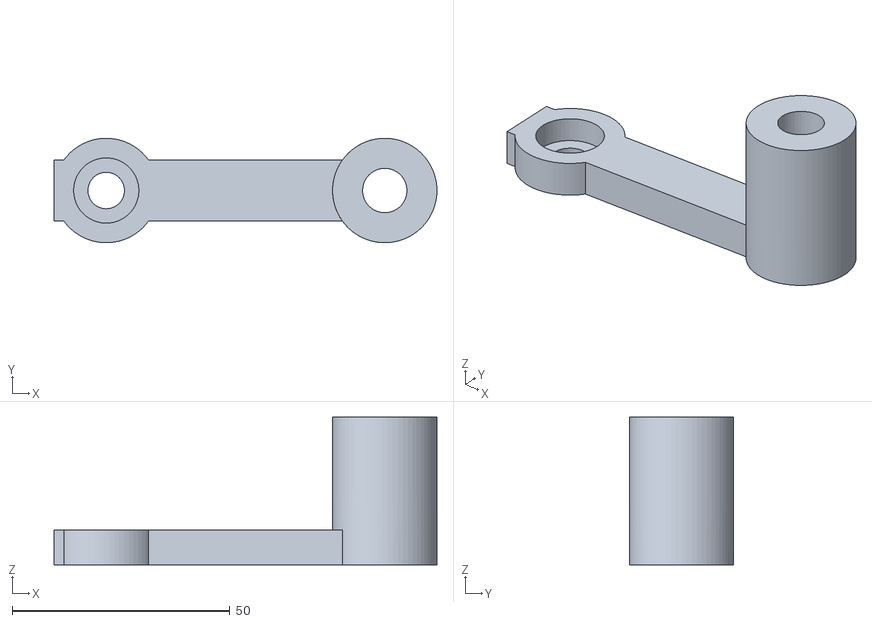
[picture p61: CAD file, 2026-10-27]
cad/arm_bench/P14_pointer.stl
88.0 x 24.0 x 34.0
