jbj7667/wafer-transfer-robot/cad/model/stl/P19_neckswitch.stl

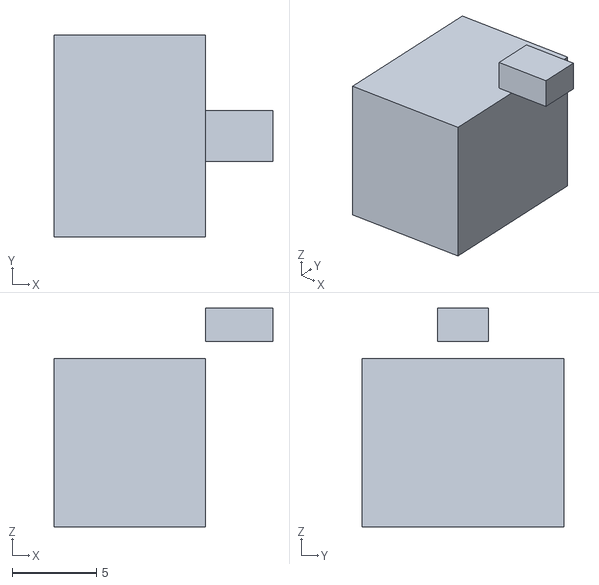
[picture p62: CAD file, 2026-10-26]
cad/model/stl/P19_neckswitch.stl
13.0 x 12.0 x 13.0
