jbj7667/wafer-transfer-robot/cad/print/P01_deck1.stl

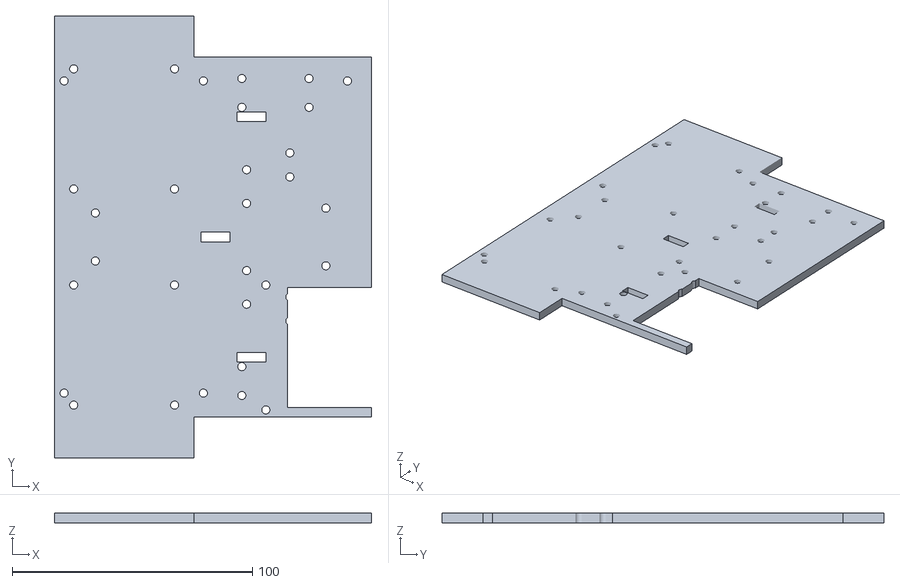
[picture p63: CAD file, 2026-10-26]
cad/print/P01_deck1.stl
132.0 x 184.0 x 4.00
