jbj7667/wafer-transfer-robot/cad/arm_bench/P17_fork_stub.stl

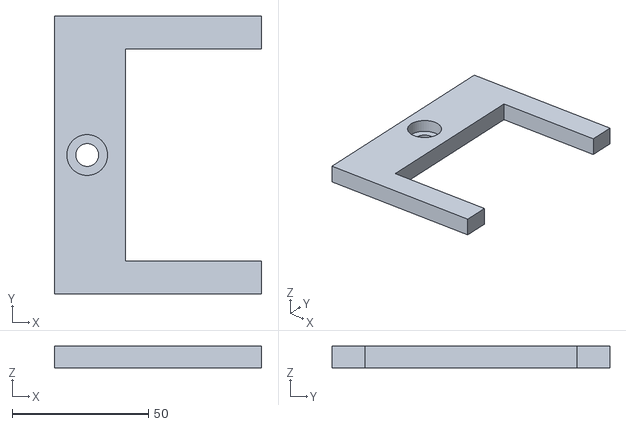
[picture p64: CAD file, 2026-10-27]
cad/arm_bench/P17_fork_stub.stl
76.0 x 102.0 x 8.00
