jbj7667/wafer-transfer-robot/cad/model/stl/P13_topblock.stl

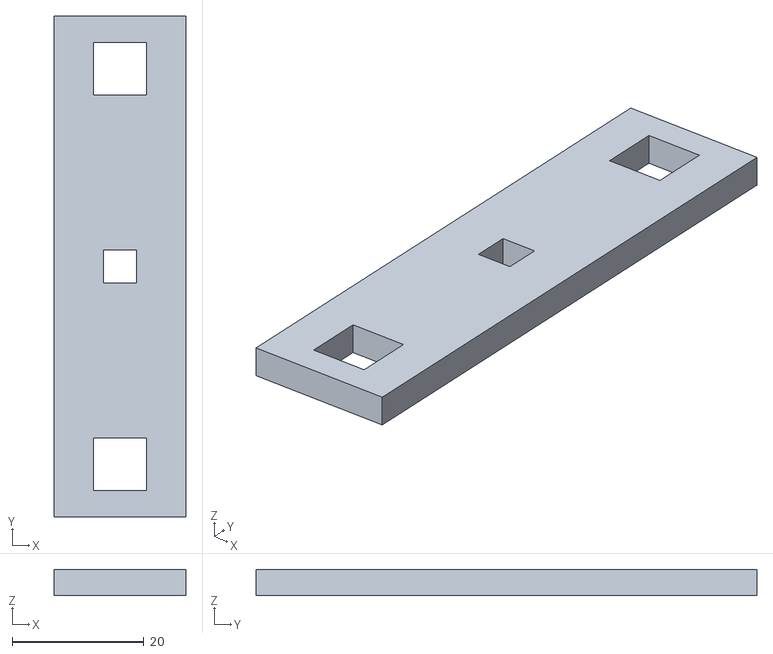
[picture p65: CAD file, 2026-10-26]
cad/model/stl/P13_topblock.stl
20.0 x 76.0 x 4.00
