jbj7667/wafer-transfer-robot/cad/print/P12_carriage.stl

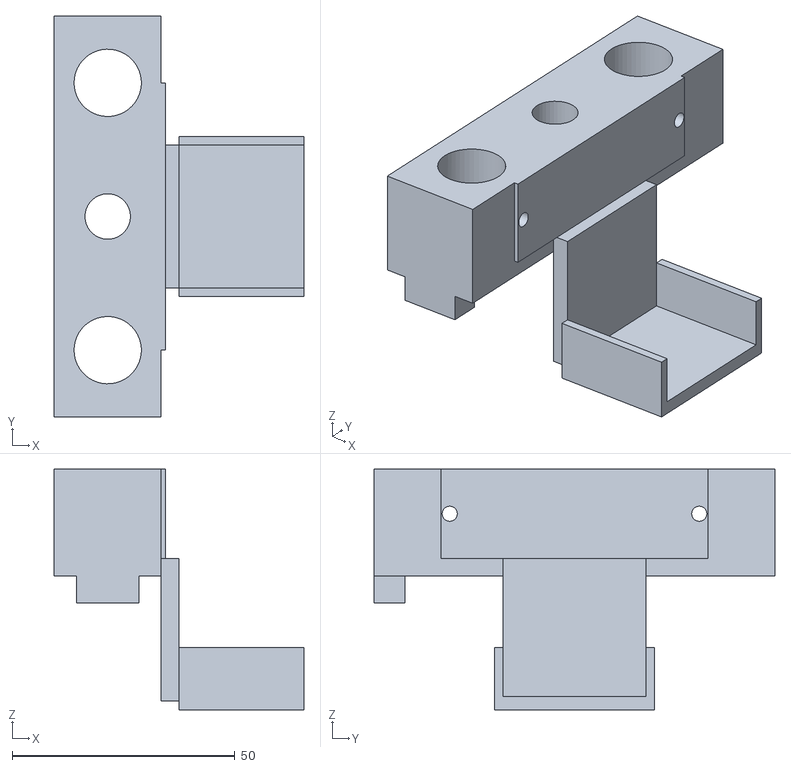
[picture p66: CAD file, 2026-10-26]
cad/print/P12_carriage.stl
56.0 x 90.0 x 54.0
