jbj7667/wafer-transfer-robot/cad/arm_bench/P10_link1_box.stl

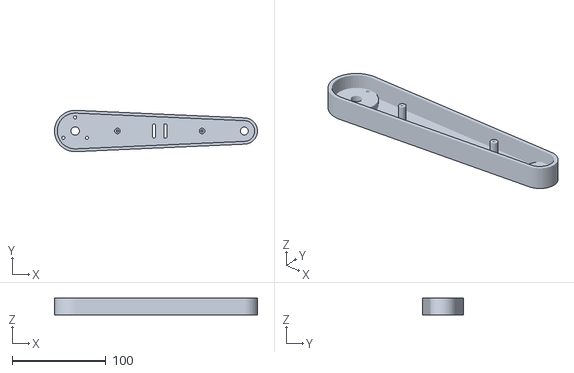
[picture p67: CAD file, 2026-10-27]
cad/arm_bench/P10_link1_box.stl
216.0 x 44.0 x 18.0
