jbj7667/wafer-transfer-robot/cad/model/stl/P08_mega.stl

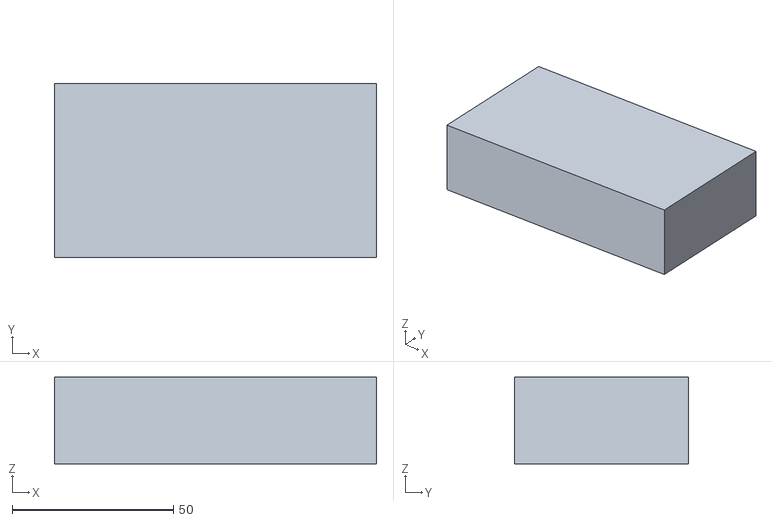
[picture p68: CAD file, 2026-10-26]
cad/model/stl/P08_mega.stl
100.0 x 54.0 x 27.0
