jbj7667/wafer-transfer-robot/cad/arm_bench/P13_link2_lid.stl

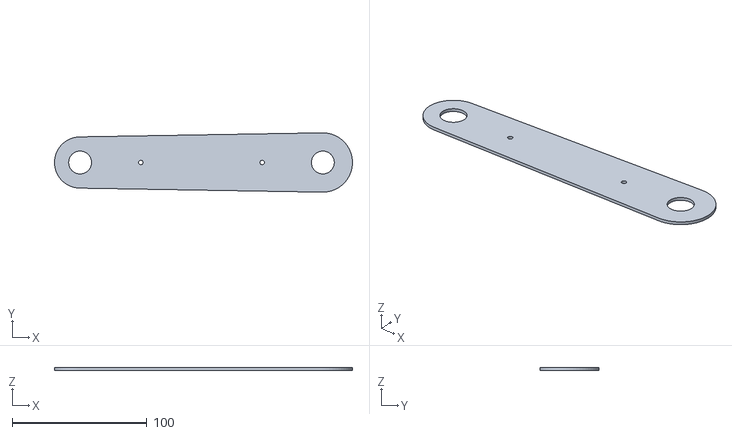
[picture p69: CAD file, 2026-10-27]
cad/arm_bench/P13_link2_lid.stl
221.0 x 44.0 x 2.00
