jbj7667/wafer-transfer-robot/cad/model/stl/P03_wheels.stl

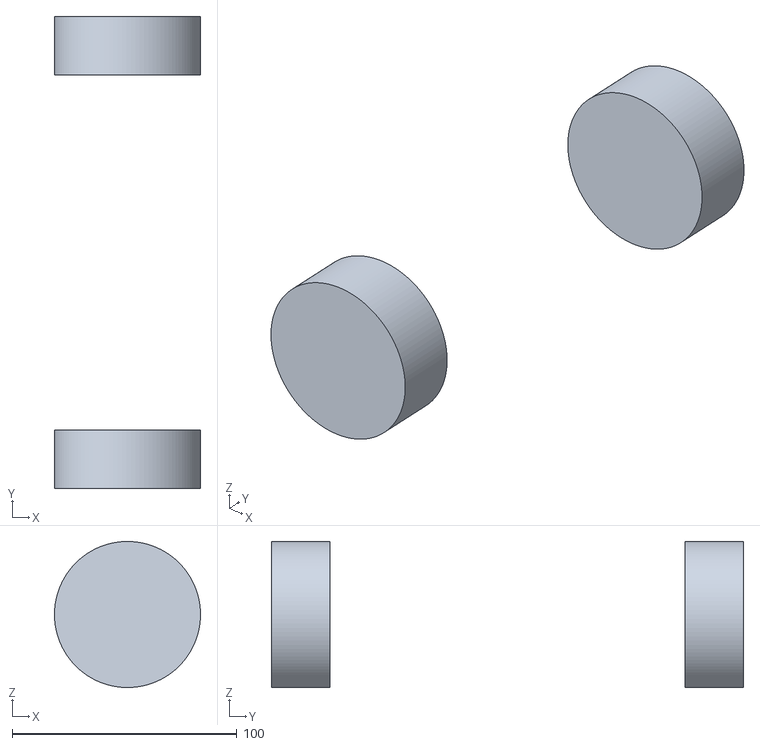
[picture p70: CAD file, 2026-10-26]
cad/model/stl/P03_wheels.stl
65.0 x 210.0 x 65.0
