jbj7667/wafer-transfer-robot/cad/print/P04_motor_brkt_R.stl

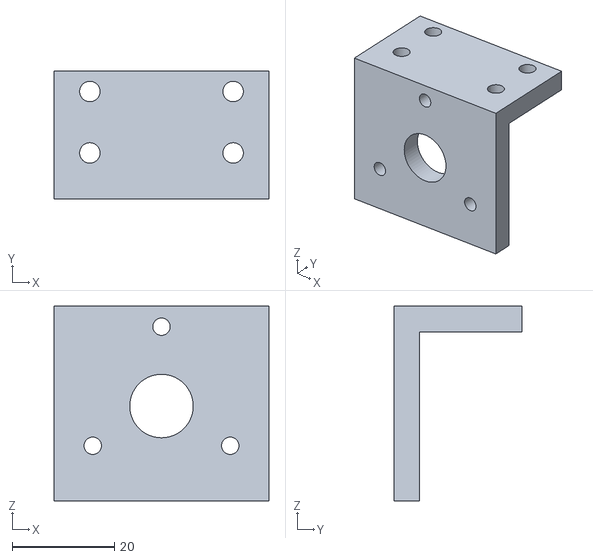
[picture p71: CAD file, 2026-10-26]
cad/print/P04_motor_brkt_R.stl
42.0 x 25.0 x 38.0
