jbj7667/wafer-transfer-robot/cad/arm_bench/P07_pulley26_hub.stl

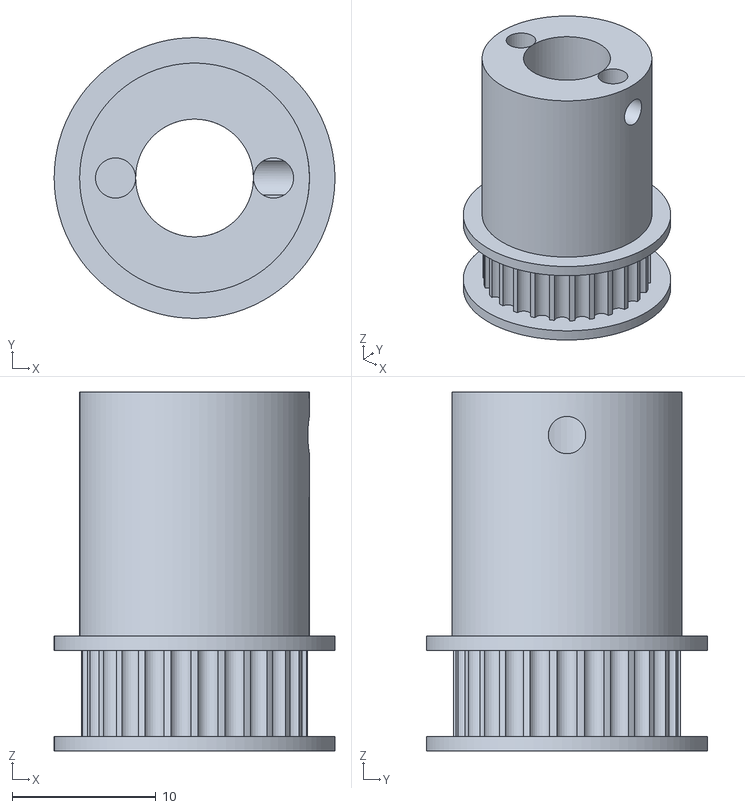
[picture p72: CAD file, 2026-10-27]
cad/arm_bench/P07_pulley26_hub.stl
19.5 x 19.5 x 25.0
