jbj7667/wafer-transfer-robot/cad/model/stl/P10_stepper.stl

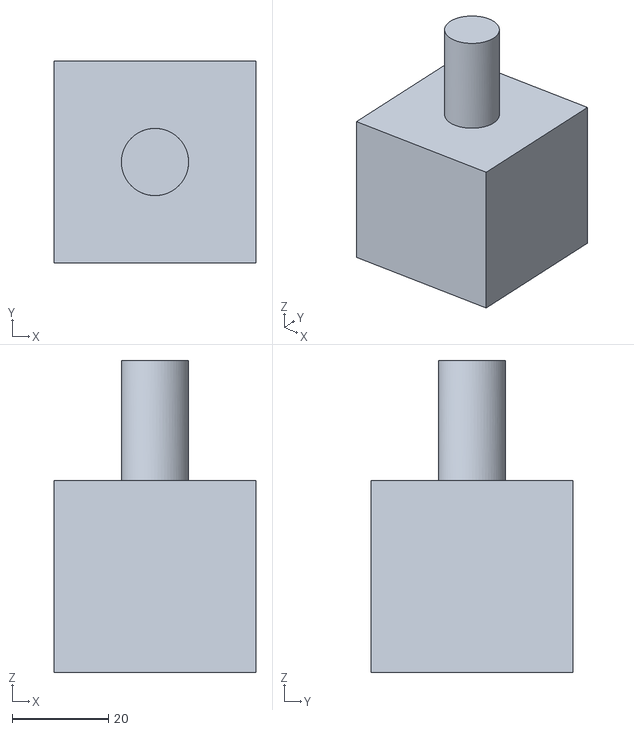
[picture p73: CAD file, 2026-10-26]
cad/model/stl/P10_stepper.stl
42.0 x 42.0 x 65.0
