jbj7667/wafer-transfer-robot/cad/arm_bench/P15_idler_x2.stl

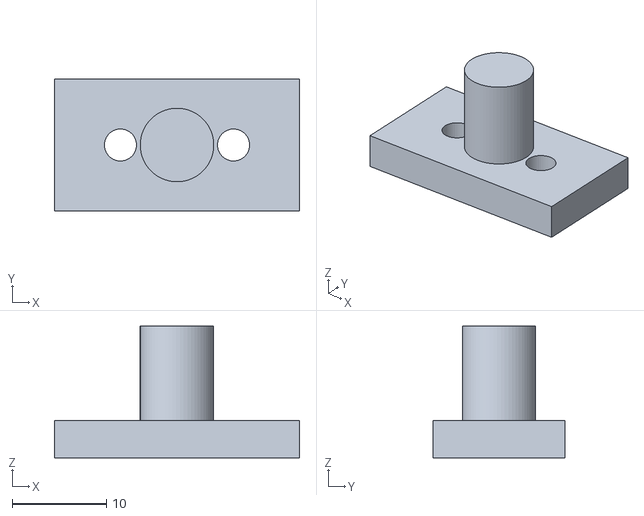
[picture p74: CAD file, 2026-10-27]
cad/arm_bench/P15_idler_x2.stl
26.0 x 14.0 x 14.0
