jbj7667/wafer-transfer-robot/cad/model/stl/P14_carriage.stl

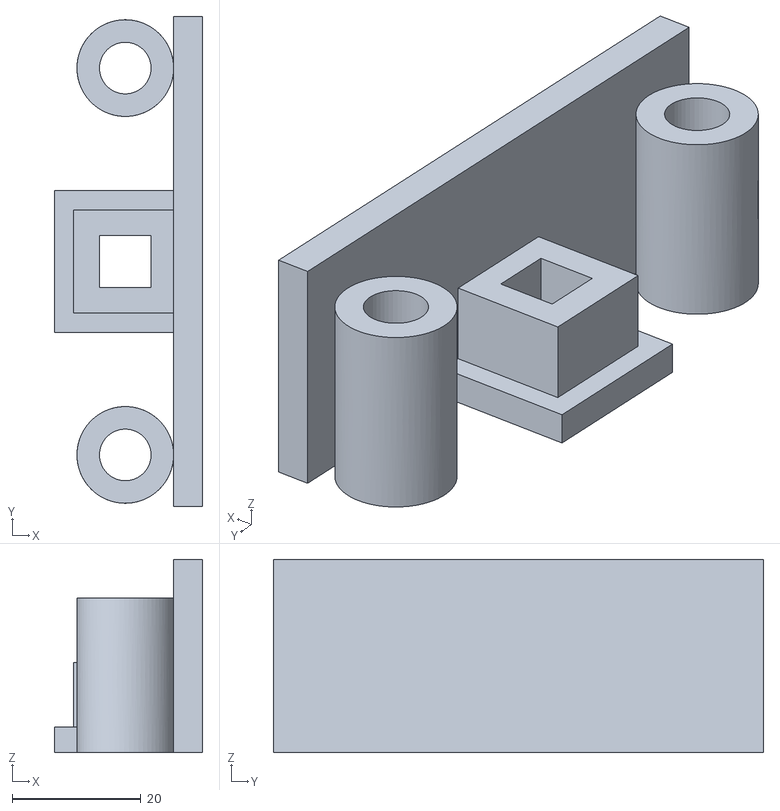
[picture p75: CAD file, 2026-10-26]
cad/model/stl/P14_carriage.stl
23.0 x 76.0 x 30.0
