jbj7667/wafer-transfer-robot/cad/print/P02_deck2.stl

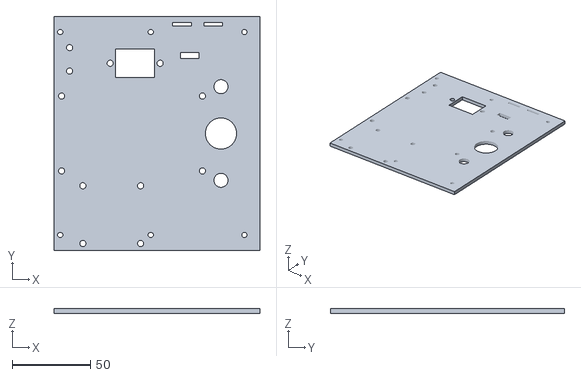
[picture p76: CAD file, 2026-10-26]
cad/print/P02_deck2.stl
132.0 x 150.0 x 3.00
