jbj7667/wafer-transfer-robot/cad/arm_bench/P02_foot_x4.stl

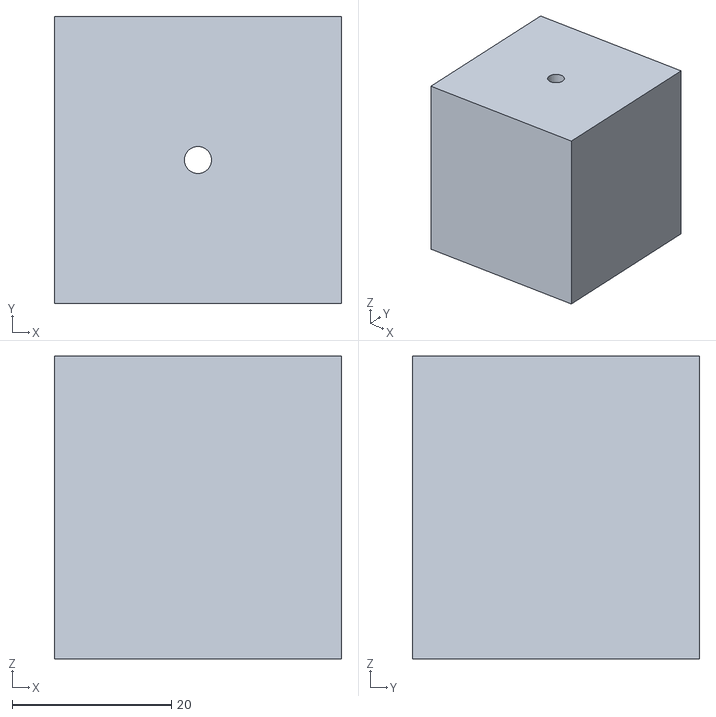
[picture p77: CAD file, 2026-10-27]
cad/arm_bench/P02_foot_x4.stl
36.0 x 36.0 x 38.0
