jbj7667/wafer-transfer-robot/cad/model/stl/P05_caster.stl

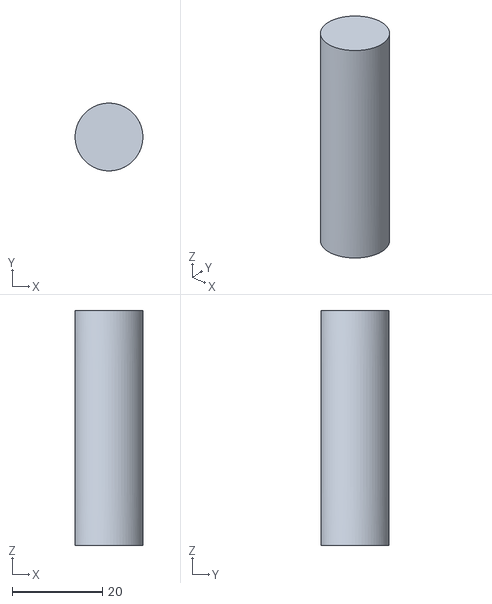
[picture p78: CAD file, 2026-10-26]
cad/model/stl/P05_caster.stl
15.0 x 15.0 x 52.0
