jbj7667/wafer-transfer-robot/cad/print/P05_caster_spacer.stl

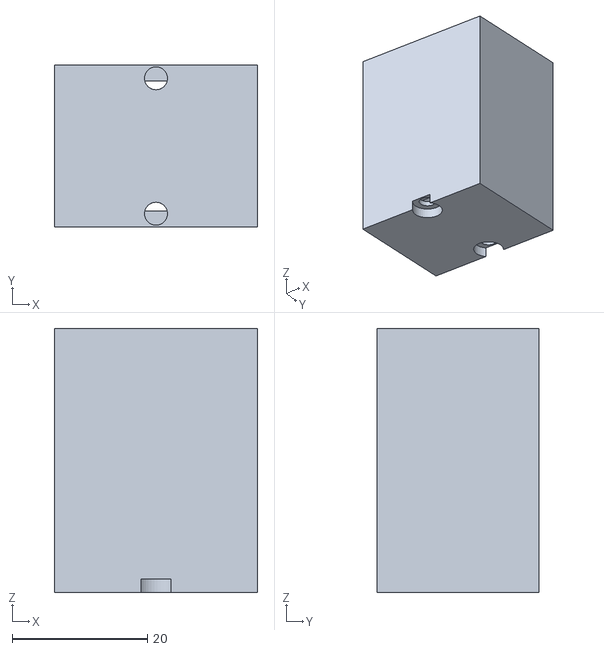
[picture p79: CAD file, 2026-10-26]
cad/print/P05_caster_spacer.stl
30.0 x 24.0 x 39.0
