jbj7667/wafer-transfer-robot/cad/model/stl/P07_standoffs.stl

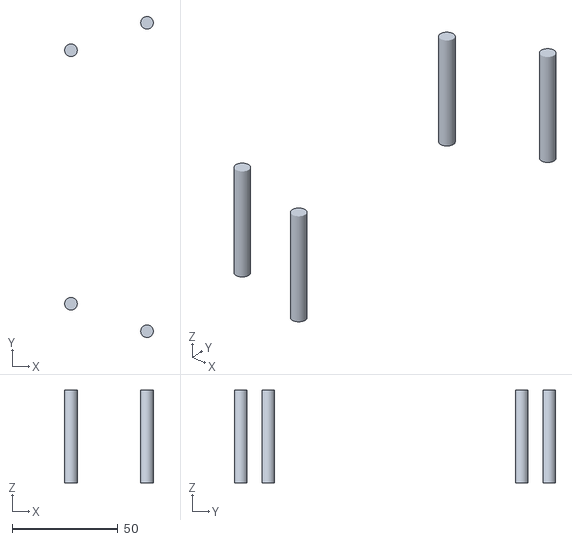
[picture p80: CAD file, 2026-10-26]
cad/model/stl/P07_standoffs.stl
42.0 x 152.0 x 44.0
