jbj7667/wafer-transfer-robot/cad/print/P08_stepper_brkt.stl

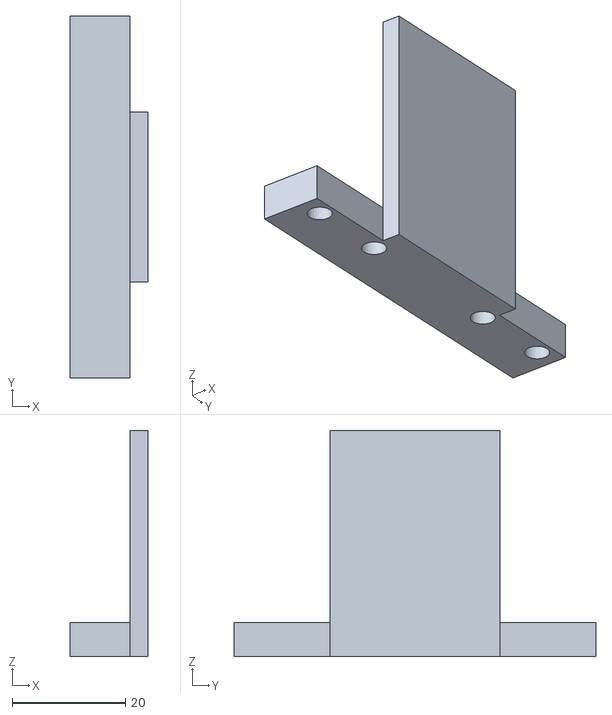
[picture p82: CAD file, 2026-10-26]
cad/print/P08_stepper_brkt.stl
13.8 x 64.0 x 40.0
