jbj7667/wafer-transfer-robot/cad/print/P08_stepper_plate.stl

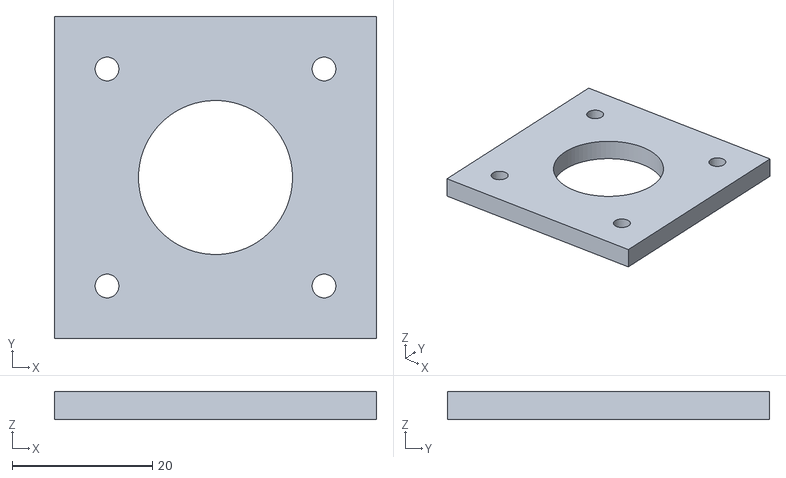
[picture p83: CAD file, 2026-10-26]
cad/print/P08_stepper_plate.stl
46.0 x 46.0 x 4.00
