jbj7667/wafer-transfer-robot/cad/print/P15_panel.stl

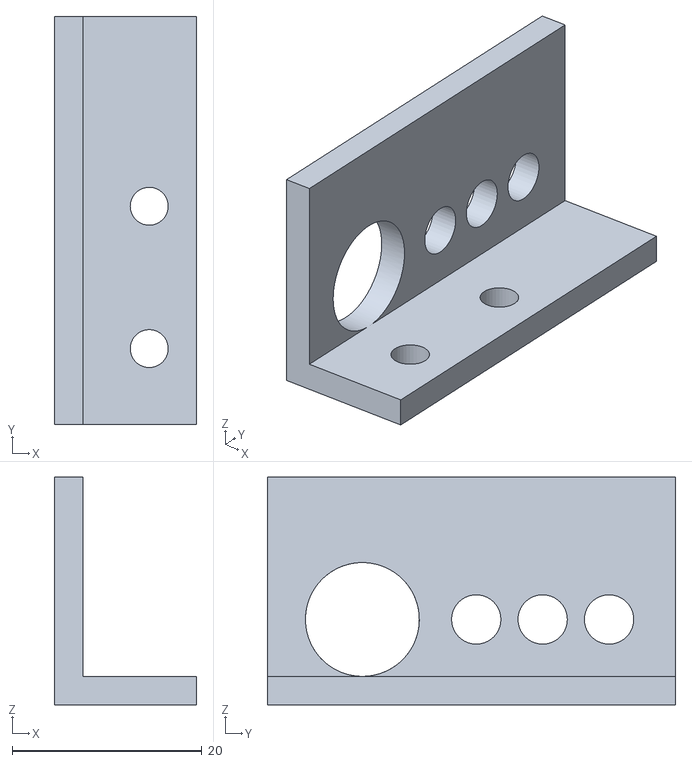
[picture p85: CAD file, 2026-10-26]
cad/print/P15_panel.stl
15.0 x 43.0 x 24.0
