jbj7667/wafer-transfer-robot/(list of files, cad)

Other CAD files:
cad/print/P11_limit_low.stl
cad/print/P09_mast_lower_L.stl
cad/print/P14_batt_cradle_R.stl
cad/print/P04_motor_brkt_L.stl
cad/model/stl/P01_deck1.stl
cad/model/stl/P02_deck2.stl
cad/model/stl/P11_leadscrew.stl
