jbj7667/wafer-transfer-robot/practice/print_notes.md

# 더미 웨이퍼 베이스 3D 프린트 노트

파일은 모두 `stl/` 폴더에 있으며 단위는 mm, 원점은 바닥 중심이다. 둘레는 96분할이고 모따기는 없다. 생성 스크립트는 `tools/make_stl.py`다.

| 파일 | 형상 | 삼각형 수 | 외형 치수 |
|---|---|---|---|
| base_200.stl | 아래 원기둥 Ø100×100 + 위 원기둥 Ø50×100 | 768 | 100×100×200 |
| base_175.stl | 아래 Ø100×100 + 위 Ø50×75 | 768 | 100×100×175 |
| base_check_ring_120.stl | Ø120 원판, 가운데 구멍 Ø16, 두께 1.2 (CD 대용) | 768 | 120×120×1.2 |

검증: 세 파일 모두 이진 STL, 모든 모서리가 정확히 2개의 삼각형에 공유되어 닫힌 메쉬이고, 외형 치수는 위 표와 같으며 부호 있는 부피가 양수라 면 방향이 바깥쪽이다. 요청문의 '3 mm' 표기는 해석이 불분명하여 두께는 1.2 mm로 만들었다.

## 출력 방향과 설정

- 방향: 큰 원기둥 바닥을 베드에 대고 세워서 출력한다(바닥이 평평하므로 서포트가 필요 없다).
- 벽(perimeter) 2겹, 채움(infill) 5~8 %, 레이어 높이 0.2 mm를 권장한다. 윗면 레이어 3~4겹이면 윗면이 덮인다.
- 100 mm 높이에서 흔들림이 있으면 브림 5 mm를 쓴다.
- CD 대용 원판은 1.2 mm이므로 6레이어(0.2 mm)다. 휘어짐을 막으려면 베드를 충분히 예열하고 브림은 쓰지 않거나 작게 쓴다. 이 원판은 가볍기 때문에 실제 CD와 무게 차이가 있다(실제 CD는 약 15 g, 이 원판은 약 4 g).

## 예상 무게와 시간

무게 계산은 부피 × 1.24 g/cm³(PLA) × 0.25(벽·채움을 합친 유효 채움률)로 했다.

| 파일 | 부피 | 예상 무게 | 출력 시간 추정 |
|---|---|---|---|
| base_200.stl | 981.0 cm³ | 약 304 g | 약 7~10 시간 |
| base_175.stl | 932.0 cm³ | 약 289 g | 약 6~9 시간 |
| base_check_ring_120.stl | 13.3 cm³ | 약 4 g | 약 15~25 분 |

출력 시간은 프린터와 슬라이서 설정을 모르는 상태의 추정이며 실제는 달라질 수 있다.

## 무게 주의

- 대회 현장에서 실제 베이스는 바닥에 고정되어 있지 않다. 로봇이 밀면 움직일 수 있다.
- 대회 베이스의 무게는 알려져 있지 않다. 모의 경기장에 실제 베이스가 있으면 저울로 재서 알아두자.
- 위에서 계산한 약 300 g은 일반적인 5~8 % 채움 출력의 값이다. 실제 베이스가 더 무겁다면 모래를 채우거나 바닥에 동전·너트를 넣어 무게를 맞춘다. 가벼운 베이스로 연습하면 로봇이 밀어버려도 감지하지 못해 대회 현장과 다른 결과를 얻을 수 있다.
- 모래를 채우려면 윗면 레이어를 0으로 하거나 중간에 일시정지하여 채운 뒤 뚜껑을 붙여야 한다. 이 STL은 속이 막힌 형태이므로 채움이 필요하면 슬라이서에서 채움률을 올리는 방법을 쓴다(채움 100 %는 약 1.2 kg).
- 바닥은 미끄러지는 정도가 대회 바닥(미확인)과 다르다. 실제 바닥 재질 확인 후 바닥에 미끄럼 방지 시트를 붙일지 정한다.
