jbj7667/wafer-transfer-robot/docs/design/fusion_guide.md

# Fusion 360 모델링 가이드 (출력물 전 부품)

기준: `cad/params.md` **v1.1** (단일 기준). 이 문서의 치수 중 params.md에 없는 값은 **[유도]** 로 표시한다(합리적 추정이므로 실측 후 갱신). 충돌 가능성이 있는 항목은 **[확인]** 으로 표시하고 §A에 모았다.
좌표계: 원점 = 좌우 바퀴 접지점 중점(바닥 Z=0), **+X 전진, +Y 왼쪽, +Z 위**, 단위 mm. 모든 부품을 이 좌표 그대로 조립 위치에 모델링한 뒤, 출력용 방향은 부품별 "출력" 항목대로 회전한다.

공통 규칙
- 체결: M3 관통 Ø3.4, M3 열삽입 인서트 구멍 Ø4.0 × 깊이 5.5(인서트는 출력물 쪽에 심고 볼트는 상대 부품에서 체결), 끼움 공차 0.2(핀·베어링은 +0.2, 센서 PCB 포켓은 +0.4).
- 벽 두께: 구조 부품 외벽 ≥ 2.4(노즐 0.4 × 6라인), 하중 부품(브래킷·캐리지·포크) 퍼리미터 4줄 이상, 인필 25~40%.
- 소재: 기본 PLA, 열 받는 부품·휨 하중 부품은 PETG. 포크는 요구사항상 PETG.
- 서포트: 가능한 한 없이. 필요하면 "트리 서포트, 오버행 > 50°만".
- Bambu A1 베드 256×256×256 기준 점검은 §D.

---

## §A. 기하 점검 결과와 남은 [확인] 항목 (v1.1 반영)

v1.1에서 해소된 쟁점(CD–마스트 겹침, 스테퍼·라인센서의 하단 원기둥 침범, 마스트 높이 246>245)은 §E 검증표에 수치로 남겼다. 아직 남은 항목:

| # | 쟁점 | 계산 | 제안 |
|---|---|---|---|
| A1 | 배터리 전단 vs 스테퍼 몸체 | v1.1 배치에서 4mm 겹침 | **확정(v1.1b/c)**: 배터리 2개를 90° 돌려 X −92~−34, Y −90~0 / 0~+90. 하판 후방을 Y ±92로 확장. Fusion v1.1b에서 간섭 0 확인 |
| A2 | 소나 Y 오프셋 −35 vs 스테퍼 Y ±21 | 튜브가 스테퍼와 겹침 | ~~`sonar_y` = −46~~ → **v1.1e: 소나를 기본 구성에서 제외**(자리에서 베이스를 겨냥할 수 없음, `cad/params.md` sonar 행). 이 문서의 소나 관련 항목(P07, 하판 소나 노치, E11)은 선택 사양으로만 읽는다 |
| A2b | 리드스크류 너트 vs 스크류 끝 | 운반 높이에서 너트 상단 = 스크류 끝(여유 0) | **확정(v1.1c)**: 너트를 캐리지 아랫면에 매달아 Z 140~154(원점) → 운반 시 여유 10 |
| A2c | 전장 250 여유 0 | X −93~157 | **확정(v1.1c)**: x_rear −92 → 전장 249 |
| A3 | 마스트 하부 블록 vs 스테퍼 | 봉 Y ±30(외곽 26~34), 스테퍼 Y ±21 → 하부 블록 폭 Y 22~38(16)만 가능, 스테퍼와 1mm 간극 | 블록은 16폭, 스테퍼 칼라는 측면 개방(§P08) |
| A4 | 림 "앞·뒤 호 ±35°" | 갈래는 y=±39~±59, 림 R61.5 위 점이 갈래 위에 놓이려면 중심선 근처엔 받침 없음 | **[유도]** 앞 호: 각 갈래 θ=40°~73°, 뒤 호: θ=107°~130° (θ는 +X 기준, 포켓 중심 기준) |
| A5 | 상판의 마스트 관통·Mega | 봉·커플러가 상판(Z100~103)을 통과, Mega 102mm가 X −93~+9 | 상판에 구멍(Ø20 @(15,0), Ø9 @(15,±30)). Mega–봉 간극 2mm(빡빡) |
| A6 | 패널 위치 | Mega가 상판 후방 전체를 차지 | 패널은 상판 후방 가장자리 좌측(Y +32~+75)에 세움 |

---

## §B. Fusion 사용자 파라미터 (Modify ▸ Change Parameters, 이름 그대로 입력)

| 이름 | 값 | 단위 | 비고 |
|---|---|---|---|
| env_L | 250 | mm | 출발 자세 한계 |
| env_W | 250 | mm | |
| env_H | 250 | mm | |
| x_rear | -93 | mm | 차체 후면 (v1.1) |
| x_front_low | 40 | mm | Z<100 구간 차체 최전방 = pocket_cx - 52 |
| x_fork_tip | 157 | mm | 포크 끝 = pocket_cx + 65 |
| track_outer | 210 | mm | 바퀴 외측 폭 상한 |
| z_top | 245 | mm | 마스트 상단 상한 |
| wheel_d | 65 | mm | |
| wheel_w | 26 | mm | |
| axle_z | 32.5 | mm | wheel_d/2 |
| motor_d | 37 | mm | |
| motor_len | 70 | mm | 기어부+모터 |
| motor_pcd | 31 | mm | 3-M3 |
| deck1_z | 52 | mm | 하판 아랫면 |
| deck1_t | 4 | mm | |
| deck2_z | 100 | mm | 상판 아랫면 |
| deck2_t | 3 | mm | |
| standoff_h | 44 | mm | deck2_z - (deck1_z + deck1_t) |
| caster_x | -75 | mm | |
| line_x | 25 | mm | |
| line_z | 10 | mm | 센서면 지면고 (5~15 슬롯) |
| line_tilt | 0 | deg | 0/5/10/15 |
| sonar_x | 10 | mm | 트랜스듀서 앞면 = x_front_low - 30 |
| sonar_y | -35 | mm | params 값 (A2: -46 권장) |
| sonar_z | 60 | mm | |
| mast_x | 15 | mm | 리드스크류 축 |
| rod_y | 30 | mm | 가이드봉 ±Y |
| rod_d | 8 | mm | |
| rod_len | 185 | mm | Z 56~241 (상부 블록 Z 241~245 덮개) |
| step_z0 | 56 | mm | 스테퍼 아래 |
| step_z1 | 96 | mm | 스테퍼 위 |
| lead_z0 | 121 | mm | 리드스크류 하단 |
| lead_z1 | 221 | mm | 리드스크류 상단 |
| fork_zmin | 155 | mm | 포크 윗면 최저 |
| fork_zmax | 215 | mm | 포크 윗면 최고 |
| pocket_cx | 92 | mm | 포켓(=CD) 중심 |
| u_inner | 78 | mm | |
| fork_t | 4 | mm | 평균 두께 |
| leg_w | 20 | mm | 갈래 폭 |
| seat_angle | 8 | deg | |
| rim_id | 123 | mm | |
| rim_h | 2 | mm | |
| fork_root_x | 28 | mm | mast_x + 13 (캐리지 앞면 mast_x + 12 = 27) |
| bat_L / bat_W / bat_H | 90 / 58 / 16 | mm | 배터리 크기, 하판 위 X -92~-2 |
| m3_clear | 3.4 | mm | |
| m3_insert_d | 4.0 | mm | |
| m3_insert_h | 5.5 | mm | |
| fit | 0.2 | mm | 끼움 공차 |

연동 수식: `axle_z = wheel_d / 2`, `standoff_h = deck2_z - (deck1_z + deck1_t)`, `fork_root_x = mast_x + 13`, `x_front_low = pocket_cx - 52`, `x_fork_tip = pocket_cx + 65`, `sonar_x = x_front_low - 30`.

---

## §C. 컴포넌트 명명·작업 순서

명명: `P<번호 2자리>_<이름>[_<변형>]`. 하위 보디는 `b_<용도>`, 스케치는 `sk_<용도>`. Fusion에서 부품별 컴포넌트를 만들고, 조립 위치(좌표 그대로)에서 모델링한다. 대칭 부품은 한쪽만 만들고 `Mirror ▸ Components`로 반대편 생성(P04_L / P04_R).

| 번호 | 컴포넌트 | 번호 | 컴포넌트 |
|---|---|---|---|
| P01 | P01_deck1 | P10 | P10_mast_upper |
| P02 | P02_deck2 | P11 | P11_limit_bracket ×2 |
| P03 | P03_standoff ×6 | P12 | P12_carriage |
| P04 | P04_motor_brkt_L / _R | P13 | P13_fork |
| P05 | P05_caster_spacer | P14 | P14_batt_cradle ×2 |
| P06 | P06_line_hanger, P06_line_head_t0/t5/t10/t15 | P15 | P15_panel |
| P07 | P07_sonar_mount | P16 | P16_wheel_hub (대체안) |
| P08 | P08_stepper_brkt | | |
| P09 | P09_mast_lower ×2 | | |

공통 작업 순서(기본 패턴): ① 원점 평면에서 윤곽 스케치(`sk_outline`) → ② Extrude(두께=파라미터) → ③ 구멍 스케치(점 배치) → Extrude Cut → ④ Fillet/Chamfer(마지막) → ⑤ 인서트·볼트 구멍은 Hole 도구 대신 스케치 원 + Cut(출력 호환 위해 직경은 파라미터 참조).

---

## §D. 부품별 사양

각 부품: 목적 / 크기 / 핵심 형상 / 구멍 / 벽 / 출력 / 소재 / 질량(추정: PLA 1.24, PETG 1.27 g/cm³, 인필 25~40%, 소수점 반올림).

### P01_deck1 하판
- 목적: 모터·배터리·스테퍼·마스트의 바닥 플랫폼.
- 크기: X −93~+40, Y ±75, Z 52~56 → **133 × 150 × 4** **[유도: Y ±75는 휠 내측면(±79)보다 4 안쪽]**. 모서리 R6.
- 형상: 아랫면 Z=52. 모터 브래킷 플랜지용 구멍 쌍 2세트, 캐스터 구멍(X=−75, Y=0), 라인센서 행어 구멍, 소나 노치(앞변 X 5~40, Y = sonar_y ±25, 깊이는 소나 PCB 하단 Z50 허용을 위해 **전 두께 관통 컷** **[유도]**), 배터리 크래들 구멍(X −92~−2, 좌우 나란히: 크래들 Y 중심 ±32; 스테퍼와의 겹침은 A1), 스테퍼 브래킷 구멍(X=15 중심 4개), 마스트 하부 블록 구멍 2쌍((15, ±30)), 케이블 슬롯 3개 12×4.
- 구멍(전부 M3 관통 Ø3.4, 아래 계수는 개수): 모터 브래킷 4+4, 캐스터 2(캐스터 실물 홀 간격 실측 후 확정), 라인 행어 2(슬롯 아님), 배터리 크래들 4+4, 스테퍼 4, 마스트 하부 2+2, 소나 마운트 2, 스탠드오프 6(상판과 같은 패턴: (−88,±65), (−30,±65), (+30,±65)) — 총 약 36개. 종이 템플릿으로 검증.
- 벽: 4mm 단일판(퍼리미터 3 + 상하 솔리드 각 4층) — 사실상 솔리드.
- 출력: 아랫면(Z=52 면)을 베드에 올려 평평하게, 서포트 없음. 소재 PLA. **질량 ≈ 72 g** (솔리드에 가까움, 구멍·슬롯 감안).

### P02_deck2 상판 + P03_standoff
- 목적: L298·DRV8834·Mega 쉴드·HM-10·패널 장착. 스탠드오프로 하판과 결합.
- P02 크기: X −93~+40, Y ±75, Z 100~103 → **133 × 150 × 3**. 라이트닝 슬롯 가능.
- 형상: Mega+IO 쉴드 102×54(상판 위, 중심 X=−42 → X −93~+9, USB 후방): 마운트 홀 인서트 4개(Mega 홀 패턴 X 간격 90.2 / Y 간격 ≈ 48 **[유도, 실측]**). L298(43.5 □, 홀 37 4개 인서트)은 우측 Y −52, X −40. DRV8834 소켓용 25×18 창과 인서트 2개(Y +45 측). HM-10 측면 클립 슬롯 2개. 마스트 관통 구멍: 커플러/리드스크류 Ø20 @(15,0), 봉 Ø9 @(15,±30)(A5). 케이블 슬롯.
- 구멍: 스탠드오프 6 × M3 관통, Mega 4(인서트 Ø4.0×5.5), L298 4(인서트), DRV8834 2, HM-10 2, 패널 2.
- 벽: 3mm, 윗면 솔리드 3층.
- 출력: 평평(윗면 위), 서포트 없음. PLA. **질량 ≈ 50 g**.
- P03 스탠드오프: **높이 44 (= deck2_z − 56)**, 외경 Ø8, 내경 3.4 관통, 6개. 대안: M3×44 암-암 황동 스페이서 구매. 출력은 세워서 출력(서포트 없음), PLA, 개당 약 2.3 g → **14 g**. M3×8 볼트 12개 필요.

### P04_motor_brkt_L / _R 모터 브래킷 ×2
- 목적: 모터(Ø37×70, 축 ±Y)를 하판 **아래**에 고정. 모터 윗면 Z=51 < deck1_z=52.
- 크기: **42(X) × 38(Z 14~52) × 5(Y) 수직판 + 42(X) × 25(Y) × 5(Z) 상부 플랜지** — 외곽 약 42 × 30 × 40 **[유도]**.
- 형상: 수직판은 Y=±(70~75)에 배치(바깥면이 하판 가장자리와 일치). 판 중심 X=0, Z=32.5(axle_z)에 모터 기어박스 보스용 Ø12.4 구멍 + 3×M3 관통(PCD 31, 120° 간격, 각도는 실측 후 확정). 상부 플랜지는 하판 아랫면(Z=52)에 밀착, 플랜지에 인서트 구멍 4개(Ø4.0×5.5; 하판 위에서 M3×10 체결). 수직판-플랜지 사이 삼각 리브 2개(두께 4).
- 모터 몸체는 안쪽(Y 5~75)으로 뻗음 → 반대편 모터와 Y 5~(−5) 사이 10 간극.
- 벽: 판 5, 리브 4. 퍼리미터 5줄, 인필 40% (모터 진동·토크).
- 출력: 수직판 면을 베드에 눕혀(XZ 평면이 베드), 서포트 없음(플랜지 90° 오버행 → 플랜지 아래 리브가 지지, 필요 시 트리 서포트 소량). PETG. **질량 ≈ 12 g × 2 = 24 g**.
- 미러: P04_R은 Mirror(Y).

### P05_caster_spacer 캐스터 스페이서
- 목적: Pololu 3/8" 볼캐스터를 하판 아래 X=−75, Y=0에 높이 맞춰 고정(볼이 바닥에 닿는 높이로).
- 크기: 외곽 **30(X) × 24(Y) × 높이 h** , 중공 사각 타워(벽 2.4). **h = 52 − caster_h**, caster_h(캐스터 마운트면~지면 높이)는 실물 측정 후 입력(예: 측정값 13 → h = 39).
- 구멍: 윗면 Ø3.4 관통 2(하판 체결용, 하판 구멍 패턴과 동일), 아랫면 캐스터 홀 패턴 2~4개(실측), 캐스터 볼트 머리 도피용 Ø6 카운터보어.
- 출력: 세워서(윗면이 베드), 서포트 없음. PLA. **질량 ≈ 8 g**.

### P06_line_hanger + P06_line_head_t0/t5/t10/t15 라인센서 브래킷
- 목적: 66×24 PCB를 line_x=+25, 센서면 지면고 5~15 조절, 경사 0/5/10/15° 교체, 차광 후드.
- 구성: **행어(고정)** 1개 + **헤드(교체형)** 4종.
- 행어: 70(Y) × 8(X) × 높이 45(Z 7~52) 판. 상단은 하판 아랫면에 밀착, 인서트 구멍 2개로 체결(X=line_x−4=21, Y ±25). 헤드 체결용 세로 슬롯 2개: 폭 3.4, 길이 14(스트로크 10 = 지면고 5~15), Y ±25. 기본 위치 슬롯 하단에서 높이 설정, 눈금(5, 10, 15) 음각.
- 헤드: 70(Y) × 30(X) × 6 판, 윗면은 행어에 면 접촉, 아랫면에 PCB 포켓 66.4 × 24.4 × 2.5, PCB 홀 M3 2개(Y ±28) **[유도, 실측]**, 슬롯 체결 인서트 2개. 헤드 아랫면을 line_tilt만큼 기울여 가공(t5는 5°, t10 10°, t15 15°; 기울기 방향은 전방이 위로 들리는 쪽 **[유도]**: 센서는 앞쪽을 보게).
- 차광 후드: 헤드와 일체, PCB 주위 사각 스커트 72 × 30(외곽), 높이 8, 벽 1.2, 앞면 X는 +40(x_front_low)까지 제한; PCB 앞면 +37 ↔ 원기둥 시작 X42, 간극 5. 센서 소자 면이 후드 안쪽 2mm 안쪽에서 시작하도록 PCB 포켓 깊이 맞춤. 검은색 필라멘트 권장(반사 방지).
- 출력: 행어는 서 있게(측면이 베드) 대신 **눕혀서**(X 8mm 두께가 Z) 서포트 없음. 헤드는 아랫면 위로 놓고 후드가 위로 서도록(포켓 면이 상향) 출력 — 경사면 때문에 t10/t15는 서포트 없이 가능(오버행 < 45°). PLA 검정.
- 질량: 행어 9 g, 헤드 6 g × 4 = 24 g → **합 33 g** (4종 모두 포함).

### P07_sonar_mount 초음파 마운트 (매립 30)
- 목적: HC-SR04를 트랜스듀서 앞면 X=sonar_x=+10, 중심 높이 Z=60, Y=sonar_y(params −35, A2 권장 −46)에 고정하고, 앞면 +40까지 튜브로 연장해 차체 앞면과 맞춘다(30 매립).
- 크기: **52(Y) × 36(X: 2~+40 **[유도]**) × 26(Z 47~73)**.
- 형상: 후면 판(X 2~6)에 PCB 45×20×1.6 포켓(여유 +0.4), 트랜스듀서 Ø16 두 개 중심 sonar_y ±13(HC-SR04 중심 간격 26), 튜브 2개: 내경 Ø17.2, 외경 Ø20.8(벽 1.8), X 10~+40. 하판 소나 노치(P01)의 양 옆 탭에 체결: 인서트 2개(X=−4, sonar_y ±32). 조준: 수평 X 방향(하단 원기둥 기둥 중심을 향함).
- 벽: 1.8~2.4. 출력: 튜브 축이 Z 방향(앞면을 위로)으로 세워서 서포트 없음. PLA. **질량 ≈ 12 g**.

### P08_stepper_brkt 스테퍼 브래킷
- 목적: SF2421 스테퍼(42×42×40, 축 위쪽)를 하판 위 Z56~96에 고정.
- 형상: **칼라** — 후방 벽 3mm(X −9.4~−6) + 4개 코너 L탭(측면 개방), 내측 42.4 × 42.4. 하판과 접하는 4개 탭(각 12×12×4) 인서트 구멍 Ø4.0×5.5 → 하판 아래에서 M3×10 체결. 모터 상면 압착 판(별도): 46 × 46 × 4, Ø22 보스 구멍, 4×M3 관통(모터 홀 31 간격) → 모터 나사로 판을 모터에 직접 고정, 판과 칼라는 2×M3로 연결.
- 중심 X=mast_x=15 → 스테퍼 X −6~+36 (≤ x_front_low 40), Y=0. **측면(±Y) 개방** — 마스트 하부 블록(Y 22~38)과 겹치지 않도록(A3), 후방 벽 + 4개 코너 탭 구성.
- 출력: 칼라는 탭면이 베드, 판은 평평. PETG(모터 발열). **질량 ≈ 25 + 5 = 30 g**.

### P09_mast_lower 마스트 하부 블록 ×2
- 목적: 가이드봉 Ø8 하단 클램프(Z 56 시작).
- 크기: **24(X) × 16(Y) × 16(Z 56~72)** 각 1개, 중심 (15, ±30) → X 3~27, Y 22~38.
- 형상: 봉 구멍 Ø8.2 블라인드 깊이 12(봉이 바닥에서 시작), 분할 슬릿(두께 1)과 M3 조임 볼트(Y방향 관통 + 인서트) 1개. 하판 체결: 인서트 2개 → 하판 아래서 M3×10. 
- 출력: 바닥 면이 베드, 서포트 없음. PLA. **질량 ≈ 7 g × 2 = 14 g**.

### P10_mast_upper 마스트 상부 블록
- 목적: 봉 상단 클램프 + 리드스크류 상단 지지(608 베어링 또는 출력 부싱).
- 크기: **76(Y) × 30(X) × 25(Z 220~245)** 중심 (15, 0) → X 0~30. 상면 Z=245.
- 형상: 봉 구멍 Ø8.2 ×2 (Y ±30), 아래서 깊이 21 블라인드(봉 상단 Z241, 위 4mm 덮개 Z241~245), 각 봉에 분할 슬릿 + 인서트 M3 조임. 중앙(Y=0)에 리드스크류 상단 부싱: **608 포켓** Ø22.2 × 깊이 7.2, 아래쪽에서 삽입(포켓 윗벽 두께 5, 중앙 관통 Ø9 — 리드스크류 상단은 Z221이므로 베어링 윗면 Z227.2… 포켓 하면 Z220에 베어링 7.2 → 베어링 윗면 Z227.2, 리드스크류가 베어링 안으로 7mm 들어감 **[유도]**). 대안 부싱(베어링 없을 때): Ø8.2 블라인드 구멍. 베어링 탈락 방지 C형 클립 홈 또는 얇은 캡(3mm).
- 벽 ≥ 3. 출력: 상면이 베드(포켓 아래 열림 → 포켓이 위로 열리게 뒤집음: 베어링 포켓 면이 위, 서포트 없음). PLA 또는 PETG. **질량 ≈ 40 g** (솔리드에 가깝게).

### P11_limit_bracket ×2 리밋 스위치 브래킷
- 목적: 하단(원점)·상단(과주행) 마이크로스위치(레버형, 약 28×16×10) 고정.
- 구조: **봉 클램프 칼라** — 봉(Ø8)에 끼워 위치 조절 가능. 칼라 외경 Ø18, 높이 14, 분할 슬릿 + M3 조임 1개. 스위치 암: 칼라에서 안쪽(Y방향, 봉→중심) 20 돌출, 끝에 스위치 홈 + M2.5 나사 2개(홀 간격 실측, 약 9.5).
- 하단 스위치: y=−30 봉, Z≈118(캐리지 하단 121 아래, 레버가 닫히는 위치 = 포크 윗면 155 시점) **[유도]**; 상단 스위치: y=+30 봉, 캐리지 상단이 닿는 위치 Z≈214(포크 윗면 218 시점 = 215+3) 아래에서 위를 향해 레버가 닿도록 위/아래 반전 장착. 조인 위치는 펌웨어 보정 가능하게 클램프 슬라이드 방식.
- 출력: 칼라 축이 Z, 서포트 없음. PLA. **질량 ≈ 6 g × 2 = 12 g**.

---

### P12_carriage 캐리지
- 목적: 포크를 승강축에 연결. LM8UU ×2(봉 Y ±30) + T8 플랜지 너트(Y=0) + 상향 IR + 포크 장착면 X=+28.
- 크기: **Y ±45(90) × X 3~27(24, 앞면 ≤ +27) × Z 높이 30** **[유도]**. 포크 윗면 Z=f 일 때 캐리지 Z = (f−34)~(f−4): 포크 판(4)이 캐리지 상면에 얹힘. 원점(f=155): Z 121~151, 최고(f=215): Z 181~211, 최고 위치 캐리지 상단 211+… (limit_high 시 f=218 → 상단 214 < 상부 블록 하단 220, 여유 6).
- 형상(조립 좌표, f=155 기준 Z 121~151):
  - LM8UU 포켓 ×2: Ø15.2(15+0.2) 관통, 길이 24 (Z 124~148 사이 중앙), 중심 (15, ±30). 고정: 베어링 유격 압입 + 위·아래 얇은 립(Ø13) 또는 M3 조임 밴드 슬릿(인서트 2개/포켓).
  - T8 너트 포켓: 중심 (15, 0), 너트 몸체 Ø10.2 관통, 플랜지 Ø22 포켓 깊이 3.6(윗면 쪽), 플랜지 홀 4× M3(PCD 16): 인서트 Ø4.0×5.5. 너트 플랜지 상면이 캐리지 상면에 오도록 → 너트 Z 범위 약 148~151 (params 150~205 ⇔ 캐리지 상면 기준, **[유도]**).
  - 포크 장착면 X=+28(캐리지 앞면 27에 1mm 보강 판 겹침): 포크 루트 블록과 맞닿는 평면, 인서트 4개 (Y ±28, Z 두 단 간격 16) → 포크에서 M3 볼트.
  - IR 상향 마운트: 캐리지 앞면 아래로 돌출 암(두께 4)으로 GP2Y0A41(29.5×13×13.5) 수납 클립. IR 위치: X=pocket_cx−40=52(암 끝 X 45~59, 포크 아래), Y=0, 센서면 Z = f−45 (f=155일 때 110, 하단 원기둥 상단 100보다 10 위), 위를 향함, 홀 M2.5×2 간격 실측.
- 벽 ≥ 4(퍼리미터 5줄), 인필 40%. 
- 출력: 뒷면(X 3면)을 베드로 눕혀서, 베어링 구멍 수직(Z 축)이 되도록 세운 자세가 정밀. 권장: **베어링 축(Z)이 출력 Z가 되게 세워서 출력**(원형도), IR 암은 서포트 필요(트리). PETG. **질량 ≈ 45 g**.

### P13_fork 포크 (핵심 부품)
- 목적: CD를 아래에서 받쳐 운반. U 78, 8° 원추 시트, 림 Ø123 앞·뒤 호, 넥 접촉 스위치 마운트.
- 크기(포켓 중심 C=(92,0) 기준): X 28~157(=x_fork_tip), Y ±59 → **129 × 118 × 약 5.4**.
- 형상:
  1. **루트 블록**: X 28~50, Y ±59, 두께 10(Z: 윗면 f 기준 f−10~f, 캐리지 장착면 X=28). 캐리지 장착 구멍 M3 관통 4개(Y ±28, Z 두 단), 모서리 필릿 R4.
  2. **갈래 2개**: Y +39~+59 / −59~−39(폭 20 → U 내폭 78), X 50~157. 윗면은 포켓 중심 축 기준 **8° 원추**: 반경 r(포켓 중심까지 평면거리)가 커질수록 높다 → 두께 최소 2.6(r=39), 최대 5.4(r=59), 평균 fork_t=4. 높이차 20·tan8°=2.8 **[유도]**. 갈래 끝(X 157 근처)은 R6 라운드.
  3. **림 턱**: 내경 Ø123(R61.5), 외경 R64, 높이 2(시트 위로). 앞 호: 각 갈래 θ 40°~73°(+X 기준 ±), 뒤 호: θ 107°~130° (A5). 림 끝 가장자리 R는 시트 최고점에서 시작.
  4. **넥 스위치 마운트**: U 바닥(루트 블록 앞면 X=50) 중앙(Y=0). 스위치(롱레버 마이크로스위치, 약 28×16×10)를 루트 블록 쪽 홈에 매립, 레버 끝 접촉점이 X=+65(포켓 중심 −27)가 되도록 U 바닥(X=50)에서 15mm 연장(넥 표면 X=67). M2.5 인서트 2개. 레버 이동 홈 폭 16, 깊이 12.
  5. **보강**: 루트~갈래 사이 아랫면 리브 2개(높이 8, 두께 3), 필릿 R6.
- 구멍: 캐리지 연결 M3 관통 4(Ø3.4), 스위치 M2.5 2, 선택: 포크 윗면 CD 감지 IR용 Ø0 (IR은 캐리지에 있으므로 없음).
- 벽: 갈래 평균 4, 루트 10, 퍼리미터 5줄, 인필 60%.
- 출력: **윗면이 위, 아랫면(리브면) 베드** — 8° 경사면은 위를 향한 완만한 경사로 서포트 불필요. 갈래 아랫면 리브와 베드면 접촉 위해 리브 하단면 = 베드. 대안: 포크를 뒤집어 윗면을 베드에 두면 시트 품질이 좋음(첫 레이어 마감) → 추천 **윗면을 베드(뒤집힘)**, 리브가 서포트 없이 위로. PETG(요구사항). **질량 ≈ 40 g**.

### P14_batt_cradle ×2 배터리 크래들
- 목적: 배터리 2개(각 90×58×16)를 하판 위 X −92~−2에 좌우 나란히(Y 중심 ±32) 고정.
- 크기(각): **93(X: −93~0, 후단 개방·스트랩) × 62(Y) × 20(Z)**: 바닥 2, 벽 2.4, 내측 90.4 × 58.4 × 16. 배터리 쪽 한 변 개방(전선 출구) 폭 30, 상단 고정 스트랩 슬릿 2개(4 × 2 벨크로/결속 밴드).
- 구멍: 하판 체결 M3 관통 Ø3.4 ×4(코너 탭, 외곽에서 4 돌출 탭 12×12).
- 두 크래들 Y 중심 ±32 → 외곽 Y 1~63 / −63~−1, 하판 Y ±75 안. 스테퍼와의 겹침은 A1.
- 출력: 바닥이 베드, 서포트 없음. PLA. **질량 ≈ 14 g × 2 = 28 g**.

### P15_panel 버튼·LED·라벨 패널
- 목적: 상판 후방 위에 시작 버튼·LED·라벨 "정비제" + 팀번호.
- 크기: **43(Y) × 3(X) × 20(Z) 수직 판 + 하부 L 플랜지 15(X)**, 상판 후방 가장자리 좌측(Y +32~+75, X −93~−78), 판은 후방을 향함(A6) **[유도]**.
- 구멍: 푸시버튼 Ø16 (또는 Ø12) 1~2개, LED 5mm 홀 Ø5.2 ×3(+립), 팀번호·"정비제" 라벨 오목 홈 40 × 8 × 0.6 (스티커/컬러 교체 인쇄 대응), 상판 체결 인서트 2~4.
- 출력: 라벨면을 베드(뒤집어서) 후면 서포트 없음; 색 교체로 글씨 컬러. PLA. **질량 ≈ 12 g**.

### P16_wheel_hub 휠 허브 (대체안)
- 목적: 기성 65mm 휠이 6mm D축에 맞지 않을 때의 허브 어댑터.
- 크기: Ø24 × 18 허브: D축 구멍 Ø6.1(D플랫 5.4), 휠 홀 패턴 PCD 실측 (예: M3 ×3), 세트스크류 M3 인서트(축 방향 직교 1개).
- 출력: 축이 Z로 서게, 서포트 없음. PETG. 질량 ≈ 8 g × 2 = 16 g (**총계에서 제외 — 대체안**).

---

## §E. 조립 검증 (수치)

| # | 검증 | 계산 | 판정 |
|---|---|---|---|
| E1 | 출발 크기 ≤ 250³ | X −93~+157=250, Y: 바퀴 외측 210, Z 최대 245 | 충족 (X는 정확히 한계, 포크 끝 오차 0 허용) |
| E2 | x_front_low ≤ +40 (Z<100) | 하판 앞변 +40, 소나 튜브 끝 +40, 라인센서 후드 앞 +40(PCB 앞면 +37), 스테퍼 앞면 +36. 원기둥 시작 X = 92−50 = 42 | 충족 (PCB 간극 5, 하판·튜브 2) |
| E3 | 포크 끝 ≤ +157 | 갈래 끝 X=157 = pocket_cx+65; 림 앞 호 최대 x = 92+64·cos40° = 141 | 충족 |
| E4 | 라인센서 ≥ 55 from 기둥 중심(픽) | 픽 시 기둥 중심 = 차체 X 92 → 92 − 25 = **67 ≥ 55**; PCB 앞면 37 ↔ 원기둥 시작 42, 간극 5 | 충족 (정지선 후 크리프 ≈ 33) |
| E5 | 포크 Z155에서 하단 원기둥(상단 Z100) 통과 | 포크 아랫면 = 155 − 5.4 = 149.6 → 49.6 여유 / IR 센서면 Z=155−45=110 → 10 여유 / 캐리지 하단 121 | 충족 |
| E6 | 픽: 기둥 윗면 −10 | 175행: 기둥 윗면 175 → 포크 윗면 165에서 접근(= 윗면 −10), 200행: 190. 포크 윗면 ≥ 155 ✓ | 충족 |
| E7 | 상단 한계 | 상부 블록 상면 245, 봉 상단 241(블록 내), 캐리지 최고 상단 214 → 블록 하단 220, 여유 6 | 충족 |
| E8 | 스탠드오프 | 44 = 100 − 56 | 충족 |
| E9 | 모터–하판 | 모터 최상 Z=32.5+18.5=51 < 52 | 충족(1 여유 → 브래킷 두께로 0.5 조정 가능) |
| E10 | 휠–하판 | 휠 내측 Y 79 vs 하판 75 | 충족(4) |
| E11 | 소나 | 트랜스듀서 앞면 X=10, 픽 시 원기둥 면 X=42까지 32 > 20 (HC-SR04 최소) | 충족 (Y 오프셋은 A2) |
| E12 | CD–마스트 | CD 후방 가장자리 X = 92−60 = **32** vs 캐리지 앞면 ≤ 27 (간극 5), 포크 루트 X28 앞면 32 이전, 리드스크류 X 19·봉 X 11~19 | 충족 |

---

## §F. Bambu A1 베드 점검 (256 × 256 × 256)

| 부품 | 출력 자세 외곽 (mm) | 판정 |
|---|---|---|
| P01 deck1 | 133 × 150 | OK |
| P02 deck2 | 133 × 150 | OK |
| P03 ×6 | Ø8 × 44 (한 번에 6개) | OK |
| P04 ×2 | 42 × 42 × 40 | OK |
| P05 | 30 × 24 × 39 | OK |
| P06 행어·헤드 ×4 | 70 × 45, 70 × 30 | OK |
| P07 | 52 × 36 × 26 | OK |
| P08 | 48 × 48 × 40 + 판 46 × 46 | OK |
| P09 ×2 | 24 × 16 × 16 | OK |
| P10 | 76 × 30 × 25 | OK |
| P11 ×2 | Ø18 × 34 | OK |
| P12 | 90 × 30 × 30 | OK |
| P13 | 129(118 폭) × 5.4 | OK |
| P14 ×2 | 93 × 62 × 20 | OK |
| P15 | 43 × 18 × 20 | OK |
| P16 ×2 | Ø24 × 18 | OK |

가장 큰 부품이 150 × 133으로 베드 한 변(256)의 59% — 하판+상판을 한 번에 출력하려면 256 안에 나란히(150+150=300) 안 들어가므로 각각 출력한다. 최대 높이 44(스탠드오프) ≪ 256.

---

## §G. 총 질량 추정과 필라멘트 비용 (20 KRW/g)

| 부품 | 수량 | g | 합 g | 소재 |
|---|---|---|---|---|
| P01 deck1 | 1 | 72 | 72 | PLA |
| P02 deck2 | 1 | 50 | 50 | PLA |
| P03 standoff | 6 | 2.3 | 14 | PLA |
| P04 motor bracket | 2 | 12 | 24 | PETG |
| P05 caster spacer | 1 | 8 | 8 | PLA |
| P06 hanger + 헤드 4 | 1+4 | 9 + 4×6 | 33 | PLA(검정) |
| P07 sonar mount | 1 | 12 | 12 | PLA |
| P08 stepper bracket | 1 | 30 | 30 | PETG |
| P09 mast lower | 2 | 6 | 12 | PLA |
| P10 mast upper | 1 | 40 | 40 | PLA/PETG |
| P11 limit bracket | 2 | 6 | 12 | PLA |
| P12 carriage | 1 | 45 | 45 | PETG |
| P13 fork | 1 | 40 | 40 | PETG |
| P14 battery cradle | 2 | 14 | 28 | PLA |
| P15 panel | 1 | 6 | 6 | PLA |
| **합계(P16 제외)** | | | **424 g** | |

- 서포트·퍼지·실패 여유 +15% → **약 490 g**.
- 필라멘트 비용: 424 g × 20 = **8,480 원**, 여유 포함 490 g × 20 = **약 9,800 원 (≈ 10,000 원)**.
- 소재별: PETG 약 139 g(P04·P08·P12·P13), PLA 약 285 g. 1 kg 스풀 각 1개(PLA 1, PETG 1)면 충분(스풀 단가가 g당 20원이면 2 kg ≈ 40,000 원 구매, 소요분 약 10,000 원).
- 질량은 모두 추정이며, 슬라이서(Bambu Studio) 값으로 교체한다.
