jbj7667/wafer-transfer-robot/cad/print/view_print_iso.png

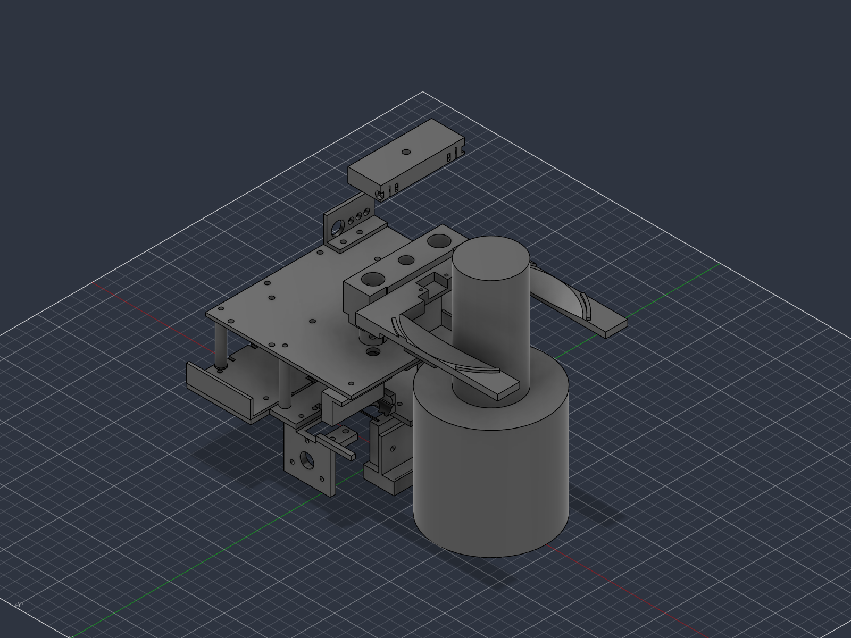
cad/print/view_print_iso.png
