jbj7667/wafer-transfer-robot/cad/print/view_print_right.png

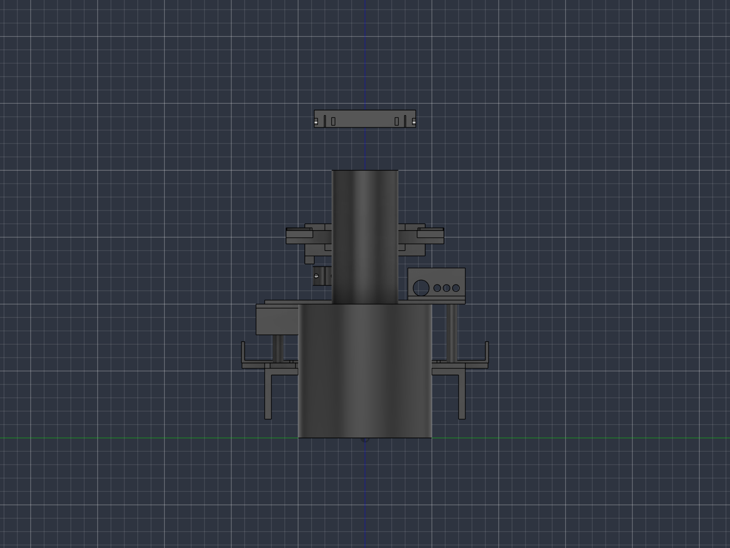
cad/print/view_print_right.png
