jbj7667/wafer-transfer-robot/cad/arm/result_L180.txt

== L 180 {'T': (-8, 2), 'stow': (216, 108), 'mbr': 45, 'mb': 40, 'sb': 0} unplaced []
STOW bbox X -89.0..157.6 (246.6) Y -123.8..122.0 (245.8) Z 0..245.0 margins X 3.4 Y 4.2 Z 5.0
STOW min clearance arm vs body/mast 4.0 ('car_plate_m', 'Zstepper')
REACH b5 th 73.4 R 386.0 Rw 322.0 phi 26.6 sing_margin 38.0 dz 0 slot-neck off 0.00 clr_bases 10.0('fork0', 'base5_CD') clr_body 4.0('car_plate_m', 'Zstepper') coll [] fieldy_min 54.6 elbow_y(271.1)
   CoM (7,38) M 2831g tip margin 39.6
REACH b6 th -73.4 R 386.0 Rw 322.0 phi 26.6 sing_margin 38.0 dz 0 slot-neck off 0.00 clr_bases 10.0('fork0', 'base6_CD') clr_body 4.0('car_plate_m', 'Zstepper') coll [] fieldy_min 54.6 elbow_y(116.9)
   CoM (19,-15) M 2831g tip margin 63.3
REACH b3 th 101.5 R 326.5 Rw 262.5 phi 43.2 sing_margin 97.5 dz 25 slot-neck off 0.00 clr_bases 10.0('fork0', 'base3_CD') clr_body 7.5('turntable', 'mastrod1') coll [] fieldy_min 105.0 elbow_y(386.9)
   CoM (-7,31) M 2831g tip margin 32.6
REACH b4 th -101.5 R 326.5 Rw 262.5 phi 43.2 sing_margin 97.5 dz 25 slot-neck off 0.00 clr_bases 10.0('fork0', 'base4_CD') clr_body 7.5('turntable', 'mastrod1') coll [] fieldy_min 105.0 elbow_y(145.5)
   CoM (8,-15) M 2831g tip margin 54.8
REACH b1 th 131.6 R 361.2 Rw 297.2 phi 34.4 sing_margin 62.8 dz 25 slot-neck off 0.00 clr_bases 10.0('fork0', 'base1_CD') clr_body 7.5('turntable', 'mastrod1') coll [] fieldy_min 105.0 elbow_y(414.6)
   CoM (-18,25) M 2831g tip margin 29.0
REACH b2 th -131.6 R 361.2 Rw 297.2 phi 34.4 sing_margin 62.8 dz 25 slot-neck off 0.00 clr_bases 10.0('fork0', 'base2_CD') clr_body 7.5('turntable', 'mastrod1') coll [] fieldy_min 105.0 elbow_y(262.7)
   CoM (-7,-15) M 2831g tip margin 43.5
REACH min field y 54.6
SWING row top 175 th 73.4->286.6: min clearance 7.5 at th 73 pair ('turntable', 'mastrod1') (bases 36.1 body 7.5)
SWING row top 200 th 101.5->258.5: min clearance 7.5 at th 102 pair ('turntable', 'mastrod1') (bases 9.9 body 7.5)
SWING row top 200 th 131.6->228.4: min clearance 7.5 at th 132 pair ('turntable', 'mastrod1') (bases 30.3 body 7.5)
SWING overall min clearance 7.5 ; min field y 41.8 ; min tip margin 37.4
