jbj7667/wafer-transfer-robot/cad/arm_bench/target_A3.pdf

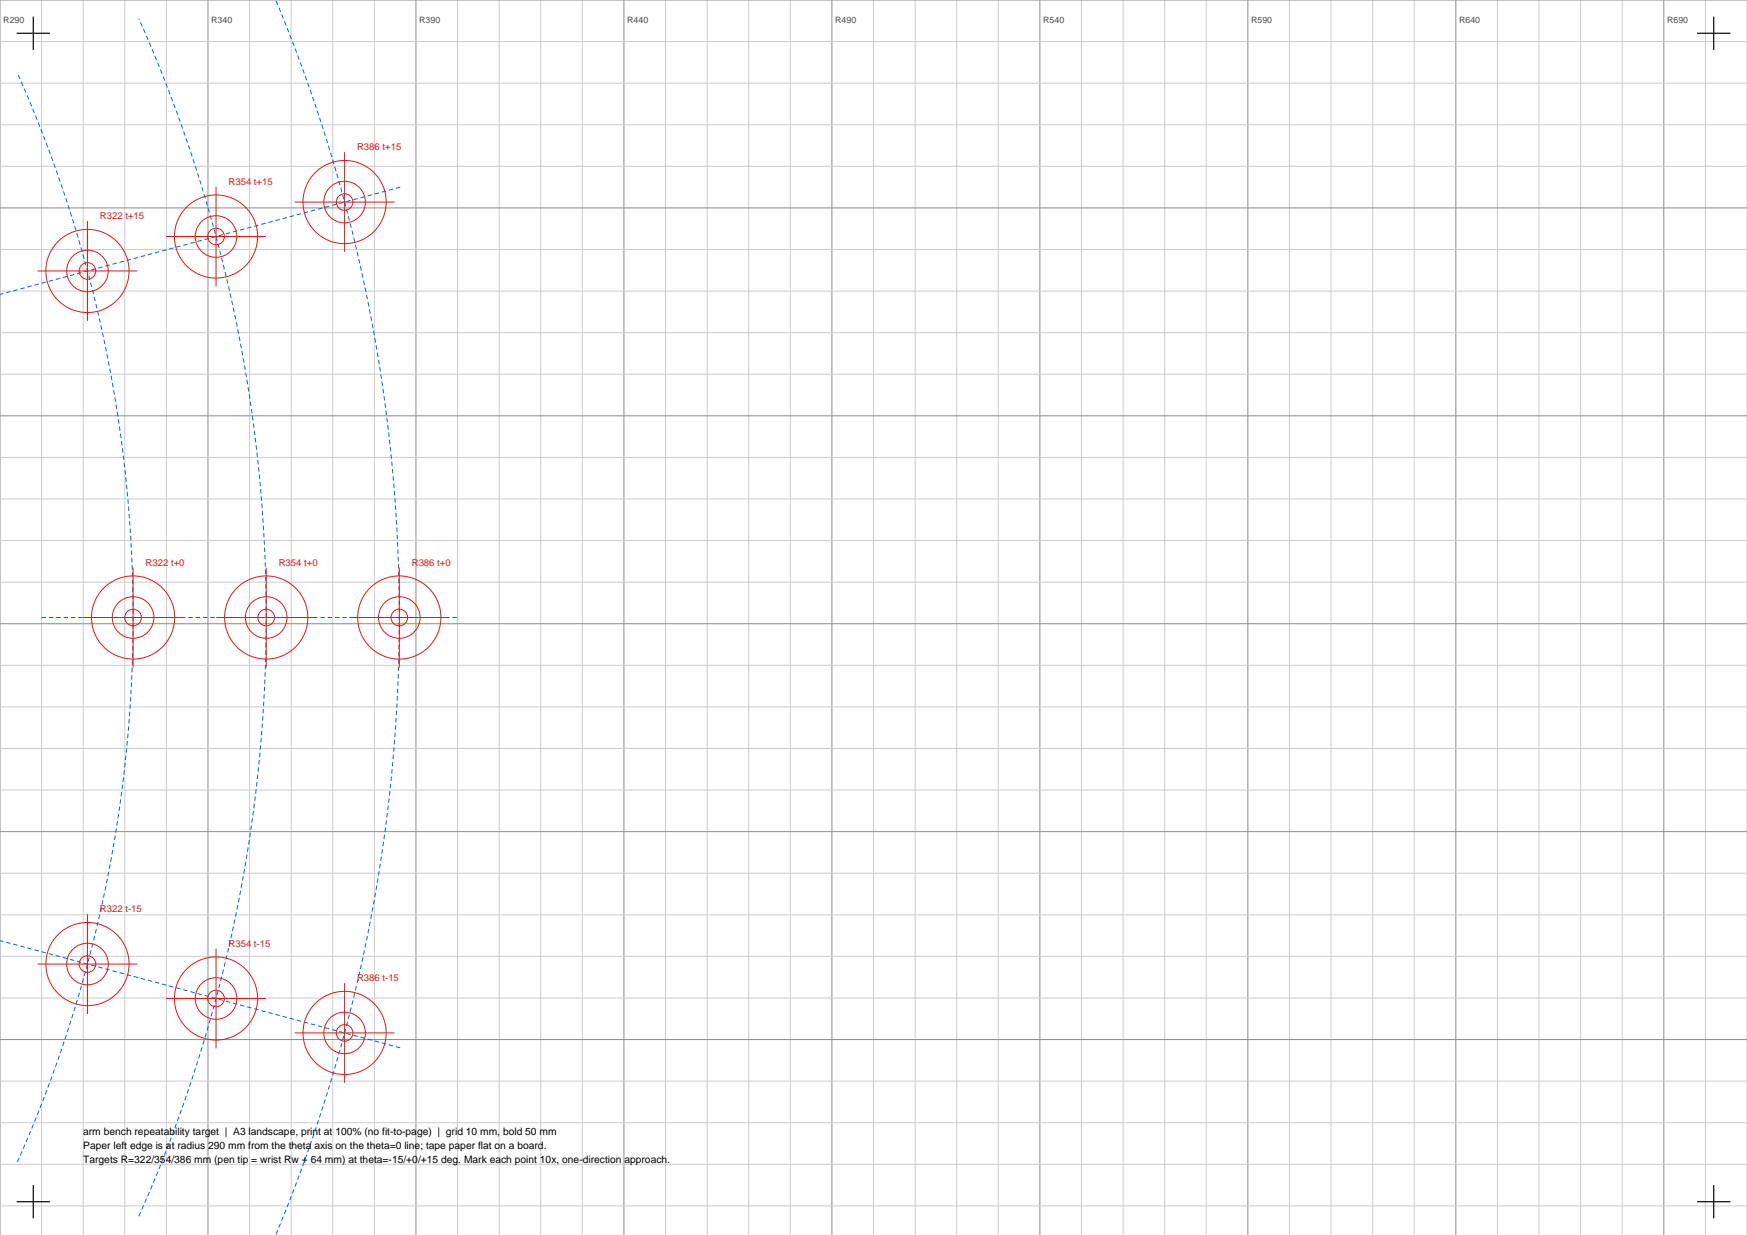
[picture p88: page 1]

arm bench repeatability target | A3 landscape, print at 100% (no fit-to-page) | grid 10 mm, bold 50 mm
Paper left edge is at radius 290 mm from the theta axis on the theta=0 line; tape paper flat on a board.
Targets R=322/354/386 mm (pen tip = wrist Rw + 64 mm) at theta=-15/+0/+15 deg. Mark each point 10x, one-direction approach.
