jbj7667/wafer-transfer-robot/(commit log)

2026-10-26 공개 저장소용 public/ 초기 구성: README, LICENSE(MIT), 요구사항 요약
    학과 원본 자료·타 팀 자료·실명은 포함하지 않음(본인 서술 요약만).
2026-10-26 WIP 3단계: 아레나 A/B/D 결과, 펌웨어 초안, 세션 인계 메모
    - public/docs/arena: 승강·엔드이펙터·레드팀 관점 각 25안
    - public/firmware/wafer_robot: 타이머 인터럽트 기반 스켈레톤(컴파일 미검증)
    - _handoff/HANDOFF.md: 중단 작업, 유력 최종안, 재개 순서
2026-10-26 펌웨어 컴파일 검증·버그 수정 반영 + 인계 메모 갱신
    - 첫 교차점 heading 버그, PD 미분항 리셋, 스텝 지연, ISR 부하 수정
    - arduino:avr:mega 경고 없이 컴파일(플래시 4%, RAM 8%)
    - HANDOFF.md에 하드웨어 튜닝·보완 항목 추가
    [lift.cpp, sense.cpp]
2026-10-26 아레나 C 결과와 부품 CAD 모델 추가, 인계 메모 갱신
    - public/docs/arena/C_system.md: 시스템·이송 전략 관점 25안 (총 100안 확보)
    - cad/vendor: 익명 다운로드 가능한 STEP/STL 18종 + MANIFEST (라이선스·출처·치수)
    - GrabCAD 로그인 필요 4종은 링크 파일로 대체
2026-10-26 3-1 최종 메커니즘 선정: 단일 승강축 와이드 C-링 포크 + 넥 접촉 정지
    - 100안 중 A01+D01+B02+B03+D13+D17 결합안 채택, 동작 모터 1개
    - 아레나가 놓친 기하 제약 2가지(센서-하단원기둥 간섭, 상단행 상대구역 침범)와 해결 규칙
    - 기준 치수, 행 단위 동작 시퀀스, 정량 점검, 대체 경로
2026-10-26 3단계 구현: 펌웨어 메커니즘 반영, BOM·배선·상태머신 문서, BLE 앱 설계
    - 펌웨어: 넥 접촉 크리프(A_CREEP/A_CREEP_TIMED), 남쪽 경유 180° 회전, 상단행 부분 회전,
    회전 가속 램프, 단락 제동, 고장 시 승강 정지, 컴파일 경고 0 (플래시 4%, RAM 9%)
    - 초음파 30mm 매립 + 고장 임계 20mm로 정상 픽 오탐 방지 (메인 판단)
    - docs/design: bom.md(추정 82,400원), wiring.md, state_machine.md
    - app: App Inventor 블록 설계서, 프로토콜, 로봇 에뮬레이터 스케치
    - PLAN.md 3-1 결정 반영, 교수·Q&A 발송 초안
2026-10-26 4단계: 규정 교차검증표와 최종 보고서 아웃라인
    - compliance.md: 제작 14항·경기 8항·추가기능 5항 대조. 위반 0, 조건부 6(실측·교수 확인)
    - final_report_outline.md: 학부 필수 다이어그램·부록 항목 반영
    - 교수 문의 초안에 추가기능④(리밋 스위치 원점) 인정 여부 추가
2026-10-26 펌웨어: 자가 점검(SELFTEST)·선 이탈 탐색(SEARCH) 추가, 문서 동기화
    - HOMING 후 상향 IR(포크 비어 있음)·라인센서·모터 전압 확인 → T 메시지 송신 (추가기능 ④ 보강)
    - 선 이탈 시 제동 → 마지막 쪽 → 반대쪽 탐색 회전 후 추종 재개
    - state_machine.md: 재출발 규정 설명 오류 수정(2회 허용), SELFTEST·SEARCH 반영
    - 컴파일 경고 0 (플래시 12,924B 5%, RAM 835B 10%)
    Claude-Session: https://claude.ai/code/session_01MMWkHVTeAGAnf3g2hdXQ8z
    [comm.cpp, comm.h, config.h, sense.cpp, sense.h, wafer_robot.ino]
2026-10-26 CAD 기준 파라미터표 확정, BOM 리드스크류·가이드봉 길이 수정
    - cad/params.md: 좌표계·주행부·센서·승강부·포크 치수를 모델·가이드·BOM의 단일 기준으로
    - 리드스크류 150 → 100mm(150이면 마스트 271mm로 250 초과), 가이드봉 150 → 190mm
    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
2026-10-26 Fusion 레이아웃 모델 v1.1b·간섭 검사, 기하 v1.1c, 상단행 기동 개정
    - Fusion: 19개 부품 + 기준 베이스. 외곽 250x210x245, 픽·200행·운반 자세 간섭 0
    (클라우드 Default Project/wafer_robot_v1_1 저장, STL·뷰 이미지 포함)
    - 모델 검사로 찾은 설계 오류 수정: CD-마스트 겹침, 스테퍼·라인센서의 하단 원기둥 침범,
    마스트 높이 초과, 배터리-스테퍼 겹침(가로 배치), 너트 여유 0(하향 장착), 전장 여유(후면 -92)
    - 상단행: 오버슈트 침범·센서 이탈 재계산 → 15mm 후진 + 시간 기반 90도 + 편향 진입(A_ACQUIRE)
    - fusion_guide.md(부품별 치수·출력·질량 약 424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
    [P01_deck1.stl, P02_deck2.stl, P03_wheels.stl, P04_motors.stl, P05_caster.stl, P06_batteries.stl, P07_standoffs.stl, P08_mega.stl]
2026-10-26 연습 경기장 자료: 실척 타일 PDF(24장), 테이프 시공 가이드, 개요도, 더미 베이스 STL
    - field_tiles_A4.pdf: 1000x1000 경기장을 A4 6x4 타일로 분할, 선 폭 19.0mm(53.86pt) 실측 확인
    - field_tape_guide: 직선 12조각 좌표·길이, R100 줄·핀 방법, 자재 약 3.4m
    - base_200/175.stl, CD 대용 원판 STL (모두 닫힌 메쉬)
    - PDF 글꼴 서브셋으로 각 25MB -> 약 0.2MB
    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
    [base_175.stl, base_200.stl, base_check_ring_120.stl]
2026-10-26 모듈 시험 스케치 8종(t01~t08)과 사용 설명서
    - 모터 PWM, 라인센서(진입각 추정 포함), 스테퍼 원점·스텝 손실, 초음파, IR, BLE, 전압 보정, LED 4Hz·버튼
    - 8개 모두 arduino:avr:mega --warnings all 경고 0 (직접 재컴파일 확인), 하드웨어 미실행
    - 핀은 firmware/wafer_robot/config.h와 동일(넥 스위치 D25)
    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
2026-10-26 출력용 Fusion 모델 v1(부품 25종 STL)과 파라미터 v1.1d 결정
    - public/cad/print: P01~P16 STL, 스크린샷, 생성 헬퍼, 진행 로그. 문서 wafer_robot_print_v1 클라우드 저장
    - print_parts.md: 소재·자세·bbox·부피·추정 g(약 205g, 부피x밀도x0.35 가정)
    - 미해결 2건 결정: 초음파를 Z 77~97로 올려 상판에 매닮, 상부 블록을 Z 232~245로 얇게 하고
    상한 스위치는 달지 않음(소프트웨어 상한 + 기계 여유 12mm)
    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
    [P01_deck1.stl, P02_deck2.stl, P03_standoff_x5.stl, P04_motor_brkt_L.stl, P04_motor_brkt_R.stl, P05_caster_spacer.stl, P06_line_hanger.stl, P06_line_head_t0.stl]
2026-10-26 팔 방식(θ-R-Z) 기구학·치수 분석과 PLAN_v2 판정 기준 개정
    - arm_option.md(8개 절)와 arm_calc 계산 스크립트 5종(kin, belt, dyn, motion, fold)
    - 핵심: 접힘 250x250 수용이 최대 쟁점, 헤딩 2도=팔끝 13.5mm(방향 보정 필수), 벨트 슬랙 증폭으로
    반복정밀도 1시그마 3.3mm(경계), 질량 팔 2.8kg/포크 2.0kg, 예선 38s vs 58s, 추가 비용 약 46,500원
    - PLAN_v2 §2.3: 질량 기준을 상대 비교로 개정, 접힘 게이트 추가, 팔 펌웨어는 접힘 검사 통과 후로 보류
    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
2026-10-27 소나를 기본 구성에서 제외, Fusion 출력 모델 v1.1d 반영, 테마·캡처 도구 확인
    - 펌웨어: SONAR_ENABLED=false 기본(접근 구간은 SPEED_SLOW), 기본 11,828B / 소나 켠 12,976B 모두 경고 0
    - Fusion 출력 모델: 상부 블록 Z232~245(기계 정지 여유 12mm), 상한 스위치 선택 부품화, 소나 마운트 선택화
    (간섭 검사 4개 포즈 0건, 클라우드 wafer_robot_print_v1 저장)
    - 문서: params(v1.1e), mechanism, bom, fusion_guide, wiring, state_machine, tests README 소나 제외 반영
    - 소나 제외 이유: 설치 가능한 자리에서 정면 빔이 베이스 하단 원기둥을 빗나감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
    [P07_sonar_mount.stl, P10_mast_upper.stl, P11_limit_high.stl]
2026-10-27 팔 방식 접힘·도달 검사: 조건부 통과(L=180, 상판 244x244)
    - 접힘 외곽 246.8x246.0x245.0(여유 3.2/4.0/5.0), 6개 베이스 도달·후방 스윙·구역 경계·전도 모두 통과
    - 마스트 방위 0도는 스윙 중 충돌 -> +45도 필요. L=190은 회전대가 y=-50으로 치우쳐 비권장
    - 한계: 간섭은 단순 솔리드(상자·원기둥) 기반 SAT 계산, 벨트·나사·배선 미반영. 상판 250이면 여유 0(FAIL)
    - Fusion 문서 wafer_robot_arm_v0 저장
    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
2026-10-27 팔 방식 펌웨어 골격: 스테퍼 3축 단일 ISR, 3축 원점, 시험 콘솔
    - stepper3: Timer3 20kHz 단일 ISR로 TH·R·Z 동시 STEP, 축별 사다리꼴, 리밋 폴링, 소프트 한계
    - arm_kin: L=180, 손목-CD 64mm, 특이점 가드, 6개 베이스 표, 헤딩 보정
    - 콘솔: h/g/b/p/x/s/rep/trim/speed (+j, hc), rep은 항상 같은 방향 접근
    - 경고 0 (flash 17,244B 6%, RAM 680B 8%), 실기 미검증. wafer_robot과 병합 시 Timer3 충돌 주의
    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
2026-10-27 팔 방식 벤치 시제품: 부품 17종 STL, 벨트·풀리 재계산(L=180), 측정 절차, 표적지
    - 링크 연동 52T:26T + 2GT-6 폐루프 440mm x2, θ·R은 20T:60T 폐루프 310mm
    - 부품 17종 약 247g, 약 12.4시간(선택 제외). 조립 검사: 도달·접힘 자세 간섭 0
    - 포인터는 손목에서 정확히 64mm(실제 포크 CD 중심점)에 펜 링. 표적지 A3 PDF
    - Fusion 문서 wafer_robot_arm_bench 저장. 구매 목록·측정 절차는 docs/design/arm_bench.md
    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
    [P01_base.stl, P02_foot_x4.stl, P03_turntable.stl, P04_theta_hub60.stl, P05_shoulder_hub60.stl, P06_pulley52_hub_x2.stl, P07_pulley26_hub.stl, P08_elbow_hub26.stl]
2026-10-27 규정 검토: 3D 프린팅 출전 허용 확인(R13 해소), 인계 메모에 사용자 회신 반영
    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
